deepai-org/svalbard/ip/blocks/analog/wifi_80211b/rf_rx_external_lo_parent/README.md

# Routed external-passive LNA/mixer parent

This is the first physically routed Wi-Fi receive-path parent. It places the
16-finger common-source LNA core and the two-bank external-LO switching mixer,
then routes their shared LNA-drain/mixer-RF net in parent-owned high metal and
ties the two explicit body contacts with a parent-owned ground rail.

The parent retains the necessary early external boundary: 50-ohm RF source and
input coupling, 1.5 V LNA bias, 300-ohm drain load, source degeneration, 2.3
GHz complementary LO, and differential 100 MHz IF load/filter. The visible
`MIX_RF` port is intentional: it is the physical landing for that external
drain load, not an unmodeled ideal internal connection.

`run_parent_physical.sh` requires zero DRC errors, unique LVS, full-RC PEX and
five complete PVT transient conversions. This is a composed feasibility claim,
not a qualified 802.11 receiver: RF/passive model validity, matching, noise,
linearity, isolation, I/Q, LO generation, IF/baseband, package/antenna EM,
calibration, sensitivity, EVM and regulatory behavior remain open.

The same physical runner now also performs a bounded two-tone diagnostic: a
1 mV desired tone at 2.400 GHz and a 100 mV aggressor at 2.425 GHz enter the
same external 50-ohm source and are mixed by the same external 2.300 GHz LO.
Across the five PVT cases the desired 100 MHz IF Fourier component changes by
+0.065 dB or more, while the 125 MHz aggressor IF component is at least
39.872 dB above it. That is an observed pre-filter compact-model fact, not a
blocker-tolerance, linearity or adjacent-channel-rejection claim: it makes the
missing IF/baseband filter and model/measurement qualification explicit.

The next selectivity architecture is now frozen as a **real-IF ADC plus digital
channel filter**, not as a claim that a broad 2.4 GHz preselector solves a
25 MHz adjacent-tone problem. The byte-bound requirement at
[`adc_dsp_selectivity_plan.json`](adc_dsp_selectivity_plan.json) uses the exact
five-corner two-tone PEX amplitudes to require a 0.25 V peak, 12-ENOB, at least
320 MS/s converter with two-times blocker headroom and at least 65 dB of
125 MHz digital attenuation. The original 5-pF sampled-input leaf is now
rejected on first principles as well as its switch screens: six-sigma
differential kT/C noise at 125 C is 281 uV, far above its 30.5-uV quarter-LSB
allocation. [`sampler_thermal_settling_budget.json`](sampler_thermal_settling_budget.json)
therefore binds the required IF-driver/hold-capacitor repartition before a new
sampler layout is authorized. The product-specific checker verifies this input
budget but explicitly does not claim an implemented converter, filter,
receiver, sensitivity, or RF model qualification. An external RF
preselector/match remains a later out-of-band/package/antenna requirement, and
a measured external IF filter may eventually reduce converter requirements only
after its port and S-parameters are bound.
