deepai-org/svalbard/ip/blocks/analog/wireline_serdes/clock_pulse/README.md

# RX clock level conversion and pulse generation

The recovered-clock path is CML, while the regenerative RX capture gates need
rail-to-rail CMOS clocks.  Driving those gates directly from the phase
interpolator is invalid: the extracted PI/restorer output can remain roughly
between 1.1 V and 2.6 V at slow/hot conditions.

`clock_level_converter.spice` uses two matched NMOS differential receivers with
PMOS mirror loads, a weak cross-coupled regenerative assist, and three tapered
CMOS restoration stages.  It reuses the lane's programmable bias.  The
input-swapped halves keep CML loading symmetric; the physical receiver/load
quartets are compact, edge-dummied, and mirror symmetric.

The schematic PVT screen deliberately spans CML input envelopes wider than the
present extracted clock chain.  It requires rail recovery within 250 mV,
800 ps period preservation, 35--65% output duty, no more than 400 ps absolute
edge latency, no more than 110 ps complementary crossing skew, and no more than
8 mA average supply current.  Absolute latency and its PVT shift are removed by
the CDR phase calibration; they are not silently treated as fixed delay.

The 126 by 117 um layout is zero-DRC, uniquely LVS-matched, and extracts to
540 resistors plus 267 capacitors.  Its exact full-RC standalone matrix passes
5/5 environments with a 100 fF load per output.  The exact extracted
phase-interpolator/restorer/converter chain also covers 5/5 environments.  The
four non-limiting environments use the nominal 1.15/1.15 V restorer/converter
biases.  SS/125 C has adjacent converter codes at 1.00 and 1.05 V with the
restorer at 1.30 V, plus a second restorer code at 1.15 V for converter bias
1.00 V.  That is a calibration window, not a single simulator-only code.

The next physical block is the programmable delay/non-overlap pulse network.
It must produce the separately validated 550 ps sense window and 150 ps write
pulse, then drive the actual extracted regenerative sampler clock gates.  The
remaining lane-level closure still includes mismatch/noise/metastability,
simultaneous supply/substrate aggression, EM/IR, electrothermal, fill, and
package/pad/channel effects.

## Programmable pulse-generator checkpoint

`clock_pulse_generator.spice` is the current transistor-level implementation,
not a behavioral delay source. Each phase starts from its dedicated full-swing
`CLKP_H`/`CLKN_H` parent clock. One physical falling-edge interval drives
SENSE/BOOST. WRITE is derived from the restored SENSE boundary through a
four-inverter receiver, a rising-edge interval detector, and a five-stage
geometric taper. Exact PEX rejected and removed the old global delay line,
pass-gate selector, and reset-dominant write latch.

The ideal-interconnect screen remains a failure and is not substituted for
PEX: extracted interconnect changes narrow-pulse behavior materially.
`run_pulse_hot_probe.sh` performs layout, DRC, unique LVS, exact full-RC
extraction, and TT plus FF/125 C and SS/125 C electrical probes with bounded
resources.

`generate_pulse_layout.py` aligns complementary devices as CMOS cells, routes
phase-local nets in functional bands, and stacks EVEN and ODD vertically. The
retained 128-device compact candidate is 175.4 by 285 um, zero-DRC, uniquely
pin-resolved LVS-matched, and extracts to 3,408 resistors plus 2,477 capacitors
in the earlier checkpoint. Its delayed-step revision extracts to 3,492
resistors plus 2,531 capacitors.
Substrate-tap columns are filtered against
complete multi-finger device spans, fixed HCLK landing intervals block the
automatic M4 allocator, and route comments make emitted nets inspectable.
Dedicated `VDD_WE`/`VDD_WO` and `VSS_SE`/`VSS_SO` pins retain explicit
parent-grid attachment.

The retained delayed-step candidate passes the complete focused TT contract:
591.87/583.98 ps SENSE, 206.87/213.84 ps WRITE, 605.54 ps write delay,
13.67 ps non-overlap, valid rails, and 40.669 mA. FF/125 C gives
592.74/583.02 ps SENSE and 202.82/207.82 ps WRITE with valid timing and SENSE
rails, but WRITE reaches only 2.687/2.692 V against a 2.72 V minimum. SS/125 C
retains valid 540.98/540.58 ps SENSE pulses, but the write restoration chain
does not propagate a complete pulse. Focused coverage is therefore 1/3, not
closure, and the full 20-case campaign is not promoted.

### Current reproducible delayed-step baseline

The checked-in source and layout generator are the exact netlist/layout pair
from `823f747`, the last compact candidate with an extracted TT pass. A fresh
2026-08-31 replay produced a 128-device, 175.4-um-wide layout with zero DRC,
unique LVS, and full-RC PEX. Its exact fresh TT PEX contract passes with
591.87/583.98 ps SENSE, 206.87/213.84 ps WRITE, 605.54 ps write delay,
13.67 ps non-overlap, valid rails, and 40.669 mA. The generated current layout
render is [clock-pulse-generator-layout.png](../../../../../docs/images/clock-pulse-generator-layout.png).

This is deliberately only a TT gate, not pulse-generator closure. A fresh
single-case extracted SS/125 C replay on the same source gives 540.98/540.58 ps
SENSE, but no complete WRITE pulse (48/59 mV output peaks, 51 ps apparent
write delay and 310 ps dead time). The retained FF/125 C candidate record also
misses the 2.72 V WRITE rail limit by about 28--33 mV. The historical full PVT
matrix is 1/20; a fresh broad PVT invocation currently stops before emitting
its result JSON, so it is not treated as interchangeable evidence. The fresh
TT and SS/125-C result identity is recorded in `pulse_tt_replay_checkpoint.json`.

### Actual-consumer composition (current blocker)

The pulse PEX is now composed with the physical complementary capture-clock
bridge and the physical direct-regenerative lane without an ideal source at any
SENSE, BOOST, WRITE, or capture-clock pin. A fresh 193.3-um-wide local-replica
revision is zero-DRC, uniquely LVS-matched, and passes its exact nominal PEX
gate. Its sustained composed screen is 3/5: TT, FF/hot, and SS/cold pass.
FF/cold reaches 3.379/3.396 V WRITE but only 3.311/3.296 V at the bridge
outputs against the conservative 3.380 V criterion; SS/hot still
loses periodic WRITE regeneration (49/60 mV). The byte-bound result is
[`../pulse_bridge_lane/pulse_bridge_regenerative_sustained_result.json`](../pulse_bridge_lane/pulse_bridge_regenerative_sustained_result.json).

An extracted 12-um final-SENSE-NMOS counterfactual was rejected: it lowered
the local SENSE low voltage but its added preceding-stage gate load erased
WRITE at multiple corners. Fixed drive growth is not the remedy. Also,
`SEL0..SEL3` are only physical pin-load anchors in this reduced topology, so
the former four-vector PVT campaign was repeated static-control evidence, not
calibration coverage. The checked runner now uses one static state. A future
calibration claim requires an actual circuit path whose code is observed to
change this composed behavior.

A second 2026-08-31 physical selector probe was rejected and reverted before
promotion. It used `SEL3` to enable a two-delay-unit, full-swing `WSD` hold-low
branch ahead of `WPN`; this intentionally avoided loading the narrow event and
the WRITE taper. The two-finger implementation was zero-DRC but LVS-invalid,
which caught a generated series-device connectivity error. The corrected
single-finger version was zero-DRC, uniquely LVS-matched, and full-RC extracted,
but its exact TT screen passed neither state: even the disabled branch's `WSD`
drain capacitance widened WRITE to 265.72 ps (from the 220 ps limit), while
enabled `SEL3` widened it to 379.21 ps. This rules out attaching the first
physical profile branch directly to `WSD`, not just attaching it to `WPN` or a
taper stage. The retained raw DRC/LVS/PEX and two-mode result are in
`scratch/serdes-clock-pulse-generator-physical.sM2xDfqt/`; they are diagnostic
only because the source was reverted.

A third 2026-08-31 `SEL3` profile candidate was also physically rejected and
reverted. It placed a current-starved PMOS assist only on the internal `DI`
state of the full-swing `WBA`--`WSD` end-delay cell, deliberately avoiding
direct diffusion on `WSD` or `WPN`. Both 2/4-um and 4/16-um series-PMOS
strengths were zero-DRC, uniquely LVS-matched, and full-RC extracted. The
stronger revision preserved the normal 3/5 composed matrix and improved
FF/cold capture rails to 3.371/3.363 V, but selected SS/hot still reached only
50/62 mV WRITE and 5/6 mV capture clocks. The control changed a real physical
state, yet did not drive `WPN` through a logic-low interval. The byte-bound
rejection record is
[`profiled_end_delay_rejection.json`](profiled_end_delay_rejection.json).
Do not enlarge this branch again; the next selector must choose a fully
regenerated start/end configuration and prove the selected `WPN` logic window
before another layout iteration.

That next experiment was also completed and rejected on 2026-08-31. It used
static one-hot `SEL2`/`SEL3` to choose independently regenerated, full-swing
`HCLK` start/end paths, with no disabled diffusion on `WBA`, `WSD`, or `WPN`.
The 220-device, 291.0-um layout was zero-DRC, uniquely LVS-matched, and
full-RC extracted. The `SEL2` state passed TT (206.62 ps WRITE and
0.083 V `WPN` low), but only 1/5 extracted corners passed; at SS/hot `WPN`
stopped at 0.272 V and no periodic WRITE was emitted. The selected `SEL3`
schematic state did cross `WPN` low at SS/hot, but its 377.93 ps WRITE interval
was itself invalid. The exact rejection record is
[`hclk_start_end_rejection.json`](hclk_start_end_rejection.json). The source
was reverted: a full-swing source alone does not repair the composed timing
budget, and this topology must not be promoted as calibration.

An FF/cold counterfactual separates the immediate mechanisms. The current
`(0,8,9)` profile reaches only 3.184/3.204 V WRITE even with its historical
placeholder load, 3.374/3.387 V with the extracted bridge, and 40/54 mV when
the placeholder SENSE/BOOST capacitors are replaced by the actual extracted
direct-regenerative parent. The next accepted revision must therefore be sized
and isolated against that real PEX load; a nominal or bridge-only recovery is
not sufficient.

### Superseded fast-detector characterization candidate

`pulse_fast_path_checkpoint.json` retains the later reduced-depth
`cp_fall_pulse_fast` plus six-delay experiment as a rejected historical
candidate. It had a 164-device, 226.2-um-wide zero-DRC, uniquely
LVS-matched layout, but fresh nominal full-RC PEX reached only 98/120 mV at
WRITE. Compacting its `WISO`--`WBASE`--`WSD`--`WPN`--`WB` dependency chain
removed a gross locality error but did not make the narrow detector robust.
The prior 12/20 schematic record is historical only; its current-runtime replay
was 0/20 and it cannot be used as release evidence.

Two 2026-08-31 extracted-TT sizing probes of `cp_rise_b_small` were rejected
and reverted. Doubling its NMOS finger count moved the generated chain and
gave 1.502 V `WPN`; doubling each NMOS finger width retained the horizontal
placement but increased timing-state gate load and gave 1.576 V `WPN`. Neither
is a layout or PVT solution.

A separate 2026-08-31 topology probe was also rejected and reverted before
layout: it inverted the restored `WBA` and `WSD` states, used the fast detector
to regenerate a positive interval, then inverted that result into the
unchanged active-low `WPN` taper interface. Its fresh schematic matrix was
0/20: WRITE remained at 0--2 mV in the nominal profile. The added state
inversions/detector latency did not produce a usable taper input. This rules
out that direct detector substitution; a next candidate must change the
end-to-end timing budget and output-taper interface together, not only
re-encode the local interval.

An extracted-layout 2026-08-31 threshold probe also halved only the first
write-taper inverter's NMOS multiplicity. It regenerated full TT WRITE rails,
but widened the pulse to 299/307 ps against the 220 ps maximum. The source and
layout were reverted. This rejects simple first-stage threshold skew as the
slow/hot fix; an accepted change must preserve the full timing budget, not
merely restore output amplitude.

One extracted-layout co-optimization paired a 10% first-stage PMOS increase
with an unintended faster sense-tail pull-down: a duplicated `XD0` instance
name made the initial edit land in the SENSE cell rather than the intended
write-end cell. Its TT PEX point passed at 213/218 ps WRITE and 522/514 ps
SENSE, but FF/125 C WRITE rails fell to 2.527/2.375 V and SS/125 C still did
not regenerate WRITE. It was reverted and is not evidence about write-end
control. The next candidate must introduce a calibrated full-state timing/drive
mode rather than use one fixed taper compromise across all corners.

An attempted `SEL3`-controlled first-stage PMOS assist was rejected before hot
promotion: while electrically off in nominal mode, its output diffusion still
loaded narrow `WB1`, reducing extracted TT WRITE rails to 2.882/2.904 V. It was
reverted. This is a physical-layout constraint, not merely a schematic one:
calibration hardware must attach before the narrow interval or behind a
regenerating isolation boundary, never as disabled diffusion directly on it.

On 2026-08-31, a schematic-only wiring probe connected `SEL3` through the
existing `cp_profile_write_restore` element at the restored `WSA`--`WSB` step.
It was intentionally not laid out or promoted: FF/hot instead produced roughly
470 ps SENSE, 150 ps WRITE, 350 ps write delay and 681 ps dead time, while
SS/hot still had no complete WRITE pulse. The probe was reverted after the
20-case schematic screen. This rules out that one simple selector insertion;
it does not establish an extracted calibration solution or replace the
first-extracted-TT gate above.

The central retained lesson is that a narrow pulse must not be selected or
transported through a slow restoration chain. The improved write topology
restores the full-swing `WSB` step, delays the start once, derives a separately
loaded end edge, forms the active-low interval locally, and only then drives the
output taper. This change reduced nominal write width from roughly 340 ps to
207--214 ps and produced the first exact-PEX TT pass on the compact macro. A
minimum-load receiver failed because
its 0.6 um device could not charge even a short extracted route; sizing must
include route/via capacitance and the parallel gate loads of both detector
branches. Attempts to mux narrow active-low pulses through transmission gates
or a three-NOR selector were rejected after exact PEX attenuated or erased the
selected event.

`scripts/analyze_pex_net.py` now traces shortest extracted resistance from a
named root to device terminals selected by gate/model patterns. Counterfactual
scaling localized the former rail failure to supply delivery rather than output
routing. The dedicated write pins reduce the port-to-final-source path to
19.34 ohm; the dedicated sense grounds use legal 1.5-um M4 channels and extract
to 32.60 ohm worst path. Larger final banks and an early feed-forward pull-up
both reduced, rather than improved, delivered peak voltage. A stronger final
PMOS increased the preceding stage's gate load and lowered the short-pulse
peak; reducing final NMOS load recovered FF/hot swing but lengthened WRITE
beyond 220 ps. The next revision must apply the existing profile controls to a
full-width state before interval formation, especially for SS/hot, and recover
the remaining 28--33 mV FF/hot WRITE swing without losing nominal width margin.

`screen_wb0_drive.py` is a deliberately non-promotable PEX counterfactual for
this failure. It changes only a named active portion of the write taper and
labels its output as diagnostic because diffusion and gate parasitics remain
unscaled. A 1.10x first-stage PMOS screen cleared FF/hot rail amplitude but
expanded WRITE to 228/234 ps; a 1.25x active-taper screen still did not
regenerate SS/hot. This rejects brute-force taper widening as the next layout
revision. Any profile solution must instead select or adjust a deterministic,
fully restored delayed step before `WPN` formation, then be regenerated through
DRC, unique LVS, full-RC PEX, and the complete PVT matrix. A local S/R latch
and a shared tristate full-step selector were also screened at schematic level
and rejected for PVT-dependent state and unresolved-delay behavior,
respectively.

A fresh regeneration produced byte-identical generated Tcl but different Magic
GDS/PEX internal names and byte hashes. This is extractor nondeterminism, not
evidence that either PEX deck can be substituted for the other. Each promoted
simulation must keep and hash its own DRC/LVS-bound PEX deck, as described in
the analog-layout closure workflow.

The local review render is `pulse_layout.png`; the documentation copy is
[clock-pulse-generator-layout.png](../../../../../docs/images/clock-pulse-generator-layout.png).
The checked failing [schematic matrix](pulse_schematic_result.json), retained
[passing nominal PEX checkpoint](pulse_pex_nominal_result.json), full
[exact-PVT matrix](pulse_pex_pvt_result.json), and
[physical checkpoint](pulse_physical_checkpoint.json) keep circuit coverage,
nominal closure, PVT failure, and physical legality as separate claims.
The newer compact candidate has separate
[nominal](pulse_candidate_nominal_result.json) and
[hot-corner](pulse_candidate_hot_result.json) records. The former passes and
the latter explicitly fails, so neither overwrites the older checkpoint or
implies complete PVT closure.
Run `run_pulse_generator.sh` for the schematic matrix and
`run_pulse_physical.sh` for generation, render, DRC, LVS, full-RC extraction,
the nominal electrical gate, and the full PVT matrix. Expected failing matrices
are exported as evidence after the required nominal pass; interrupted or
structurally failed runs retain their complete work directory under `scratch/`.
`run_pulse_layout.sh` is the bounded geometry-only export path for quick,
reproducible Tcl/GDS generation; it does not replace DRC, LVS, or PEX.
