deepai-org/svalbard/ip/blocks/analog/wireline_serdes/lane/README.md

# Externally clocked wireline lane composition

This is the first explicit composition of the selected integrated half-rate TX
with an AC-coupled package boundary, receiver common-mode return, programmable
differential termination, limiting amplifier, and dual-edge sampler.  The
initial rate is 1.25 GBd.  This is a bounded integration experiment, not a PCIe
pad, channel, compliance, or tapeout claim.

The same harness now has an externally clocked 2.5 GT/s mode. It uses a
rate-specialized physical data restorer and one committed exact-PEX release
stack for the termination, RX, restorer, and sampler. Fresh regeneration still
proves DRC and unique LVS, while every nominal and PVT electrical result hashes
the exact release bytes it actually simulated.

The provisional low-loss boundary deliberately names every currently modeled
element: 300 fF TX and 500 fF RX capacitance per pin, 100 nF external AC
coupling, 2 ohm and 1 nH package series parasitics per leg, 2 kohm receiver bias
returns, and the transistor-level programmable differential termination.  A
selected pad/ESD model and measured channel family must replace this boundary
before architecture freeze.

`run_lane.py` drives a changing 24-bit pattern, sweeps external sampler phase,
and independently measures signed TX, receiver-pin, amplifier, and held-sampler
margins.  A pass therefore cannot be created by checking only the final node.

Run `./run_schematic.sh` for the nominal transistor-level phase sweep. Run
`./run_extracted.sh` to regenerate and check the termination, amplifier, and
sampler layouts, perform full-RC extraction, and compose those fresh netlists
with the selected full-RC integrated serializer/TX.

## Current extracted evidence

The nominal full-RC-leaf composition completes all 16 phase cases and passes
13. The best 135 degree phase retains 259.8 mV signed pin margin, 300.4 mV
amplifier margin, and 1.345 V held-sampler margin at 12.46 mA shared supply
current. The three failing phases from 180 through 225 degrees are retained as
the observed wrong-aperture region rather than discarded.

The same 135 degree phase passes all five representative MOS/resistor/supply/
temperature environments using the already selected per-environment TX bias
and fixed RX bias, sampler bias, and interior termination code. Across that
matrix, minimum pin, amplifier, and held-sampler margins are respectively
225.8 mV, 124.0 mV, and 305.0 mV; shared supply current is 9.82--16.13 mA.

Fresh geometry evidence is bound to the composed netlists: the termination,
amplifier, and sampler each have zero Magic DRC errors, one unique pin-resolved
LVS match, and respectively 545R/276C, 442R/169C, and 480R/193C full-RC
extractions. The serializer/TX uses its selected committed full-RC extraction.

The sampler boundary is now extended through two exact-PEX CML-to-CMOS
converters and the independently clocked exact-PEX dual capture cell. All four
0--300 ps conversion offsets pass nominally, and the selected offset passes all
five representative environments. Worst converter/capture signed margins are
2.371/2.363 V and total composed current is 23.05--34.49 mA.
The physical, nominal, and PVT records bind the same exact split-capture PEX;
the preserved deck and matching image are
`scratch/serdes-lane-capture-deserializer-last.pex.spice` and
`scratch/serdes-lane-capture-layout-last.png`.

This closes deterministic changing-word transfer to stable parallel CMOS under
the provisional external clock and channel.

`./run_capture_stress.sh` reuses one freshly checked extraction stack for four
64-bit PRBS7-prefix cases, scoring 28 even/odd pairs (56 serial bits) after
startup in each case. All four exact-PEX cases pass: baseline; a symmetric
two-section channel proxy with 6 ohms series resistance per leg and 1 pF total
differential shunt capacitance; 40 ps peak deterministic TX-edge jitter with a
47% TX-clock duty cycle; and the channel proxy combined with 30 ps peak jitter
and 47% duty. Across 224 scored serial bits, the worst converter and retained
CMOS margins are 2.975 V and 3.165 V, and current is 27.11--27.14 mA.

`capture_stack.sh` is the shared container-side primitive for both capture
flows. It regenerates the termination, RX, sampler, converter, and split-capture
views once, runs physical checks on the exact split-capture PEX, and exports one
canonical argument vector so nominal, PVT, and stress flows cannot quietly use
different leaf paths.

For a matched 100-ohm differential reference, the declared RC proxy's ABCD
network evaluates to approximately 0.68 dB insertion loss at the 625 MHz
Nyquist frequency and 1.16 dB at 1.25 GHz. This is an explicit bounded lumped
stress, not a transmission-line, return-loss, or selected-channel claim. A
denser impairment/PVT matrix, simultaneous-supply aggression, and selected
pad/ESD/package/S-parameter models remain next.

## Combined extracted stress and data restoration

The denser matrix now measures every scored TX, receiver pin, receiver output,
sampler input, CML-to-CMOS output, and retained CMOS output. An initial 5-case
run with 7 ohms/leg and 1.25 pF localized the failure to receiver dynamic
margin. A one-factor screen showed that 30 ps peak jitter, 47% duty cycle, and
20 mV peak 100 MHz supply ripple each passed at the limiting slow/passive
environment; the provisional RC channel was the controlling mechanism. The
6-ohm/leg plus 1-pF point is the selected bounded proxy. The observed
7-ohm/leg plus 1.25-pF failure preceded the data-restorer redesign, so it is
mechanism evidence, not a post-redesign channel limit or guardband claim.

The original receiver output could still produce correct final data but fell
below the sampler's independently qualified 200 mV input contract. Reusing the
physical 7.5-um-load clock restorer failed arbitrary PRBS settling, so a new
two-stage 4.5-um-load `data_restorer` was laid out, checked, and extracted. Its
exact PEX passes at adjacent 67.5 and 90 degree sampler phases in the limiting
environment; 78.75 degrees is selected between them. Mixed process/passive
corners use restorer bias codes supported by adjacent-code screens rather than
waiving the interface floor.

The permanent calibration targets are `run_capture_restorer_sweep.sh` for the
final-geometry phase window, `run_capture_restorer_ff_bias.sh` for the
fast-device/slow-passive corner, and `run_capture_restorer_ss_bias.sh` for the
slow-device/fast-passive corner. They share the exact extraction stack,
stimulus runner, and parameterized fail-closed evidence merger.

`./run_capture_stress_pvt.sh` now passes 5/5 representative environments and
160/160 scored serial bits with one exact extraction stack under simultaneous
6-ohm/leg plus 1-pF channel stress, 30-ps peak deterministic TX jitter, 47%
duty cycle, and 20-mV peak 100-MHz rail ripple. Worst signed margins at the TX,
pin, raw RX, restored sampler input, converter, and final capture are
78.681/147.603/50.674/230.118/2578.62/2733.72 mV. Total composed current is
26.383--41.442 mA. This closes the bounded low-loss proxy matrix; it does not
close mismatch, substrate/PDN coupling, equivalent combined stress at 2.5 GT/s,
or the selected physical I/O and channel.

## Externally clocked 2.5 GT/s milestone

Run `./run_extracted_2p5.sh` for fresh geometry checks plus the exhaustive
16-phase exact-PEX nominal sweep. Six phases pass; the selected 22.5-degree,
zero-latency case retains 175.376 mV at the TX, 222.785 mV at the pin,
274.850 mV across the selected 50 ps raw-RX hold interval, 1.33849 V after
restoration, and 649.090 mV at the sampler.

Run `./run_extracted_2p5_pvt.sh` for the five representative mixed MOS,
resistor, supply, and temperature environments. All five pass with at least
one of three searched phases. Worst selected raw-RX hold, restored, and sampler
margins are 169.915, 376.508, and 137.055 mV. The two slow/hot cases add one
whole UI of deterministic pipeline latency; the other three and nominal use
zero. Integer latency is scored explicitly because word alignment can absorb
it, while wrong polarity or fractional aperture error cannot.

The AC-coupling initial condition is the settled measured TX-to-RX common-mode
difference for each environment. It is a fixture state, not a programmable
silicon control. `check_2p5_evidence.py`, included in `make check-fast`, binds
all release PEX and physical hashes, phase counts, environment identities, and
interface margins. This milestone does not yet include the 1.25-GBd combined
jitter/channel/supply stress matrix, mismatch, extracted parent routing,
selected pads/package/S-parameters, or a recovered clock.

`run_capture_2p5_precal.sh` extends that release stack through the two extracted
CML-to-CMOS converters and the independently clocked capture parent under the
same combined channel/timing/supply stress bundle. Nominal TT closes after
retaining the capture cell's characterized 380 ps write pulse: worst TX, pin,
raw-RX start/hold, restored, converter, and final CMOS margins are
139.812/132.707/180.873/397.333/1156.11/1659.46/763.159 mV. Total current is
56.167 mA.

The first representative PVT replay deliberately remains a checked failure at
1/5 environments. FF/cold exceeds the 60 mA current ceiling and its raw valid
window moves; FF/hot loses odd capture margin; the two slow/hot cases retain
restored amplitude but miss the converter schedule after their one-UI pipeline
shift. `extracted_capture_2p5_stress_precal_result.json` preserves the measured
stage-by-stage mechanisms. This is the next calibration/architecture target,
not evidence that combined 2.5 GT/s stress is closed.

The first physical correction retapers the capture output buffers for their
actual 50 fF load, reducing the cell from 2,202R/1,570C to 1,957R/1,400C while
remaining zero-DRC and uniquely LVS-matched. The retained 380 ps write pulse
then closes both fast corners under the same combined stress. FF/hot reaches
1.128 V worst final margin at 50.55 mA; FF/cold uses TX bias 1.1 V and a
50--100 ps raw-RX contract window, reaching 3.093 V worst final margin at
57.07 mA. `run_capture_2p5_fast_cal.sh` is fail-closed and preserves the exact
capture and converter PEX used by both cases. The two slow/hot TX/channel
failures remain preserved in that narrower historical 2/2 result.

`run_capture_2p5_calibrated.sh` closes the complete representative matrix with
one regenerated, hash-bound physical stack. It uses the rate-specialized
minimum-length-tail TX, nonlinear load code 4 in the two slow environments,
the separately versioned 4.2 um-load data restorer, and absolute 550 ps sense /
400 ps capture-delay controls where slow-device settling requires them. The
verifier samples EVEN and ODD capture outputs relative to their own half-rate
events; sampling both at the ODD event had incorrectly scored the EVEN output
after its next cycle began.

All 5/5 environments pass 24-bit PRBS7 under simultaneous 6 ohm/leg plus 1 pF
channel stress, 30 ps peak TX jitter, 47% duty cycle, and 20 mV peak 100 MHz
rail ripple. Worst pin, restored-input, converter, final-capture, and current
measurements are 103.180 mV, 237.084 mV, 1.20878 V, 958.544 mV, and 59.104 mA.
The committed evidence binds zero-DRC, unique-LVS, exact full-RC records for
the TX, termination/RX/sampler, restorer, converter, and capture cells.

`run_capture_2p5_routed_rx.sh` replaces the separate RX, calibrated-restorer,
and sampler PEX instances with the exact 1,309R/464C
`lane_rx_spine/lane_rx_spine.pex.spice` physical parent. Diagnostic parent pins
retain the raw-RX and restored measurements, so the same stage contracts remain
visible without substituting ideal wires at either internal boundary. The
routed parent passes the same five environments and combined stress with worst
pin, raw-RX, restored, converter, final-capture, and current measurements of
103.002 mV, 51.209 mV, 217.828 mV, 1.15809 V, 939.439 mV, and 58.830 mA.
`check_routed_rx_evidence.py` rejects duplicate leaf composition and binds every
physical record, PEX, testbench, runner, case, and aggregate hash.

`run_capture_2p5_rx_frontend.sh` advances that hierarchy through the exact
5,926R/3,405C `lane_rx_frontend/lane_rx_frontend.pex.spice` parent. It absorbs
the programmable termination, termination-to-RX routes, receive spine, both
sampler-to-converter boundaries, and the mirrored EVEN/ODD converter pair.
All 5/5 environments pass the unchanged combined stress. Worst pin, raw-RX,
restored, converter, final-capture, and current measurements are 104.159 mV,
47.358 mV, 211.577 mV, 579.32 mV, 595.135 mV, and 53.581 mA. Fast/cold moves
the realizable sampler phase to 45 degrees; fast/hot uses the independently
exposed interleave clocks for -50 ps ODD sense/regeneration deskew.
`check_rx_frontend_evidence.py` binds the exact parent and rejects fallback to
separate termination, spine, or converter PEX instances.

`run_capture_2p5_rx_capture.sh` extends the physical hierarchy through the
7,900R/4,804C `lane_rx_capture/lane_rx_capture.pex.spice` parent. It owns the
four converter-to-capture data routes, shared capture clocks, and capture power
branches instead of retaining a separate split-capture PEX. All 5/5
environments pass the same combined stress. Worst pin, raw-RX, restored,
converter, final-capture, and current measurements are 104.176 mV, 47.052 mV,
209.582 mV, 558.084 mV, 623.576 mV, and 52.203 mA. The final output reaches its
500 mV contract by 750 ps, retaining 50 ps before the next 800 ps
same-interleave event. `check_rx_capture_evidence.py` rejects leaf fallback and
binds the exact parent PEX, physical record, testbench, runner, five cases, and
aggregate.

This is not yet a complete routed lane. Realized upstream clock and bias trees,
local decoupling, pad/ESD/package/channel, and full-chip supply and substrate
routes remain the next physical composition boundaries.
