deepai-org/svalbard/projects/programmable_transceiver_platform/spec/board-requirements.md

# Board requirements

Obligations on the carrier and bring-up boards that the die relies on. The die is bonded on the
unmodified wafer.space chip-on-board ([package-channel.md](package-channel.md)): it carries eight 1 µF
capacitors on the supply nets and nothing on signal pins, so every signal passive below is on the carrier.
Per-application carriers are allowed: a carrier may populate only its application's passives, and a pad may
carry different functions on different carriers, but every carrier keeps bring-up, debug and fallback access.
Off-chip parts are limited to passives, the FPGA and a fallback LNA; the "BACKUP" rows are bench routes for a
partially working die, not the plan.

IDs are stable and are referenced from `performance-requirements.json`. Risk IDs are in
[risk-register.md](risk-register.md).

## Supply, reset, thermal, handling

| ID | Requirement | Why | Source |
|---|---|---|---|
| B1 | **Reset supervisor IC on `RESET_N`**, open-drain, threshold inside the supply window. It holds the chip in reset on slow ramps and brownout. | The on-chip POR covers cold start and full power cycles only. It misses some 100 ms–1 s ramps and ignores dips that stay above 1.5 V. | `analog/core_support` evidence |
| B2 | **One supply source, set per die.** A trimmer plus regulator sets each die's supply at bring-up from its measured speed: 3.3 V for typical dies, up to a 3.50 V setpoint for slow dies, lower for fast dies. Setpoint + tolerance + ripple + overshoot ≤ 3.63 V. Tolerance ±1 %. Bring-up starts every die at 3.3 V. Junction temperature 22–32 °C. | Operating envelope; per-chip supply trim. | `tapeout-plan.md` |
| B2a | **Supply and thermal detail:** (1) The regulator senses at the mezzanine connector supply contacts, with ≤ 20 mΩ from the sense point to them at ≥ 0.45 A. (2) θ(junction → temperature-controlled surface) ≤ 5.2 °C/W, set point held to ±2 °C, so the junction stays within 22–32 °C across the stopped (15 mW) to full-power mode step. The connector occupies the board back side under the die, so the controlled surface is a top-side cold finger (BP-6). Free air is not acceptable. (3) A die-temperature observation for the control loop, cross-checked against an on-chip proxy such as the always-on oscillator frequency. | Drop budget 117 mV. Worst mode 1.26 W needs ≤ 6.4 °C/W; a free-air board rises by tens of °C. | `power-delivery.md` section 1, `spec/budgets/power_budget.py` |
| B52 | **Supply slew ≤ 0.3 V/µs at the die, and no hot-plug.** The carrier is never plugged into or pulled from a live supply; the regulator has a soft start. | A 1 µs supply edge fires the provider supply-pad clamps: amperes through the bonds and the die rail rings above its limit. A 10 µs edge does nothing. | `scratch/reviews/integration-m6.md` finding 1 |
| B37 | **Die supply ripple for RF modes:** the supply is LDO-post-regulated (or the switcher runs above 20 MHz or synchronized off the channel plan) with ripple ≤ 1 mV rms over 10 kHz–20 MHz at the connector contacts. | No RX supply-rejection evidence; 1–3 MHz switcher lines land inside narrowband channels. | RF-RX-PSRR |
| B49 | **`RESET_N` is host-drivable, never hard-tied high.** The B1 supervisor output is wire-ANDed with a host GPIO (open-drain or series 1 kΩ) on the same net, with one 10 kΩ pull-up to the die supply; a test point and a push-button are recommended. **With the `POR_BYPASS` strap fitted, `RESET_N` is low from before the supply starts to rise until the supply has been inside its window for ≥ 1 ms**, and then shows one clean rising edge. | `rst_n = RESET_N AND (POR OR strap OR keyed override)`: with the strap set and `RESET_N` tied high the die has no reset at all, and every island turns on during the ramp. Both rescue paths need the host to pulse `RESET_N`. | `rtl/pt_por_path.sv`, `scratch/reviews/integration-m6.md` finding 4 |
| B50 | **SPI pins idle at the pad-pull levels whenever the host does not drive them: `SPI_CS_N` high, `SPI_SCLK` low, `SPI_MOSI` low.** Fit 1 kΩ `SPI_CS_N` to the die supply, 1 kΩ `SPI_SCLK` to ground and 1 kΩ `SPI_MOSI` to ground, or prove that the chosen FPGA leaves these pins high-impedance without pull-up from power-on through configuration. No pull-up on `SPI_MOSI` in any case. No `SPI_SCLK` edge while `SPI_CS_N` is high; a dedicated SPI bus is recommended. SPI clock ≤ 5 MHz (≤ 1 MHz at bring-up). | The pad pulls are 105–157 kΩ, weaker than any FPGA weak pull-up. `CS_N` high with `MOSI` low is the idle level that clears the pad-free POR rescue key; a floating `SCLK`/`CS_N` can clock garbage into the SPI shifter. | `rtl/pt_por_path.sv`, `rtl/pt_spi.sv`, `scratch/pads-core/pulls/` |
| B51 | **POR rescue (only for a die whose POR never releases).** First path: fit the `POR_BYPASS` jumper (strap pad to the die supply; the pad has a hard pull-down, jumper not fitted by default) and obey B49. Second path, no pad needed: the SPI key sequence of `rtl/pt_por_path.sv` ("RESCUE PROCEDURE"): the host bit-bangs `RESET_N`, `SPI_CS_N`, `SPI_SCLK`, `SPI_MOSI` as four GPIOs with ≥ 1 µs between pin changes, shifts 0xC3A5 with `RESET_N` and `CS_N` low, raises `CS_N`, then `RESET_N` with `SCLK` high, and from then on keeps `MOSI` high whenever `CS_N` is high. The B50 `MOSI` pull-down stays fitted. `RESET_STATUS` bits 4:2 report {POR masked, key override effective, strap}. Bring-up starts every die without either override and reads `RESET_STATUS` first. | The third-party POR is a single point of failure in the reset path. | `rtl/pt_por_path.sv`, `verification/check_por_path.py` |
| B26 | **Power before drive:** the supply is up and `RESET_N` released before any external source drives a chip pin: the external LO on `REF_IN`/`AUX_CLK` (B3), link partners on `WIRE_RX`/`WTX_EXT`/`AUX_CLK`, TMDS pull-ups (B9), `BB_I/Q` injection and ATB force (B7). Remove them in reverse order. The FPGA gates the LO source and the B6 switch on a power-good signal. | Externally driven pads land on p-diffusion in islands that may be unpowered: latch-up and back-powering (LU-02, LU-03). | risk-register LU-02, LU-03 |
| B6 | **Host lines are high-impedance while the chip is unpowered.** Use a bus switch with powered-off isolation on the 11 D2H lines and `SPI_MISO`. Never leave the chip supply floating while the FPGA is powered. | The provider host pads backfeed about 6.8 mA per pin into the ring. Series resistors are acceptable only on `SPI_MISO`. | `analog/pads` powered-host-backfeed |
| B6a | **The B6 switch must fit the host-link load budget:** on-capacitance ≤ 3 pF per line, bandwidth ≥ 1 GHz, propagation ≤ 0.3 ns, channel-to-channel skew ≤ 50 ps, isolation with its supply at 0 V. | ≤ 10 pF total per line (HL-B3). | HL-B3 |
| B7 | **Analog test bus force (`ATB0`/`ATB1`) only while the chip is powered**, or with the source limited to 1 mA. | Unpowered, a 50 Ω source pushes 54–56 mA into the ring through the provider analog pad. | `analog/pads` atb-provider-pad-force |
| B10 | **Access to every debug pad** (`BB_I/Q`, `AUX_CLK`, `WTX_EXT`, `WMON`, `CLK_OBS`, `DBG_OBS0/1`, `ATB0/1`, `TLP_TEST`, `POR_BYPASS`): an SMA or probe point each. `DBG_OBS0/1` and `CLK_OBS` also go to FPGA inputs (HL-B8). | Fallback routes and observability on every carrier. | `tapeout-plan.md` |
| B28 | **Opaque cover:** black glob-top or an opaque lid over the die for every measurement; microscope lamps off. | Photocurrent: about 0.3 µA under room light against 10 µA bias, about 100× more under a microscope lamp (OTH-01). The glob-top colour is not confirmed. | risk-register OTH-01 |
| B48 | **ESD handling:** (1) all handling, assembly and bring-up in an EPA per ANSI/ESD S20.20 or IEC 61340-5-1; (2) wrist strap and grounded mat for every bench probe; ground the probe and the coax shield before touching RF or high-speed pins; (3) discharge cables before connecting them; (4) the pin list states the HBM level per pin (2 kV: supplies, host link, debug/ATB, RF_RX, clocks, USB, WIRE_RX; 1 kV: RF_TX, WIRE_TX) and states no CDM rating (≥ 250 V is a target, not verified). | The die is an unencapsulated chip-on-board with mixed ESD levels. | `scratch/reviews/esd-tiering.md` |

The die attach (conductive, grounded paddle) is wafer.space's choice and is not confirmed in writing; substrate
isolation figures that assume a grounded back side depend on it (SUB-10).

## Radio

| ID | Requirement | Why | Source |
|---|---|---|---|
| B3 | **External quadrature LO (fallback for the on-chip LO):** I on `REF_IN`/`REF_IN_N`, Q on `AUX_CLK_P/N`, sine at 2.4–2.5 GHz, AC-coupled (B19), level settable per board (B31). Do not drive a square wave. Allow ≥ 1 µs after enabling the LO before receiving. The drive window is not requalified on the current bond map: the last pad-level evidence (3.0–4.0 Vpp open-circuit from 50 Ω) used a 1.5 nH bond model, and the package model gives 2–3 dB less at the pad and −11° to −19° of I/Q phase error before trim. | Recovers the radio if the on-chip LO fails. | `analog/timing/generated/lo_ext-pad-evidence.json`, `package-channel.md` section 4 |
| B19 | **External LO passives:** 2.45 GHz 90° hybrid (or two baluns from a quadrature source) with amplitude / phase balance ≤ 0.5 dB / ≤ 3°; AC coupling 10 pF C0G per leg. The carrier length-compensates the fixed board traces (BP-2); the chip trims the remainder. | TX EVM and image rejection need I/Q skew ≤ 5 ps at the mixers. | `analog/timing` lo_ext |
| B31 | **Adjustable LO level:** the external LO source has a per-board settable output level (≥ 10 dB range in ≤ 0.5 dB steps), set from `CLK_OBS`/ATB readings. | Bond and pad spread moves the pad amplitude by several dB (`package-channel.md` section 4). | risk-register PKG-05 |
| B35 | **LO synthesizer quality and common reference:** the B3 source meets RF-RX-LOPN, settles in frequency and phase within the RF-CS-HOP budget, and shares **one ±10 ppm TCXO** with the converter and host clock source. | Reciprocal mixing and frequency-offset tracking. | RF-RX-LOPN, RF-RX-FREF |
| B4 | **DC-block `RF_TX`** behind the feed network: the output pads are DC-fed from the board and rest at the supply rail. A DC path to ground or a DC source on an unpowered pad is not allowed. | The driver's output-pair current (about 61 % of its total) enters through the pads from the board chokes; a DC source on an unpowered pad back-powers the island. | `analog/rf_tx/README.md` |
| B17 | **RF_TX feed, match and balun:** per-leg feed chokes to the die supply, a 2.4–2.5 GHz balun with a specified maximum insertion loss (the simulations use the datasheet maximum), DC block 10 pF C0G. Values are fitted to the extracted pad and the per-pin package chain and refitted when either changes; the bench network in `analog/rf_tx/README.md` is the reference. Placement loss 0.4 / 0.9 / 1.7 / 2.6 dB at connector + 2 / 10 / 30 / 50 mm. | Driver DC feed and output power. | `analog/rf_tx/README.md`, `package-channel.md` section 4 |
| B18 | **RF_RX input match: NOT MET.** No network is qualified on the package channel: the first carrier part sits behind ≥ 6.5 nH and about 0.9 pF per leg, and the LNA input is not closed (RFR-11..14). Intended form: discrete match per leg with 0402 wire-wound inductors (Q ≥ 40 at 2.45 GHz), C0G capacitors, one trimmer across the pair, a 2.45 GHz 50:100 Ω balun with ≤ 0.8 dB maximum loss, 10 pF C0G coupling. To be fitted on the real channel once the LNA input is fixed. | Balun and match loss add dB for dB to the noise figure. | `analog/rf_rx/README.md`; risk-register RFR-11..14 |
| B25 | **RF_RX trimmer tuning: NOT MET** (depends on B18). Intended procedure: LNA on at RX bias, network analyser on RF_RX, turn the one trimmer for the minimum worst reflection over 2.395–2.4885 GHz, then set the LNA tank tune for the lowest baseband noise floor and store it in the board EEPROM. | Bond and part tolerances move the match. | risk-register RFR-13 |
| B5 | **Fallback board LNA ahead of `RF_RX`** (footprint on every radio carrier, with bypass), NF ≤ 1.5 dB, gain ≥ 15 dB, used with the on-chip LNA bypass. | Recovers sensitivity if the on-chip LNA misses. The on-chip LNA is the design. | `tapeout-readiness.json` `rf_lna_bypass` |
| B20 | **Anti-alias filter on the baseband-tap fallback** (`BB_I/Q` to an external ADC): 3rd–5th order LC low-pass per leg, corner about 10 MHz for 20 MHz channels, L ±2 %, C0G ±2 %. | Adjacent-channel aliasing in the external converter. | `tapeout-readiness.json` `rf_bb_external_adc` |
| B33 | **T/R switch (single-antenna products):** SPDT between the antenna, `RF_TX` (after B17) and `RF_RX` (before B18): IL ≤ 0.5 dB, isolation ≥ 25 dB, switching ≤ 1 µs, P0.1dB ≥ +20 dBm, control from an FPGA GPIO scheduled from the chip's TX/RX timing (the same timing as RF-CS-ANT). Two-antenna setups may omit it. | Separate RF_TX/RF_RX pins; RF-TX-MUTE fails; CS T_IP2 ≤ 40 µs. | RF-RX-NFSYS, RF-CS-TIP |
| B34 | **ISM coexistence filter (populate option, mandatory in products with cellular or 5 GHz radios):** 2.4 GHz BAW band-pass (2400–2483.5 MHz) between the antenna/T-R switch and the B18 balun: IL ≤ 2.5 dB max, rejection ≥ 35 dB at 2300–2370 MHz (B40) and ≥ 35 dB at ≥ 2500 MHz (B41/B7), ≥ 30 dB at 4.9–5.9 GHz. Keep its footprint on every carrier (0 Ω bypass when not fitted). | No on-chip selectivity; +8…+13 dBm UE TX at the port is ≈ 45 dB beyond the pre-filter headroom. | RF-RX-COEX |
| B36 | **Antenna-port ESD (MANDATORY):** low-capacitance TVS (≤ 0.3 pF, 2.4 GHz rated) or a shunt-L ESD path at the antenna connector for IEC 61000-4-2 ±8 kV contact; the chip pad is rated only for HBM-class events (RF_RX 2 kV tier: residual ≤ 1.33 A). **Residual-current criterion:** at IEC 61000-4-2 ±8 kV contact the current reaching the die pin through bond/trace must stay ≤ 0.67 A peak (the 1 kV HBM surrogate peak the pad was qualified for; 2 kV pins: ≤ 1.33 A), checked by a SPICE/TVS-datasheet TLP-curve simulation of TVS + trace L + pad model before release; a clamp-voltage spec alone is not sufficient. **First IEC peak:** the same check covers the IEC first peak (~0.8 ns rise, ~30 A at 8 kV): residual into the die ≤ 1 A for 1 kV pins (≤ 1.33 A for 2 kV pins) until VF-TLP data from the TLP site exists. | Antenna ports see system-level ESD; the RF_RX pad is qualified only for the 2 kV HBM surrogate (ESD-02). | RF-RX-ESD; risk RXR-07 |
| B41 | **Antenna switch array (populate option; BLE AoA/AoD CTE, CS N_AP > 1, diversity):** SP4T–SP8T 2.4 GHz switch at the antenna (ahead of B33/B34): IL ≤ 1.5 dB, isolation ≥ 25 dB, switching ≤ 250 ns to settled, P0.1dB ≥ +15 dBm and hot-switch rated at ≥ +10 dBm. Control lines are FPGA GPIOs (no chip pin), launched against the chip's ADC sample index / TX schedule (IX-8). The array phase/gain is calibrated per board. | RF-BLE-CTE slot timing (1–2 µs slots) and RF-CS-ANT; the chip has no antenna-switch pins and none are spare. | RF-BLE-CTE, RF-CS-ANT |
| B42 | **Band kits for off-ISM and sub-band use (populate options, RF-XLO-RANGE):** per band (2.2–2.8 GHz; 1.15–1.7 GHz; 0.86–0.93 GHz): (1) RX L-match and TX balun/match re-valued for the band from the same COB model as B17/B18; (2) a quadrature LO for the band, either a band 90° hybrid (≤ 0.5 dB / ≤ 5°) or a synthesizer at 2× or 4× f_LO into a quadrature ÷2/÷4 IC, at the B3 level (B31 adjustable); (3) a **preselector SAW/BPF** ahead of B18 rejecting the 3·LO and 5·LO mixer responses by ≥ 40 dB; (4) a TX low-pass rejecting H2/H3 and the 3·LO product to the regulatory limit; (5) the LO synthesizer covers 0.6–2.8 GHz at B35 phase noise. B34 is bypassed (0 Ω) off-ISM. | The chip is broadband (no on-chip tuned element); band selectivity and quadrature come from the board. Passive mixers respond at odd LO harmonics (−9.5 / −14 dB). | RF-XLO-RANGE, RF-SUBG-PROF, RF-SDR-SCAN |
| B43 | **Radar / duplex front end (populate option, RF-RADAR):** two antennas with ≥ 30 dB TX→RX isolation, or one antenna through a coupler/circulator with ≥ 25 dB isolation; TX code set so the self-leakage at `RF_RX` is ≤ −30 dBm. Optional ramp-capable synthesizer (≤ 83.5 MHz linear sweep inside 2400–2483.5 MHz, ramp nonlinearity ≤ 0.1 %) on the B3 LO footprint. | Keeps self-leakage under LNA compression (≈ −25 dBm at the lowest state) and within the DC-offset DAC range. | RF-DUPLEX, RF-RADAR |
| B44 | **GNSS front end (populate option, RF-GNSS-RX):** active-antenna bias-T (3.3 V, ≤ 30 mA, current-limited), L-band SAW (1.16–1.61 GHz or per band) and the B5 board LNA (NF ≤ 1.5 dB, gain ≥ 15 dB); LO and converter reference from one TCXO ≤ ±0.5 ppm. | Chain NF 2.7 dB only with a board LNA; GNSS acquisition time scales with reference error. | RF-GNSS-RX |
| B45 | **Multi-die coherent array (RF-MULTICHIP):** one LO synthesizer, an amplifier and an N-way Wilkinson splitter per LO phase (I and Q) with phase match ≤ 3° and level ≥ +8.9 dBm per die leg (the B3 window); the H2D clock and the sync event fanned out length-matched (≤ 50 ps skew) to every die's FPGA port. | B3 drive is per die; the sample epochs are aligned only if every die sees the same sync event. | RF-MULTICHIP |

## Wired and USB

| ID | Requirement | Why | Source |
|---|---|---|---|
| B22 | **Wired TX AC coupling (PCIe, SATA, DisplayPort, 1000BASE-X and the 2.7–3.24 Gb/s rates):** one series capacitor per leg of `WIRE_TX_P/N`, PCIe 75–265 nF, SATA and DisplayPort 10–100 nF per the standard, anywhere within 50 mm on the carrier. TMDS stays DC-coupled (B9). No board back-termination: the on-die termination is on in the serial configuration. | The TX common mode is not a standard-compliant DC level. | `analog/wired_tx/INTEGRATION.md` |
| B23 | **Wired RX passives:** (1) AC coupling on `WIRE_RX_P/N`, one 100 nF X7R 0402 per leg (PCIe 75–265 nF window); TMDS DC-coupled. (2) No board termination: the on-die termination stays on. (3) Clean reference on `REF_IN`: crystal oscillator module (25 MHz class), ±20 ppm, phase jitter ≤ 1 ps rms (12 kHz–5 MHz), LVCMOS or LVDS; a bare crystal is not possible. (4) No external series peaking inductor: the package already adds 3–4 nH per leg. | No new pins. | `analog/wired_rx/README.md`, `package-channel.md` |
| B24 | **WIRE_RX and WIRE_TX bond order:** `WIRE_RX_P` is on `bidir[15]`, `WIRE_RX_N` on `bidir[14]`, `WIRE_TX_P` on `bidir[21]`, `WIRE_TX_N` on `bidir[20]`; `USB_DP` on `bidir[19]`, `USB_DN` on `bidir[18]`. The carrier routes from the bond map in `package-channel.json`, not from the site order. | The wired pad families are wider than a site pair and are placed mirrored. | `package-channel.json` |
| B40 | **High-speed RX return-loss compensation (optional, not fitted by default)**, per `WIRE_RX_P/N` leg at the connector: shunt 0.9 pF (0201 C0G, ±0.05 pF) within 0.5 mm of the connector pad, series 4.0 nH (0402, ±2 %), shunt 0.2 pF. Lifts the 1.25–2.5 GHz return loss from about 6.1 dB to 12.3 dB nominal; 8.2 dB worst with ±10 % parts and bond ±0.3 mm at 0.5 mm placement, 4.1 dB at 5 mm. A connector TVS (B47) counts against the first shunt capacitor. To be refitted after the pad termination fix (PAD-09). | Return loss to 2.4–2.5 GHz is package-limited (about 6.3 nH series path); only a board-side ladder helps. | `scratch/pads-pd21/rl/rl_fix_pd48c.json` |
| B9 | **TMDS needs 50 Ω pull-ups to 3.3 V** on `WIRE_TX_P/N` (the sink's, or on the carrier). | TMDS is a wired TX configuration with on-chip termination off. | `analog/wired_tx/INTEGRATION.md` |
| B16 | **HDMI/DVI RX:** the carrier routes the TMDS clock pair into `AUX_CLK_P/N` as the CDR reference, level-shifted from TMDS to the `AUX_CLK` input range. The external-LO Q phase cannot be fitted on the same carrier. A full HDMI/DVI link uses three dies, one per TMDS data lane: the carrier fans the clock out to all three with matched lengths. | The on-chip route needs the forwarded pixel clock; the forwarded wire clock uses the `AUX_CLK` pair. | `integration/top/pt_chip.conn` |
| B12 | **External serial data on `WTX_EXT` (wired TX fallback):** AC-coupled; the FPGA sends at least 128 bits of balanced data before the payload. Rates 0.5–1.6 Gb/s at 300–800 mVpp. | The coupling capacitors hold the previous level for about 40 ns. | `analog/timing` diff_clk_rx data mode |
| B8 | **USB low speed through an external PHY.** Full speed and high speed use the chip. | On-chip low-speed edges are faster than the 75–300 ns the standard requires. | `analog/pads` usb-attachment |
| B11 | **USB HS amplitude calibration per board:** set the HS bias code at the board's actual rail and load by measuring the HS amplitude (360–440 mV target). | The amplitude follows the supply, and the slow corner at 3.15 V is short of 400 mV at full scale (351 mV; 400 mV needs 3.33 V). | `analog/wired_tx/USB-INTEGRATION.md` |
| B46 | **USB connector TVS (MANDATORY):** USB2-HS-rated low-capacitance TVS array on D+/D− at the connector (≤ 0.5 pF per line, ≤ 0.05 pF mismatch, IEC 61000-4-2 ±8 kV contact, clamp ≤ 10 V at 1 A TLP / 100 ns), within 5 mm of the connector, before any series part; VBUS gets its own TVS. The current reaching the die pin at ±8 kV contact, including the first peak, stays ≤ 1.33 A, checked by a simulation of TVS, trace inductance and pad model before release. The TVS counts in the USB 10 pF per line budget (die ≤ 5 pF). | The USB pad is a 2 kV HBM pin; a connector pin without a TVS fails system-level ESD. | `scratch/reviews/esd-tiering.md`; risk ESD-02 |
| B47 | **Wired connectors (`WIRE_RX`, `WIRE_TX`), `RF_TX` and clock inputs:** connector-side low-capacitance TVS (≤ 0.3 pF per line, rated for the lane rate) on any externally pluggable connector, or the port is documented as connect-only-when-powered-down with cables discharged first. Residual current into the die at ±8 kV contact ≤ 0.67 A for 1 kV pins (RF_TX, WIRE_TX; ≤ 1 A on the first peak) and ≤ 1.33 A for 2 kV pins, checked by simulation. On WIRE_RX the TVS capacitance is absorbed into B40; on RF_TX it is part of B17. | Mixed HBM levels per pin. | `scratch/reviews/esd-tiering.md`; risk ESD-02 |
| B38 | **100BASE-TX line interface (WR-100TX-*):** an RJ45 with integrated 10/100 magnetics, or discrete parts. TX and RX transformers 1:1 with OCL ≥ 350 µH at 8 mA DC bias, a line-side common-mode choke, Bob-Smith termination (75 Ω per pair centre tap → 1 nF / 2 kV to chassis), 1500 Vrms isolation *(verify)*. **RX side:** the RX transformer secondary goes straight to `WIRE_RX_P/N`, DC-coupled (no series caps: they would add a baseline-wander pole). The RX centre tap is biased to 1.0 V ±5 % by a divider from 3.3 V (e.g. 2.37 kΩ / 1.0 kΩ 1 %) with 100 nF to GND. On-die termination mode 10 (100 Ω differential) with the on-die AC coupling off. **Pairs:** 100 Ω differential carrier routing per BP-8, ≤ 50 mm chip→magnetics, TX and RX pairs ≥ 3 w apart. | The die's CTLE CM window is 0.8–1.2 V at ss , and the transformer secondary floats. Magnetizing L sets the baseline-wander τ = 7 µs (WR-100TX-BLW). | WR-100TX-RXEQ/-BLW/-RL; interface-requirements §1.14 |
| B39 | **100BASE-TX TX network on `WIRE_TX_P/N` (current-mode, external centre tap):** (1) back-termination of 49.9 Ω 1 % from each leg to the TX centre-tap rail, which is a separate 3.3 V ±2 % board supply node with 10 µF + 100 nF (it carries the 40–51 mA tail current, which returns through die VSS). (2) a doubly-terminated 100 Ω 2nd-order Bessel/Butterworth LC low-pass between the back-termination node and the TX transformer, fc ≈ 110–120 MHz: for Butterworth at fc 115 MHz (g1 = g2 = 1.414), series L = 2 × 98 nH (±2 %, one per leg, Q ≥ 30 at 60 MHz) and shunt C = 19.6 pF differential C0G ±2 %; overshoot 4.3 %, or use Bessel values if the overshoot margin is short (final values from the B39 sim). (3) On-die TX termination off; no series AC caps (B22 does not apply in this mode). | MLT-3 ±1 V = 40 mA × 25 Ω. TP-PMD needs 3–5 ns edges and ≤ 5 % overshoot, and the 0 level is built by 1 GHz MAIN/POST cancellation that the filter removes (WR-100TX-TXSHAPE). The filter gives RL ≈ 24 dB at 30 MHz and ≈ 12 dB at 60 MHz. | WR-100TX-TXLVL/-TXSHAPE/-RL |
| B38a | **BACKUP Ethernet (twisted pair): external 10/100 PHY** on the FPGA (RMII/MII), with its own magnetics/RJ45 footprint or a 0 Ω-option share of B38. This is also the only route for 10BASE-T, which the die does not support (TX amplitude bound, §1.14). | Fallback for WR-100TX-* if the 100BASE-TX generalizations (IX-9…IX-13) are not built or the baseline-wander and equalizer margins fail at 100 m. | §1.14 |
| B13 | **BACKUP wired RX: board CDR/retimer** covering 1.25–3.24 Gb/s with a recovered-clock output. It retimes data onto `WIRE_RX` and drives a recovered clock (line, /2 or /4) into `AUX_CLK` through a phase adjust of ≥ 1 UI range in ≤ 1/16 UI steps. Recovered clock jitter ≤ 0.05 UI rms. | Bench route if the on-chip CDR misses. | readiness `wire_rx_board_retimer` |
| B14 | **BACKUP wired TX: board serializer.** An FPGA transceiver or a discrete serializer drives the line directly above 1.6 Gb/s; at ≤ 1.6 Gb/s it may drive `WTX_EXT` (B12). | `WTX_EXT` is characterized to 1.6 Gb/s. | readiness `wire_tx_board_serializer` |
| B15 | **BACKUP PCIe: board 2:1 high-speed mux** (≥ 5 GHz bandwidth, ≤ 1.5 dB loss at 1.25 GHz) at the connector, selecting between the chip lane and a board PHY or FPGA transceiver. | Keeps a bench route for the protocol. | readiness `wire_board_phy_bypass` |

## Package and carrier

| ID | Requirement | Why |
|---|---|---|
| BP-1 | **Package model = per-pin chain** of `package-channel.json`: bond wire (per-bond length, inductance and resistance), 86.6 Ω microstrip, one via, connector. Every RF, LO and multi-Gb/s simulation that claims a board requirement includes it. | No signal passive can sit closer than the carrier. |
| BP-2 | **Carrier length compensation.** Add carrier length to the shorter leg of each pair (5.9 ps/mm on the board): BB_Q P +2.5 mm, WTX_EXT P +2.1, WIRE_TX N +2.0, BB_I P +1.7, RF_RX P +1.0 (board-equivalent mm). Match the LO I (REF_IN) and LO Q (AUX_CLK) pairs to equal total delay at the pads: the fixed traces differ by about 2.2 mm. Host groups: match to the per-pin delays or rely on FPGA deskew (HL-B5). | Intra-pair skew up to 14.7 ps; LO I/Q −11° to −19°. |
| BP-3 | **RF and LO passives within 10 mm of the connector** (≤ 30 mm at about +0.8 dB). 50 Ω coplanar-grounded lines with ground vias at each connector ground contact. RF_RX at contacts 12/13, LO Q 20/21, LO I 22/23, RF_TX 26/27. | Loss grows from 0.4 to 2.6 dB between 2 and 50 mm. |
| BP-4 | **The eight board capacitors (1 µF) populated**, plus ≥ 1 µF + 100 nF per supply contact within 5 mm on the carrier and ≥ 10 µF bulk. | They act below about 30 MHz; without them every supply figure is 1.2–1.5 × worse. |
| BP-5 | **Carrier ground at the connector:** every ground contact (10, 18, 25, 45, 53, 61) and all four shell tabs get their own via to a solid ground plane. No plane split under the connector. | Six contacts and four tabs carry all return current. |
| BP-6 | **Thermal:** top-side temperature-controlled cold finger over the glob-top (compliant non-conductive gel ≥ 3 W/m·K, ≤ 0.3 mm, not pressing on the bonds). Otherwise a per-mode set point with ≥ 30 s dwell after a mode change, junction read from the on-chip proxy. | No access to the die bottom. |
| BP-7 | **External LO source:** settable over ≥ 10 dB in ≤ 0.5 dB steps; never driven before power-up (B26). | Pad amplitude spread. |
| BP-8 | **Wired pairs on the carrier:** 100 Ω differential with BP-2 compensation; AC capacitors anywhere ≤ 50 mm; add 0.05 / 0.25 / 0.74 / 1.23 dB at 1.25 GHz for 2 / 10 / 30 / 50 mm to the channel budget. | `package-channel.md` section 4. |
| BP-9 | **Unused shared pads:** a pad that carries a different function on another carrier is left unconnected, without test points or stubs longer than 5 mm, on carriers that do not use it. | Per-application carriers. |

## Proposed, not adopted

From `scratch/reviews/offchip-passives.md` section 8. They become requirements only if the area item they
serve is adopted.

| Proposal | Carrier | Requirement |
|---|---|---|
| OCP-1 | RF | LO loop-filter capacitor off chip: 470 pF C0G ±5 % 0402 between the two pads it uses (`bidir[22]`/`[23]`), within 10 mm of the connector, routed as a pair away from switching nets with a guard trace at the return potential, no test point, board leakage ≤ 5 nA at 3 V. A second unfitted footprint allows loop-bandwidth changes. |
| OCP-2 | Wired | The B12 fallback data source and its AC capacitors connect to the `USB_DP`/`USB_DN` contacts instead of `WTX_EXT`; the USB connector and its parts are not fitted on wired carriers. Costs USB HS transmit from external serial data. Open with the user. |

## Host link (FPGA to chip)

Ten data bits plus a forwarded clock in each direction, DDR, 312.5 Mb/s per pin (156.25 MHz clock) at full
rate, 3.3 V LVCMOS at the die supply. D2H is on the south edge, H2D on the north edge; directions are fixed
in the current RTL. The timing budget is in [interface-requirements.md](interface-requirements.md) (HL-*);
the FPGA screen is in [fpga-connection-plan.md](fpga-connection-plan.md).

| ID | Requirement | Why |
|---|---|---|
| HL-B1 | **Topology.** D2H and H2D are separate source-synchronous groups, each clock routed with its data. Clocks go to clock-capable FPGA pins; H2D_CLK is forwarded from an output DDR register, centred in the data eye. A board that wants reversible banks later (HL-DIR) routes both clocks to pins that are clock-capable and bidirectional. | The chip captures H2D on H2D_CLK and launches D2H edge-aligned with D2H_CLK. |
| HL-B2 | **Impedance and length.** 50 Ω ±10 % single-ended over a continuous ground plane. Data-to-clock length matched within ±2.5 mm. Total length ≤ 60 mm. Series source termination 22–33 Ω within 5 mm of each driver: D2H at the connector, H2D at the FPGA. | Edges are 0.76–1.4 ns: the lines are transmission lines. |
| HL-B3 | **Load.** ≤ 10 pF per line, counting FPGA pin, trace and the B6 switch. | Chip-side screens used 6–10 pF. |
| HL-B4 | **Simultaneous switching.** All 11 D2H outputs may switch on one edge: one ground via per 2 host signals within 3 mm of the connector; ≥ 2 × 100 nF plus 1 µF on each host supply contact within 5 mm; ground bounce ≤ 300 mV at a quiet D2H pin (HL-SSO). The FPGA respects its vendor limit for 11 LVCMOS33 outputs in one bank. | Package model: 486 mV at 0.76 ns edges unstaggered. |
| HL-B5 | **Receiver window and training.** Per-bit input delay (≤ 80 ps step, ≥ 1.6 ns range) and per-lane word alignment, trained on the chip's training prefix. FPGA input setup + hold ≤ 1.0 ns at the pin. | The D2H budget assumes a 1000 ps FPGA window. |
| HL-B6 | **Rate modes.** Bring-up starts at `debug.host_link.rate` = div4 (78.125 Mb/s per pin). RF modes run at div2 (PWR-HOST-RF). Full rate only after training passes. | Reduced-rate fallback; host IO current. |
| HL-B7 | **No FPGA pulls or keepers on the host banks** except the B50 SPI resistors. If reversible banks (HL-DIR) are built, the gateware tristates a bank before the chip is told to drive it. | Contention would be 30–40 mA per pin. |
| HL-B8 | **Observation pins to the FPGA.** `DBG_OBS0`, `DBG_OBS1` and `CLK_OBS` go to 3.3 V FPGA inputs without pulls; `CLK_OBS` on a clock-capable input. Test-point stubs ≤ 5 mm. | Status, events and frequency measurement without an in-band frame. |
