deepai-org/svalbard/projects/programmable_transceiver_platform/spec/register-map.md

# Control register map

Generated by `rtl/gen/gen_regfile.py` from `analog-architecture.json:control_fields` and
`debug-controls.json`. Do not edit; regenerate. The machine-readable map is
`register-map.json`; bench headers are `rtl/gen/pt_regmap.h` and `rtl/gen/pt_regmap.py`.

Map hash `0x882D` (read at 0x09), ABI version `0x0003` (0x08), ID `0x5356` (0x00).
125 generated registers (32 debug/fallback at 0x40-0x59, 93 analog at 0x60-0xB7) carrying 276 fields (912 bits); 44 commit rules.

## SPI ABI

Unchanged: SPI mode 0, MSB first, one 32-clock transaction per CS_N low period: command8 /
address8 / data16. Command 0x80 writes, 0x00 reads (read data is shifted out during the last
16 clocks). The flat 8-bit address space holds every register, so no page register is used.
The register file is clocked only by `HOST_SCLK` and works with every PLL and oscillator stopped.
A write (and a COMMIT) takes effect on the SCLK falling edge that follows the 32nd rising edge;
in mode 0 SCLK returns low before CS_N rises, so that edge is always present. Clocks beyond the
32nd never repeat a write.
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
