deepai-org/svalbard/docs/images/clock-pulse-generator-layout.png

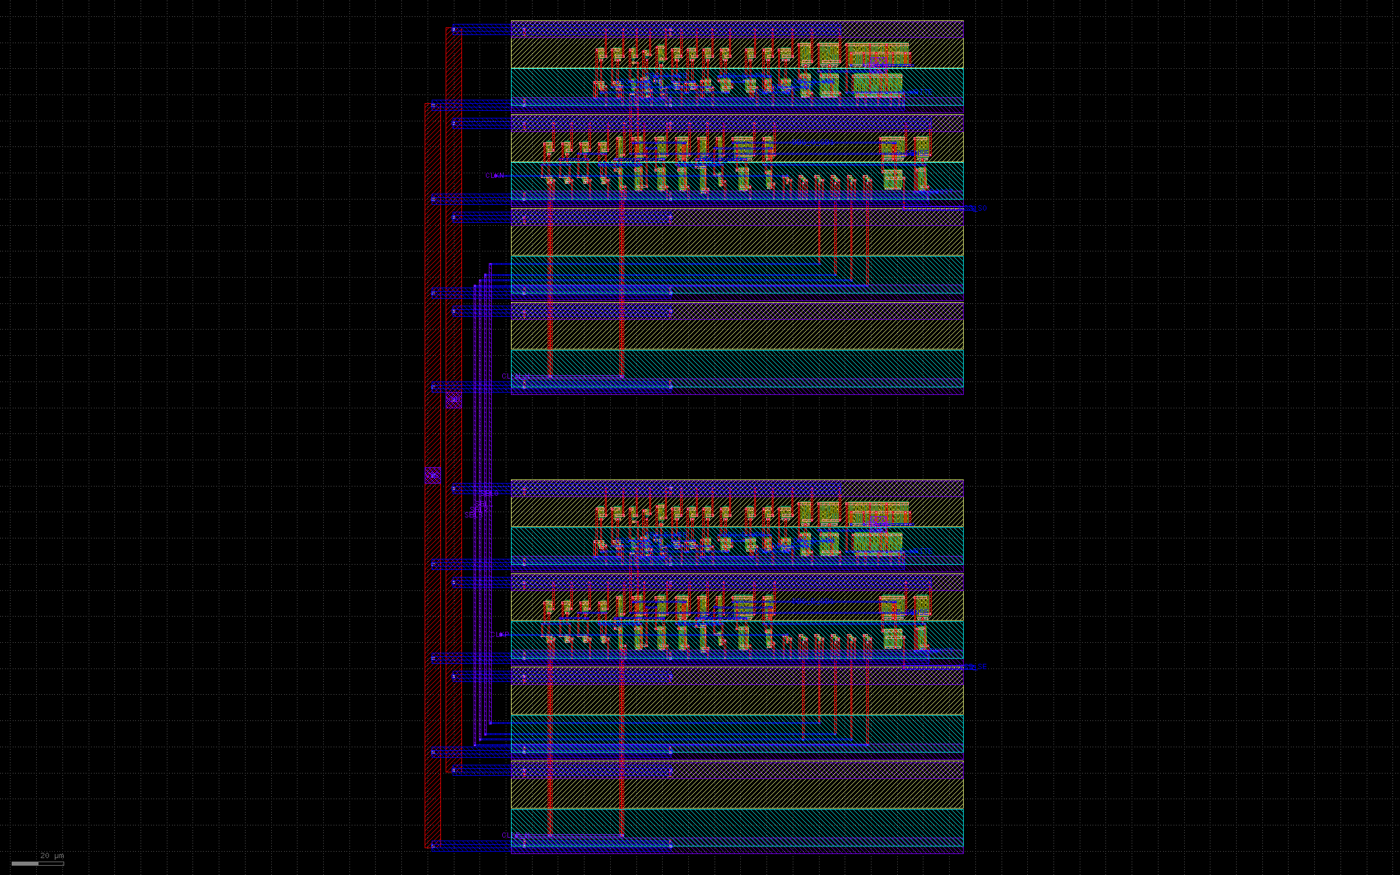
docs/images/clock-pulse-generator-layout.png
