deepai-org/svalbard/docs/images/pcie-analog-floorplan-proposal.png

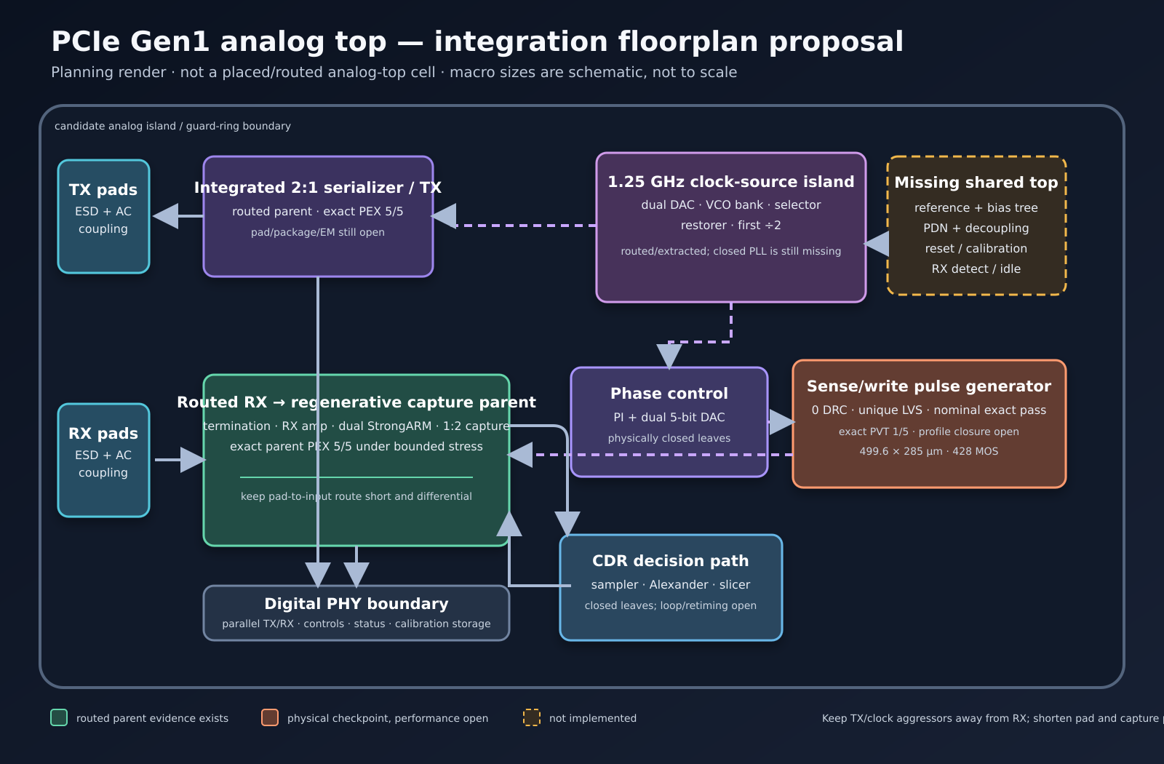
docs/images/pcie-analog-floorplan-proposal.png
