deepai-org/svalbard/docs/images/pcie-event-capture-final-restore-layout.png

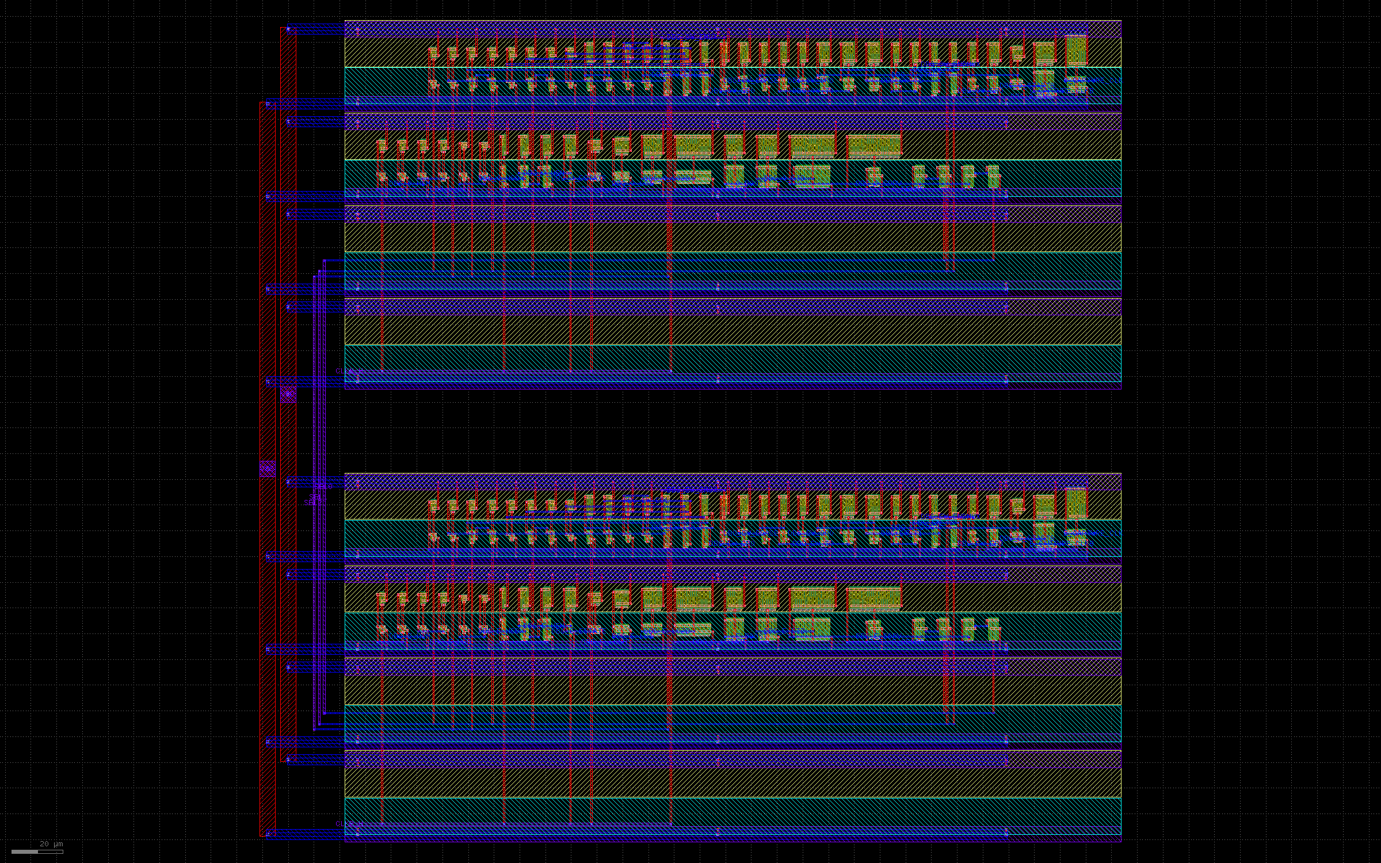
docs/images/pcie-event-capture-final-restore-layout.png
