deepai-org/svalbard/docs/images/pcie-event-capture-start-end-sr-layout.png

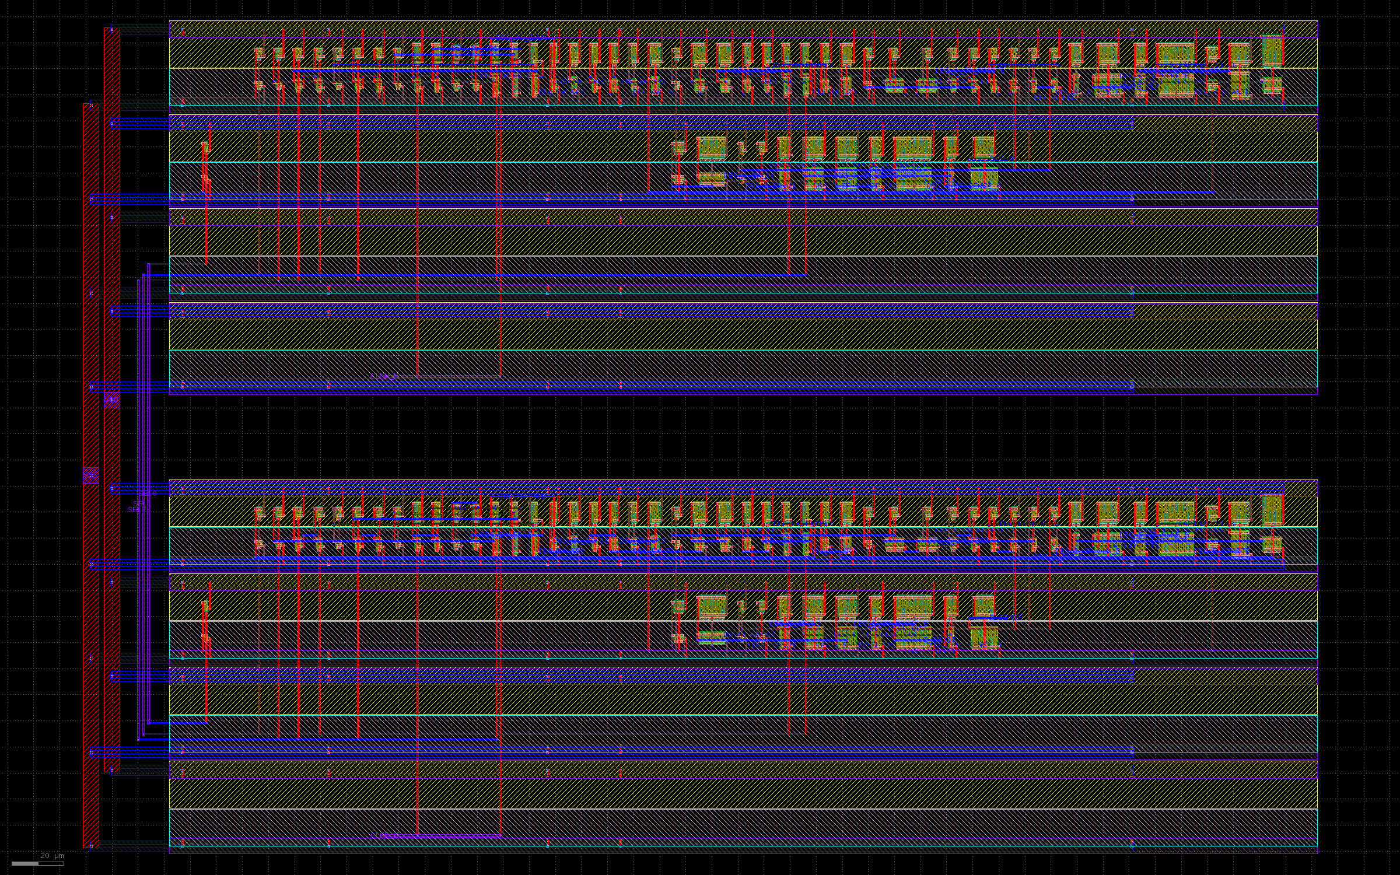
docs/images/pcie-event-capture-start-end-sr-layout.png
