deepai-org/svalbard/docs/images/pcie-event-capture-state-free-buffered-layout.png

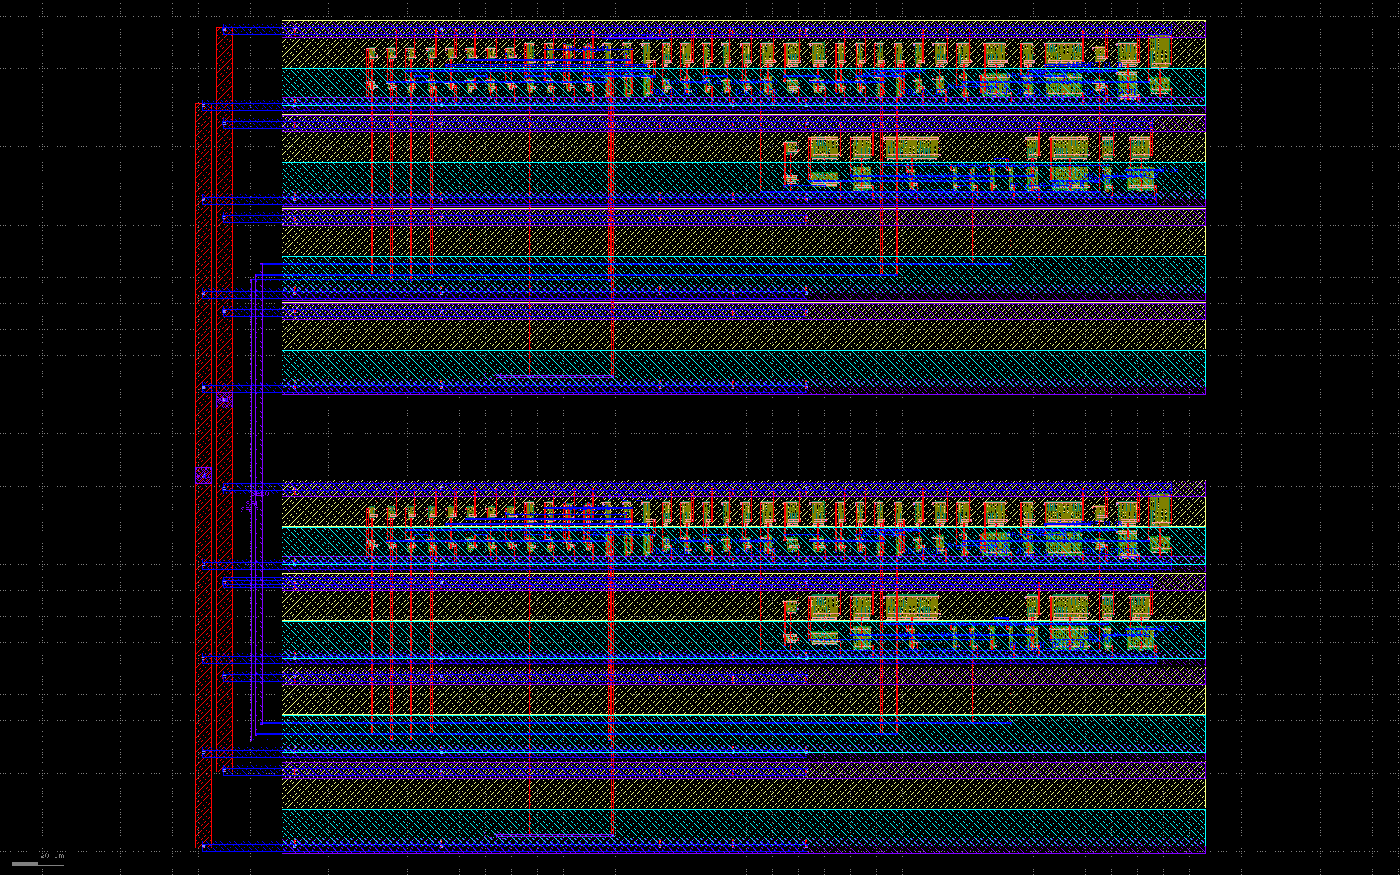
docs/images/pcie-event-capture-state-free-buffered-layout.png
