deepai-org/svalbard/docs/images/pcie-event-capture-state-free-layout.png

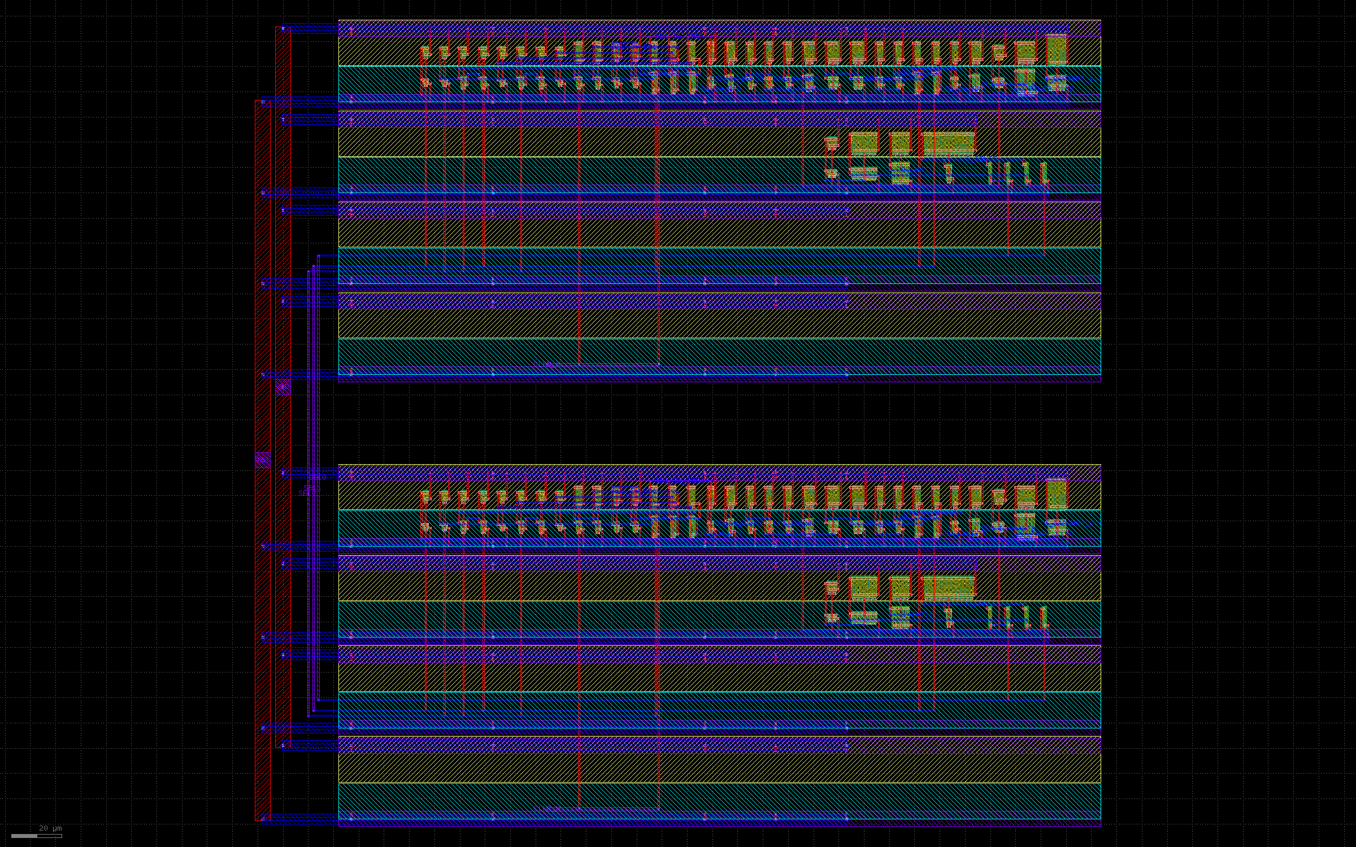
docs/images/pcie-event-capture-state-free-layout.png
