deepai-org/svalbard/docs/images/pcie-event-lane-routed-parent-layout.png

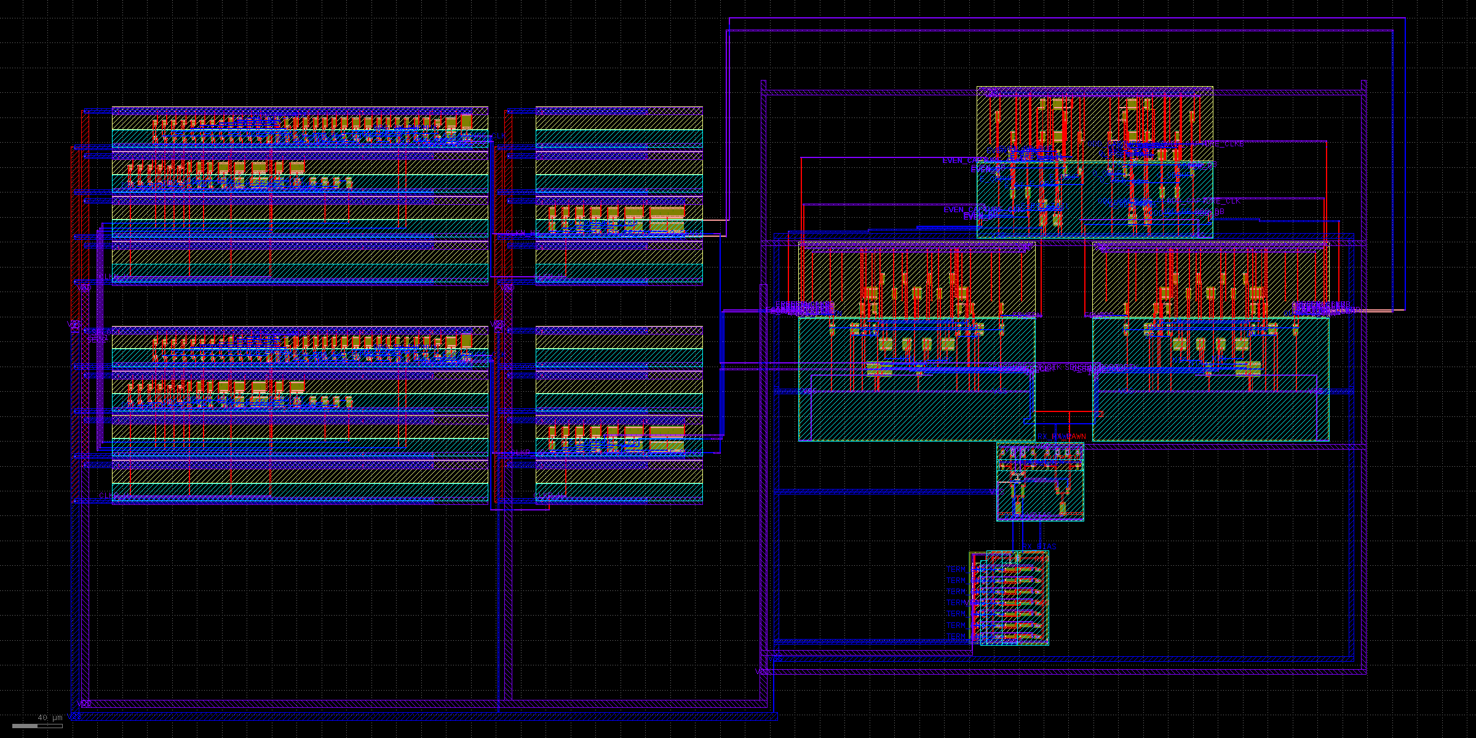
docs/images/pcie-event-lane-routed-parent-layout.png
