deepai-org/svalbard/docs/images/pcie-local-clock-fanout-v3-layout.png

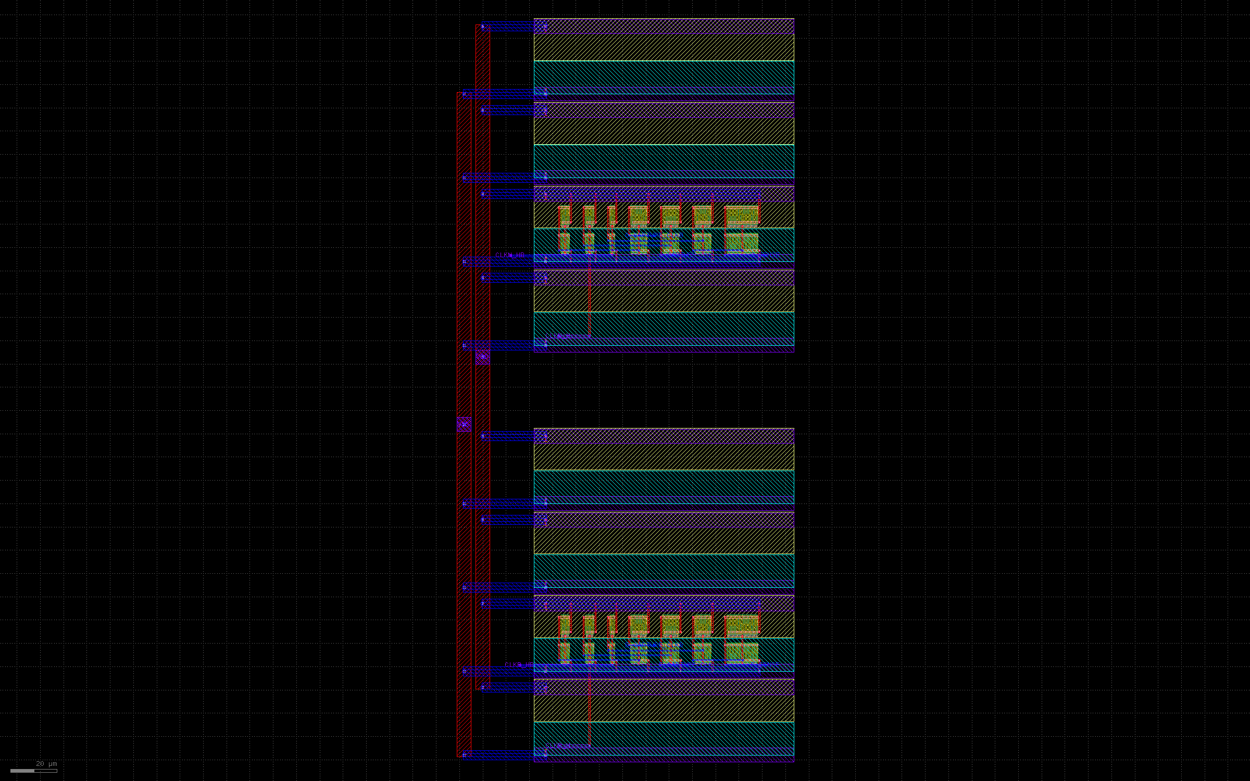
docs/images/pcie-local-clock-fanout-v3-layout.png
