deepai-org/svalbard/docs/images/pcie-local-clock-fanout-v9-layout.png

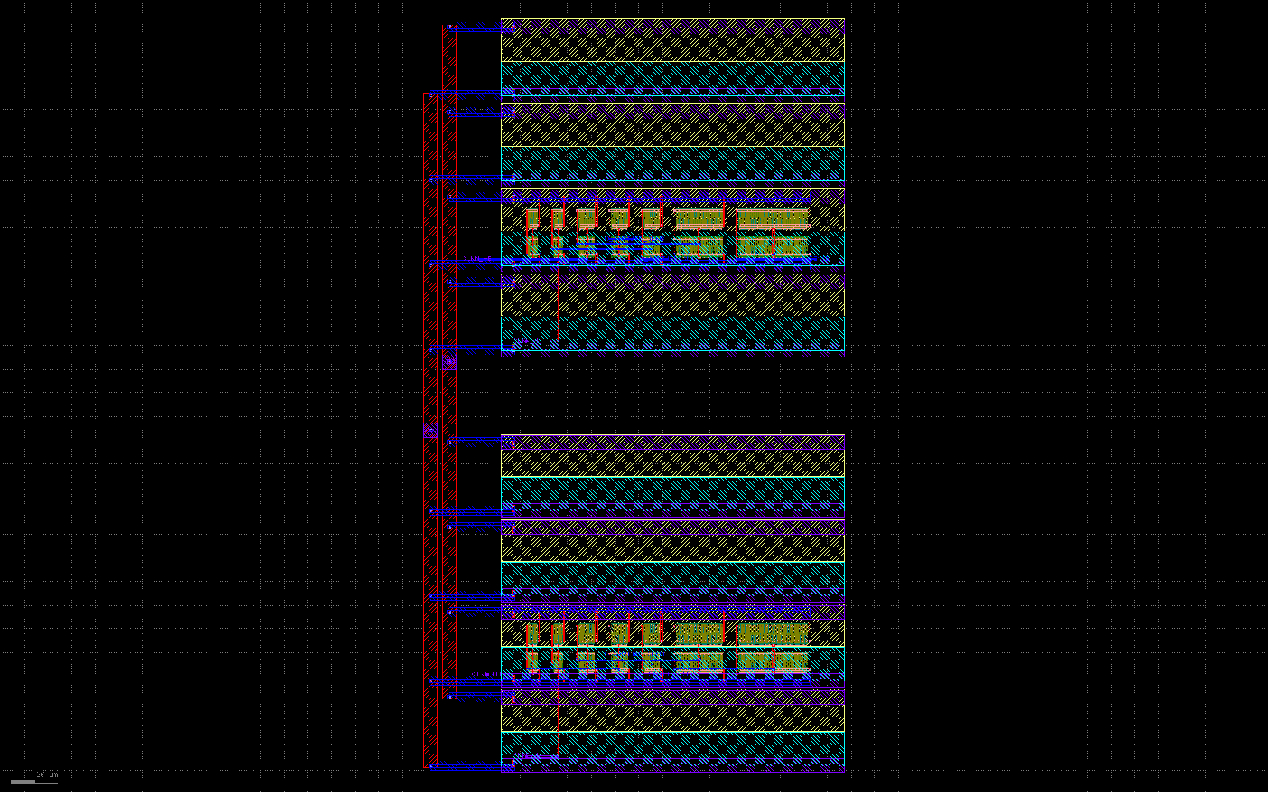
docs/images/pcie-local-clock-fanout-v9-layout.png
