deepai-org/svalbard/docs/images/pcie-local-clock-fanout-v10-layout.png

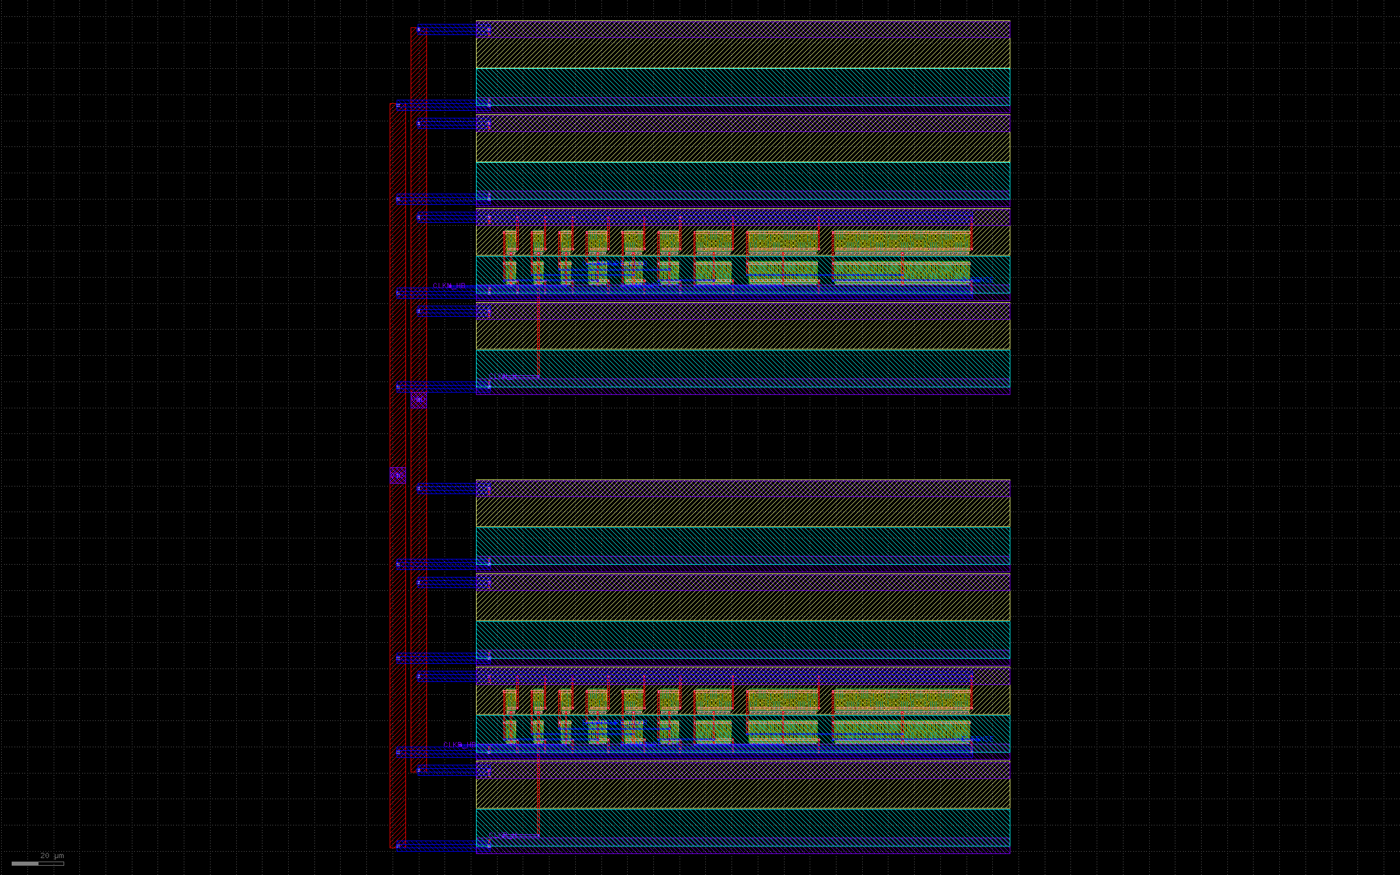
docs/images/pcie-local-clock-fanout-v10-layout.png
