deepai-org/svalbard/docs/images/wifi-lna-cs-core-layout.png

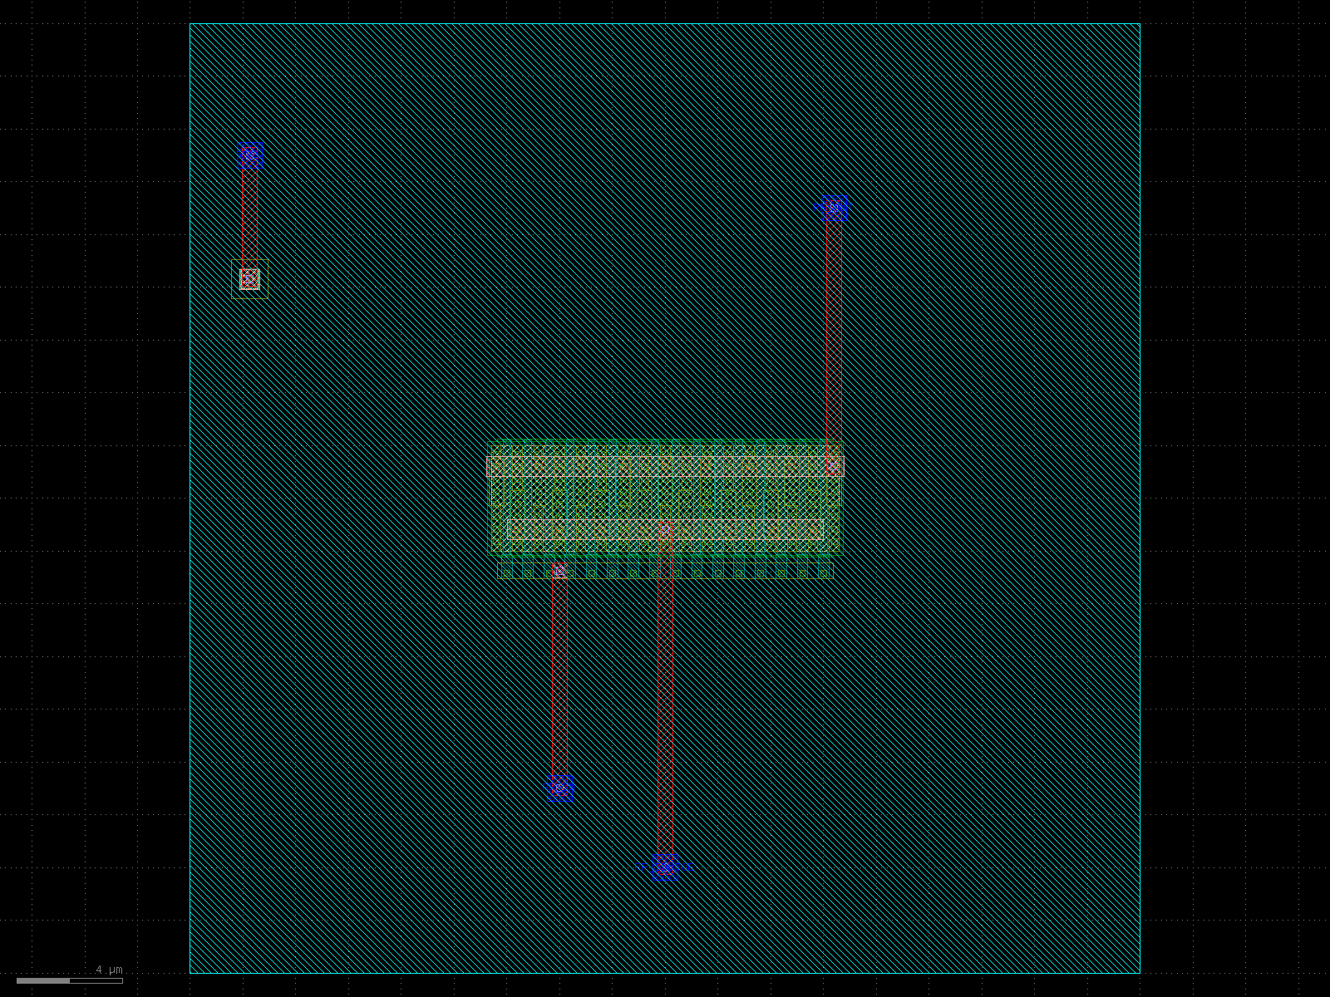
docs/images/wifi-lna-cs-core-layout.png
