deepai-org/svalbard/docs/images/wifi-rf-nfet-array-coupon-layout.png

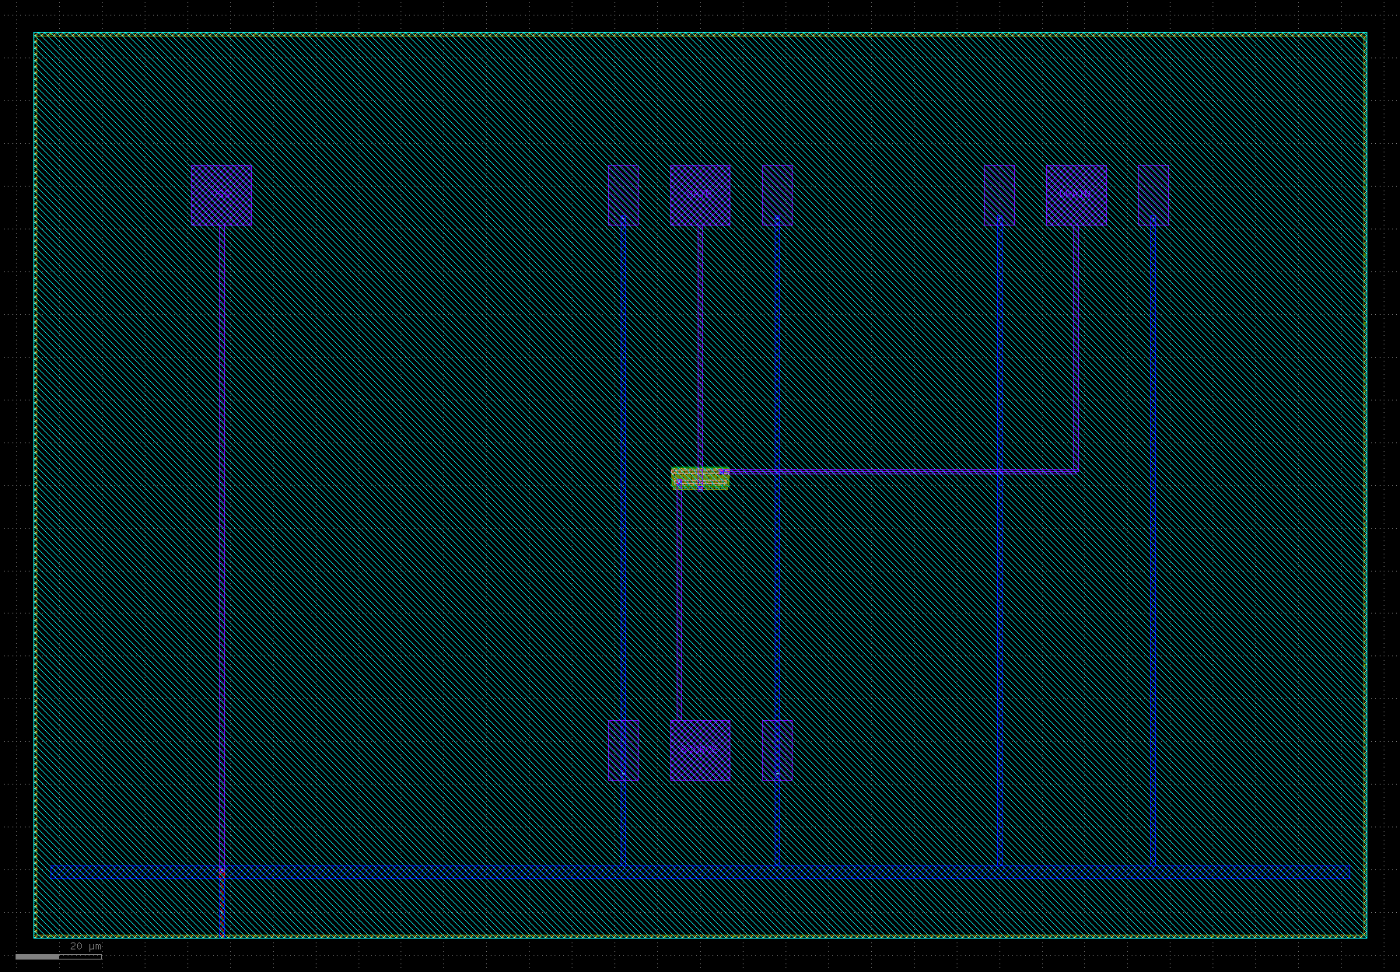
docs/images/wifi-rf-nfet-array-coupon-layout.png
