deepai-org/svalbard/docs/images/wifi-rf-ostl-coupon-layout.png

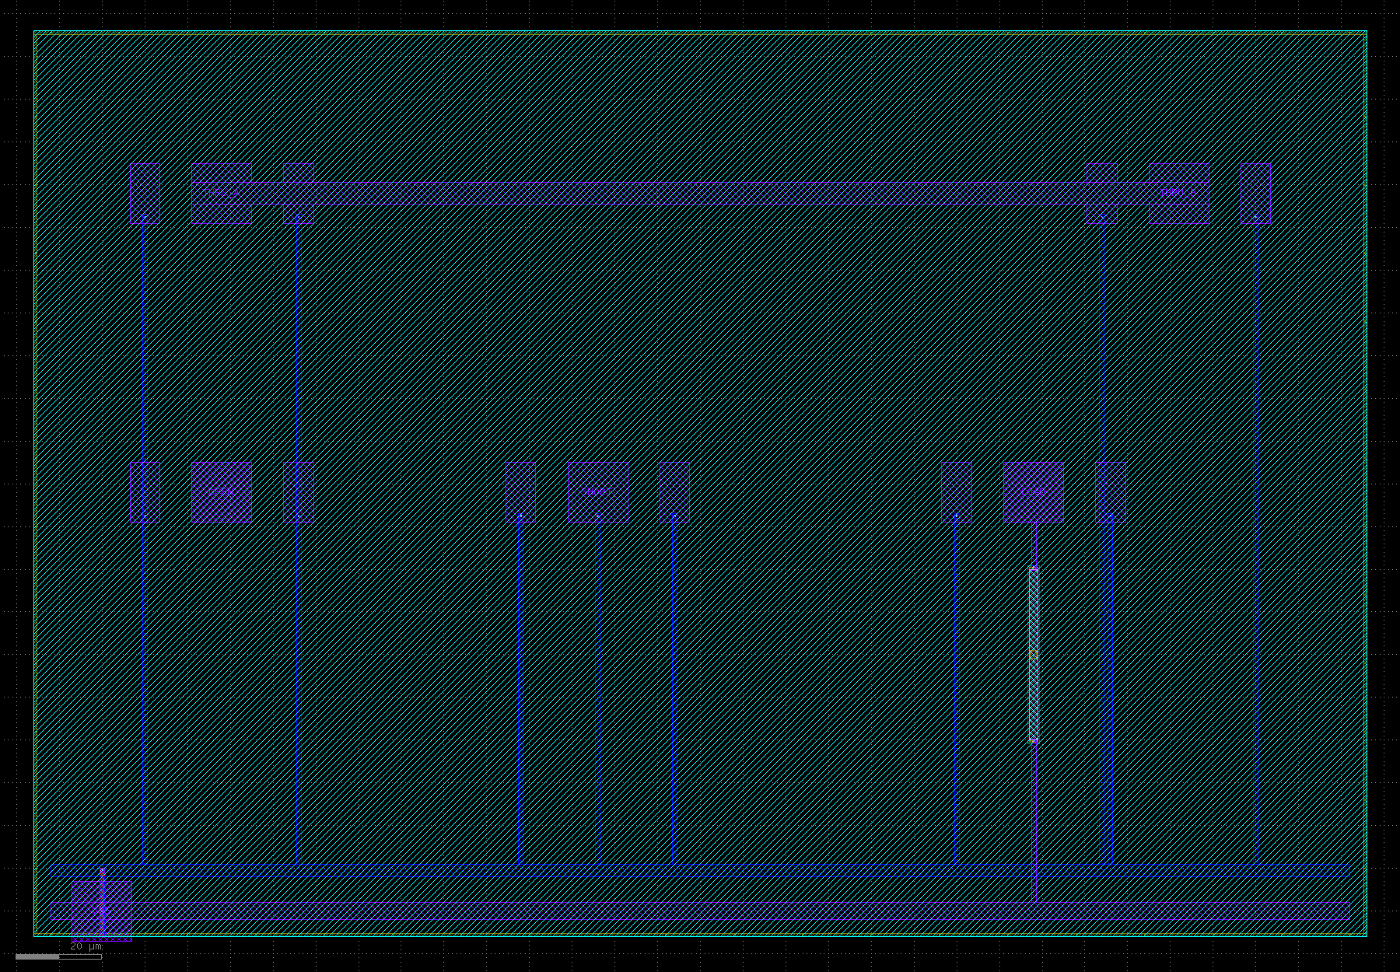
docs/images/wifi-rf-ostl-coupon-layout.png
