deepai-org/svalbard/docs/images/wifi-rf-switch-mixer-layout.png

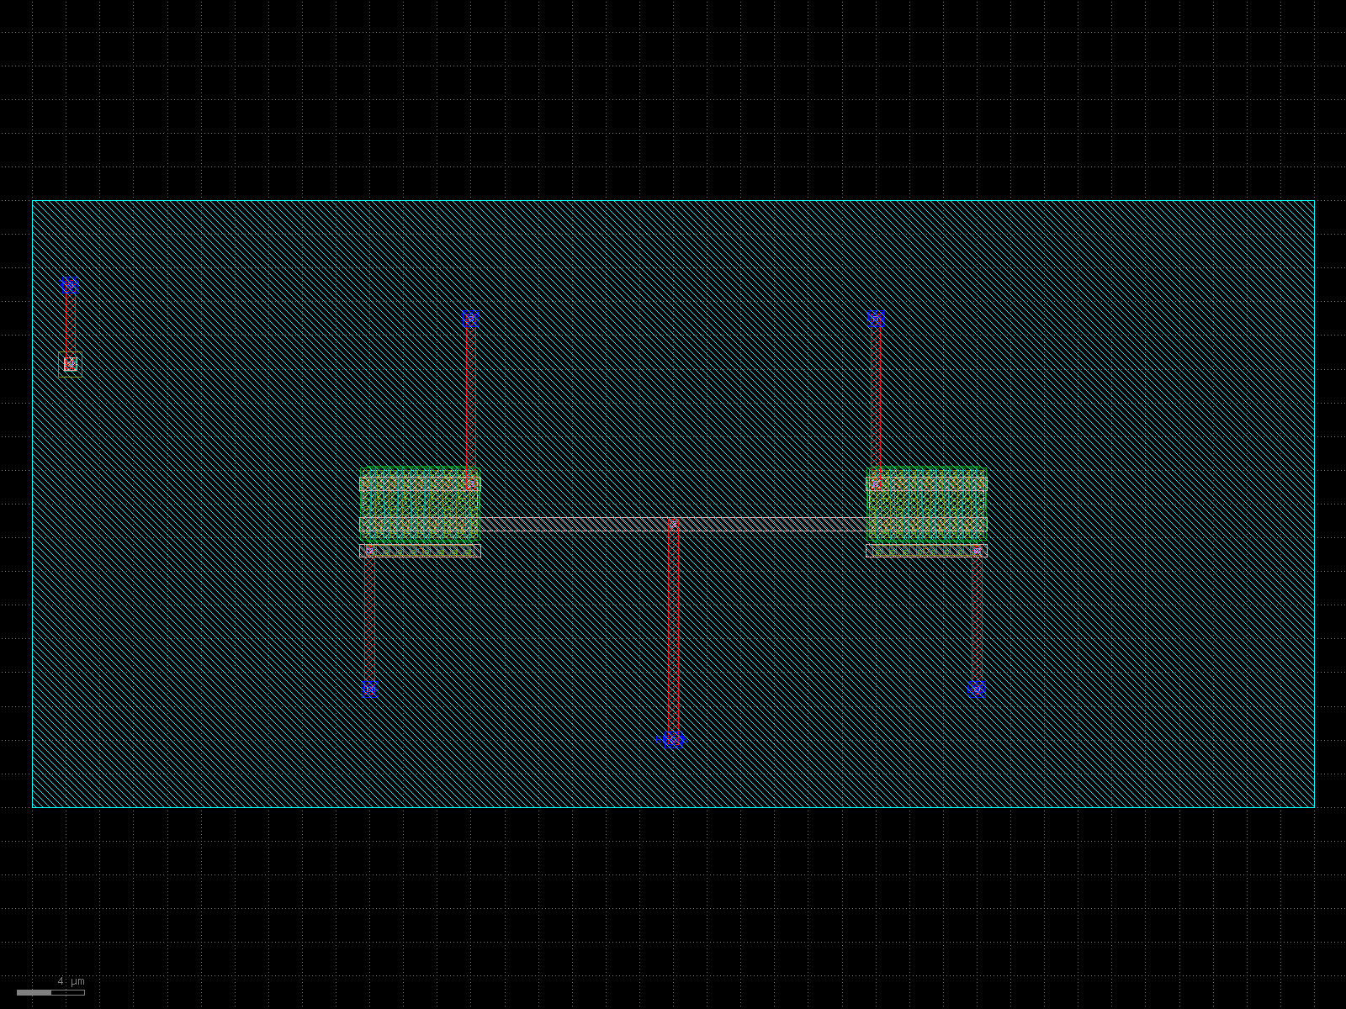
docs/images/wifi-rf-switch-mixer-layout.png
