deepai-org/svalbard/docs/images/wifi-rx-external-lo-parent-layout.png

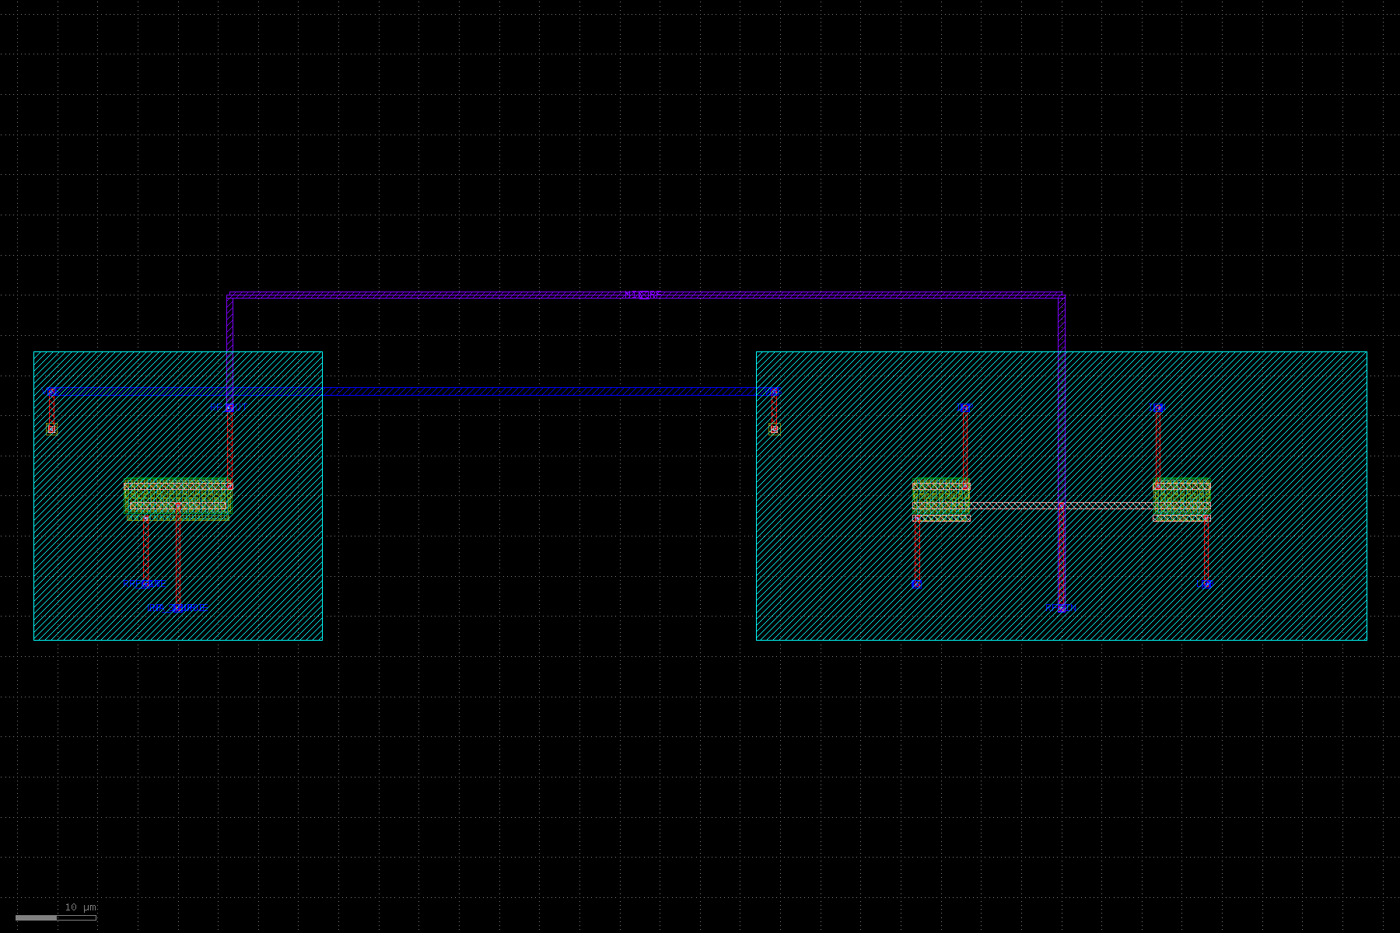
docs/images/wifi-rx-external-lo-parent-layout.png
