deepai-org/svalbard/ip/blocks/analog/wireline_serdes/clock_pulse/layout.png

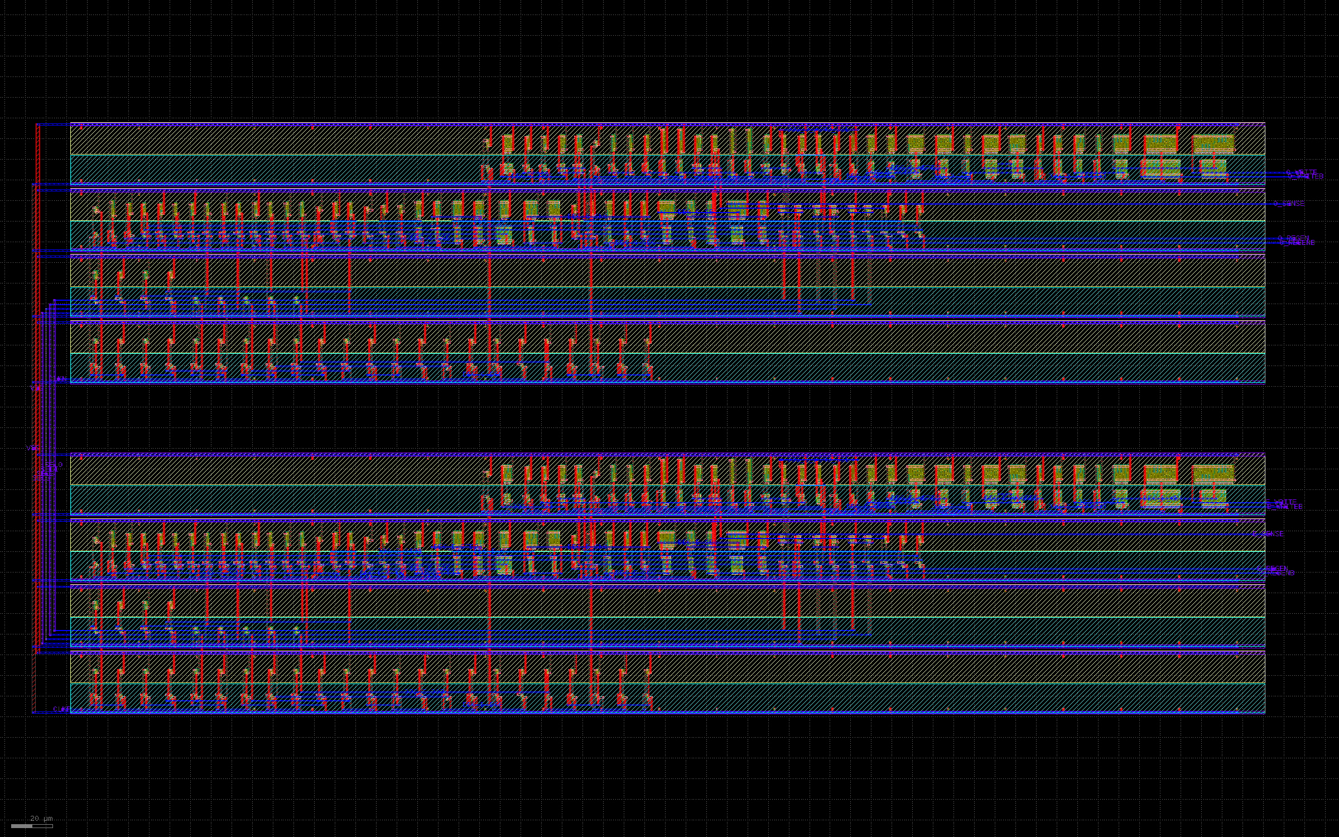
ip/blocks/analog/wireline_serdes/clock_pulse/layout.png
