deepai-org/svalbard/ip/blocks/analog/wireline_serdes/deserializer_split/layout.png

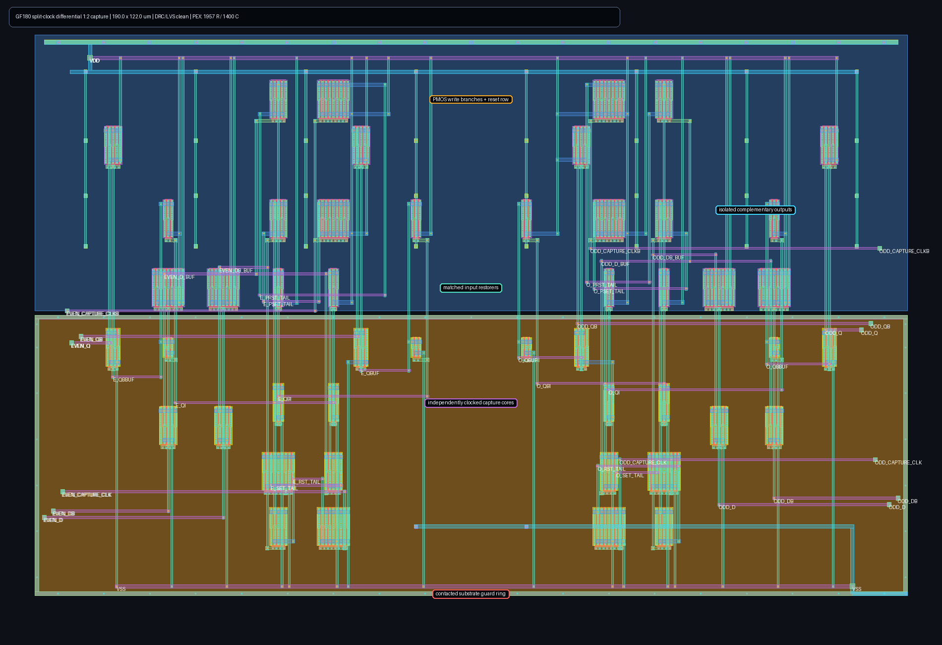
ip/blocks/analog/wireline_serdes/deserializer_split/layout.png
