deepai-org/svalbard/ip/blocks/analog/wireline_serdes/event_lane_routed_parent/event_lane_routed_parent-layout.png

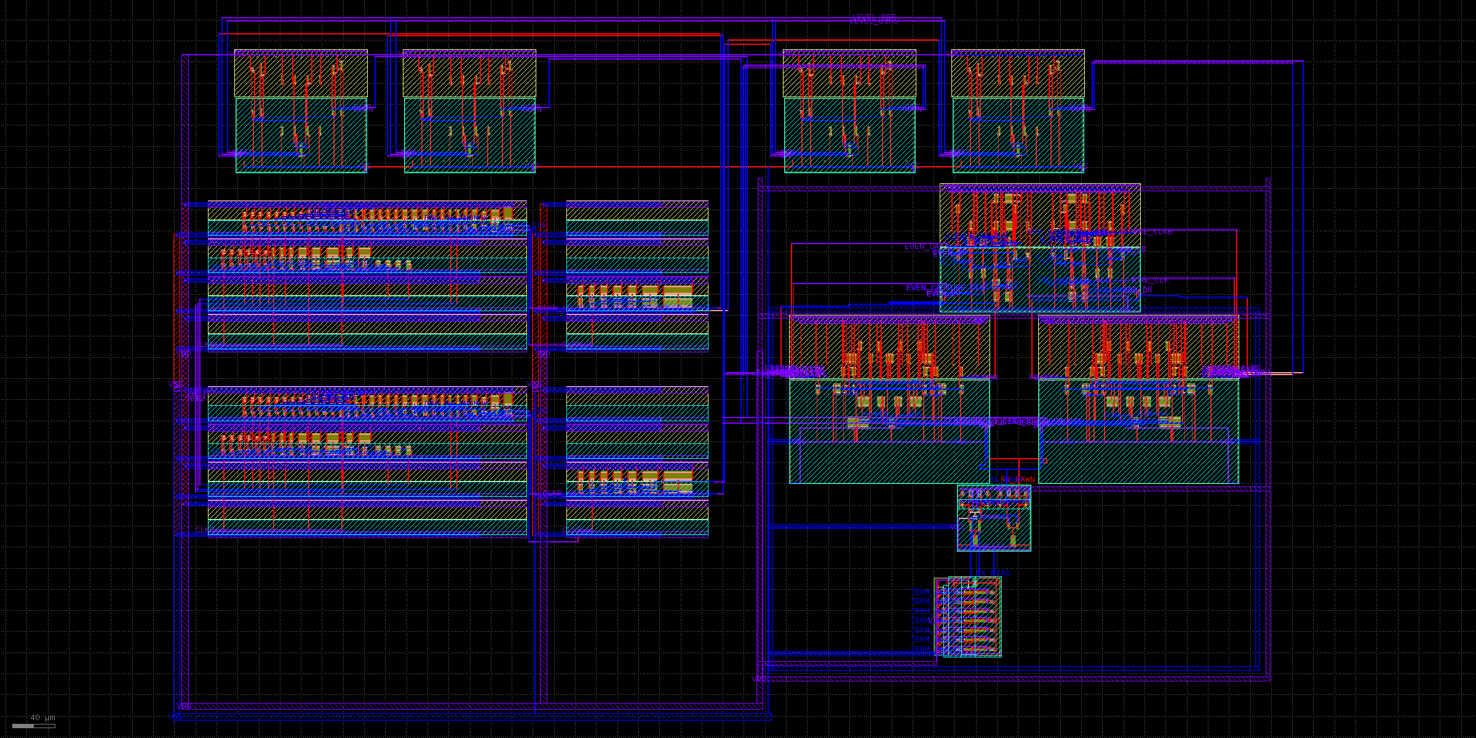
ip/blocks/analog/wireline_serdes/event_lane_routed_parent/event_lane_routed_parent-layout.png
