deepai-org/svalbard/ip/blocks/analog/wireline_serdes/lane_rx_frontend/layout.png

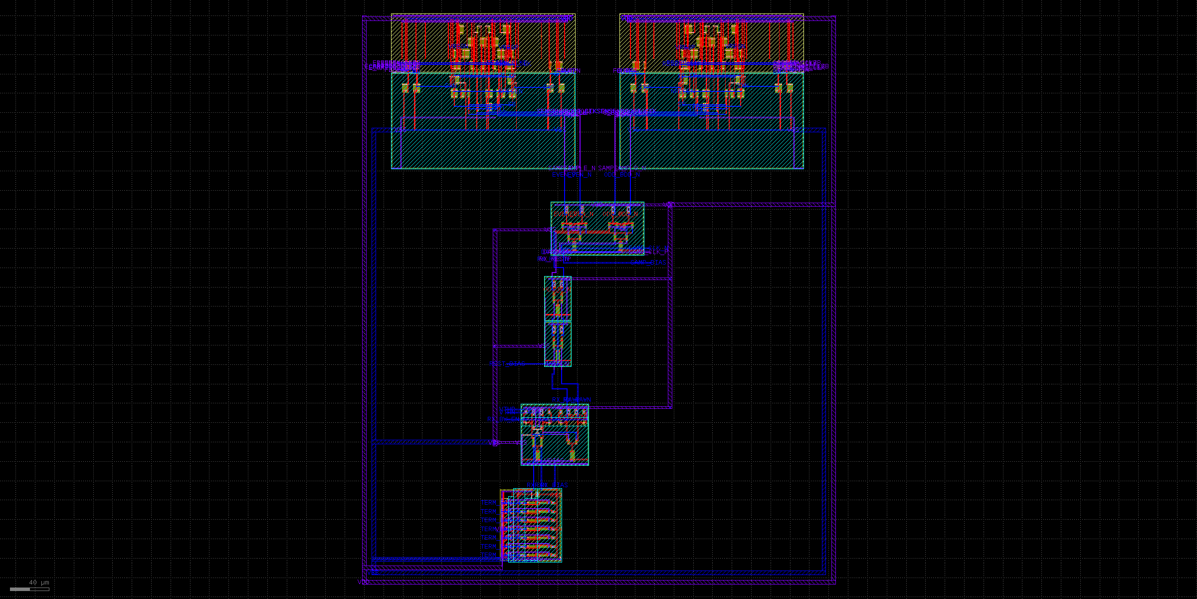
ip/blocks/analog/wireline_serdes/lane_rx_frontend/layout.png
