deepai-org/svalbard/ip/blocks/analog/wireline_serdes/lane_rx_regenerative_capture/layout.png

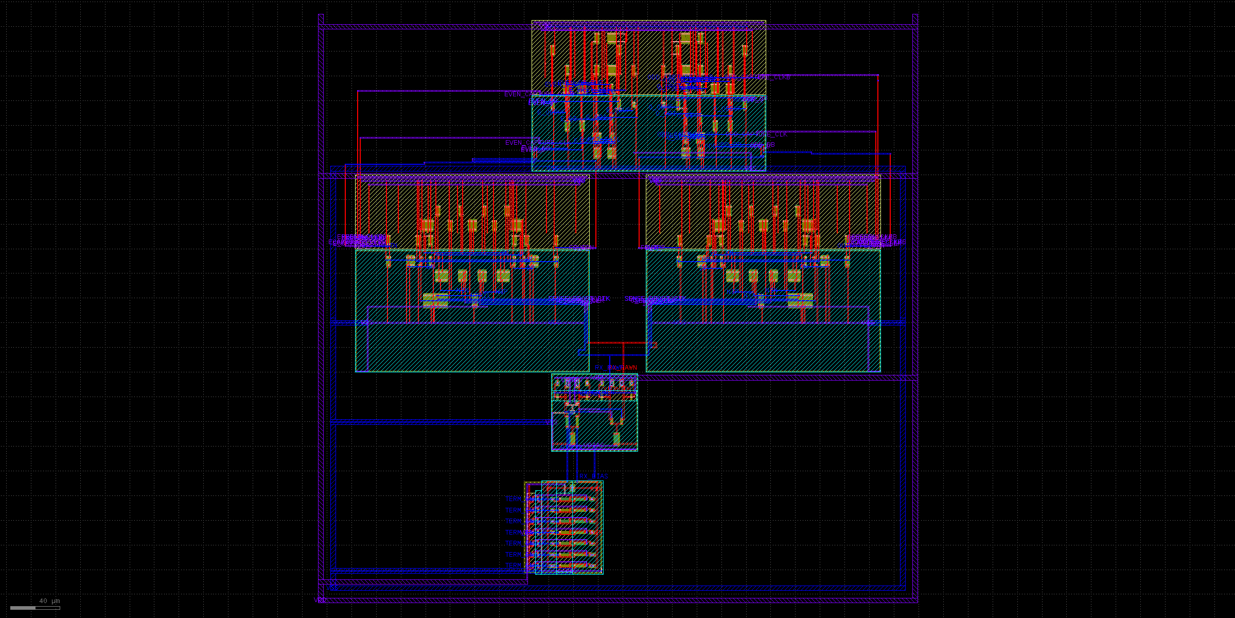
ip/blocks/analog/wireline_serdes/lane_rx_regenerative_capture/layout.png
