deepai-org/svalbard/ip/blocks/analog/wireline_serdes/pll/layout.png

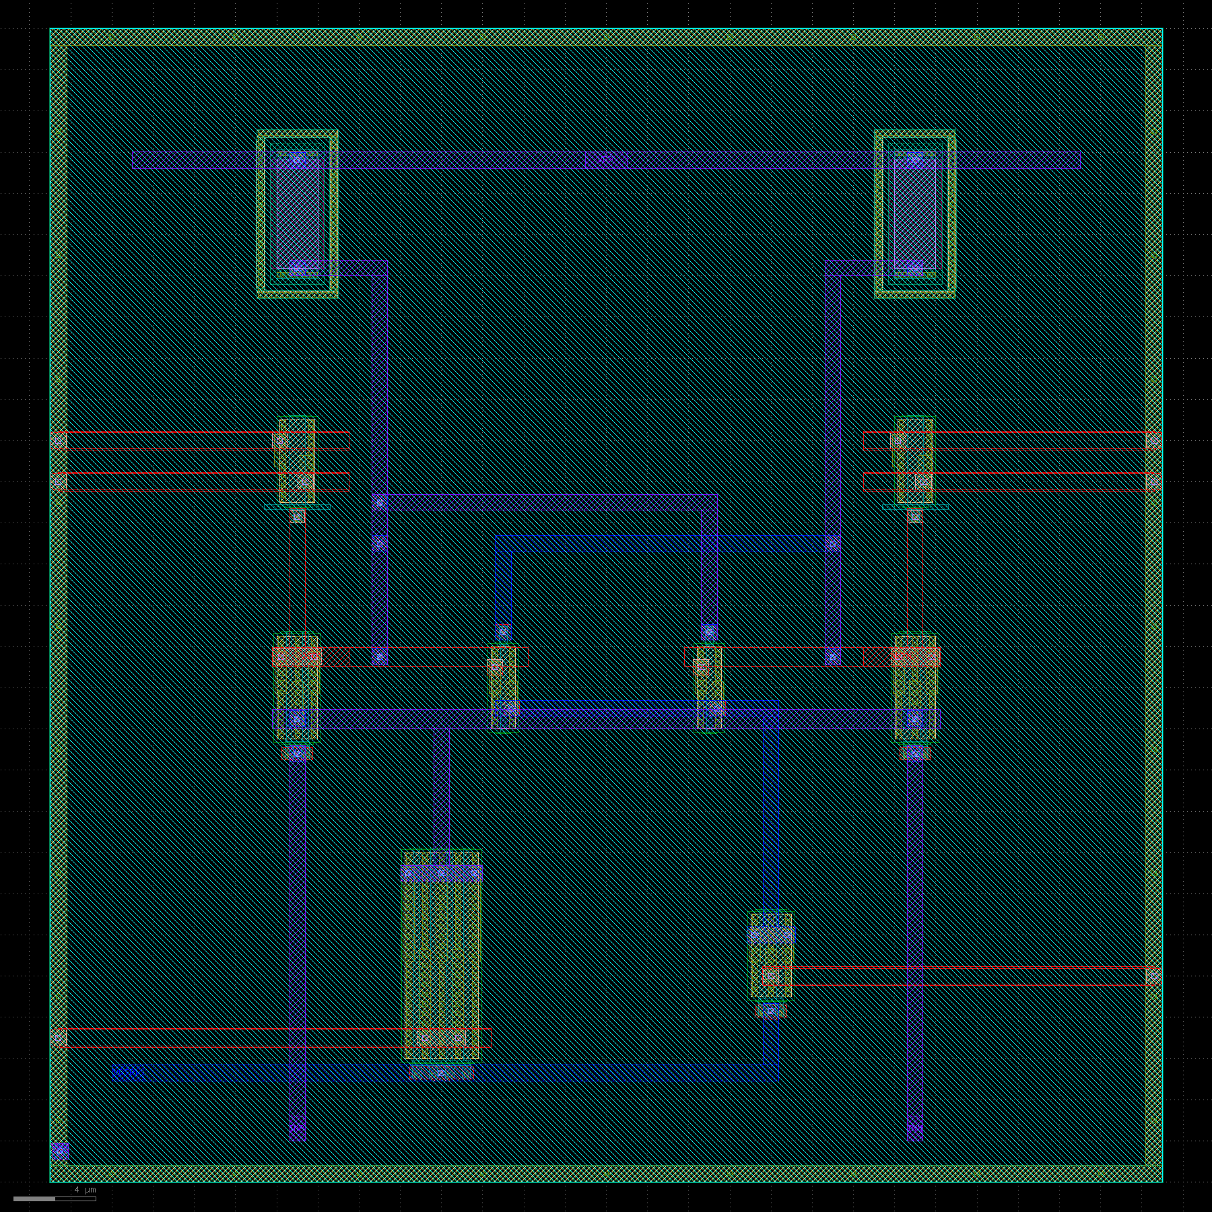
ip/blocks/analog/wireline_serdes/pll/layout.png
