deepai-org/svalbard/ip/blocks/analog/wireline_serdes/pll/layout_divider.png

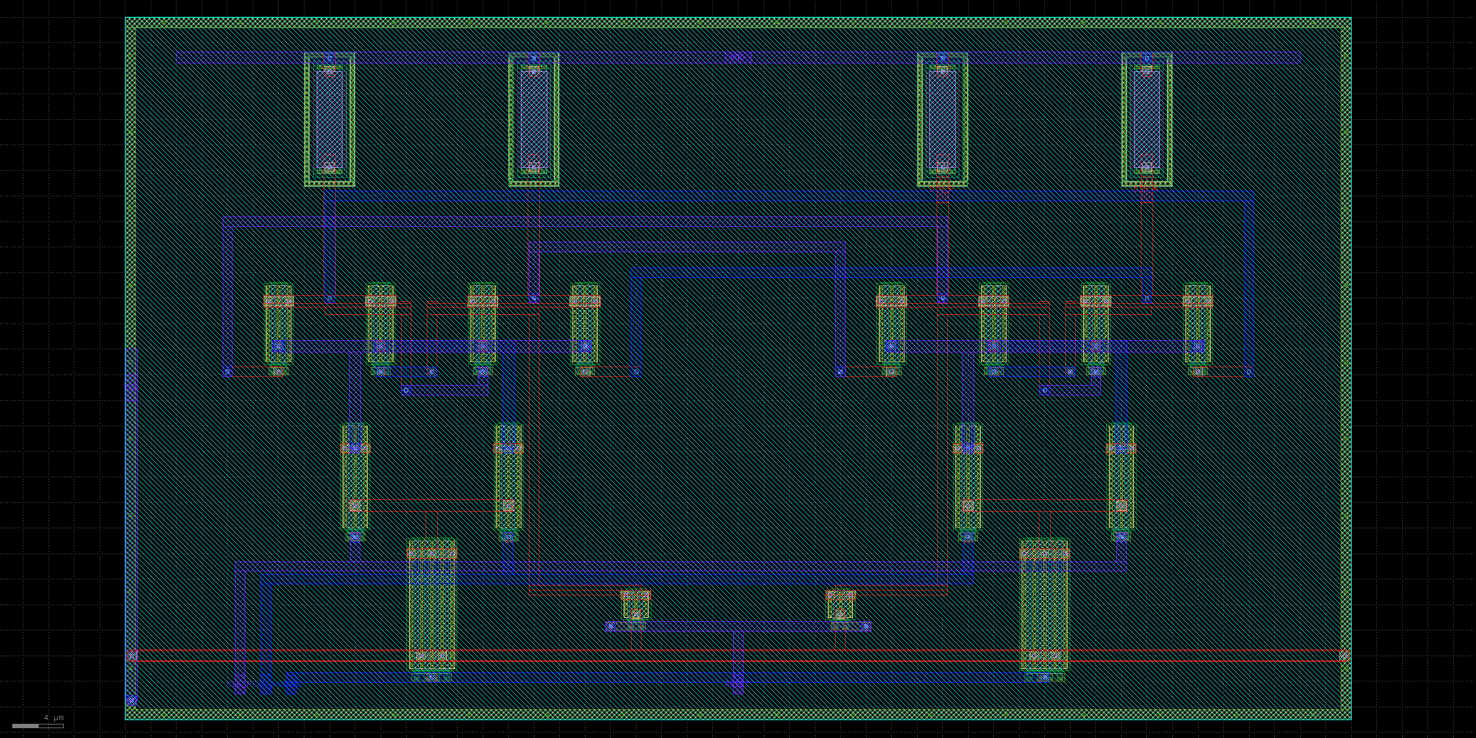
ip/blocks/analog/wireline_serdes/pll/layout_divider.png
