deepai-org/svalbard/ip/blocks/analog/wireline_serdes/pll/layout_half_rate_vco_bank.png

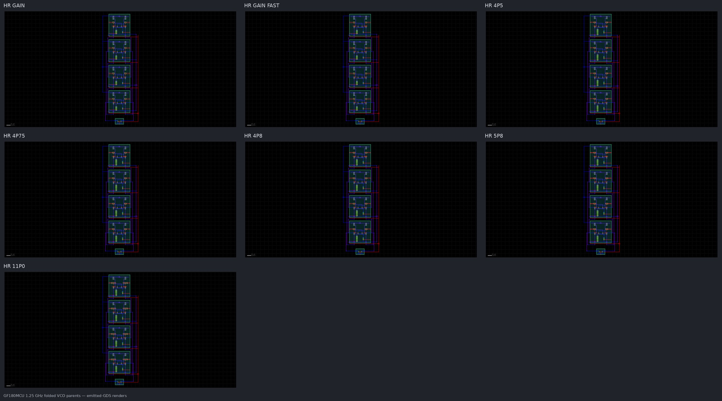
ip/blocks/analog/wireline_serdes/pll/layout_half_rate_vco_bank.png
