deepai-org/svalbard/ip/blocks/analog/wireline_serdes/pll/layout_pll_clock_path.png

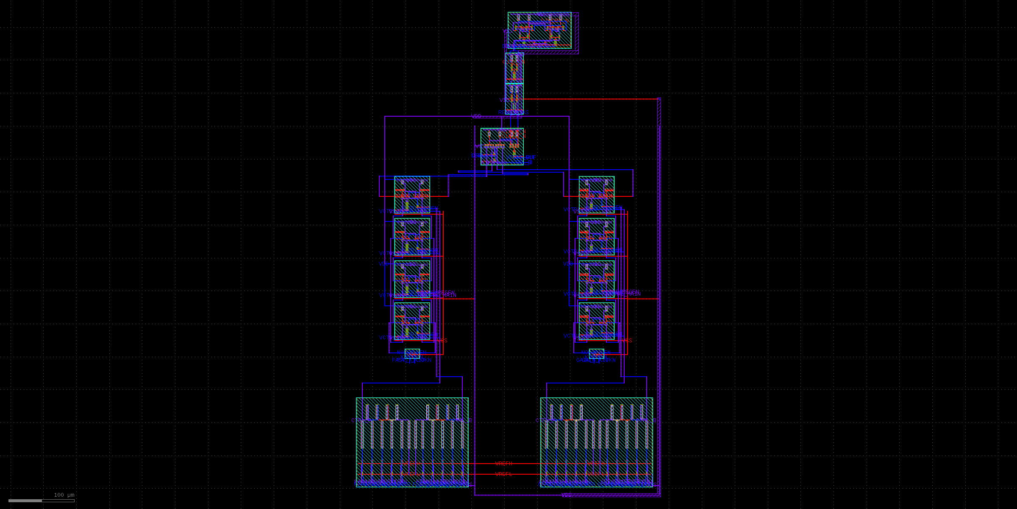
ip/blocks/analog/wireline_serdes/pll/layout_pll_clock_path.png
