deepai-org/svalbard/ip/blocks/analog/wireline_serdes/pll/layout_selector_tree.png

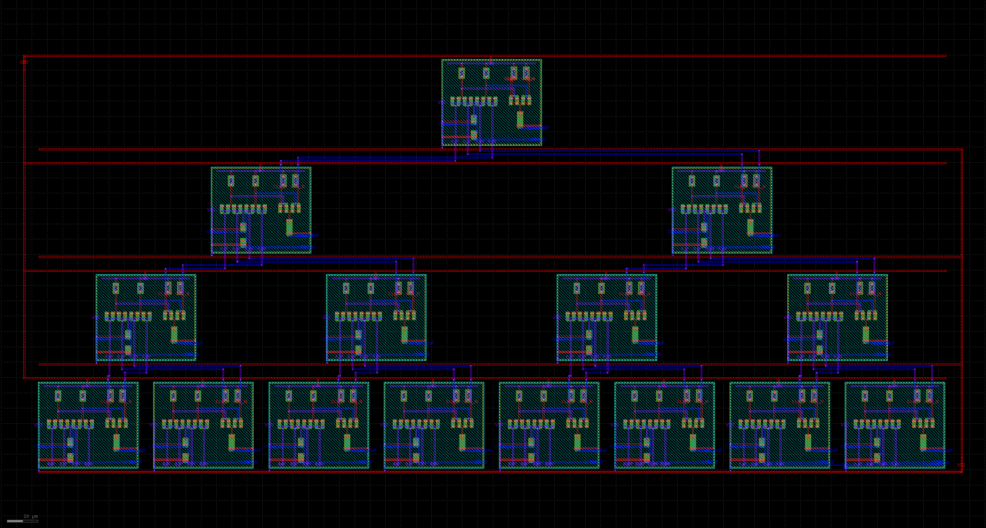
ip/blocks/analog/wireline_serdes/pll/layout_selector_tree.png
