deepai-org/svalbard/ip/blocks/analog/wireline_serdes/pll/layout_split_control_vco.png

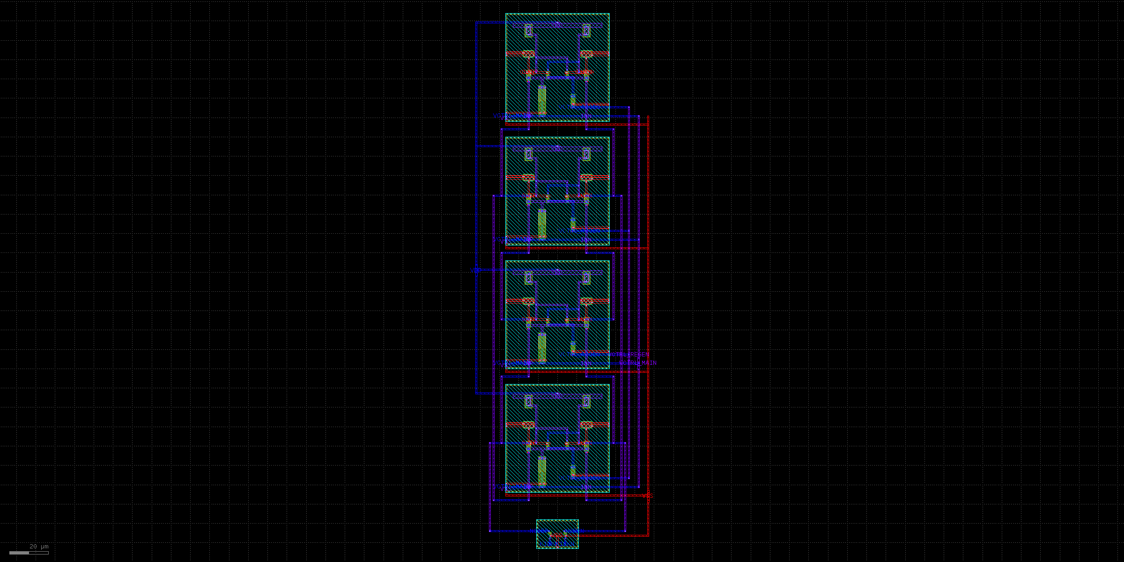
ip/blocks/analog/wireline_serdes/pll/layout_split_control_vco.png
