deepai-org/svalbard/ip/blocks/analog/wireline_serdes/pll/layout_ss_ff_margin_slow.png

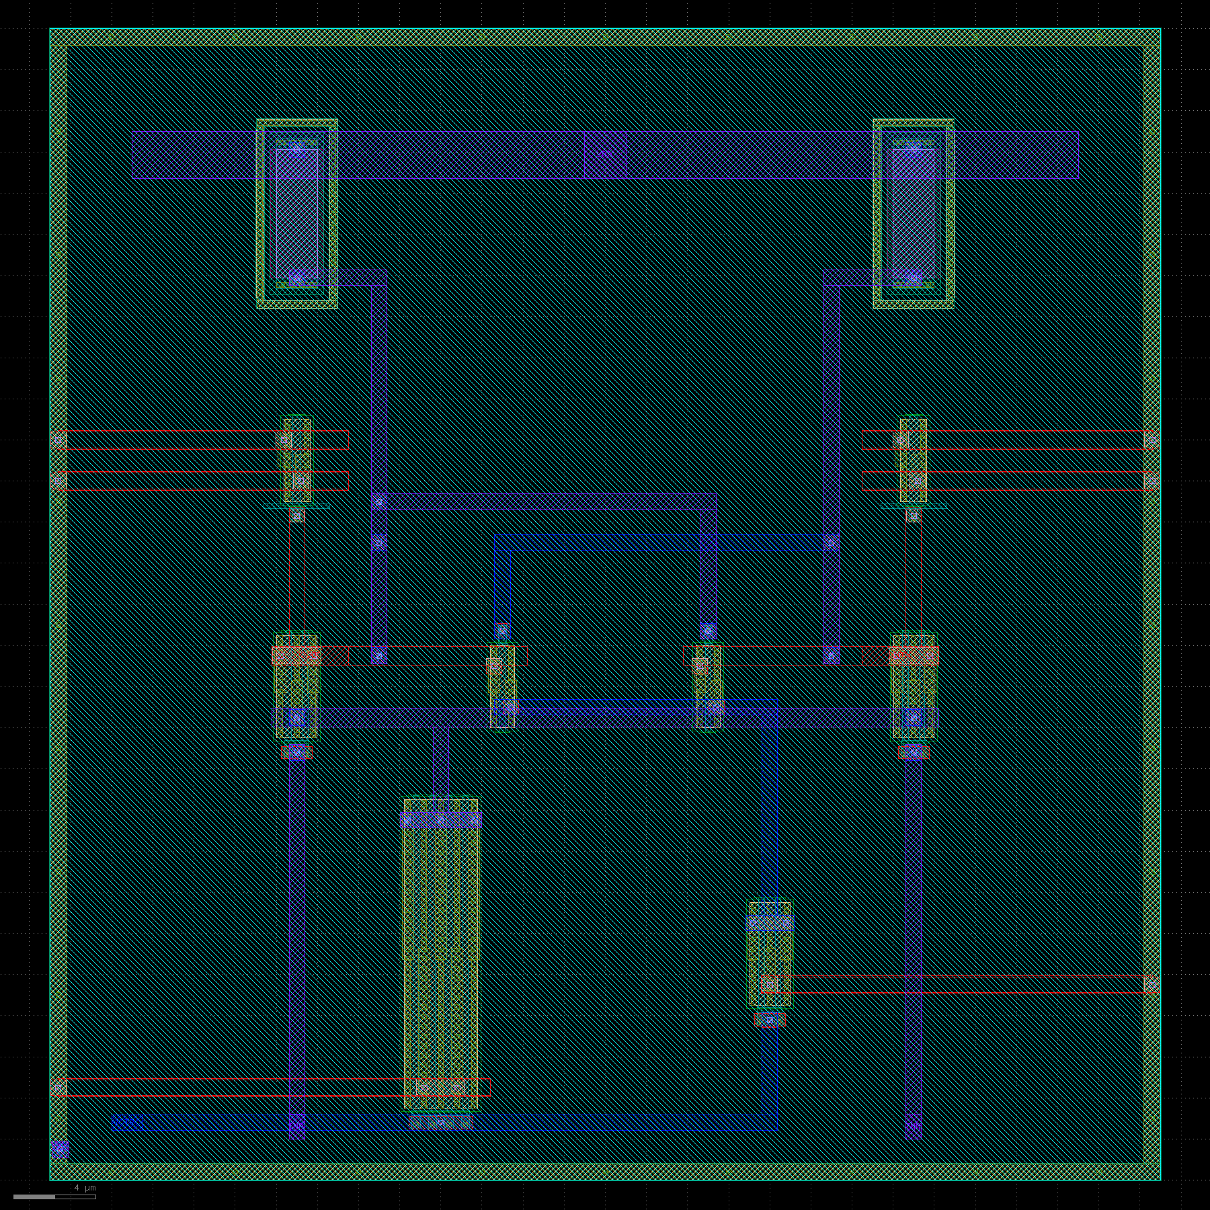
ip/blocks/analog/wireline_serdes/pll/layout_ss_ff_margin_slow.png
