deepai-org/svalbard/ip/blocks/analog/wireline_serdes/pll/layout_startup_assist.png

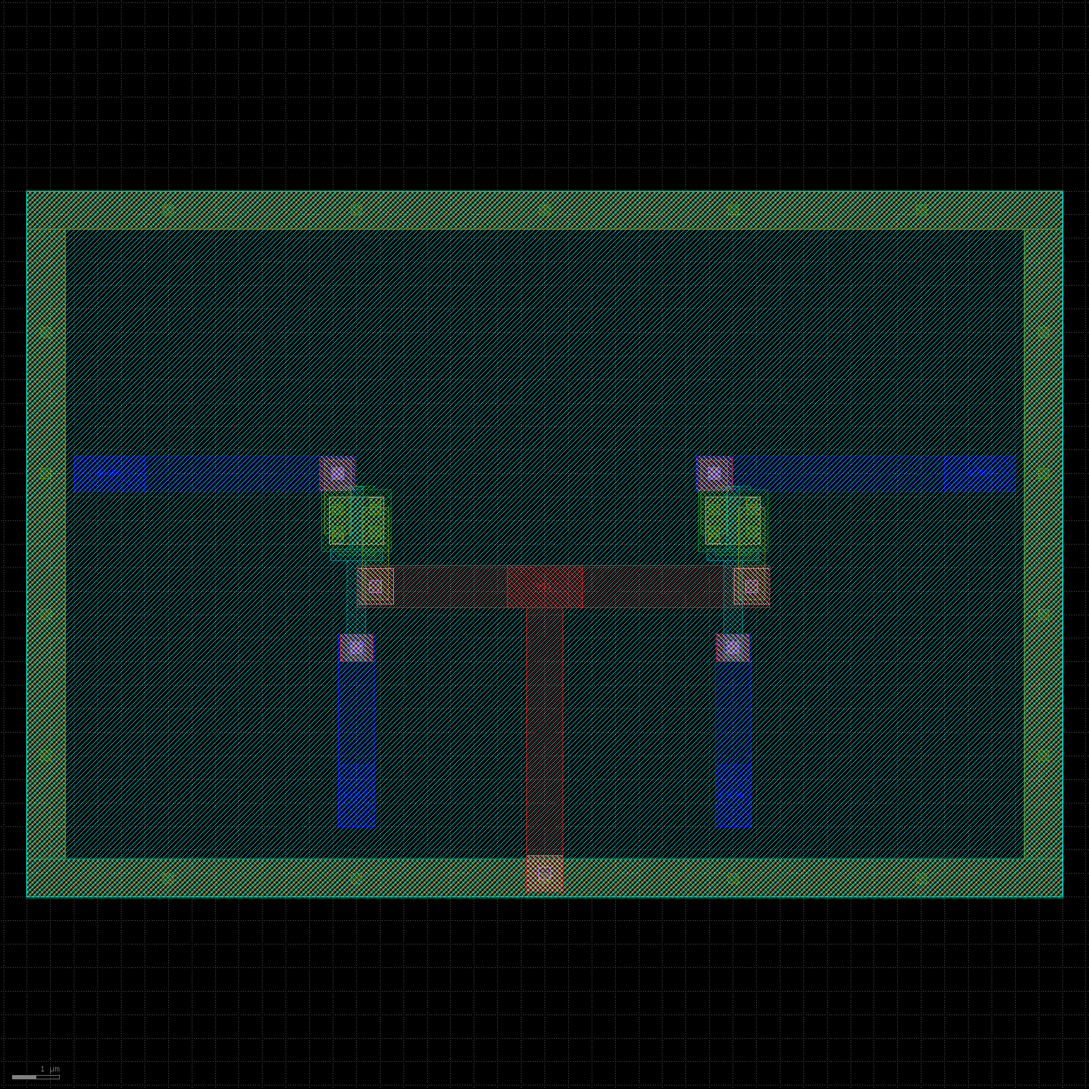
ip/blocks/analog/wireline_serdes/pll/layout_startup_assist.png
