deepai-org/svalbard/ip/blocks/analog/wireline_serdes/pll/layout_vco_band.png

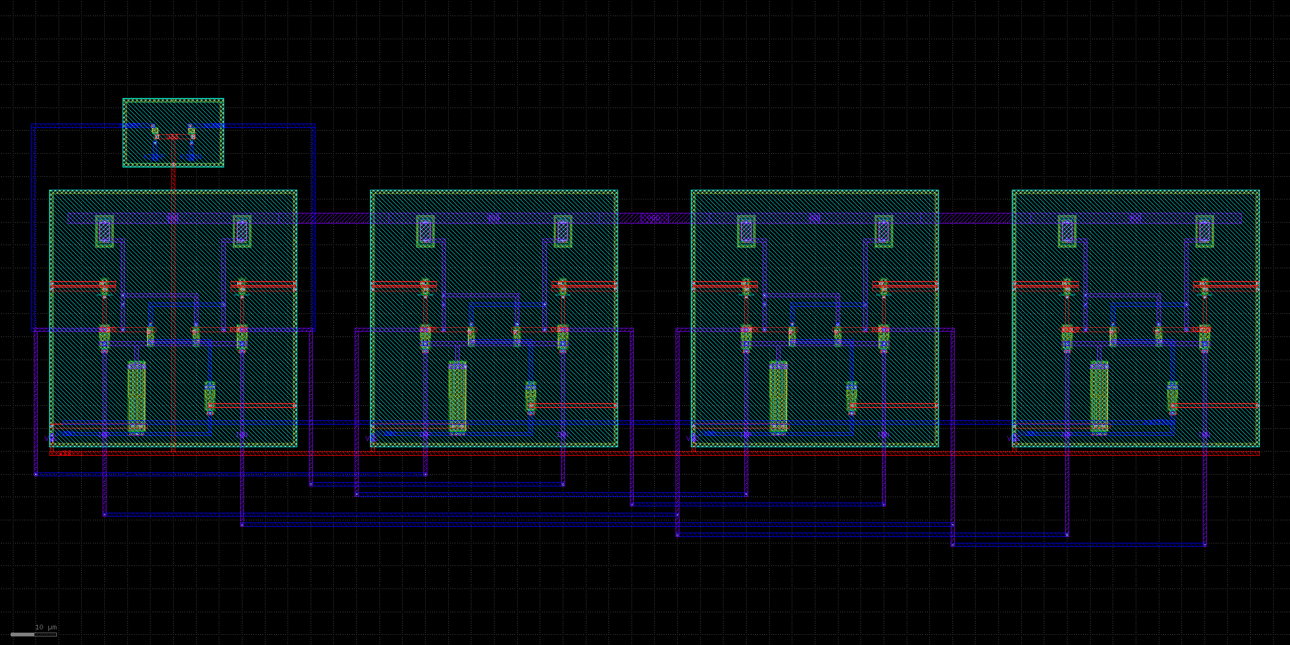
ip/blocks/analog/wireline_serdes/pll/layout_vco_band.png
