deepai-org/svalbard/ip/blocks/analog/wireline_serdes/pll/layout_vco_bank.png

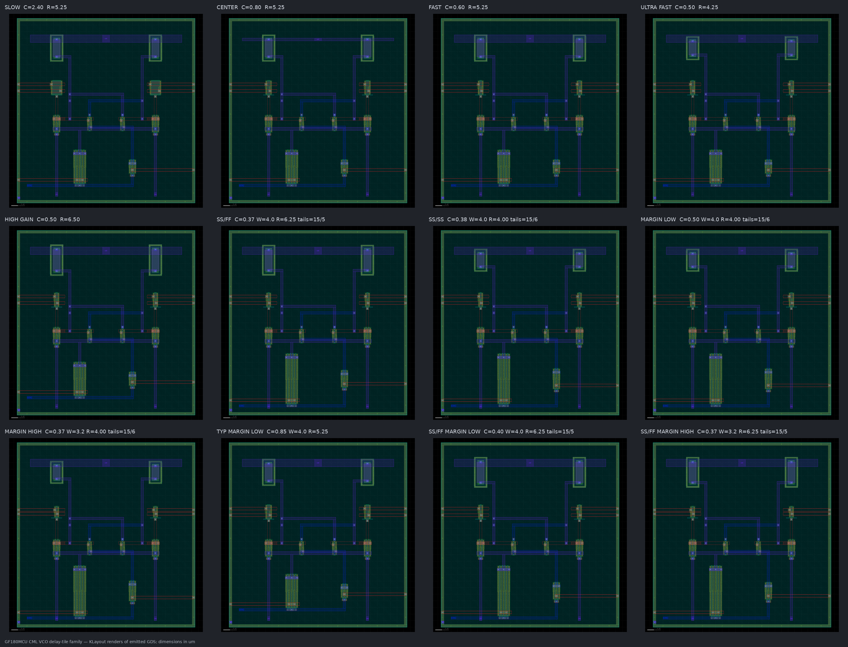
ip/blocks/analog/wireline_serdes/pll/layout_vco_bank.png
