deepai-org/svalbard/ip/blocks/analog/wireline_serdes/pll/layout_vco_bank_top.png

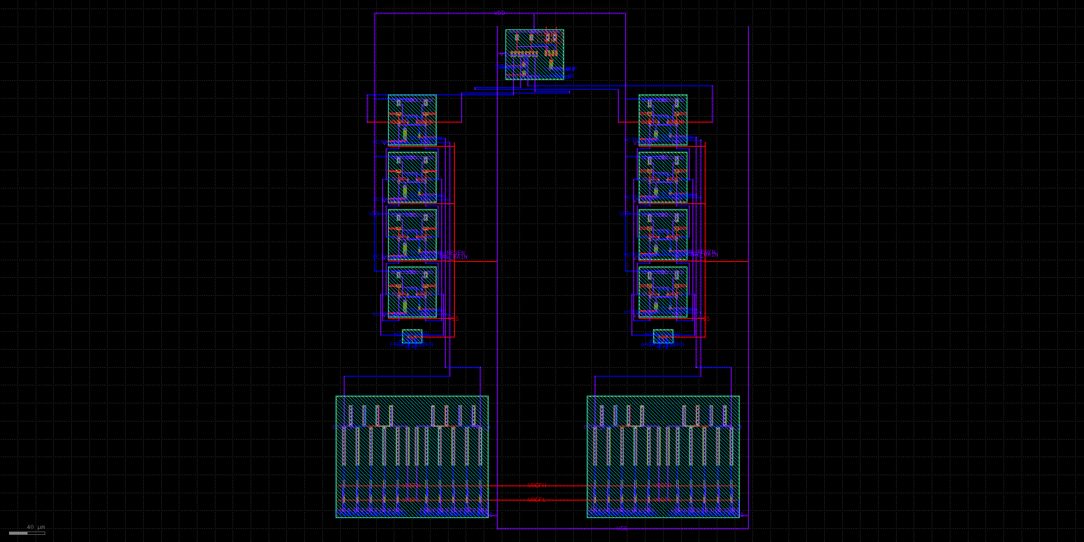
ip/blocks/analog/wireline_serdes/pll/layout_vco_bank_top.png
