deepai-org/svalbard/ip/blocks/analog/wireline_serdes/reference_level_receiver/layout.png

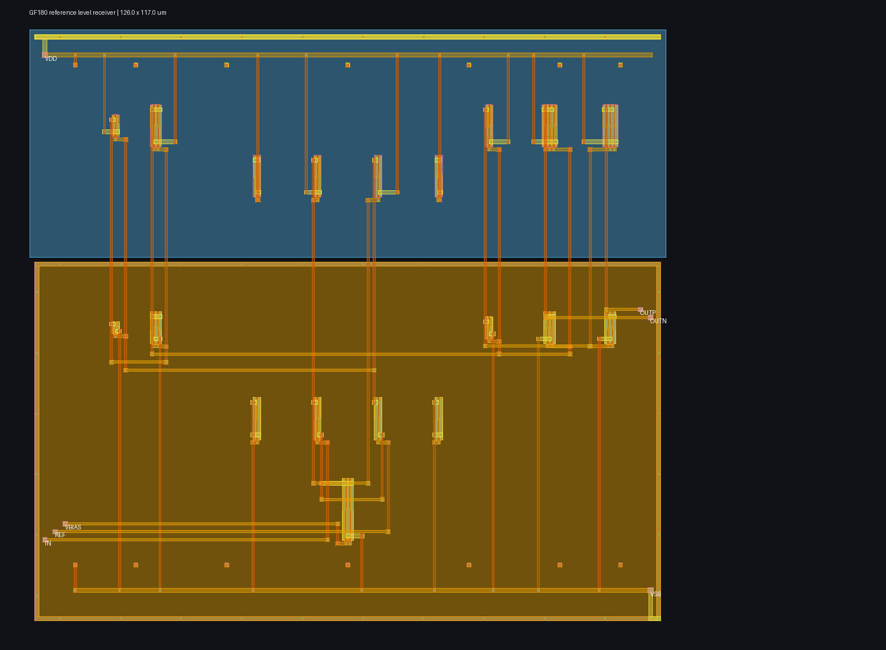
ip/blocks/analog/wireline_serdes/reference_level_receiver/layout.png
