deepai-org/svalbard/ip/blocks/analog/wireline_serdes/serializer/layout.png

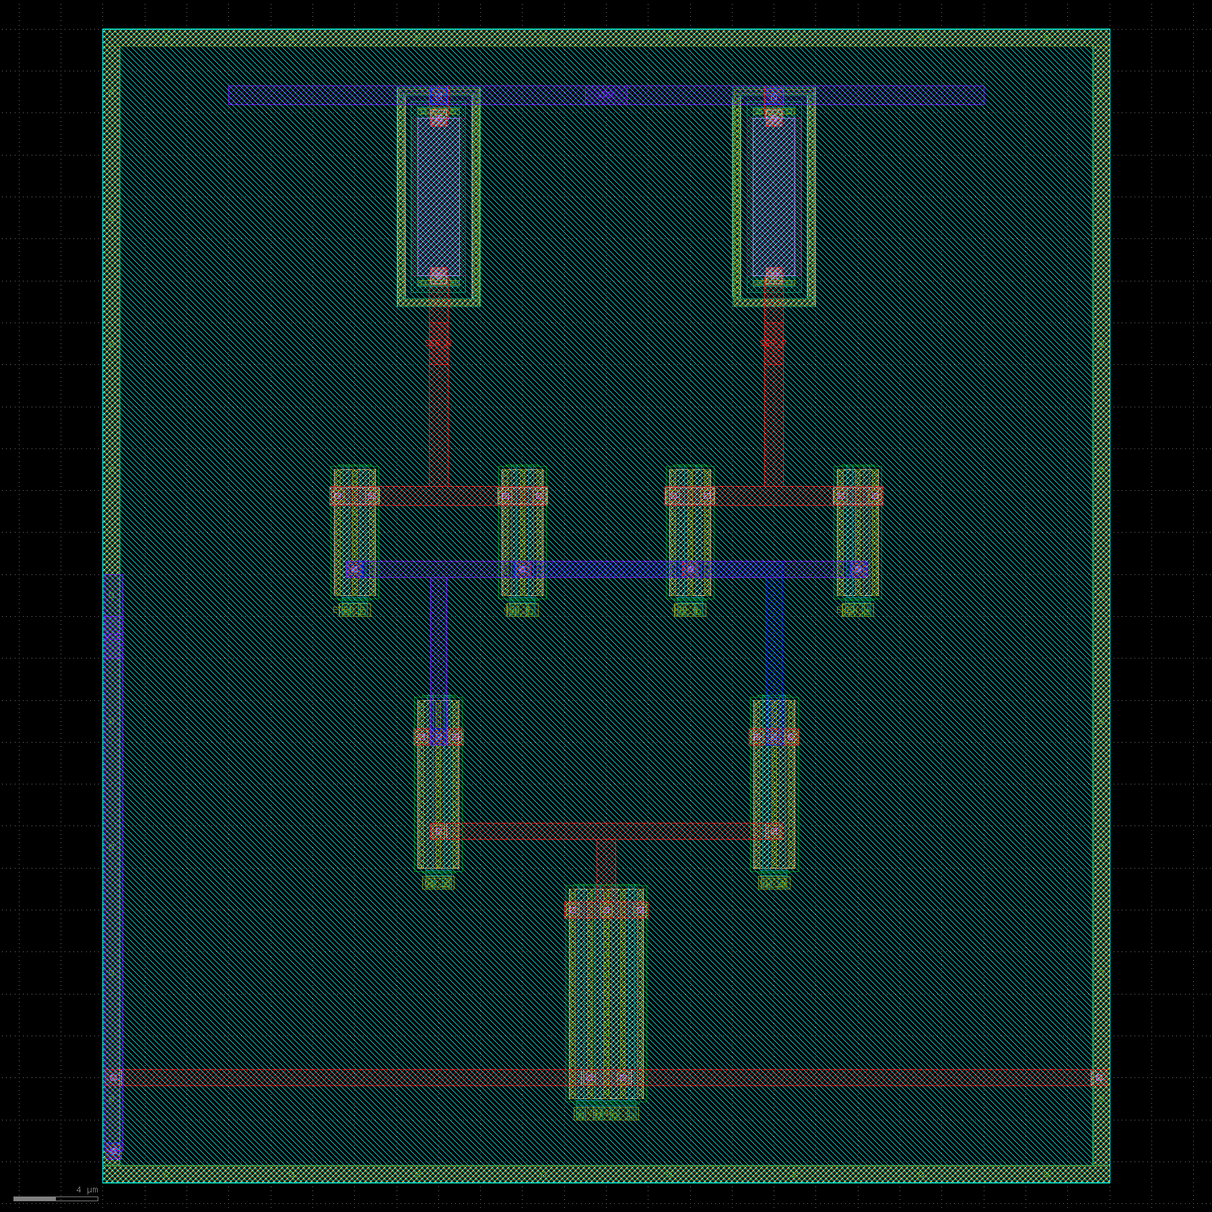
ip/blocks/analog/wireline_serdes/serializer/layout.png
