deepai-org/svalbard/ip/blocks/digital/gf180_nand2_density/layout-comparison.png

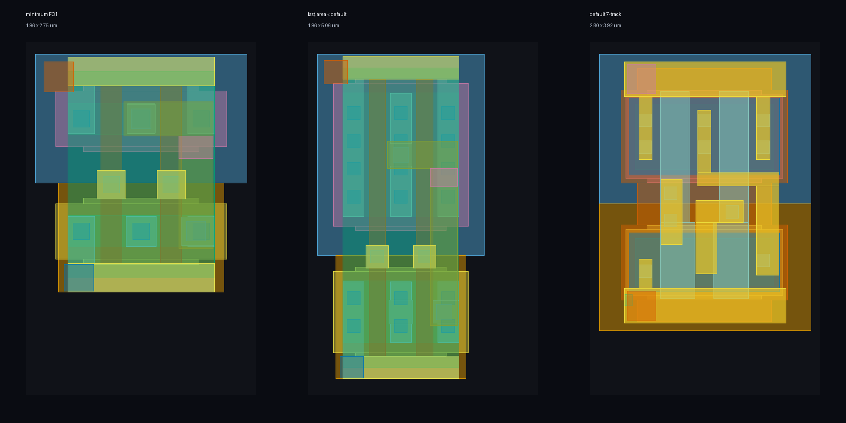
ip/blocks/digital/gf180_nand2_density/layout-comparison.png
