deepai-org/svalbard/projects/programmable_transceiver_platform/analog/pads/generated/protected-rf-pair/pad.png

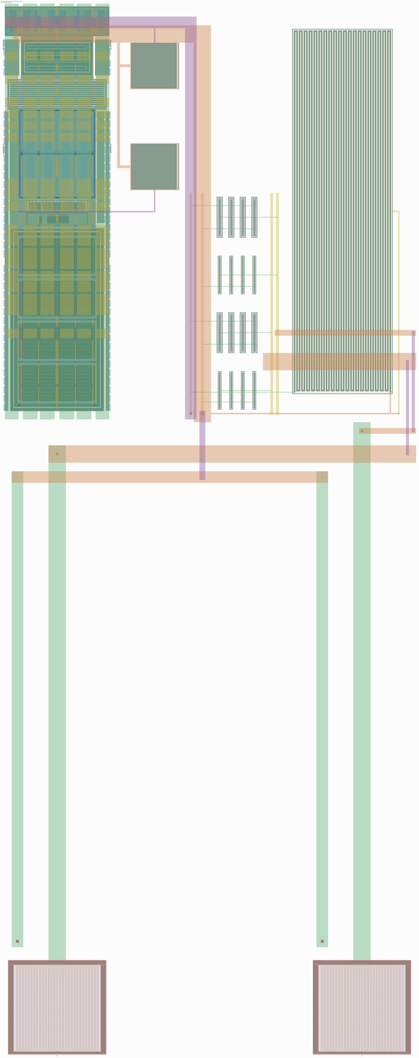
projects/programmable_transceiver_platform/analog/pads/generated/protected-rf-pair/pad.png
