deepai-org/svalbard/projects/programmable_transceiver_platform/analog/pads/generated/protection-array/array.png

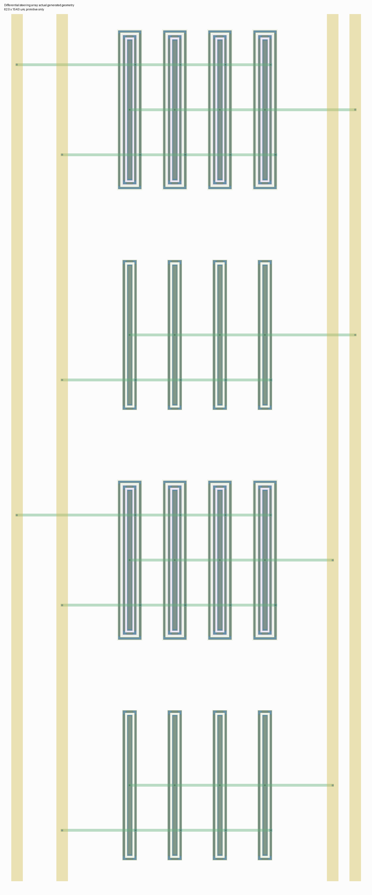
projects/programmable_transceiver_platform/analog/pads/generated/protection-array/array.png
