deepai-org/svalbard/projects/programmable_transceiver_platform/analog/pads/generated/protection-bleed/bleed.png

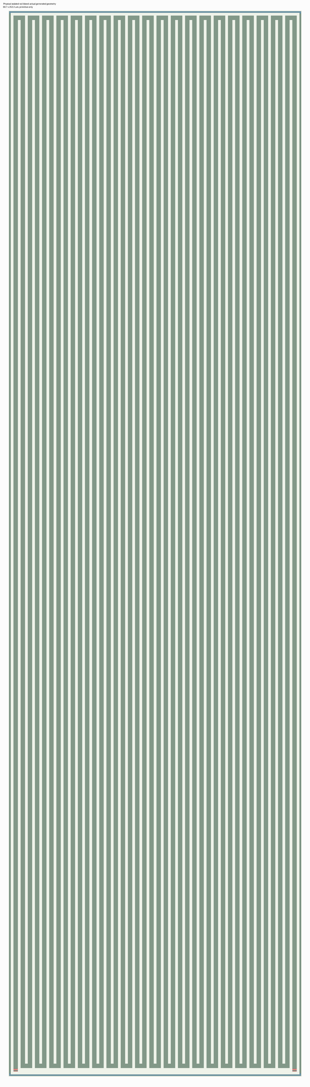
projects/programmable_transceiver_platform/analog/pads/generated/protection-bleed/bleed.png
