deepai-org/svalbard/projects/programmable_transceiver_platform/analog/pads/generated/protection-clamp/clamp.png

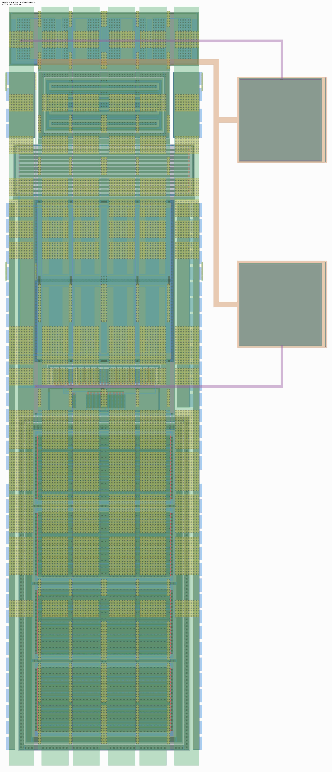
projects/programmable_transceiver_platform/analog/pads/generated/protection-clamp/clamp.png
