deepai-org/svalbard/projects/programmable_transceiver_platform/analog/pads/generated/protection-network/network.png

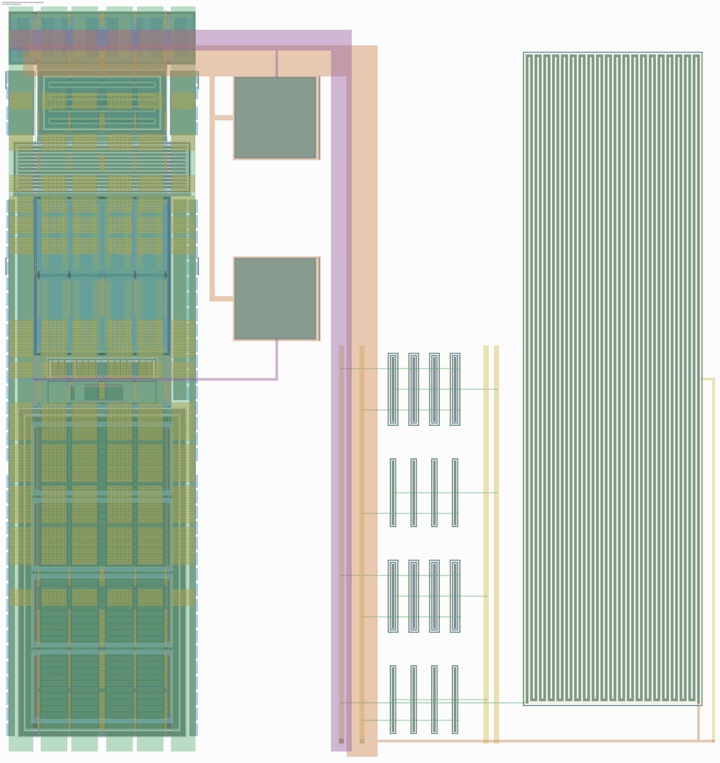
projects/programmable_transceiver_platform/analog/pads/generated/protection-network/network.png
