deepai-org/svalbard/projects/programmable_transceiver_platform/analog/pads/generated/protection-primitives/diode_pd2nw_06v0.png

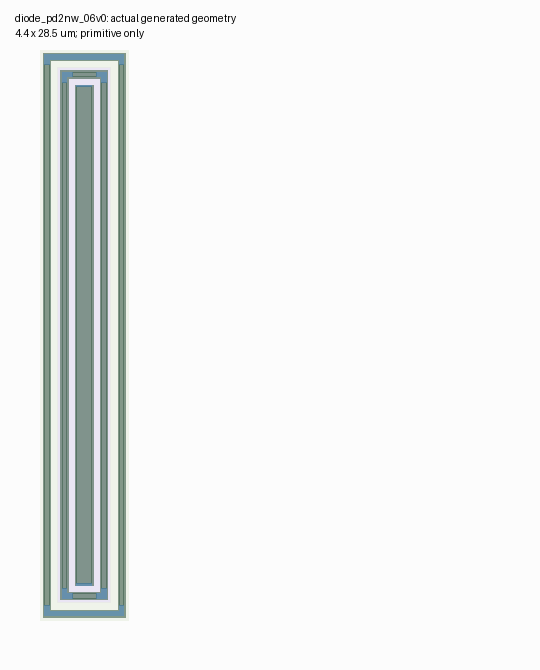
projects/programmable_transceiver_platform/analog/pads/generated/protection-primitives/diode_pd2nw_06v0.png
