deepai-org/svalbard/projects/programmable_transceiver_platform/analog/pads/generated/provider-reference-ring.png

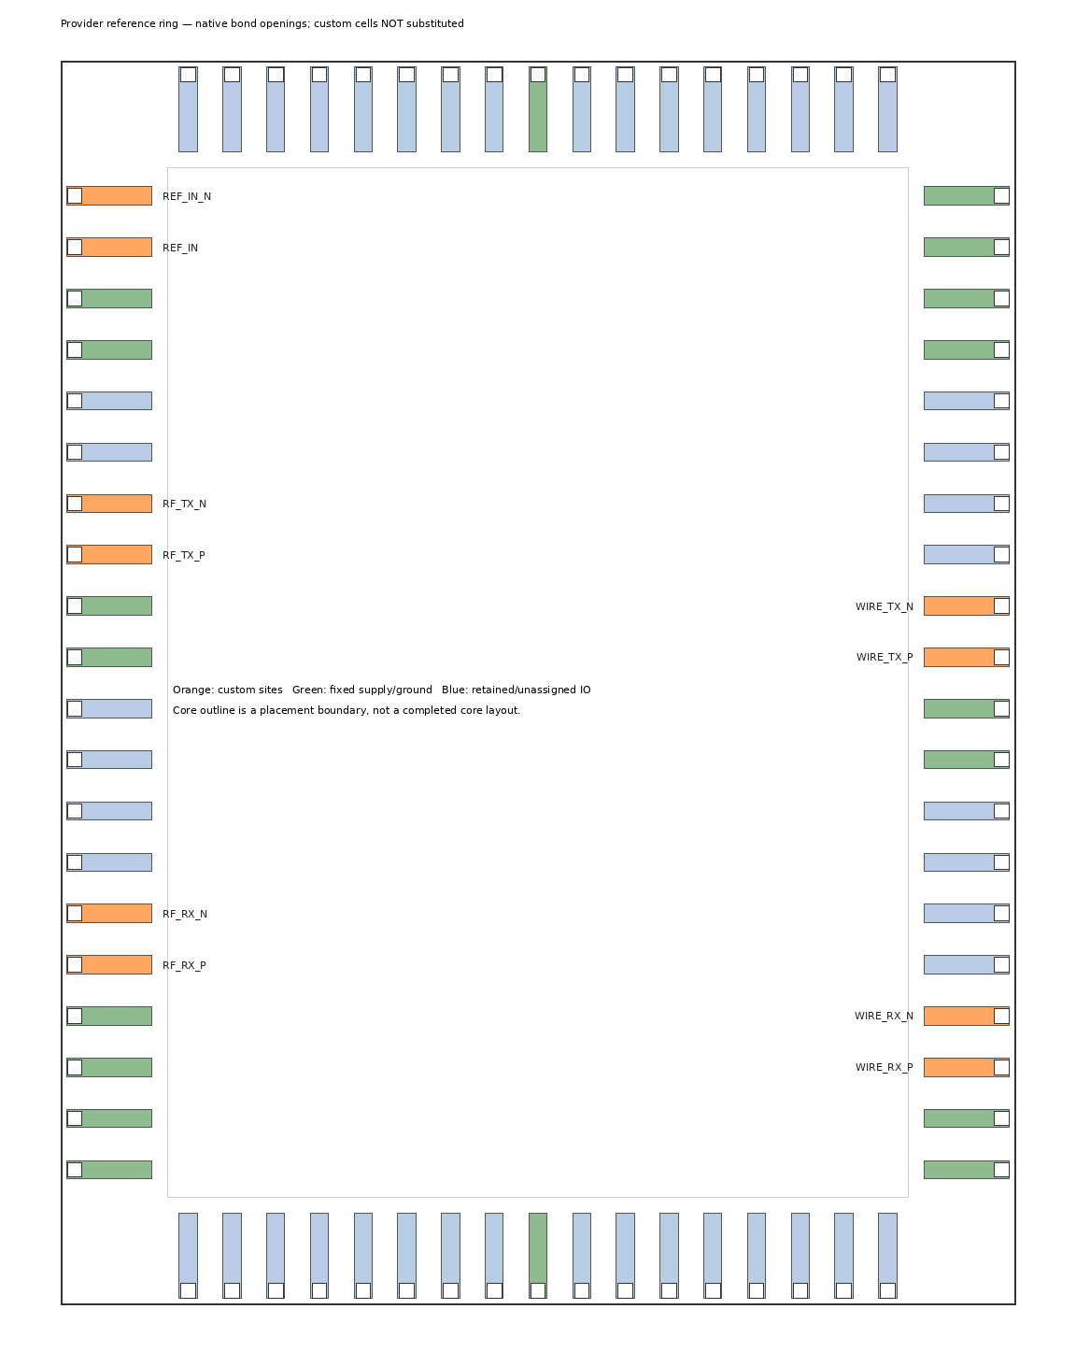
projects/programmable_transceiver_platform/analog/pads/generated/provider-reference-ring.png
