deepai-org/svalbard/projects/programmable_transceiver_platform/analog/pads/generated/receive-primary-protection/fs-sizing/layout.png

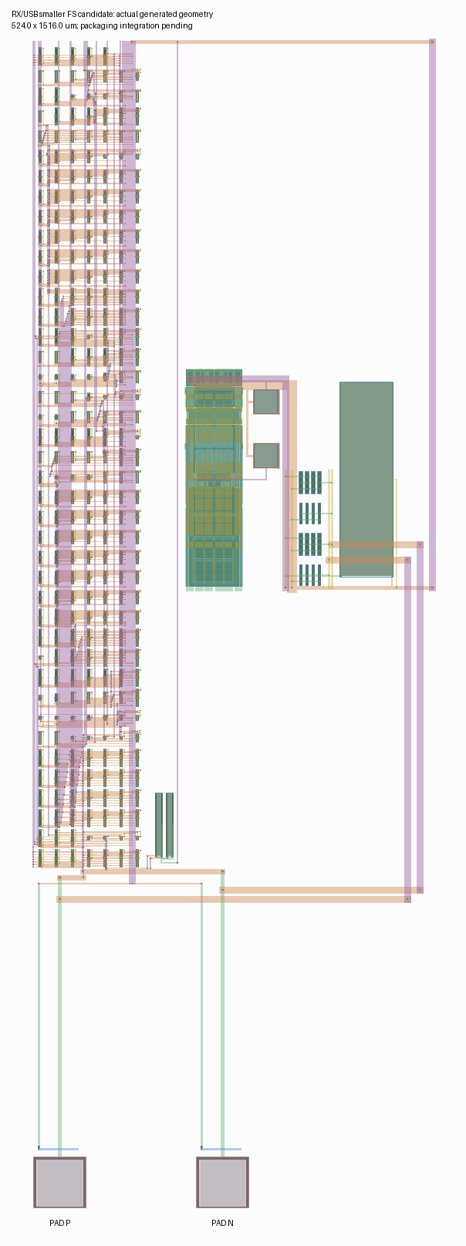
projects/programmable_transceiver_platform/analog/pads/generated/receive-primary-protection/fs-sizing/layout.png
