deepai-org/svalbard/projects/programmable_transceiver_platform/analog/pads/generated/receiver-core-discharge/layout.png

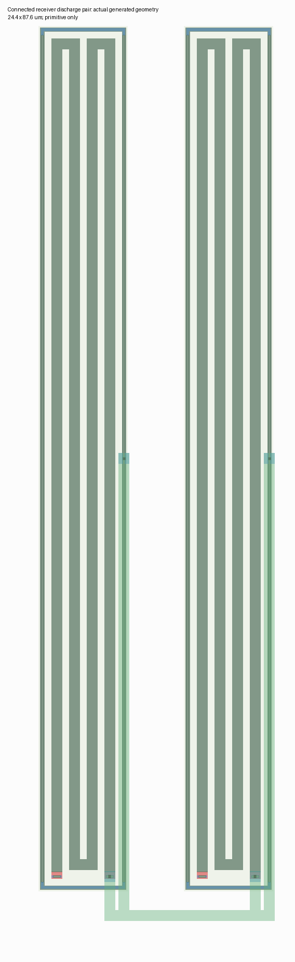
projects/programmable_transceiver_platform/analog/pads/generated/receiver-core-discharge/layout.png
