deepai-org/svalbard/projects/programmable_transceiver_platform/analog/pads/generated/reference-clock.png

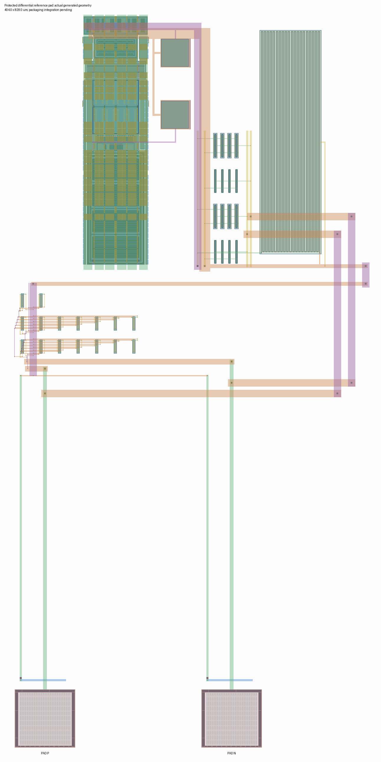
projects/programmable_transceiver_platform/analog/pads/generated/reference-clock.png
