deepai-org/svalbard/projects/programmable_transceiver_platform/analog/pads/generated/steering-buffer/layout.png

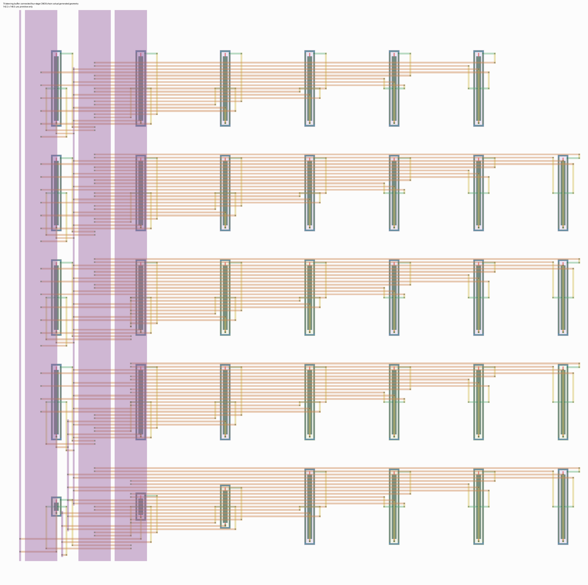
projects/programmable_transceiver_platform/analog/pads/generated/steering-buffer/layout.png
