deepai-org/svalbard/projects/programmable_transceiver_platform/analog/pads/generated/termination-buffer-candidate/compensated/layout.png

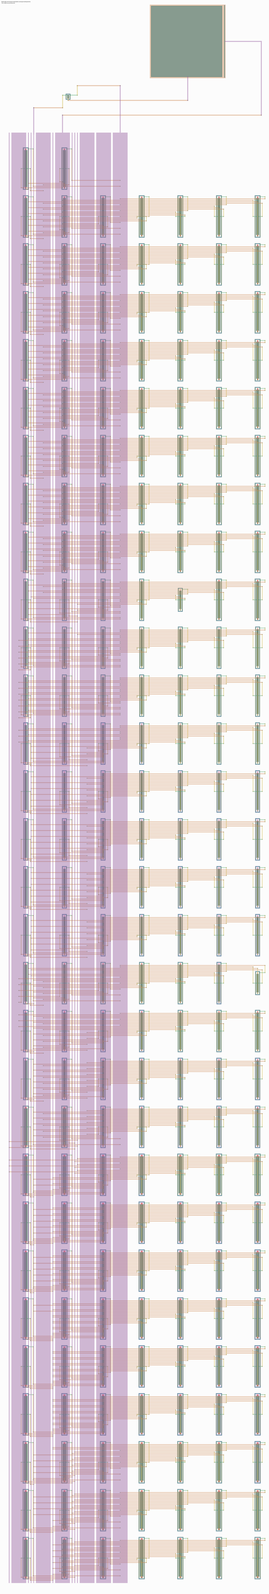
projects/programmable_transceiver_platform/analog/pads/generated/termination-buffer-candidate/compensated/layout.png
