deepai-org/svalbard/projects/programmable_transceiver_platform/analog/pads/generated/transmit-control-candidate/layout.png

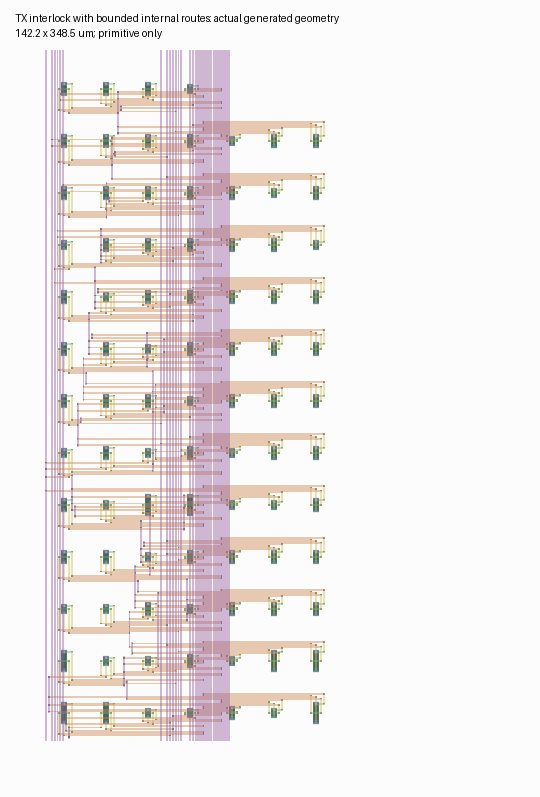
projects/programmable_transceiver_platform/analog/pads/generated/transmit-control-candidate/layout.png
