deepai-org/svalbard/projects/programmable_transceiver_platform/analog/pads/generated/tx-folded-tail/layout.png

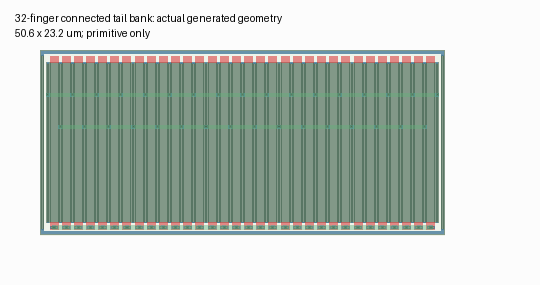
projects/programmable_transceiver_platform/analog/pads/generated/tx-folded-tail/layout.png
