deepai-org/svalbard/projects/programmable_transceiver_platform/analog/pads/generated/wide-route-rf-candidate/pad.png

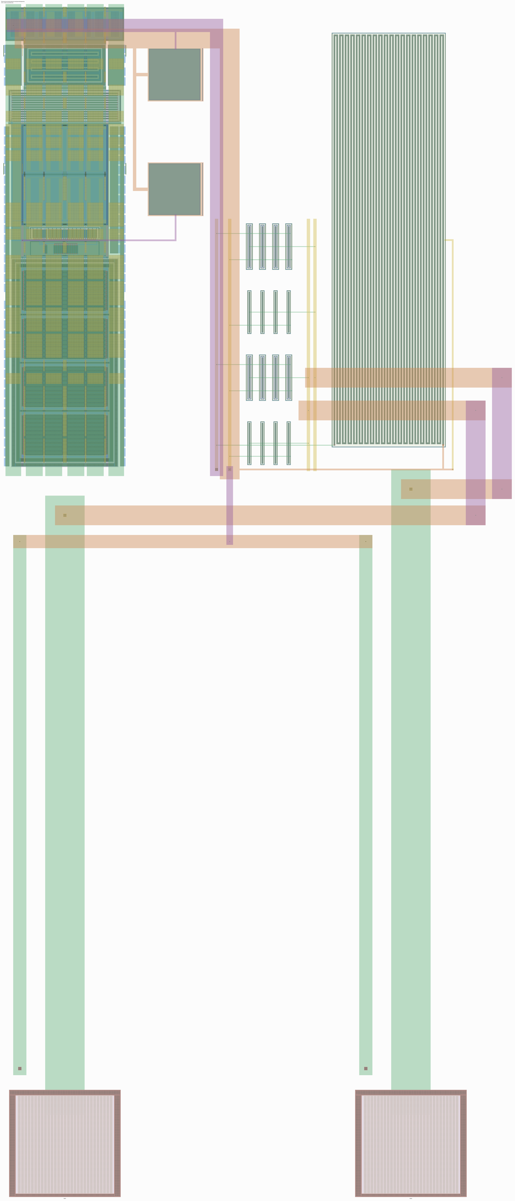
projects/programmable_transceiver_platform/analog/pads/generated/wide-route-rf-candidate/pad.png
