deepai-org/svalbard/projects/programmable_transceiver_platform/analog/pads/generated/wired-primary-protection/layout.png

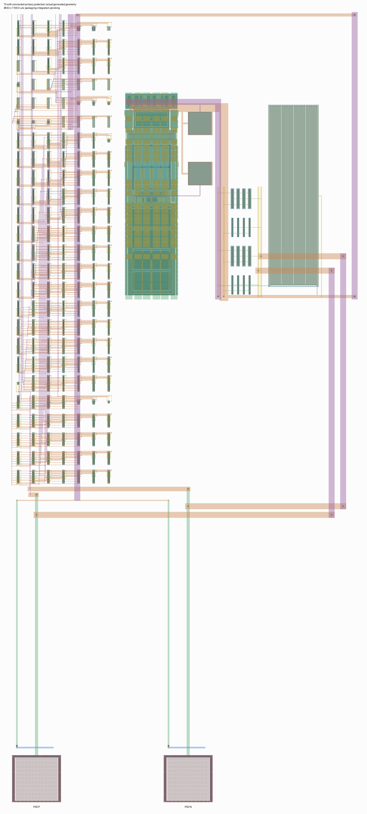
projects/programmable_transceiver_platform/analog/pads/generated/wired-primary-protection/layout.png
