deepai-org/svalbard/projects/programmable_transceiver_platform/docs/diagrams/transceiver-block-diagram.png

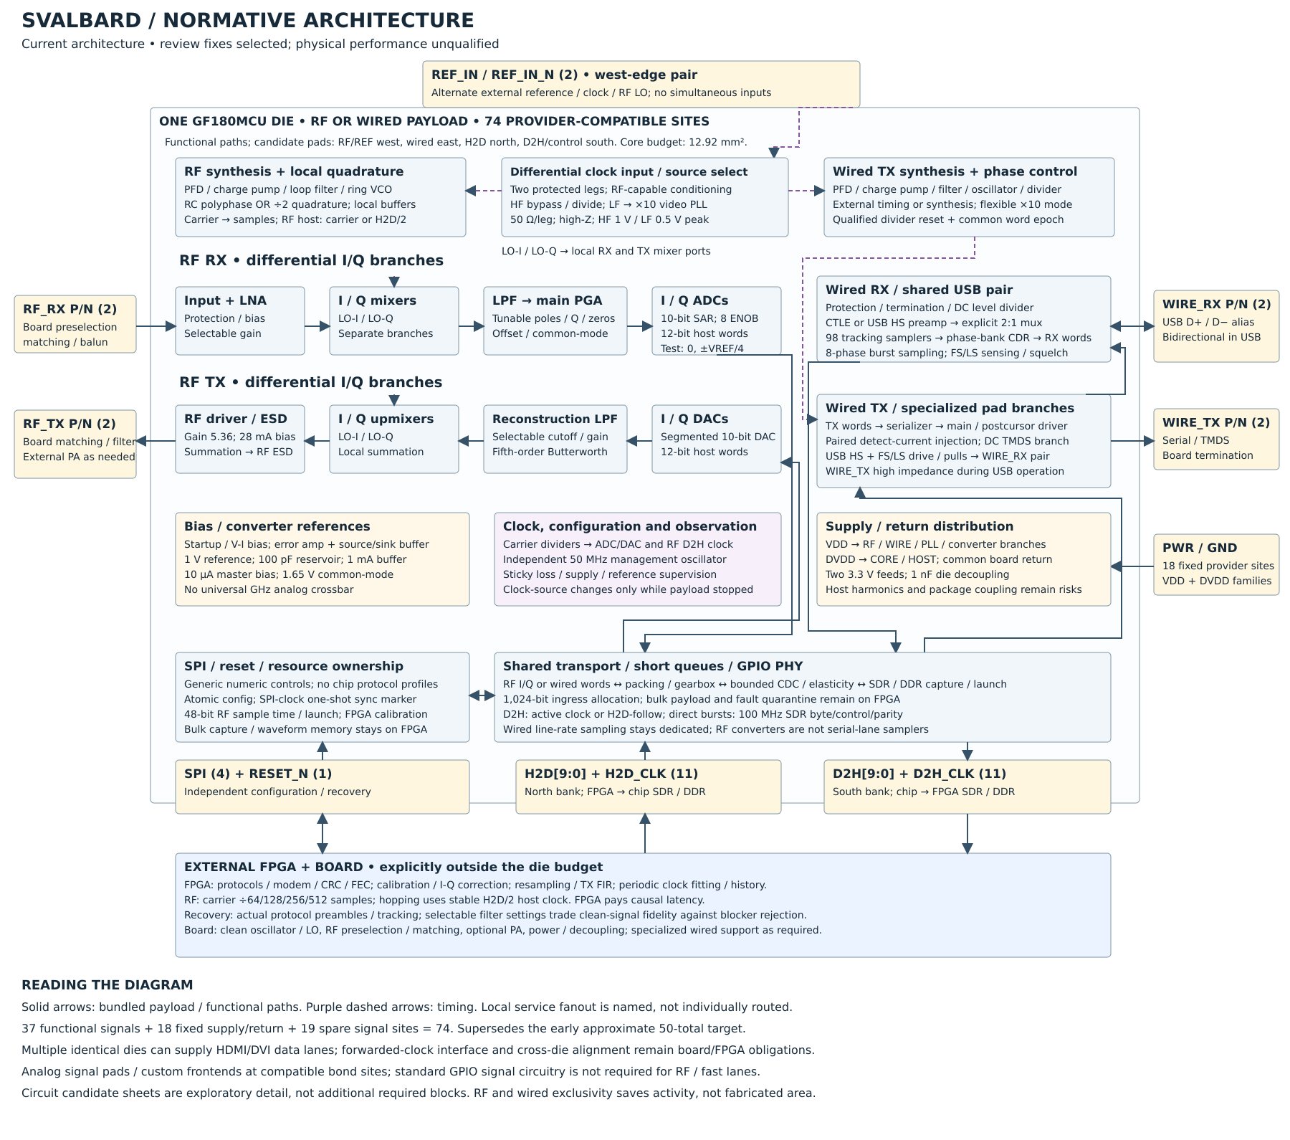
projects/programmable_transceiver_platform/docs/diagrams/transceiver-block-diagram.png
