deepai-org/svalbard/projects/programmable_transceiver_platform/docs/diagrams/transceiver-rf-loaded-detail.png

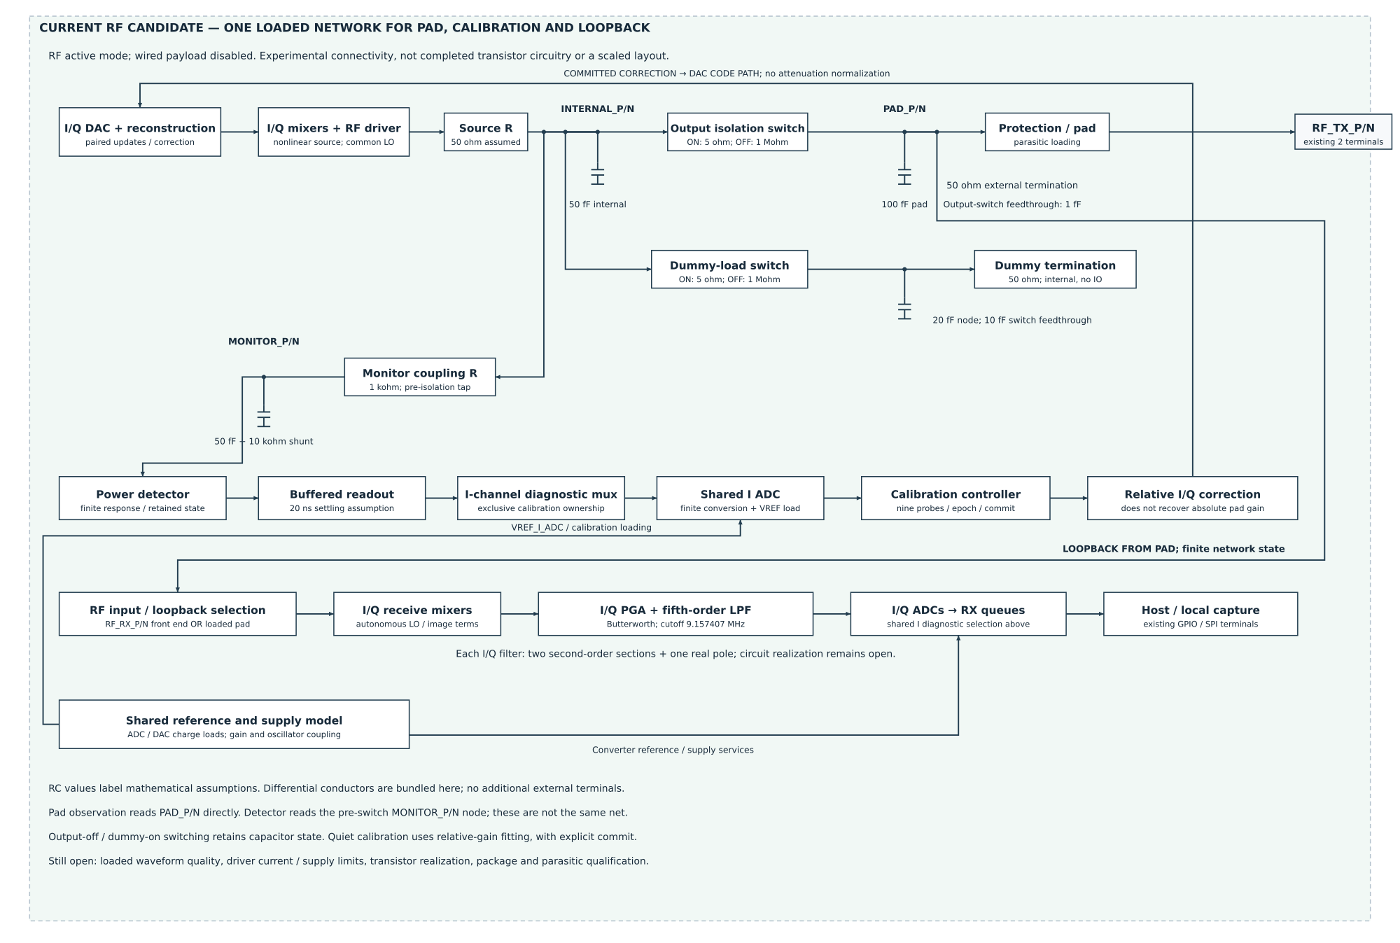
projects/programmable_transceiver_platform/docs/diagrams/transceiver-rf-loaded-detail.png
