deepai-org/svalbard/scratch/area-pass-4/run/chip-ap4-s1.png

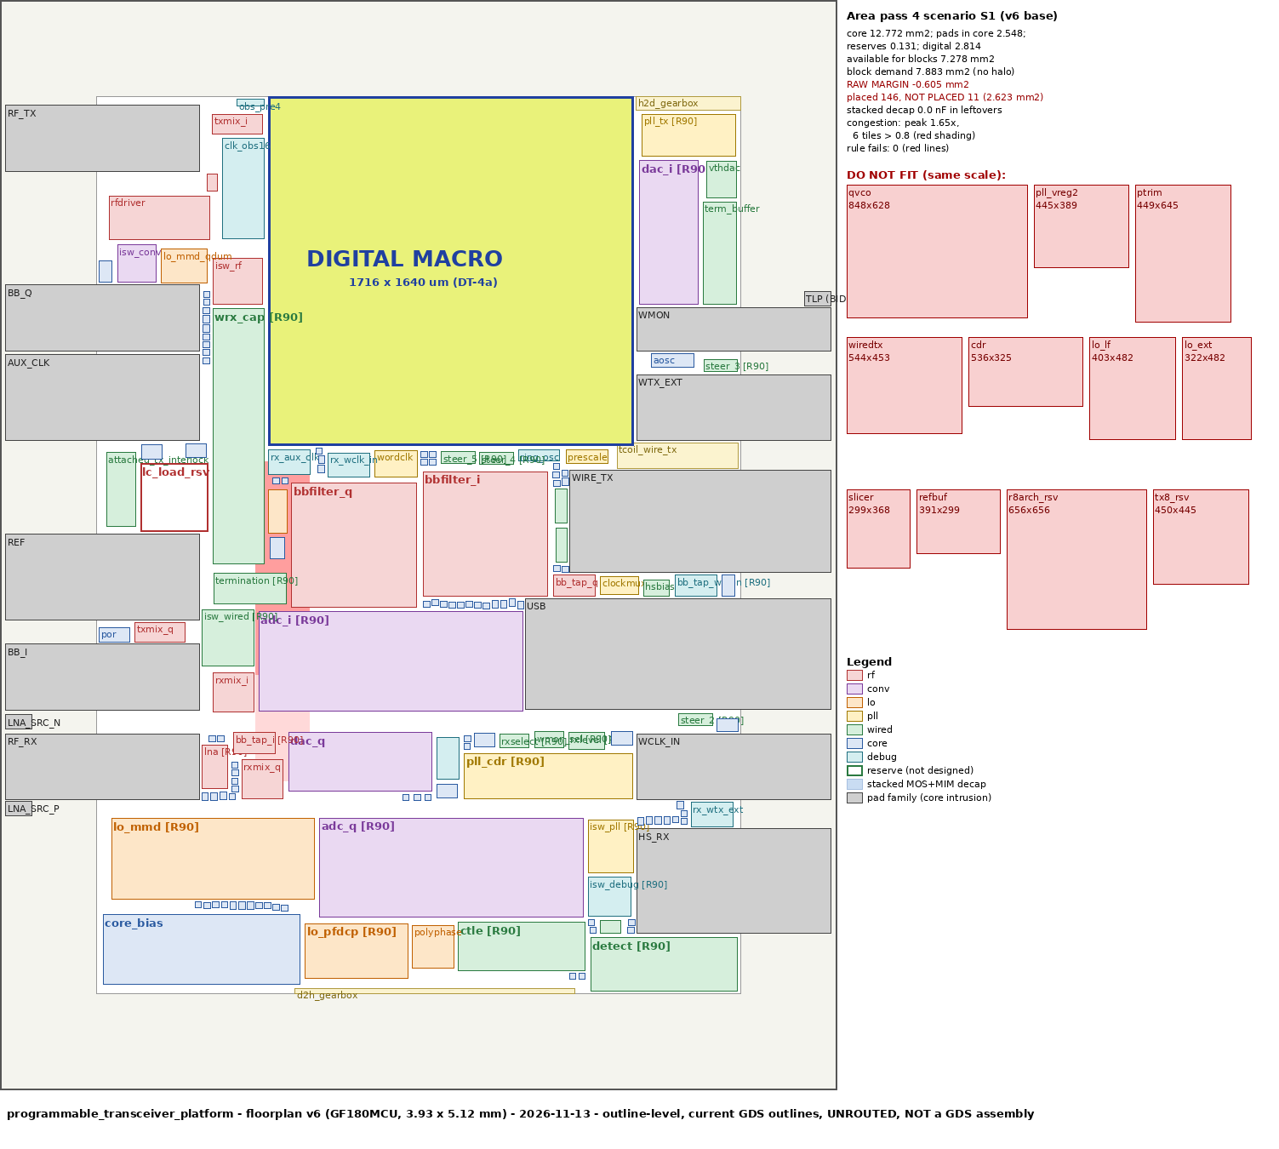
scratch/area-pass-4/run/chip-ap4-s1.png
