deepai-org/svalbard/scratch/area-pass-4/run/chip-ap4-s2.png

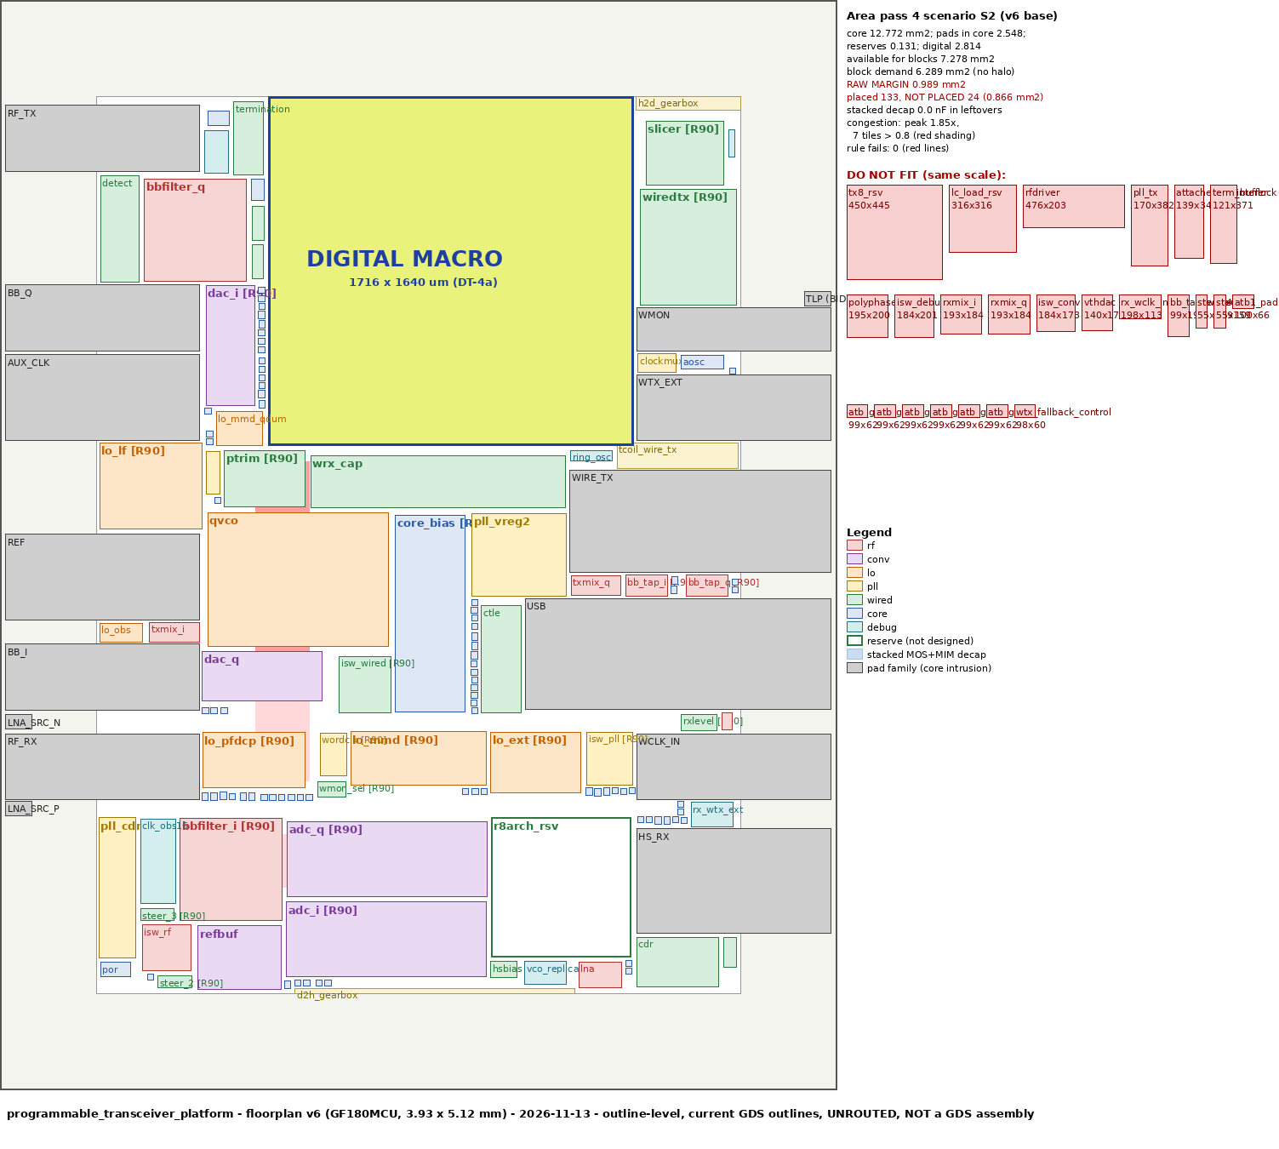
scratch/area-pass-4/run/chip-ap4-s2.png
