deepai-org/svalbard/scratch/reviews/die-fit/run/fit-b-flow.png

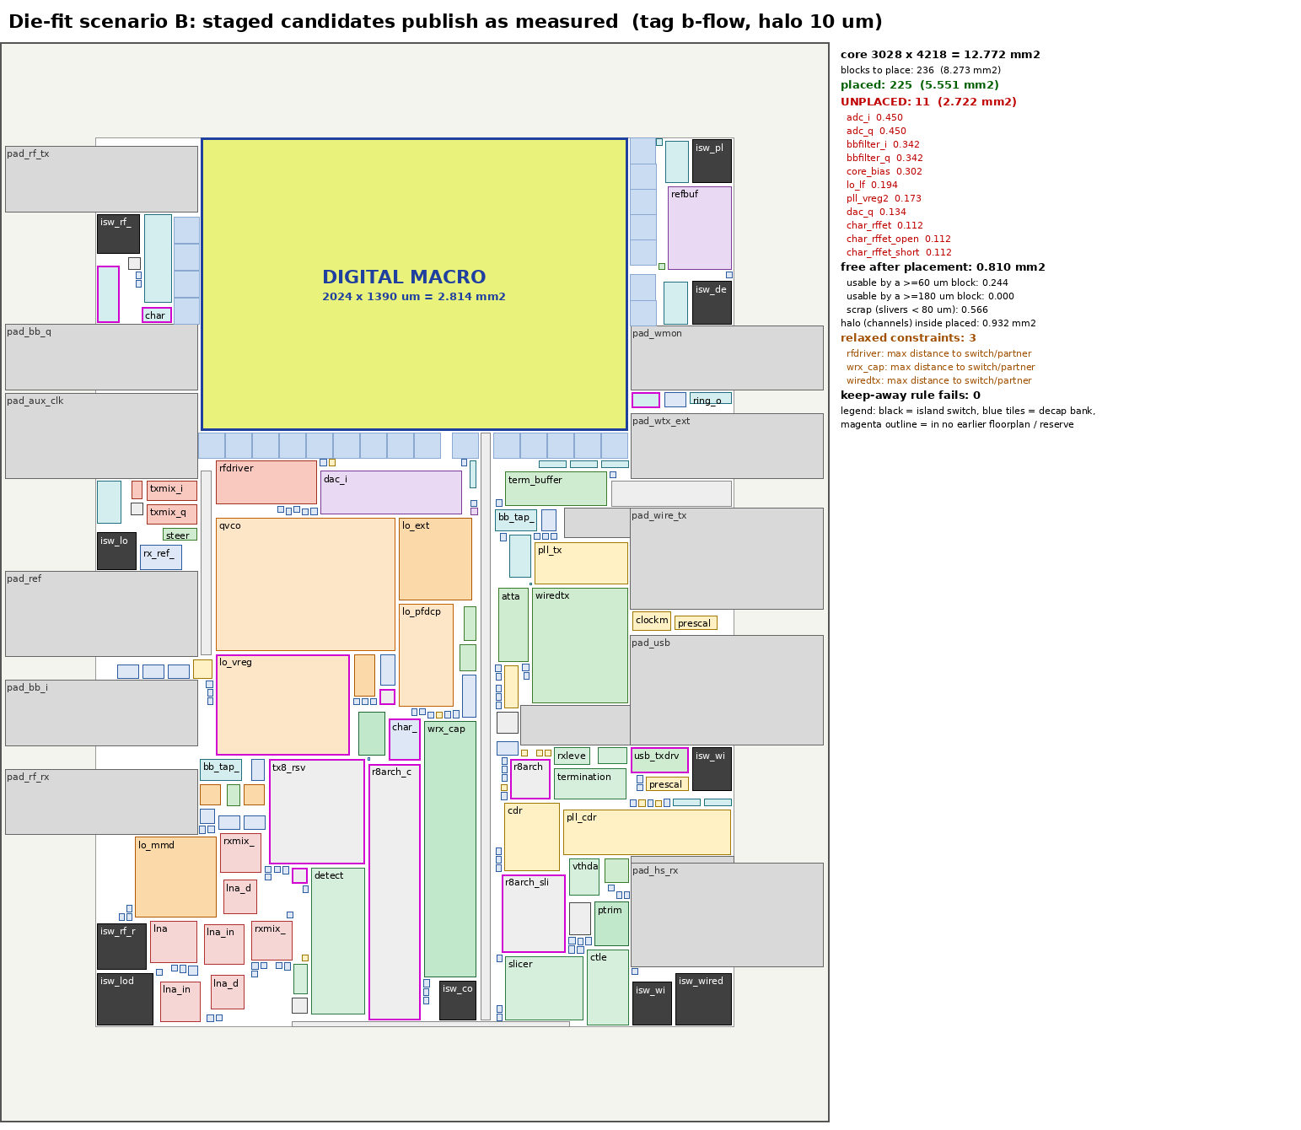
scratch/reviews/die-fit/run/fit-b-flow.png
