deepai-org/svalbard/scratch/reviews/die-fit/run/fit-b-g500.png

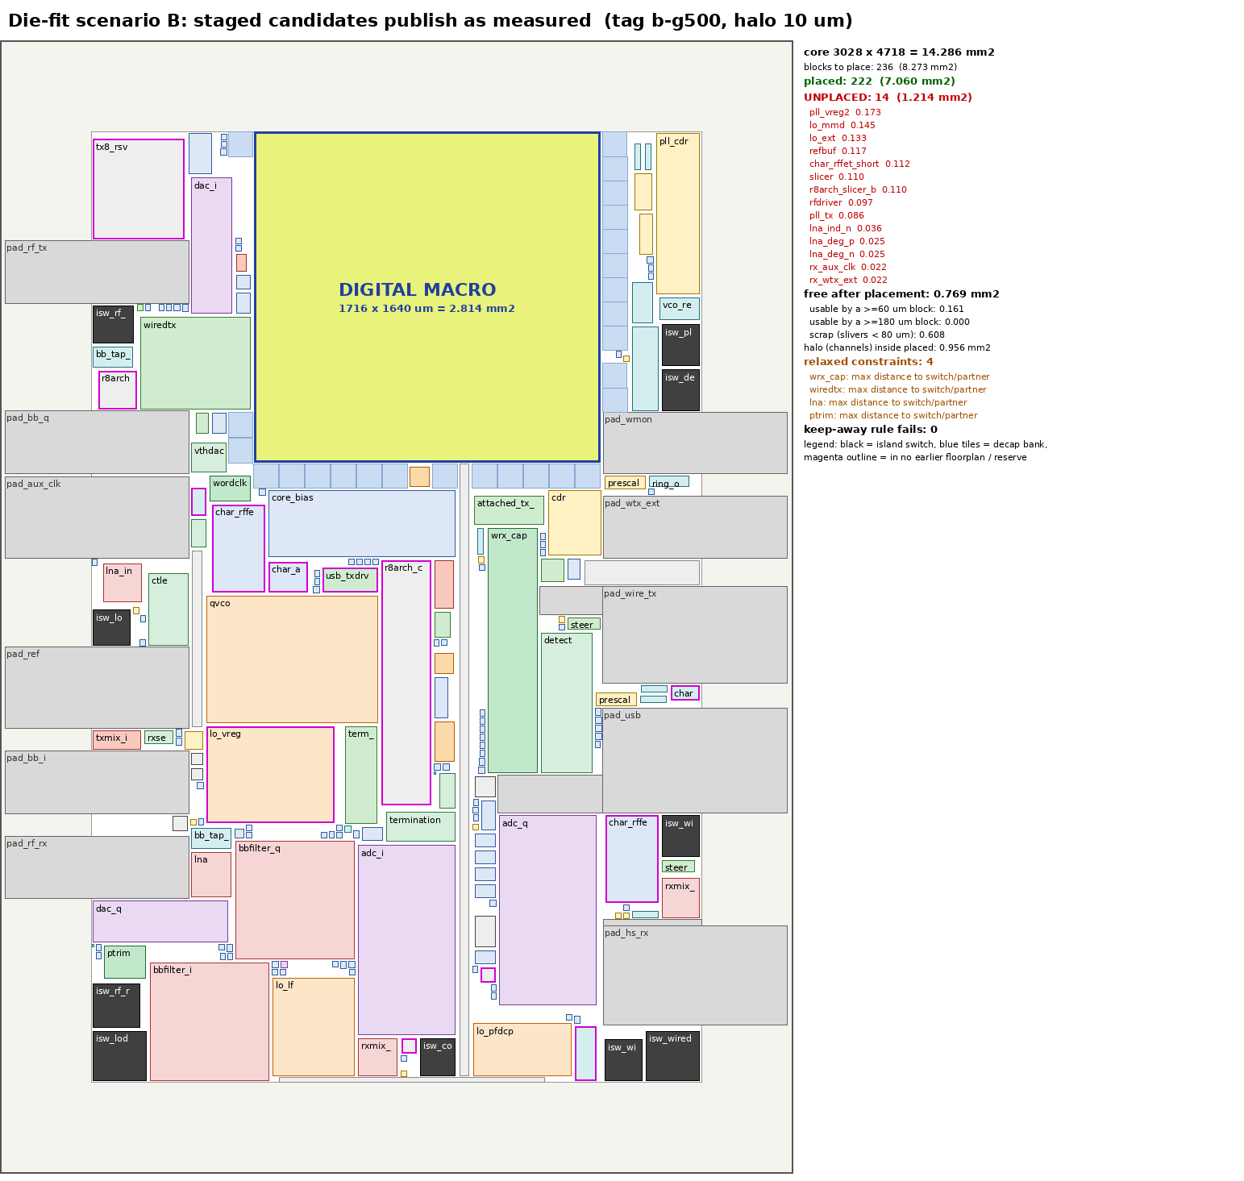
scratch/reviews/die-fit/run/fit-b-g500.png
