deepai-org/svalbard/scratch/reviews/die-fit/run/fit-b-g700.png

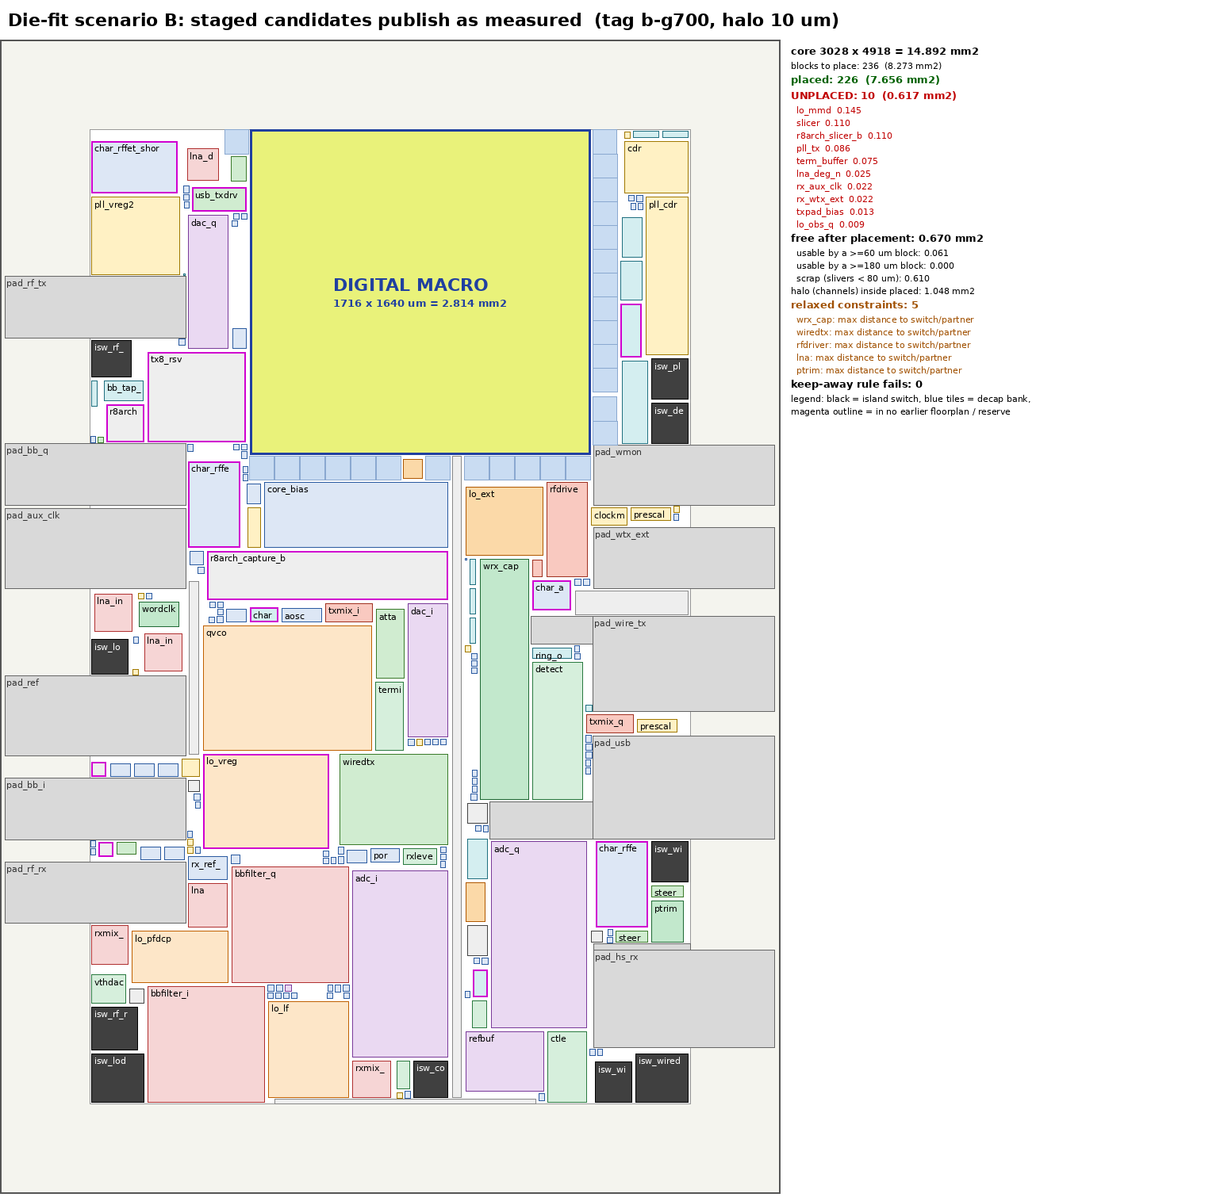
scratch/reviews/die-fit/run/fit-b-g700.png
