deepai-org/svalbard/scratch/reviews/die-fit/run/fit-b-g1100.png

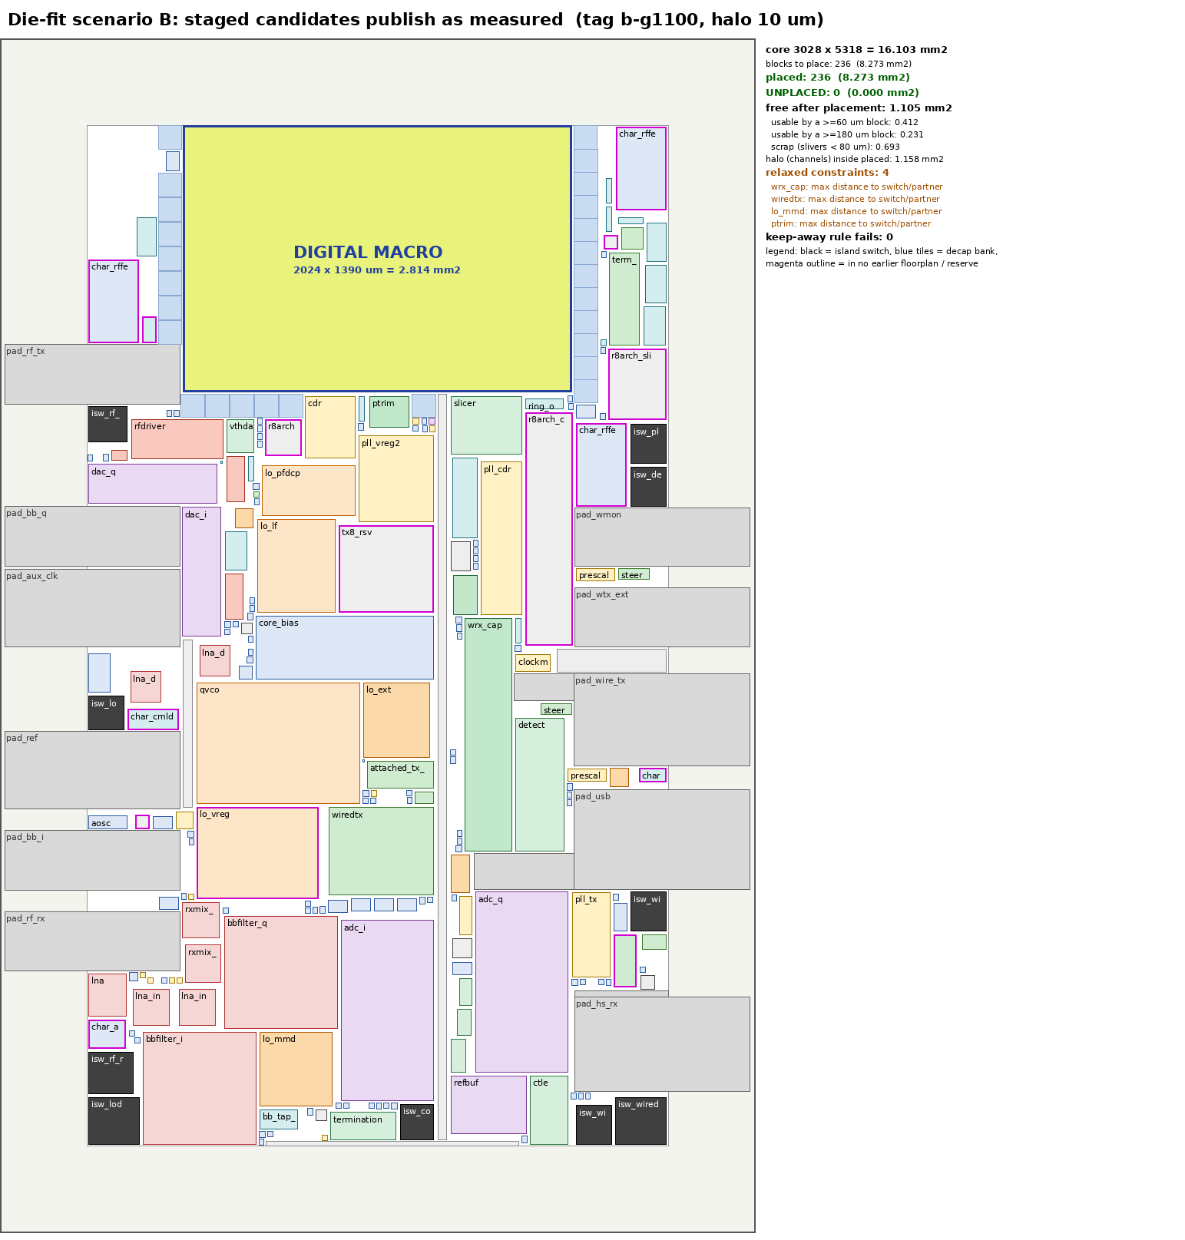
scratch/reviews/die-fit/run/fit-b-g1100.png
