deepai-org/svalbard/scratch/reviews/die-fit/run/fit-b-h5.png

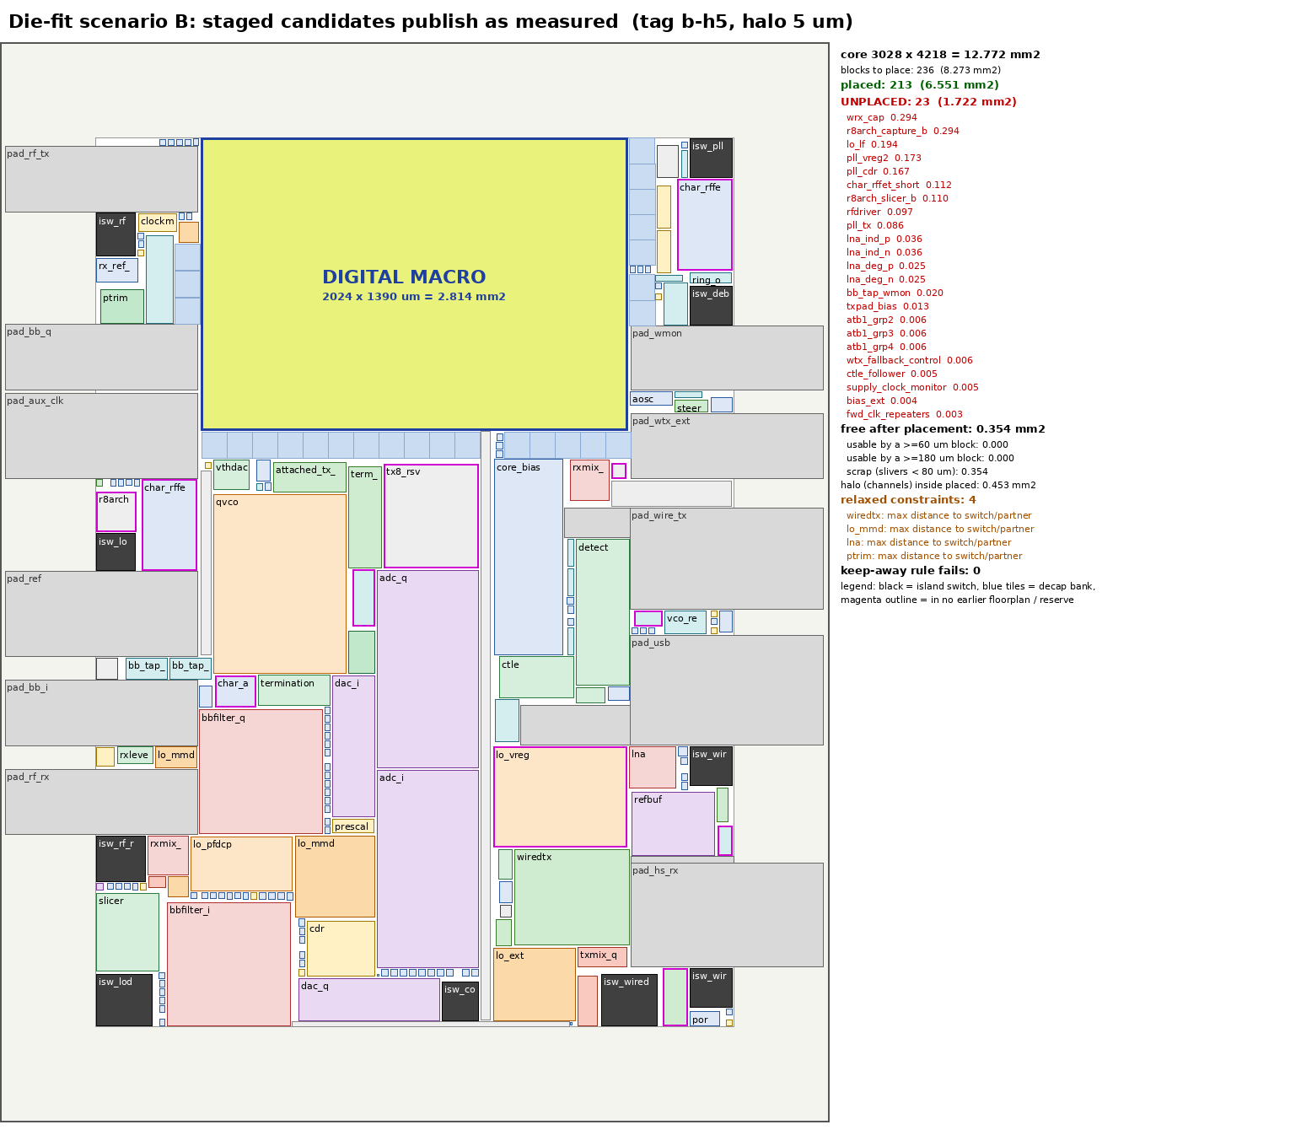
scratch/reviews/die-fit/run/fit-b-h5.png
