deepai-org/svalbard/scratch/reviews/die-fit/run/fit-b-l5.png

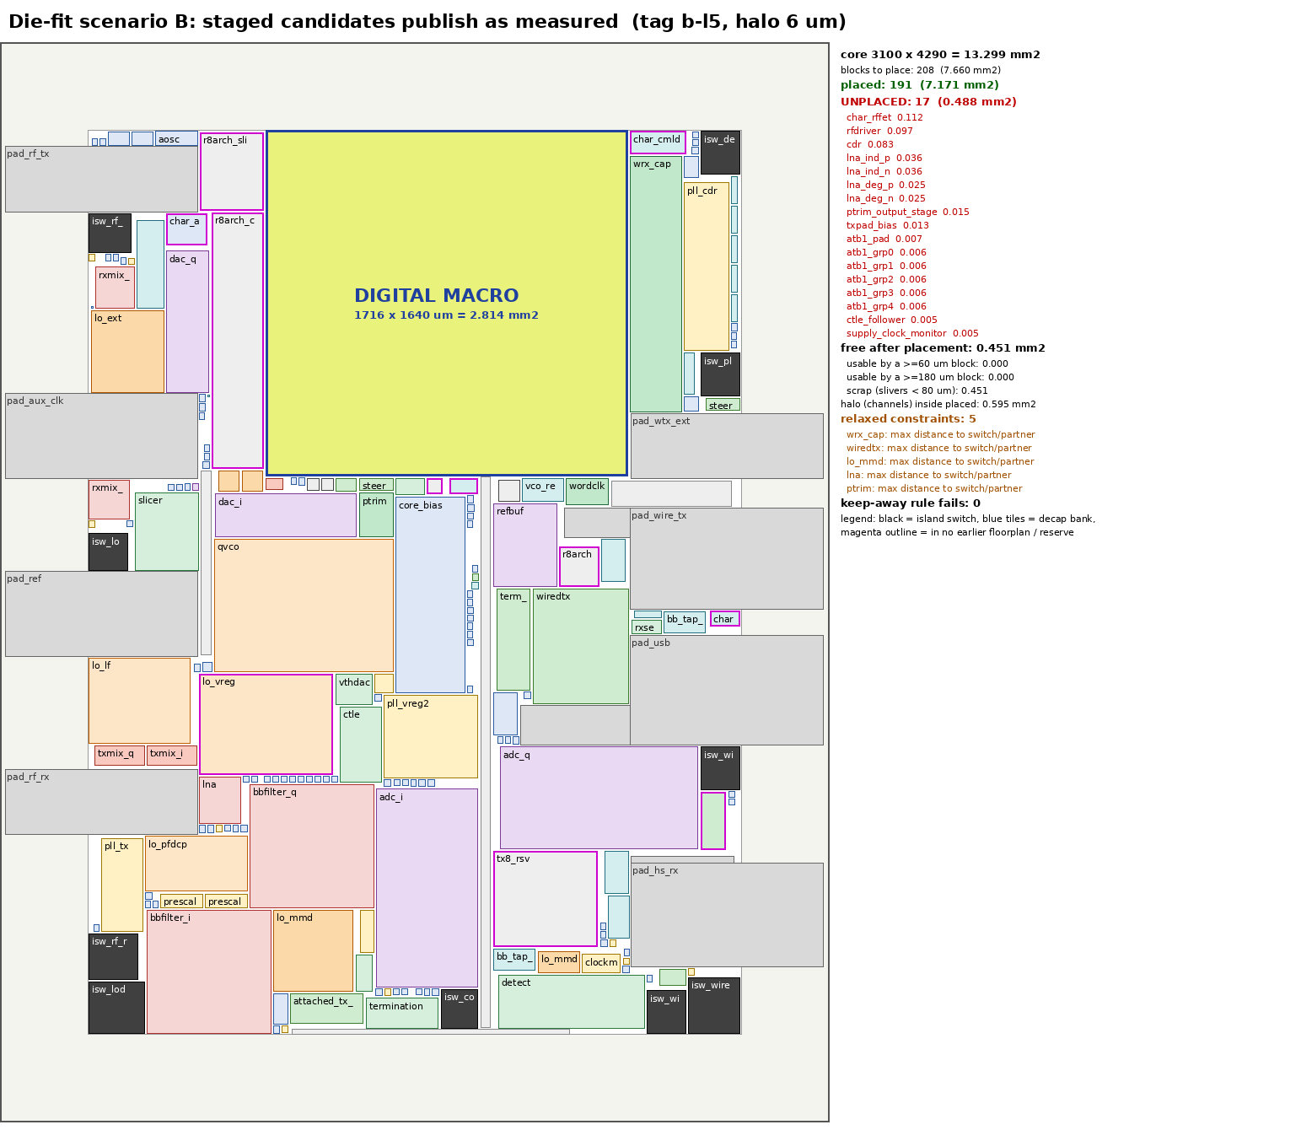
scratch/reviews/die-fit/run/fit-b-l5.png
