deepai-org/svalbard/scratch/reviews/die-fit/run/fit-b-l6.png

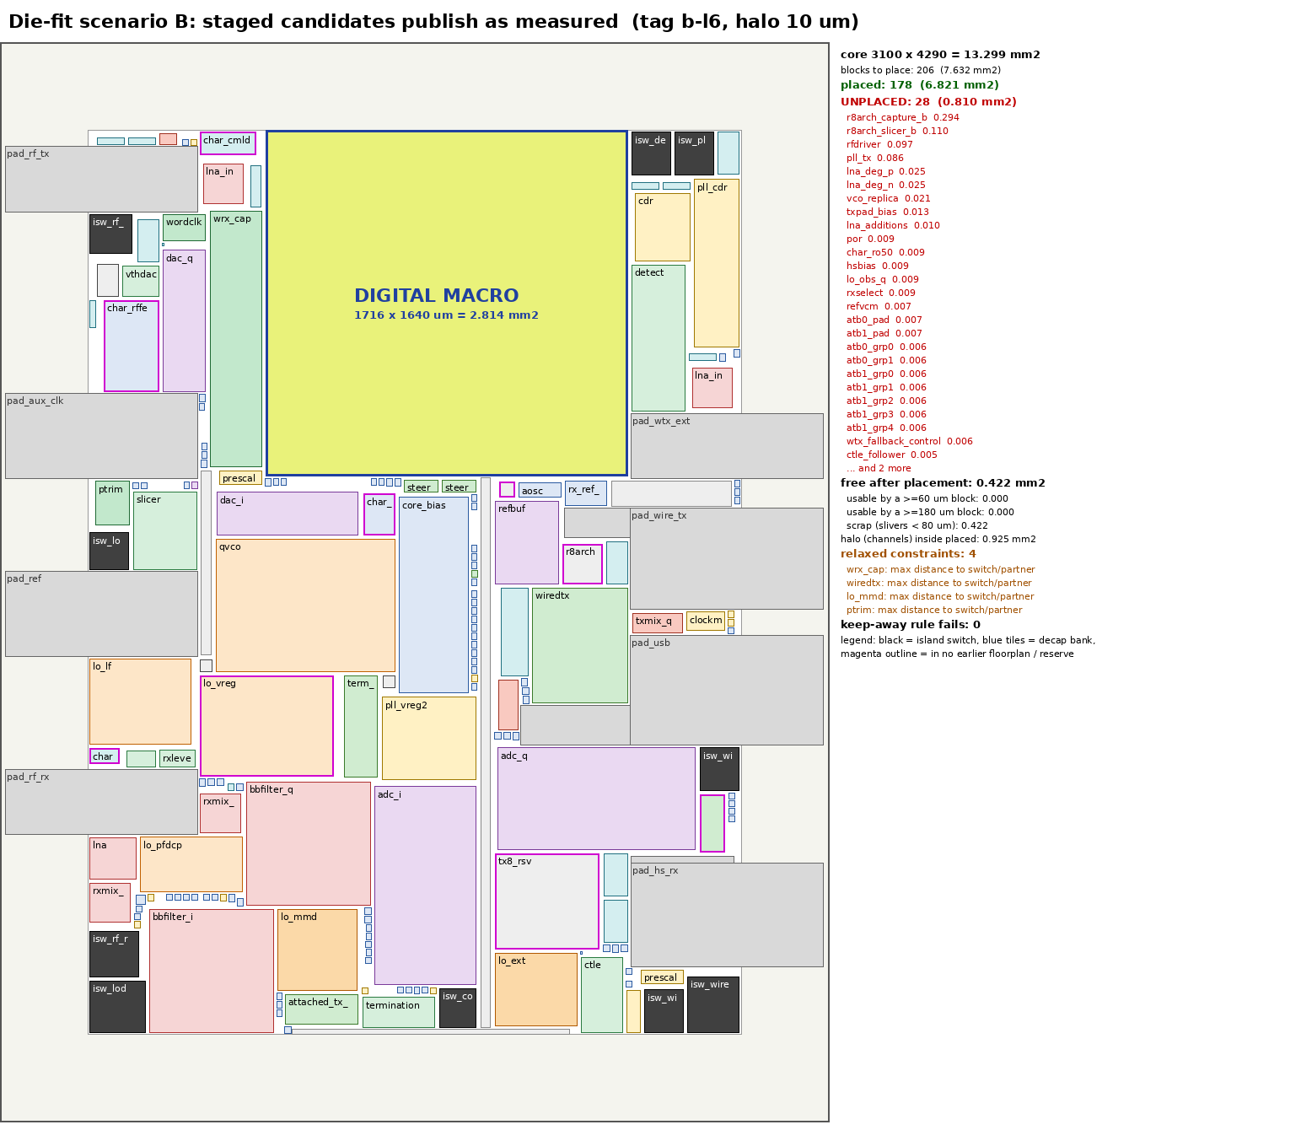
scratch/reviews/die-fit/run/fit-b-l6.png
