deepai-org/svalbard/scratch/reviews/die-fit/run/fit-b.png

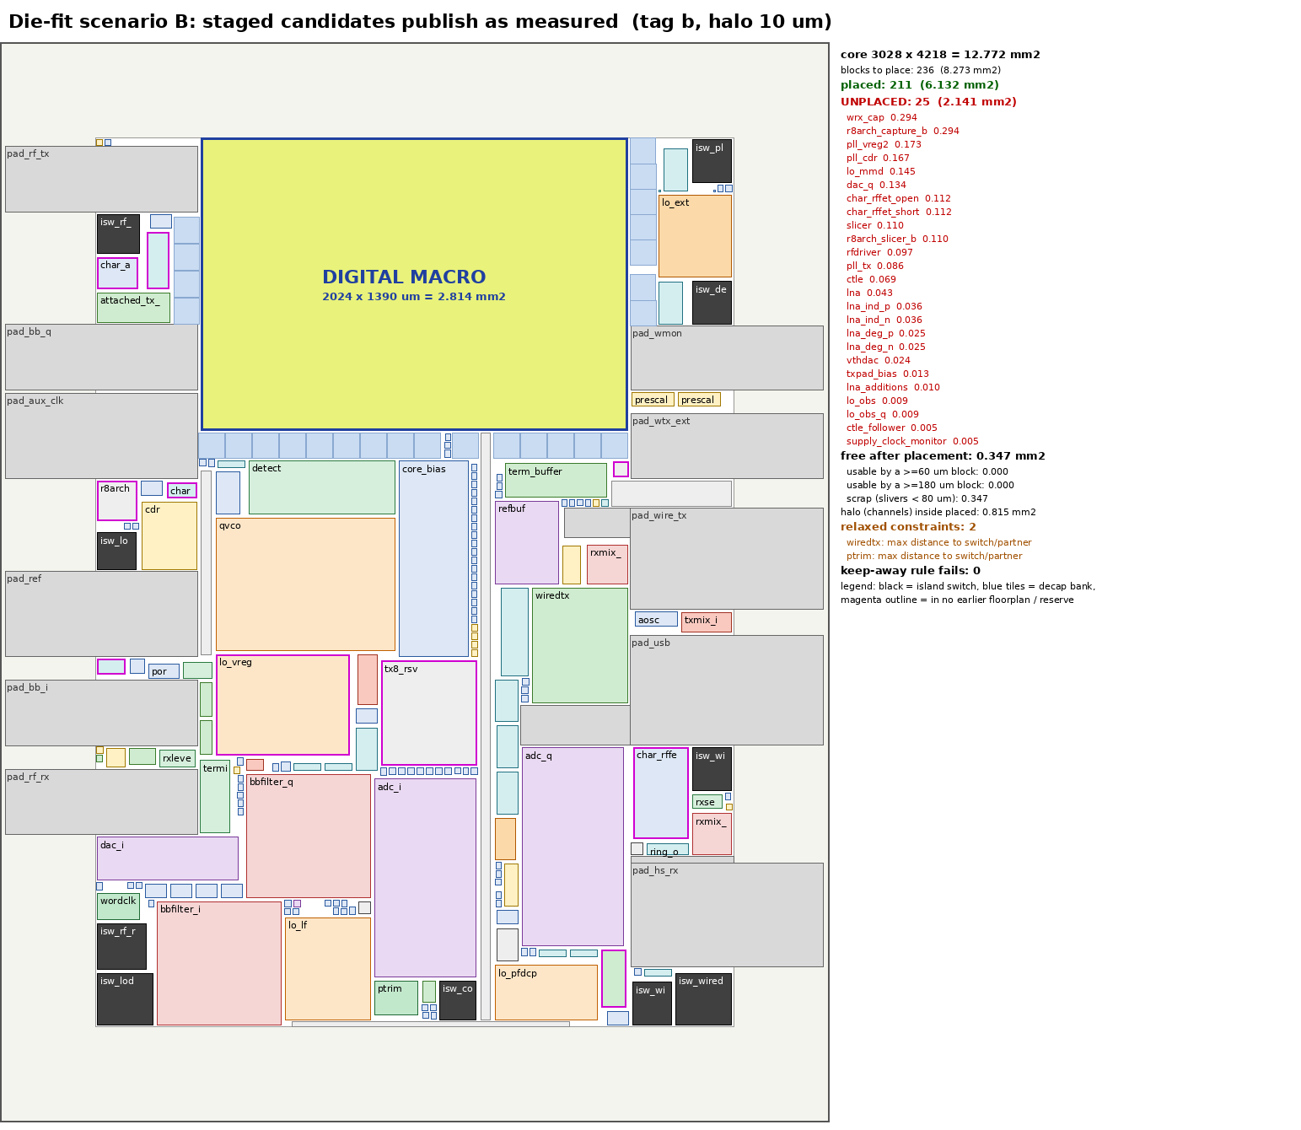
scratch/reviews/die-fit/run/fit-b.png
