deepai-org/svalbard/scratch/reviews/die-fit/run/fit-c-flow.png

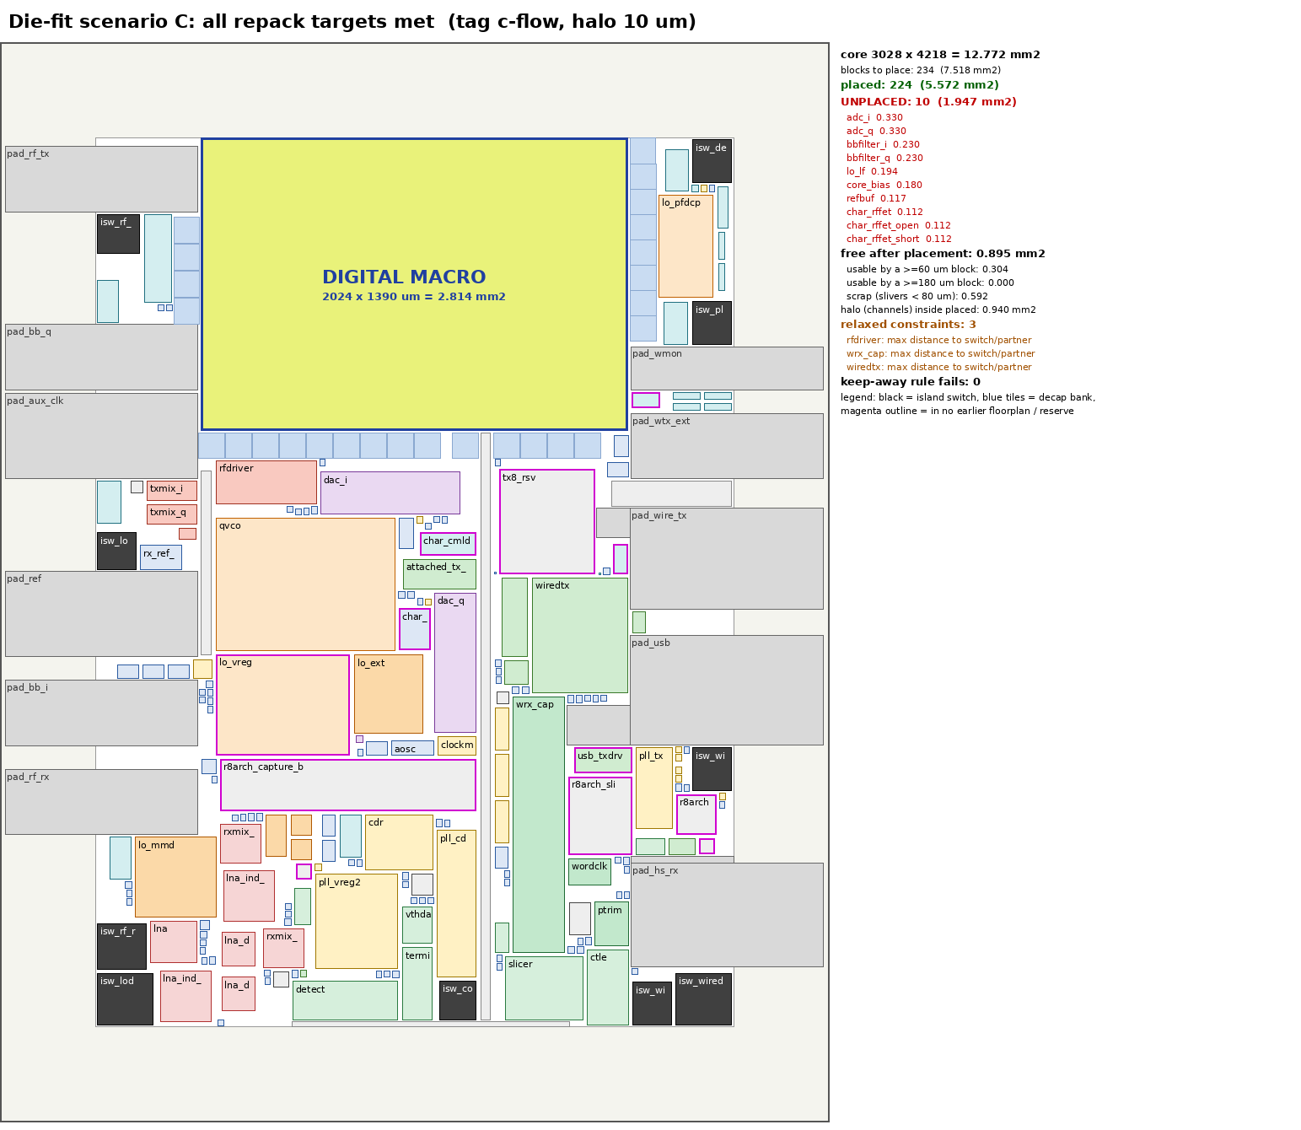
scratch/reviews/die-fit/run/fit-c-flow.png
