deepai-org/svalbard/scratch/reviews/die-fit/run/fit-c-h5.png

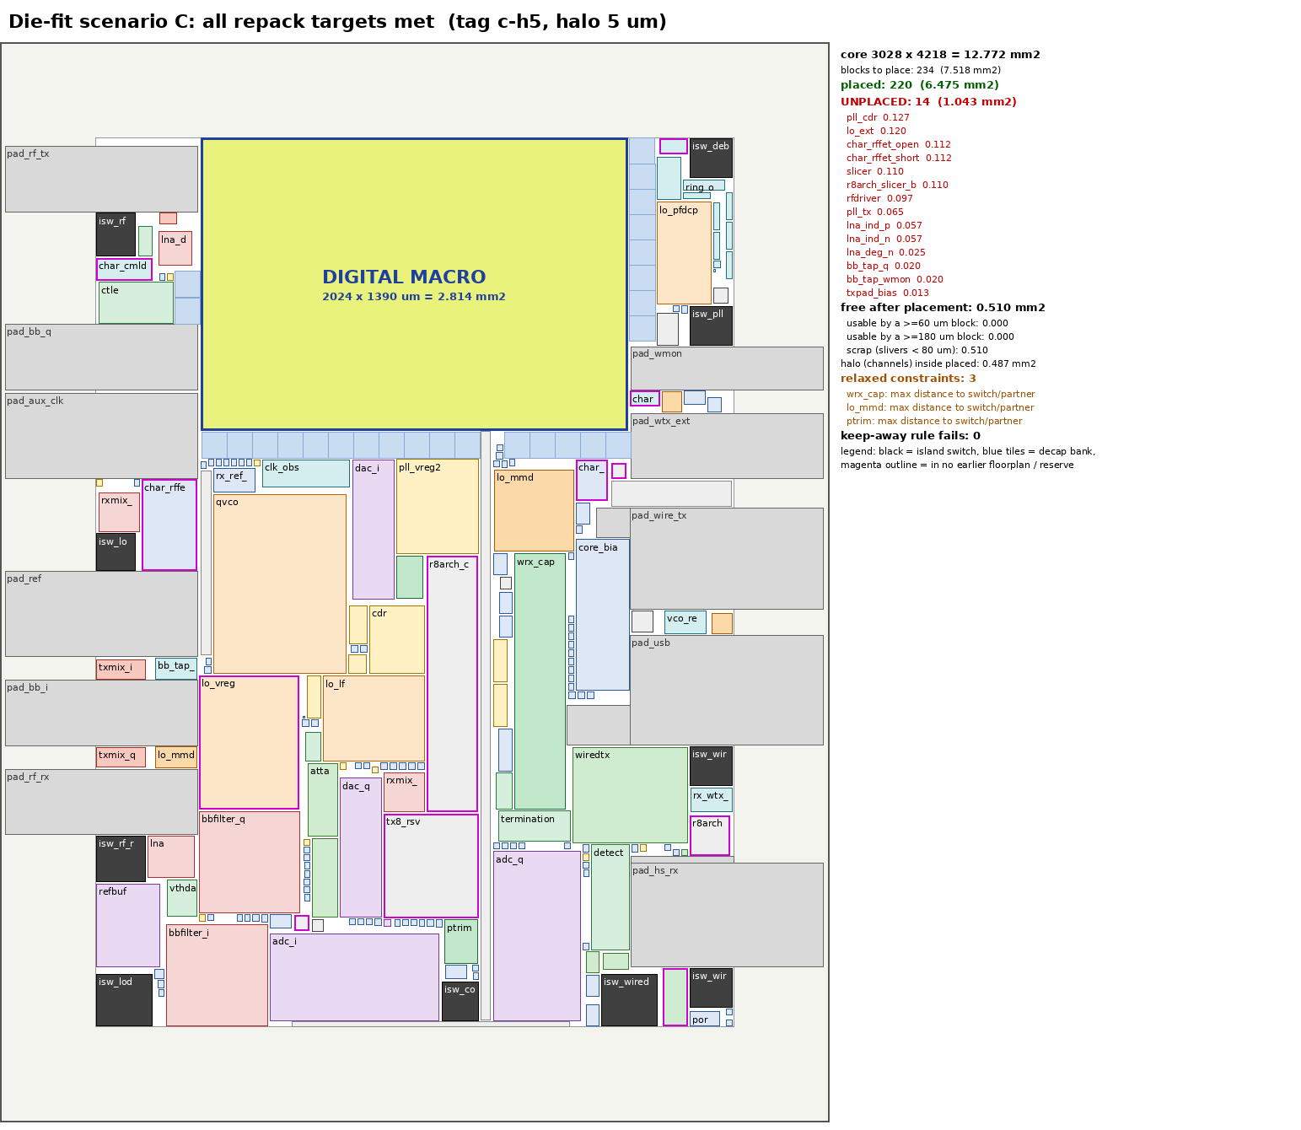
scratch/reviews/die-fit/run/fit-c-h5.png
