deepai-org/svalbard/scratch/reviews/die-fit/run/fit-c-l1.png

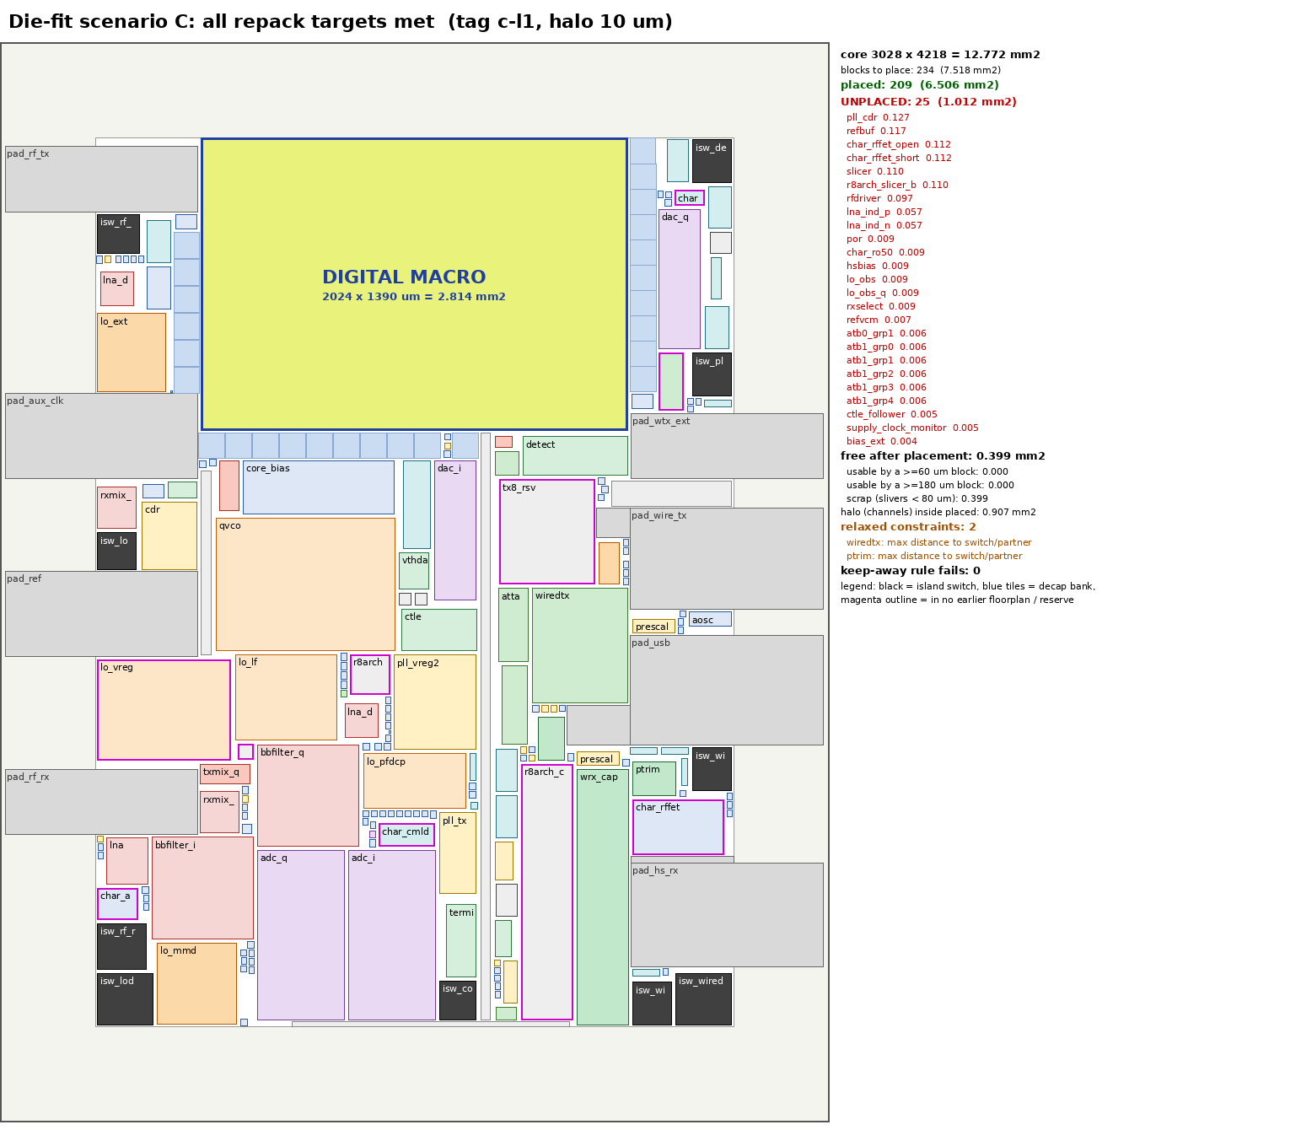
scratch/reviews/die-fit/run/fit-c-l1.png
