deepai-org/svalbard/scratch/reviews/die-fit/run/fit-c-l2.png

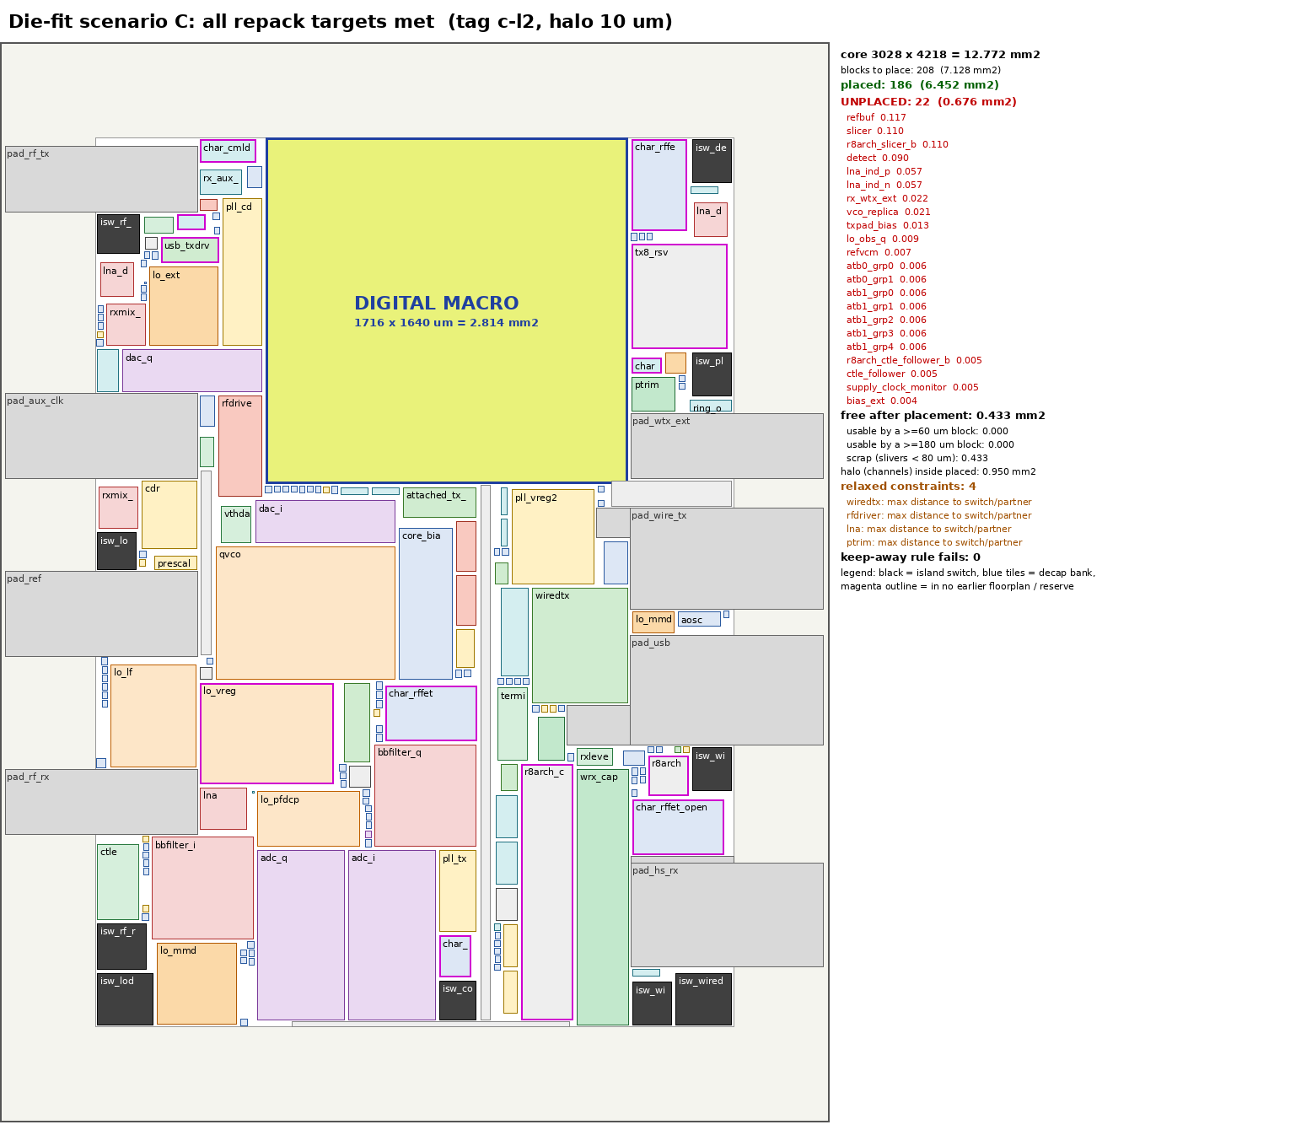
scratch/reviews/die-fit/run/fit-c-l2.png
