deepai-org/svalbard/scratch/reviews/die-fit/run/fit-c-l3.png

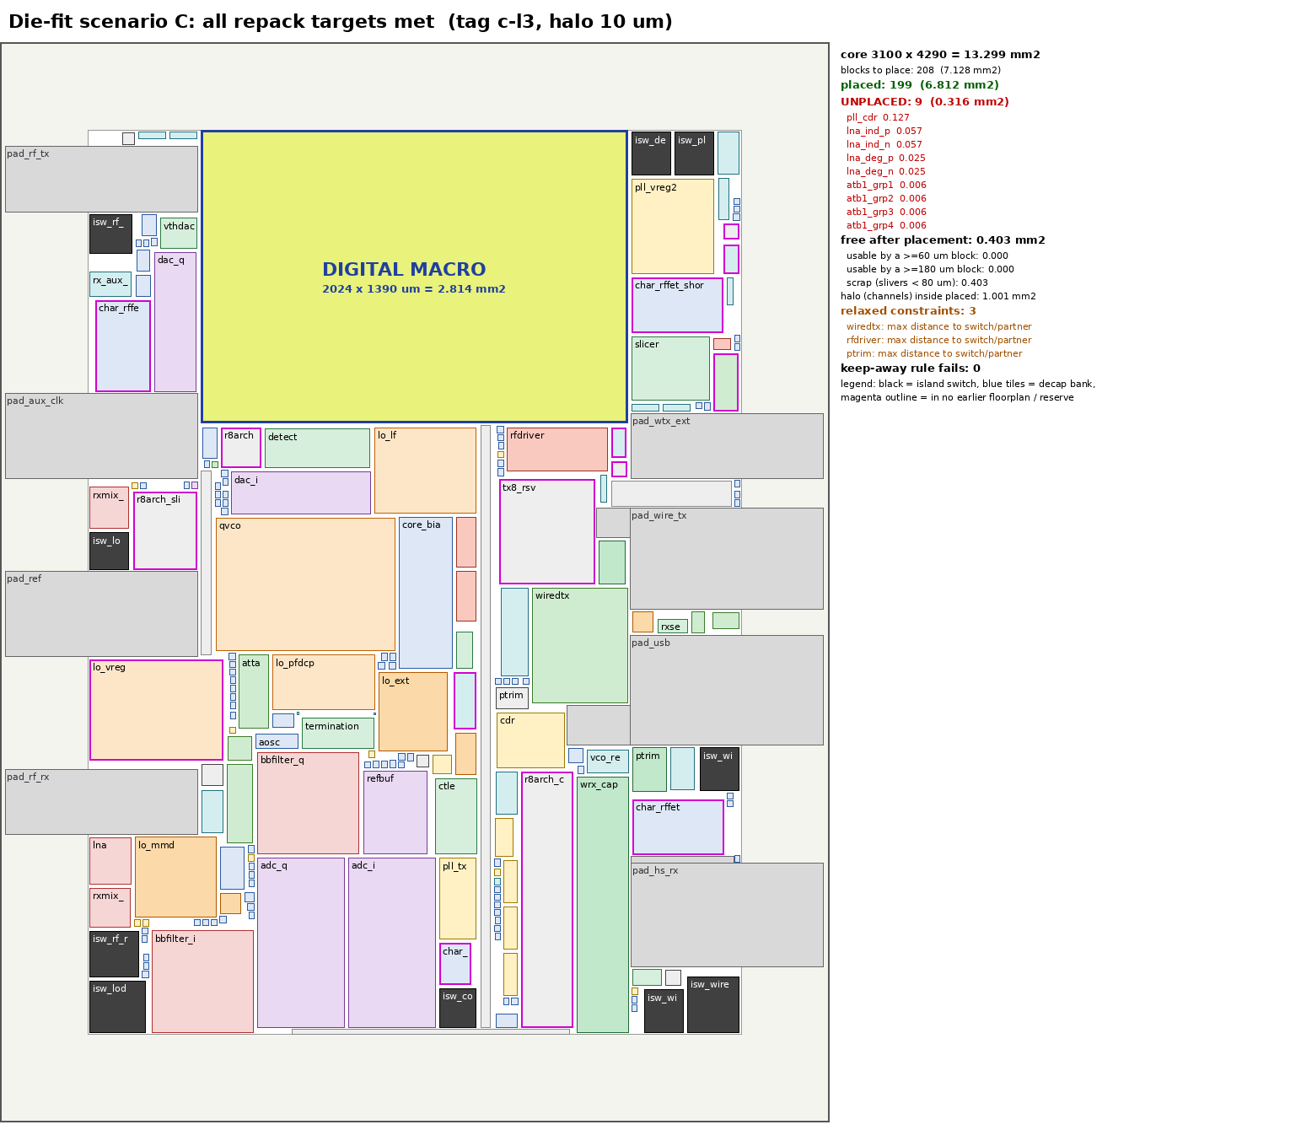
scratch/reviews/die-fit/run/fit-c-l3.png
