deepai-org/svalbard/scratch/reviews/die-fit/run/fit-c-l4.png

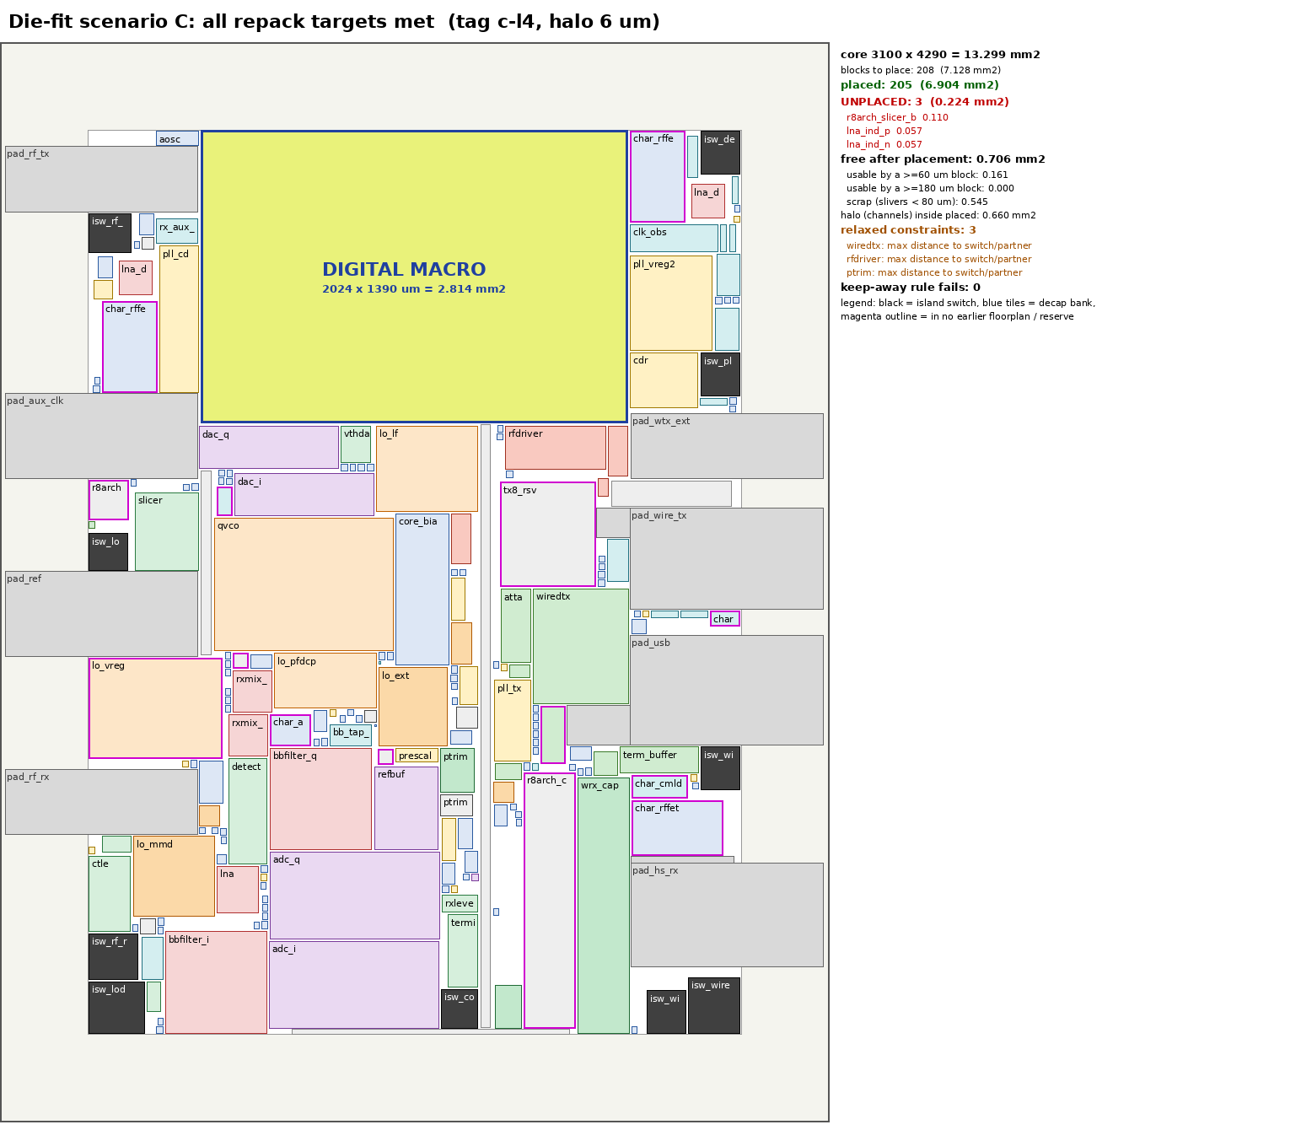
scratch/reviews/die-fit/run/fit-c-l4.png
