deepai-org/svalbard/scratch/reviews/die-fit/run/fit-c-l5-flow.png

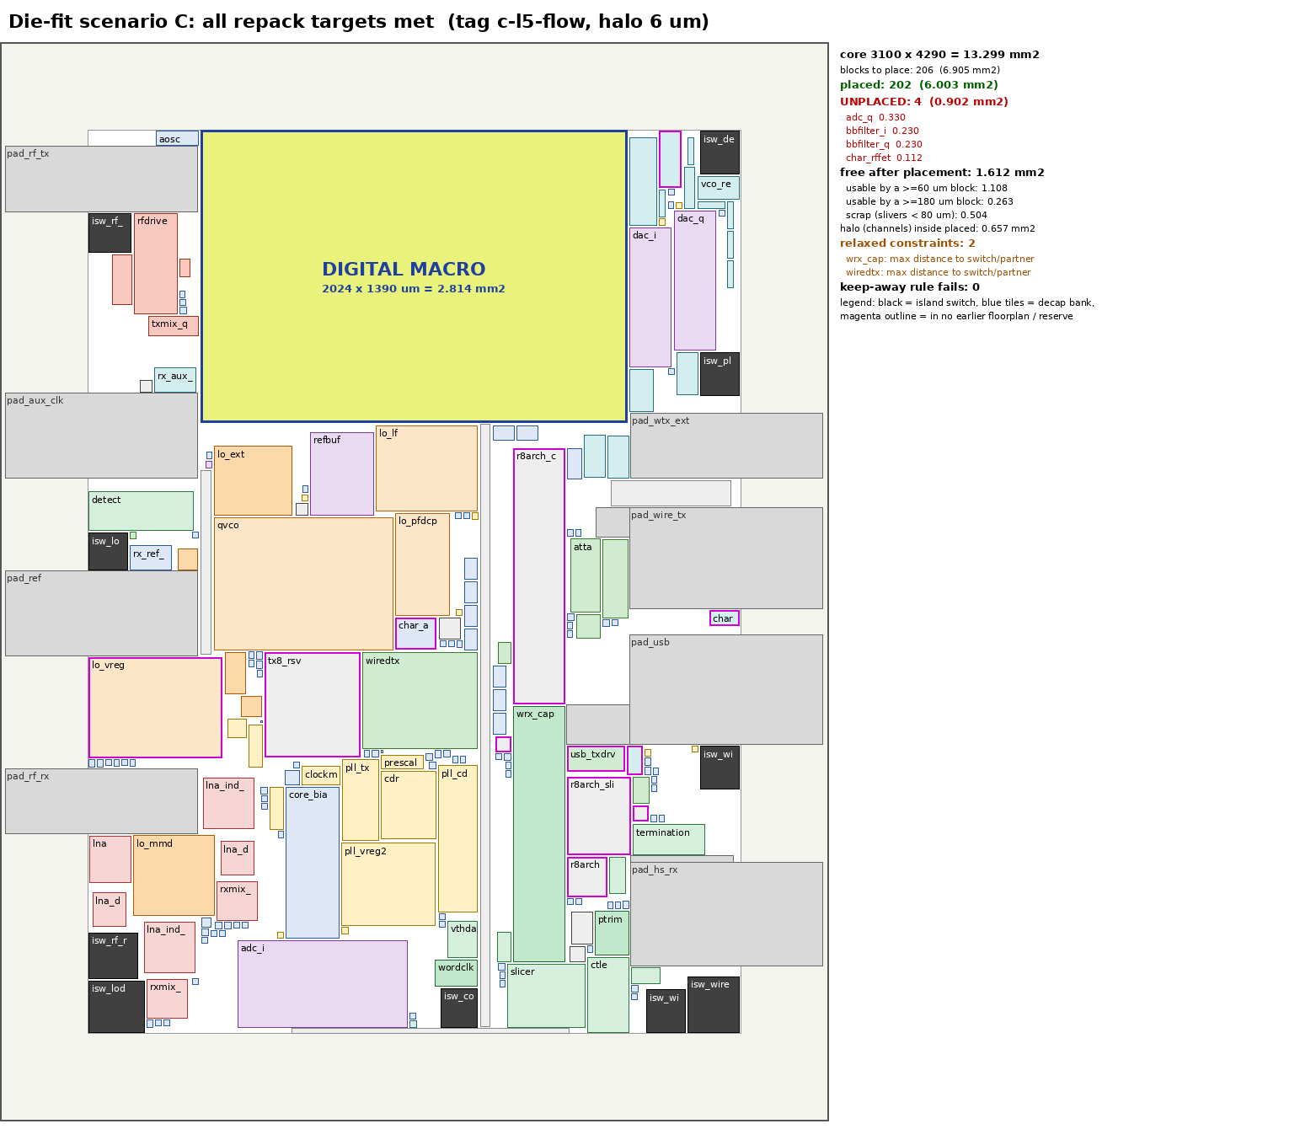
scratch/reviews/die-fit/run/fit-c-l5-flow.png
