deepai-org/svalbard/scratch/reviews/die-fit/run/fit-c-l5.png

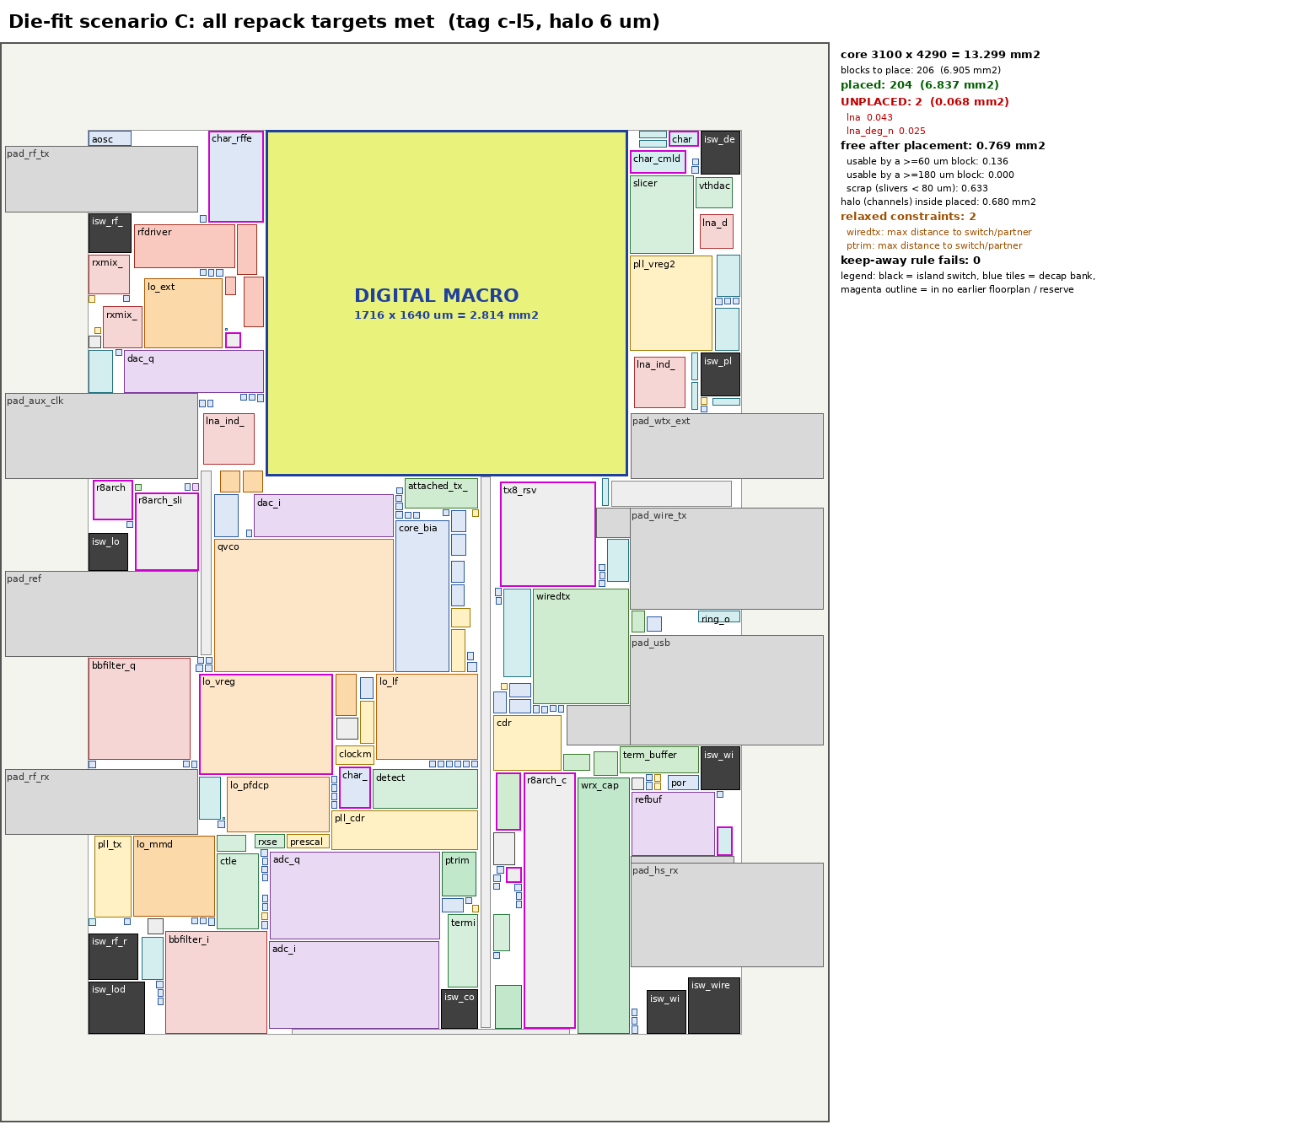
scratch/reviews/die-fit/run/fit-c-l5.png
