deepai-org/svalbard/scratch/reviews/die-fit/run/fit-cr-l5.png

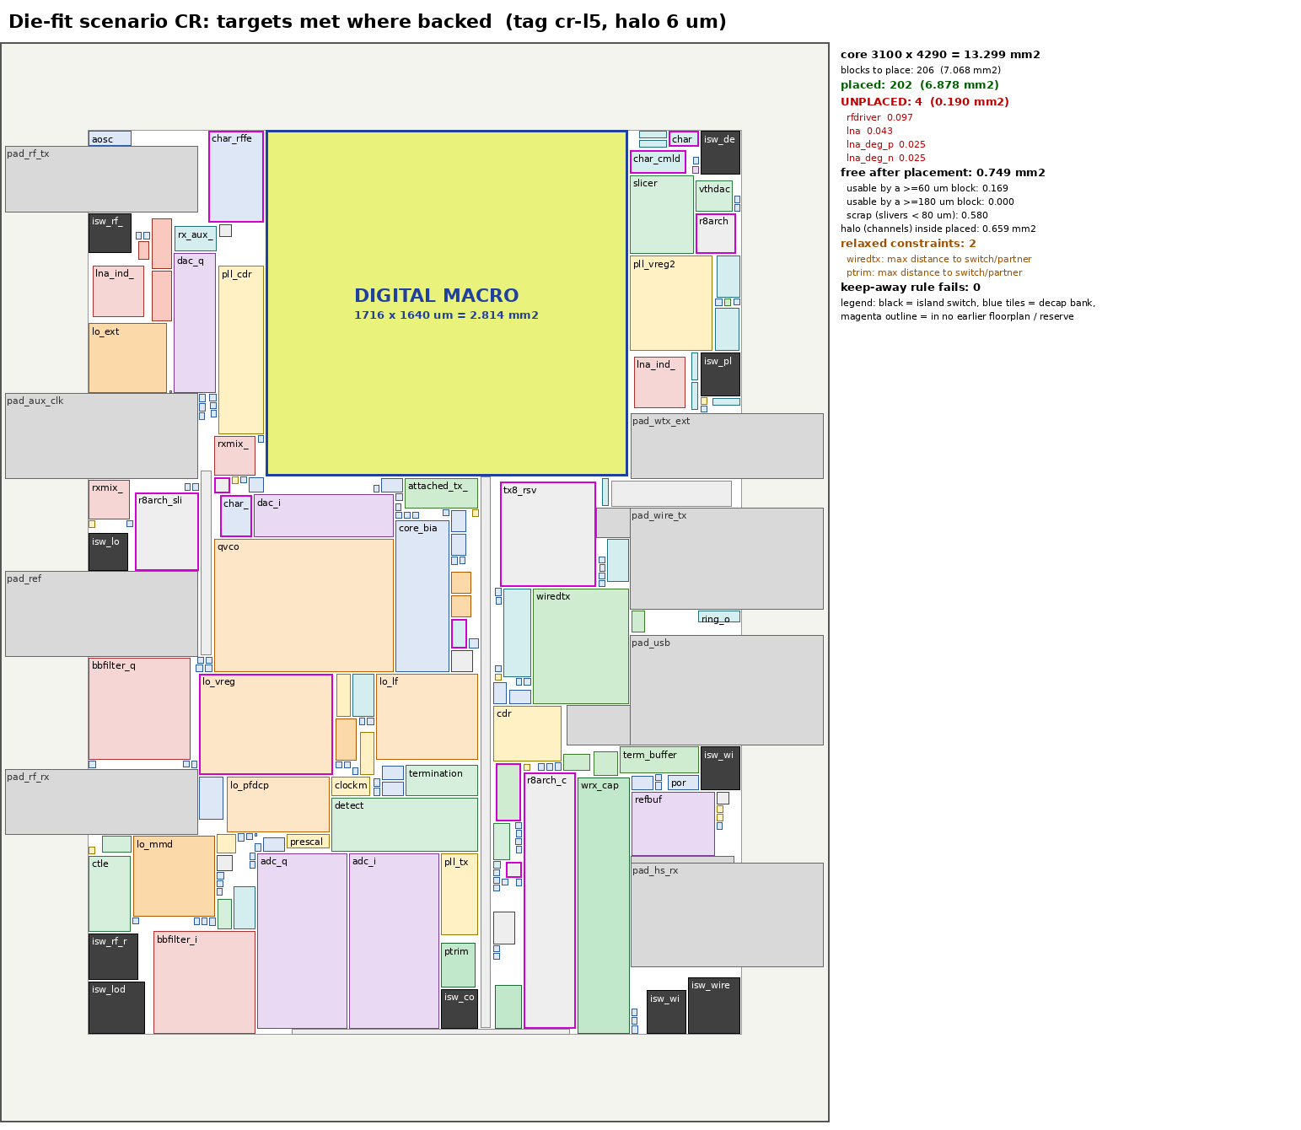
scratch/reviews/die-fit/run/fit-cr-l5.png
