deepai-org/svalbard/scratch/reviews/die-fit/run/fit-cr-l6.png

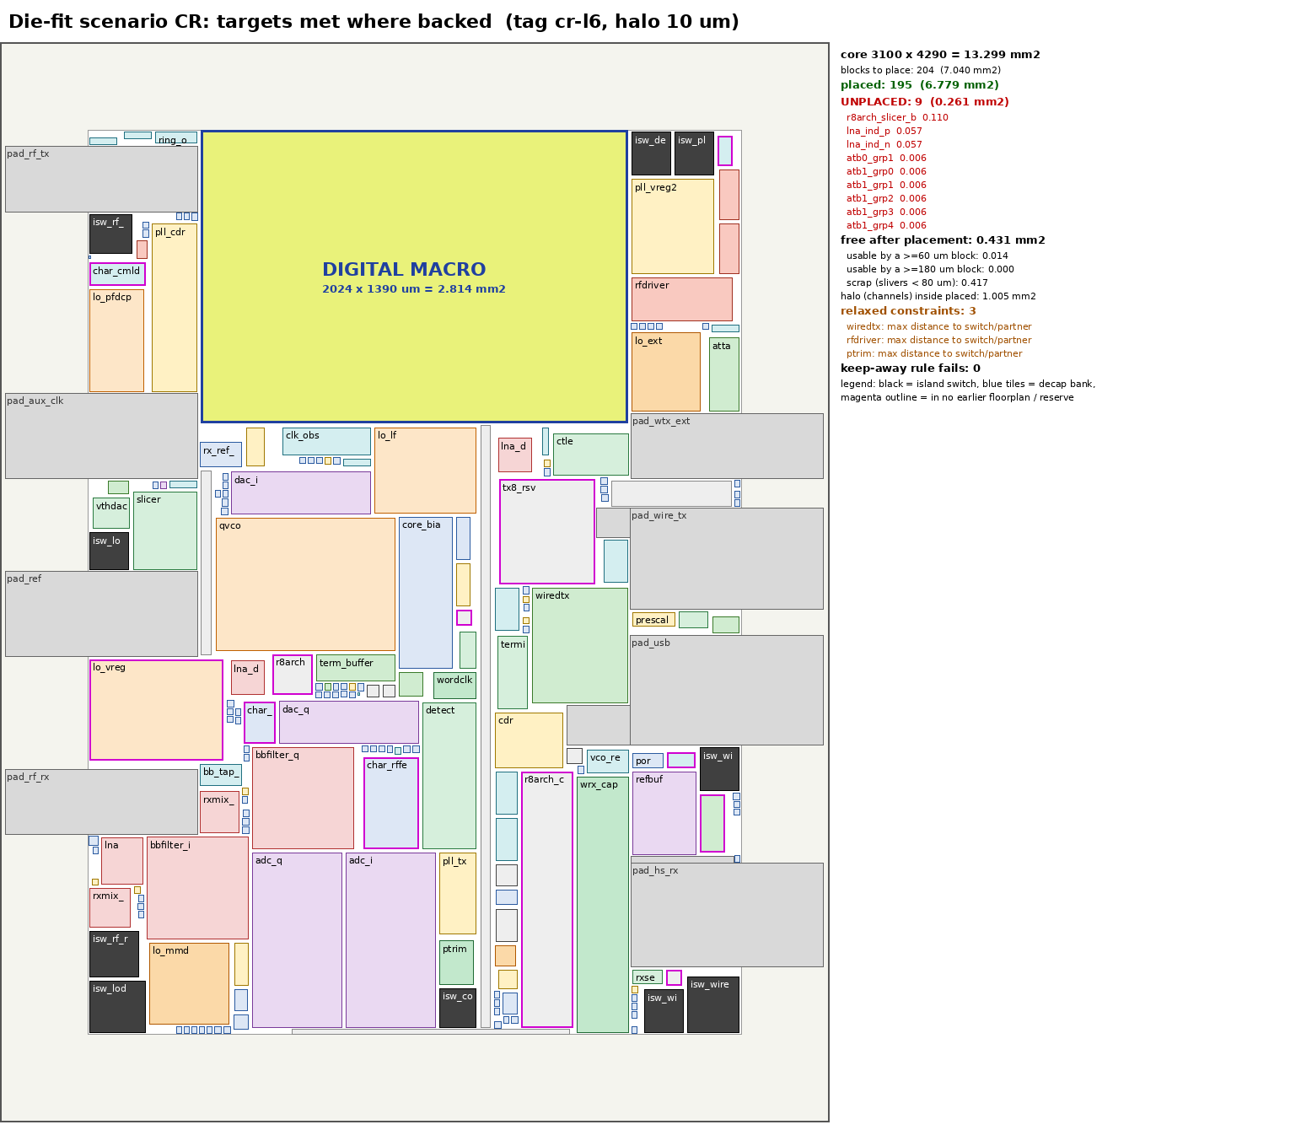
scratch/reviews/die-fit/run/fit-cr-l6.png
