deepai-org/svalbard/scratch/reviews/die-fit/run/v1/fit-b.png

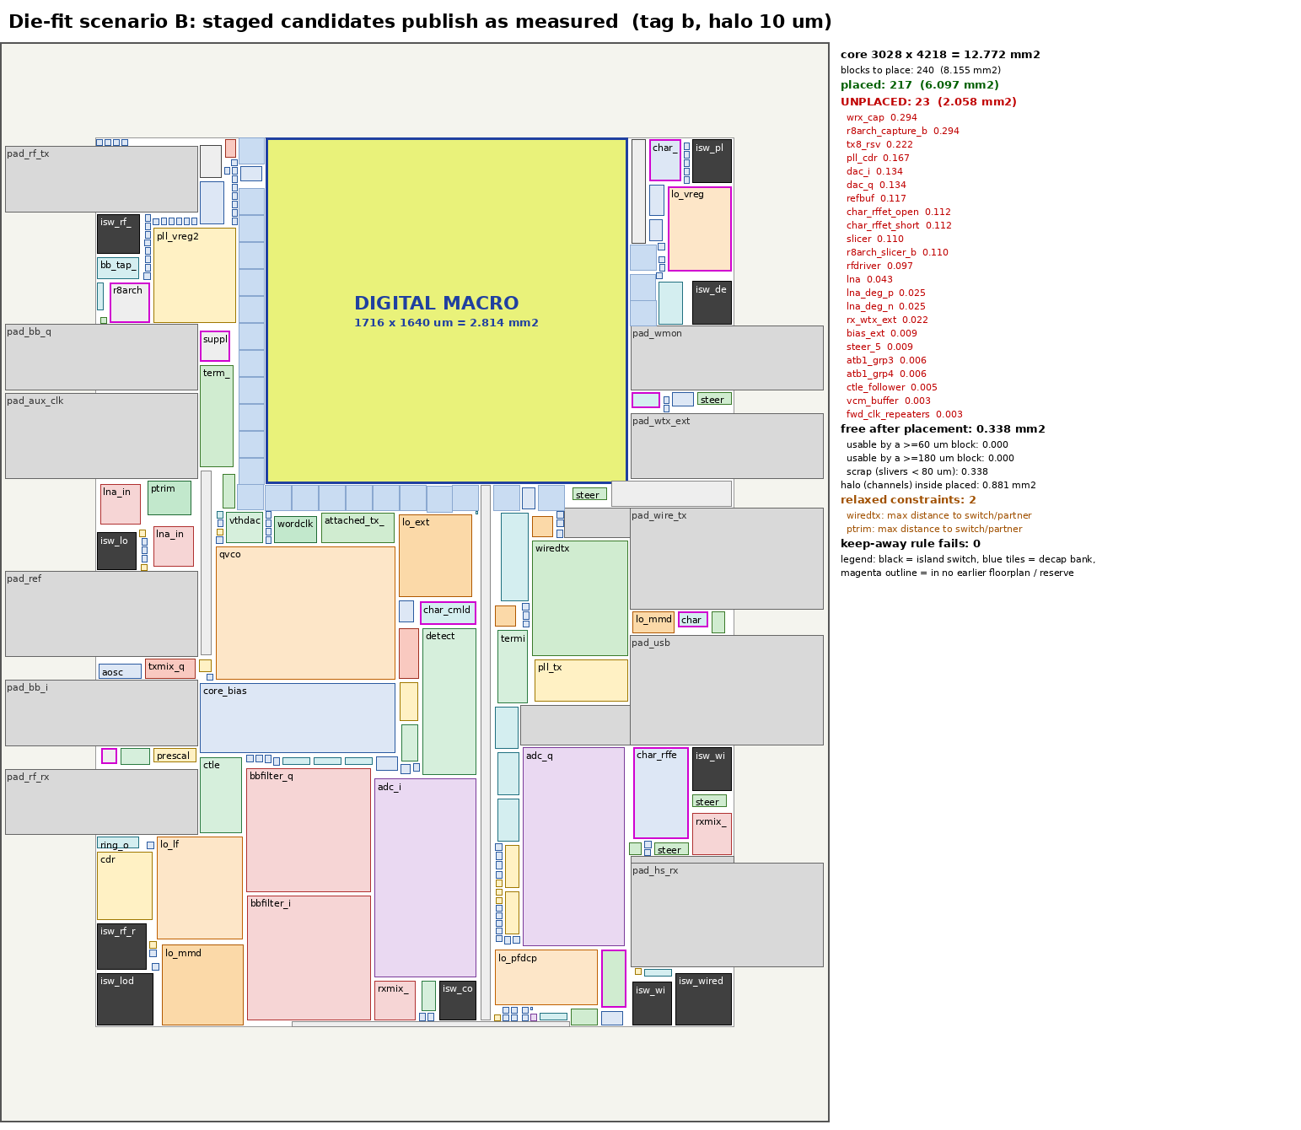
scratch/reviews/die-fit/run/v1/fit-b.png
