deepai-org/svalbard/scratch/reviews/die-fit/ledger.csv

item | master | group | kind | pub_um2 | staged_um2 | target_um2 | target_backed_um2 | conf | source | note
host | pt_host_physical | chip | conn | 0 | 0 | 0 | 0 | H | provider ring
debug_pads | pt_debug_physical | chip | conn | 0 | 0 | 0 | 0 | H | provider ring
pad_por_bypass | pad_strap | chip | conn | 0 | 0 | 0 | 0 | M | provider site (freed site) | no core area; site conflict POR strap / LNA ground / spare
digital | pt_digital_macro | chip | conn | 2814000 | 2814000 | 2814000 | 2814000 | H | digital NOTES TC7/TC8: 1716 x 1640 | must not shrink (AP4-8 2.45 not reachable); absorbs decode glue, 129 iso AND2, LO/CDR/USB control, decap row cells: cells 1.764 mm2 = 67.4 %
por | por | core | conn | 9469 | 9469 | 9469 | 9469 | H | scratch/chip-assembly-v5/run2/abstracts.json
aosc | pt_aosc | core | conn | 12864 | 12864 | 12864 | 12864 | H | scratch/area-pass-4/util.json
core_bias | pt_core_bias | core | conn | 301799 | 301799 | 180000 | 180000 | M | scratch/chip-assembly-v5/run2/abstracts.json; target area-pass-4 s1 (lever 13, not started) | v5 abstract outline, util 0.24
bias_ext | pt_bias_ext | core | conn | 4436 | 4436 | 4436 | 4436 | M | two pt_bias_tap2 cells of 2,218 (scratch/pads-core/bias/pub, review R10) | staged, not published (D-BIAS); in no floorplan
isw_wired_rx | isw_debug | core | conn | 36922 | 36922 | 36922 | 36922 | H | scratch/chip-assembly-v5/run2/abstracts.json | PD2 ten islands
isw_rf_tx | isw_debug | core | conn | 36922 | 36922 | 36922 | 36922 | H | scratch/chip-assembly-v5/run2/abstracts.json | PD2 ten islands
isw_debug | isw_debug | core | conn | 36922 | 36922 | 36922 | 36922 | H | scratch/chip-assembly-v5/run2/abstracts.json | PD2 ten islands
isw_wired_tx | isw_debug | core | conn | 36922 | 36922 | 36922 | 36922 | H | scratch/chip-assembly-v5/run2/abstracts.json | PD2 ten islands
isw_wired_cap | isw_wired | core | conn | 64081 | 64081 | 64081 | 64081 | H | scratch/chip-assembly-v5/run2/abstracts.json | PD2 ten islands: v6/AP4 floorplans hold 5 switches = 0.236 of the 0.426
isw_lod | isw_wired | core | conn | 64081 | 64081 | 64081 | 64081 | H | scratch/chip-assembly-v5/run2/abstracts.json | PD2 ten islands: v6/AP4 floorplans hold 5 switches = 0.236 of the 0.426
isw_rf_rx | isw_rf | core | conn | 49817 | 49817 | 49817 | 49817 | H | scratch/chip-assembly-v5/run2/abstracts.json
isw_conv | isw_conv | core | conn | 31781 | 31781 | 31781 | 31781 | H | scratch/chip-assembly-v5/run2/abstracts.json | PD2 ten islands
isw_lo | isw_conv | core | conn | 31781 | 31781 | 31781 | 31781 | H | scratch/chip-assembly-v5/run2/abstracts.json | PD2 ten islands
isw_pll | isw_debug | core | conn | 36922 | 36922 | 36922 | 36922 | H | scratch/chip-assembly-v5/run2/abstracts.json | PD2 ten islands
pad_dvdd_0 | prov_supply | chip | conn | 0 | 0 | 0 | 0 | H | provider ring
pad_dvdd_1 | prov_supply | chip | conn | 0 | 0 | 0 | 0 | H | provider ring
pad_dvdd_2 | prov_supply | chip | conn | 0 | 0 | 0 | 0 | H | provider ring
pad_dvdd_3 | prov_supply | chip | conn | 0 | 0 | 0 | 0 | H | provider ring
pad_dvdd_4 | prov_supply | chip | conn | 0 | 0 | 0 | 0 | H | provider ring
pad_dvdd_5 | prov_supply | chip | conn | 0 | 0 | 0 | 0 | H | provider ring
pad_vdd_0 | prov_supply | chip | conn | 0 | 0 | 0 | 0 | H | provider ring
pad_vdd_1 | prov_supply | chip | conn | 0 | 0 | 0 | 0 | H | provider ring
pad_dvss_0 | prov_supply | chip | conn | 0 | 0 | 0 | 0 | H | provider ring
pad_dvss_1 | prov_supply | chip | conn | 0 | 0 | 0 | 0 | H | provider ring
pad_dvss_2 | prov_supply | chip | conn | 0 | 0 | 0 | 0 | H | provider ring
pad_dvss_3 | prov_supply | chip | conn | 0 | 0 | 0 | 0 | H | provider ring
pad_dvss_4 | prov_supply | chip | conn | 0 | 0 | 0 | 0 | H | provider ring
pad_dvss_5 | prov_supply | chip | conn | 0 | 0 | 0 | 0 | H | provider ring
pad_dvss_6 | prov_supply | chip | conn | 0 | 0 | 0 | 0 | H | provider ring
pad_dvss_7 | prov_supply | chip | conn | 0 | 0 | 0 | 0 | H | provider ring
pad_vss_0 | prov_supply | chip | conn | 0 | 0 | 0 | 0 | H | provider ring
pad_vss_1 | prov_supply | chip | conn | 0 | 0 | 0 | 0 | H | provider ring
pad_agnd_rx_0 | pad_downbond | rf_rx | conn | 0 | 0 | 0 | 0 | M | in-ring down-bond site (AGND_RX) | no core area; site conflict with POR strap
pad_agnd_rx_1 | pad_downbond | rf_rx | conn | 0 | 0 | 0 | 0 | M | in-ring down-bond site (AGND_RX) | no core area; site conflict with POR strap
agnd_tie | pt_agnd_tie | core | conn | 2000 | 2000 | 2000 | 2000 | L | estimate (single-point AGND_RX to VSS tie through an ESD structure, PD2-12) | NEVER BUILT; in no floorplan
pad_rf_rx | pad_rf_pair | rf_rx | conn | 150969 | 150969 | 150969 | 150969 | H | v5 floorplan rect clipped to core: 310.06 x 486.91
pad_rf_tx | pad_rftxpad | rf_tx | conn | 150969 | 150969 | 150969 | 150969 | H | same footprint as pad_rf_pair
pad_bb_i | pad_rf_pair | debug | conn | 150969 | 150969 | 150969 | 150969 | H | v5 floorplan rect clipped to core: 310.06 x 486.91
pad_bb_q | pad_rf_pair | debug | conn | 150969 | 150969 | 150969 | 150969 | H | v5 floorplan rect clipped to core: 310.06 x 486.91
pad_wtx_ext | pad_rf_pair | debug | conn | 150969 | 150969 | 150969 | 150969 | H | v5 floorplan rect clipped to core: 310.06 x 486.91
pad_wmon | pad_single_leg | debug | conn | 147144 | 147144 | 99843 | 147144 | M | scratch/area-pass-4/util.json (302.2 x 912.9 drawn); target = undrawn 205 um B cell | UNDER-BOOKED in v6/AP4 floorplans: they place WMON at 205 um (pad_single_leg_b, never drawn), the published cell is 302 um: +0.047
pad_tlp | pad_tlp | core | conn | 0 | 0 | 0 | 0 | H | in-ring site 68 x 124 at bidir[25] (PD48b) | no core area
pad_ref | pad_refpad | pll | conn | 195358 | 195358 | 195358 | 195358 | H | v5 floorplan rect clipped: 401.22 x 486.91
pad_aux_clk | pad_refpad | pll | conn | 195358 | 195358 | 195358 | 195358 | H | v5 floorplan rect clipped: 401.22 x 486.91
refvcm | pt_refvcm | pll | conn | 7443 | 7443 | 7443 | 7443 | M | scratch/pads-core/bias/pub layout (review R10) | staged, not published (D-REFVCM); in no floorplan
pad_hs_rx | pad_hspad | wired_rx | conn | 327587 | 239587 | 239587 | 239587 | M | published 478.06 x 685.25 in core; staged scratch/pads-core/hspad/b2 492.06 x 486.91 (review pending)
pad_usb | pad_wirepad | wired_tx | conn | 352916 | 352916 | 311134 | 311134 | H | padnotch.json: shell 521.22 x 488.9 + attachment column 187.7 x 522.6; target AP4-6 column 300 um | OVER-BOOKED in v6/AP4: bbox 527,214 booked, 174,298 of it is an empty notch (v5 knew it)
pad_wire_tx | pad_txpad | wired_tx | conn | 278736 | 278736 | 257572 | 257572 | H | padnotch.json: shell 481.22 x 488.9 + column 139.4 x 311.8; target AP4-6 column 160 um | OVER-BOOKED in v6/AP4: bbox 385,322 booked, 106,586 is an empty notch
lna | pt_lna | rf_rx | conn | 78352 | 42921 | 42921 | 42921 | M | published = git HEAD generated/lna-layout.json (review R3); staged = working-tree generated/ (uncommitted, design not closed) | tail source + gate R still to add (lna_additions row)
lna_ind_p | pt_lna_ind | rf_rx | conn | 50000 | 35700 | 57200 | 57200 | L | pub = v6 lc_load_rsv 0.10/2; staged 170 um coil (rf-lna-p NOTES l.164); target 4 t d220 57.2k (l.189, +2.3 dB pess) | spiral: keep-out 25 um, no MIM/grid/fill over it
lna_ind_n | pt_lna_ind | rf_rx | conn | 50000 | 35700 | 57200 | 57200 | L | pub = v6 lc_load_rsv 0.10/2; staged 170 um coil (rf-lna-p NOTES l.164); target 4 t d220 57.2k (l.189, +2.3 dB pess) | spiral: keep-out 25 um, no MIM/grid/fill over it
lna_deg_p | pt_lna_deg | rf_rx | conn | 25200 | 25200 | 25200 | 25200 | M | rf-lna-p NOTES l.159-160 (G_DEG 140 um 2 t) | bench model + generator only; IN NO FLOORPLAN; spiral keep-out
lna_deg_n | pt_lna_deg | rf_rx | conn | 25200 | 25200 | 25200 | 25200 | M | rf-lna-p NOTES l.159-160 (G_DEG 140 um 2 t) | bench model + generator only; IN NO FLOORPLAN; spiral keep-out
rxmix_i | pt_rxmix_i | rf_rx | conn | 76238 | 35442 | 35442 | 35442 | M | published = git HEAD (review R3); staged = working tree (TIA back to the small option)
rxmix_q | pt_rxmix_q | rf_rx | conn | 76238 | 35442 | 35442 | 35442 | M | as rxmix_i
bbfilter_i | pt_bbfilter_i | rf_rx | conn | 341901 | 341901 | 230000 | 230000 | H | scratch/area-pass-4/util.json; target AP4-3 (not started)
bbfilter_q | pt_bbfilter_q | rf_rx | conn | 341901 | 341901 | 230000 | 230000 | H | scratch/area-pass-4/util.json
bb_tap_i | pt_bb_tap | debug | conn | 9978 | 19511 | 19511 | 19511 | M | published = git HEAD 9,978; staged = working tree 19,511 (review R3)
bb_tap_q | pt_bb_tap | debug | conn | 9978 | 19511 | 19511 | 19511 | M | published = git HEAD 9,978; staged = working tree 19,511 (review R3)
bb_tap_wmon | pt_bb_tap | debug | conn | 9978 | 19511 | 19511 | 19511 | M | published = git HEAD 9,978; staged = working tree 19,511 (review R3)
iso_wmon | iso_pd | debug | conn | 95 | 95 | 95 | 95 | H | iso-placement.json | IN NO FLOORPLAN
adc_i | pt_adc_i | conv | conn | 577710 | 449686 | 330000 | 350000 | M | scratch/area-pass-4/util.json; staged scratch/reviews/die-fit/m45free_staged.json (staged GDS bbox) 480.28 x 936.30 (not published, stage4 not re-reviewed); target AP4-4 | target missed by 0.12 each
adc_q | pt_adc_q | conv | conn | 577785 | 449686 | 330000 | 350000 | M | as adc_i
iso_conv_clk | iso_clamp_x4 | conv | conn | 1025 | 1025 | 1025 | 1025 | H | iso-placement.json | IN NO FLOORPLAN
dac_i | pt_dac_i | conv | conn | 186115 | 134121 | 130000 | 130000 | M | scratch/area-pass-4/util.json; staged 668.5 x 200.63
dac_q | pt_dac_q | conv | conn | 186115 | 134121 | 130000 | 130000 | M | as dac_i
refbuf | pt_refbuf | conv | conn | 117089 | 117089 | 117089 | 117089 | H | scratch/area-pass-4/util.json
iso_rf_rx_clk | iso_clamp_x4 | core | conn | 1025 | 1025 | 1025 | 1025 | H | iso-placement.json | IN NO FLOORPLAN
txmix_i | pt_txmix_i | rf_tx | conn | 21424 | 21424 | 21424 | 21424 | H | scratch/area-pass-4/util.json
txmix_q | pt_txmix_q | rf_tx | conn | 21424 | 21424 | 21424 | 21424 | H | scratch/area-pass-4/util.json
txsum | pt_txsum | rf_tx | conn | 3988 | 3988 | 3988 | 3988 | H | scratch/area-pass-4/util.json
rfdriver | pt_rfdriver | rf_tx | conn | 96812 | 96812 | 96812 | 96812 | H | scratch/area-pass-4/util.json
lo_ext | pt_lo_ext | lod | conn | 155350 | 133006 | 120000 | 120000 | M | scratch/area-pass-4/util.json; staged lo-ap4 cand/run2 343.1 x 387.66 (not qualified)
lo_vreg | pt_lo_vreg | lo | conn | 300000 | 300000 | 300000 | 300000 | L | review R1: scratch/lo-ap4/vreg2/reg.py schematic has ~0.24 mm2 of bare devices (pass devices, 62 MOS-cap units, 90 resistors); 0.25-0.38 at pll_vreg2 utilisation; first estimate here was 0.12 | NEVER BUILT; still fails 59 dB at 78.125 MHz without an external capacitor (which would need a pad site); in no floorplan
qvco | pt_lc_qvco5 | lo | conn | 532476 | 532476 | 532476 | 532476 | H | scratch/area-pass-4/util.json 848 x 627.9 | two empty corner slots 111 x 303 (lo-ap4 NOTES)
lo_mmd | pt_lo_mmd | lod | conn | 361116 | 145031 | 145031 | 145031 | M | scratch/area-pass-4/util.json; staged lo-ap4 377.92 x 383.76 (review NO-GO: -0.2 GHz)
lo_mmd_qdum | pt_lo_mmd_qdum | lod | conn | 34062 | 19124 | 19124 | 19124 | M | scratch/area-pass-4/util.json; staged 97.98 x 195.18 | fits QVCO slot A
lo_pfdcp | pt_lo_pfdcp | lo | conn | 124110 | 124110 | 124110 | 124110 | H | scratch/area-pass-4/util.json
lo_lf | pt_lo_lf | lo | conn | 194122 | 194122 | 194122 | 194122 | H | scratch/area-pass-4/util.json
lo_obs | pt_lo_obs | lod | conn | 17428 | 9022 | 9022 | 9022 | M | scratch/area-pass-4/util.json; staged 96.4 x 93.59 | fits QVCO slot A/B
lo_obs_q | pt_lo_obs | lod | conn | 17428 | 9022 | 9022 | 9022 | M | scratch/area-pass-4/util.json; staged 96.4 x 93.59 | fits QVCO slot A/B
rx_ref_in | pt_diff_clk_rx | core | conn | 22341 | 22341 | 22341 | 22341 | H | scratch/area-pass-4/util.json
clockmux | pt_clockmux | pll | conn | 15161 | 15161 | 15161 | 15161 | H | scratch/area-pass-4/util.json
iso_host_clk | iso_clamp_x4 | core | conn | 1025 | 1025 | 1025 | 1025 | H | iso-placement.json | IN NO FLOORPLAN
prescale | pt_prescale | pll | conn | 12600 | 12600 | 12600 | 12600 | H | scratch/area-pass-4/util.json
prescale_conv | pt_prescale | pll | conn | 12600 | 12600 | 12600 | 12600 | H | scratch/area-pass-4/util.json
prescale_hf | pt_prescale | pll | conn | 12600 | 12600 | 12600 | 12600 | H | scratch/area-pass-4/util.json
pll_vreg2 | pt_pll_vreg2 | pll | conn | 173424 | 173424 | 173424 | 173424 | H | scratch/area-pass-4/util.json
pll_tx | pt_pll_ring_core | pll | conn | 86020 | 86020 | 65000 | 65000 | H | scratch/area-pass-4/util.json; target AP4-5c (wired RX, not started)
iso_pll_tx_fbck | iso_clamp_x4 | core | conn | 1025 | 1025 | 1025 | 1025 | H | iso-placement.json | IN NO FLOORPLAN
pll_cdr | pt_pll_ring | pll | conn | 166657 | 166657 | 127000 | 166657 | H | scratch/area-pass-4/util.json; target: owner says 0.115 unreachable, 0.127 with a core ECO (wired_rx README Resume 9)
cdr | pt_cdr | pll | conn | 82901 | 82901 | 82901 | 82901 | H | r13 published 259.26 x 319.76 (measured)
iso_cdr_up_0 | iso_clamp | pll | conn | 906 | 906 | 906 | 906 | H | iso-placement.json size_um | IN NO FLOORPLAN; CP4-1 already applied in the conn: 130 clamps are AND2 in the macro, 16 + 2 pull-downs stay outside
iso_cdr_up_1 | iso_clamp | pll | conn | 906 | 906 | 906 | 906 | H | iso-placement.json size_um | IN NO FLOORPLAN; CP4-1 already applied in the conn: 130 clamps are AND2 in the macro, 16 + 2 pull-downs stay outside
iso_cdr_up_2 | iso_clamp | pll | conn | 906 | 906 | 906 | 906 | H | iso-placement.json size_um | IN NO FLOORPLAN; CP4-1 already applied in the conn: 130 clamps are AND2 in the macro, 16 + 2 pull-downs stay outside
iso_cdr_up_3 | iso_clamp | pll | conn | 906 | 906 | 906 | 906 | H | iso-placement.json size_um | IN NO FLOORPLAN; CP4-1 already applied in the conn: 130 clamps are AND2 in the macro, 16 + 2 pull-downs stay outside
iso_cdr_dn_0 | iso_clamp | pll | conn | 906 | 906 | 906 | 906 | H | iso-placement.json size_um | IN NO FLOORPLAN; CP4-1 already applied in the conn: 130 clamps are AND2 in the macro, 16 + 2 pull-downs stay outside
iso_cdr_dn_1 | iso_clamp | pll | conn | 906 | 906 | 906 | 906 | H | iso-placement.json size_um | IN NO FLOORPLAN; CP4-1 already applied in the conn: 130 clamps are AND2 in the macro, 16 + 2 pull-downs stay outside
iso_cdr_dn_2 | iso_clamp | pll | conn | 906 | 906 | 906 | 906 | H | iso-placement.json size_um | IN NO FLOORPLAN; CP4-1 already applied in the conn: 130 clamps are AND2 in the macro, 16 + 2 pull-downs stay outside
iso_cdr_dn_3 | iso_clamp | pll | conn | 906 | 906 | 906 | 906 | H | iso-placement.json size_um | IN NO FLOORPLAN; CP4-1 already applied in the conn: 130 clamps are AND2 in the macro, 16 + 2 pull-downs stay outside
rx_aux_clk | pt_diff_clk_rx | debug | conn | 22341 | 22341 | 22341 | 22341 | H | scratch/area-pass-4/util.json
rx_wtx_ext | pt_diff_clk_rx | debug | conn | 22341 | 22341 | 22341 | 22341 | H | scratch/area-pass-4/util.json
iso_aux_ck | iso_clamp_x4 | pll | conn | 1025 | 1025 | 1025 | 1025 | H | iso-placement.json | IN NO FLOORPLAN
iso_wtx_dx | iso_clamp | wired_tx | conn | 906 | 906 | 906 | 906 | H | iso-placement.json size_um | IN NO FLOORPLAN; CP4-1 already applied in the conn: 130 clamps are AND2 in the macro, 16 + 2 pull-downs stay outside
ring_osc | pt_ring_osc | debug | conn | 9522 | 9522 | 9522 | 9522 | H | scratch/area-pass-4/util.json
vco_replica | pt_vco_replica | debug | conn | 20941 | 20941 | 20941 | 20941 | H | scratch/area-pass-4/util.json
obs_pre4_wire | pt_obs_pre4 | debug | conn | 3667 | 3667 | 3667 | 3667 | H | scratch/area-pass-4/util.json
obs_pre4_wsmp | pt_obs_pre4 | debug | conn | 3667 | 3667 | 3667 | 3667 | H | scratch/area-pass-4/util.json
obs_pre4_ref | pt_obs_pre4 | debug | conn | 3667 | 3667 | 3667 | 3667 | H | scratch/area-pass-4/util.json
obs_pre4_aux | pt_obs_pre4 | debug | conn | 3667 | 3667 | 3667 | 3667 | H | scratch/area-pass-4/util.json
obs_pre4_pll | pt_obs_pre4 | debug | conn | 3667 | 3667 | 3667 | 3667 | H | scratch/area-pass-4/util.json
obs_pre4_cdr | pt_obs_pre4 | debug | conn | 3667 | 3667 | 3667 | 3667 | H | scratch/area-pass-4/util.json
iso_lo_obs | iso_clamp_x4 | debug | conn | 1025 | 1025 | 1025 | 1025 | H | iso-placement.json | IN NO FLOORPLAN
clk_obs | pt_clk_obs16 | debug | conn | 92036 | 52854 | 52854 | 52854 | M | scratch/area-pass-4/util.json; staged lo-ap4 127.5 x 414.54
pd_clk_obs | iso_pd | core | conn | 95 | 95 | 95 | 95 | H | iso-placement.json | IN NO FLOORPLAN
iso_clk_obs | iso_clamp_x4 | core | conn | 1025 | 1025 | 1025 | 1025 | H | iso-placement.json | IN NO FLOORPLAN
termination | pt_termination | wired_rx | conn | 48249 | 48249 | 48249 | 48249 | H | scratch/area-pass-4/util.json
rxlevel | pt_rxlevel | wired_rx | conn | 13180 | 13180 | 13180 | 13180 | H | scratch/area-pass-4/util.json
ctle | pt_ctle | wired_rx | conn | 133483 | 68676 | 68676 | 68676 | L | scratch/area-pass-4/util.json; staged 194 x 354 (review NO-GO, superseded by the follower redesign r4) | follower booked separately
rxselect | pt_rxselect | wired_rx | conn | 8841 | 8841 | 8841 | 8841 | H | scratch/area-pass-4/util.json
wmon_sel | pt_wmon_sel | wired_rx | conn | 9835 | 9835 | 9835 | 9835 | H | scratch/area-pass-4/util.json
detect | pt_detect | wired_rx | conn | 173480 | 173480 | 90000 | 173480 | H | scratch/area-pass-4/util.json; target AP4-1 (layout-only repack FAILED, needs r7i redesign)
wordclk_rx | pt_wordclk | wired_cap | conn | 24822 | 24822 | 24822 | 24822 | H | scratch/area-pass-4/util.json
vthdac | pt_vthdac | wired_rx | conn | 23891 | 23891 | 23891 | 23891 | H | scratch/area-pass-4/util.json
ptrim | pt_ptrim | wired_cap | conn | 289747 | 25938 | 25938 | 25938 | L | scratch/area-pass-4/util.json (published cell not functional); staged ptrim_compact.py 126.4 x 205.2 of the SAME non-functional circuit | output stage booked separately
slicer | pt_slicer | wired_rx | conn | 109899 | 109899 | 109899 | 109899 | H | scratch/area-pass-4/util.json
wrx_cap | pt_wrx_cap | wired_cap | conn | 956461 | 293813 | 293813 | 293813 | M | scratch/area-pass-4/util.json (r6); staged r7c 1210.55 x 242.71 (NOT publishable: ext_q625_lde60 fails)
wiredtx | pt_wiredtx | wired_tx | conn | 246188 | 246188 | 246188 | 246188 | H | scratch/area-pass-4/util.json (quarter-rate core) | eighth-rate growth booked separately (tx8)
steer_0 | tx_steer | wired_tx | conn | 0 | 0 | 0 | 0 | H | scratch/area-pass-4/util.json | review R6: replaced by the CML pre-drivers booked in tx8_rsv (double count removed)
steer_1 | tx_steer | wired_tx | conn | 0 | 0 | 0 | 0 | H | scratch/area-pass-4/util.json | review R6: replaced by the CML pre-drivers booked in tx8_rsv (double count removed)
steer_2 | tx_steer | wired_tx | conn | 0 | 0 | 0 | 0 | H | scratch/area-pass-4/util.json | review R6: replaced by the CML pre-drivers booked in tx8_rsv (double count removed)
steer_3 | tx_steer | wired_tx | conn | 0 | 0 | 0 | 0 | H | scratch/area-pass-4/util.json | review R6: replaced by the CML pre-drivers booked in tx8_rsv (double count removed)
steer_4 | tx_steer | wired_tx | conn | 8677 | 8677 | 0 | 0 | H | scratch/area-pass-4/util.json | unused today (X5 deletes them: target 0)
steer_5 | tx_steer | wired_tx | conn | 8677 | 8677 | 0 | 0 | H | scratch/area-pass-4/util.json | unused today (X5 deletes them: target 0)
attached_tx_interlock | tx_interlock | wired_tx | conn | 48100 | 48100 | 48100 | 48100 | H | scratch/chip-assembly-v5/run2/abstracts.json
term_buffer | term_buffer | wired_tx | conn | 75196 | 75196 | 45000 | 45000 | H | scratch/area-pass-4/util.json; target AP4-6
txpad_bias | pt_txpad_bias | wired_tx | conn | 12524 | 12524 | 12524 | 12524 | M | scratch/pads-core/bias/pub layout (review R10) | staged, not published (D-TXTERM); in no floorplan
usb_txdrv | pt_usb_txdrv | wired_tx | conn | 31457 | 31457 | 31457 | 31457 | M | USB-INTEGRATION.md l.79: 116.48 x 270.06 (rev 3 not re-reviewed) | IN NO FLOORPLAN
hsbias | pt_wtx_hsbias | wired_tx | conn | 9137 | 9137 | 9137 | 9137 | H | scratch/area-pass-4/util.json
wtx_fallback_control | pt_wtx_fallback_control | wired_tx | conn | 5861 | 5861 | 5861 | 5861 | H | scratch/area-pass-4/util.json
char_atb | pt_char_atb | core | conn | 28239 | 28239 | 28239 | 28239 | H | characterization/generated/char_atb.lef 192.1 x 147.0 | IN NO FLOORPLAN
char_ro33 | pt_char_ro33 | debug | conn | 9698 | 9698 | 9698 | 9698 | H | char_ro33.lef 69.64 x 139.26 | IN NO FLOORPLAN; may duplicate ring_osc (CP4-R4)
char_ro50 | pt_char_ro50 | debug | conn | 9320 | 9320 | 9320 | 9320 | H | char_ro50.lef | IN NO FLOORPLAN
char_cmldiv | pt_char_cmldiv | debug | conn | 27841 | 27841 | 27841 | 27841 | H | char_cmldiv.lef 104.76 x 265.76 | IN NO FLOORPLAN
char_rffet | pt_char_rffet | core | conn | 111800 | 111800 | 111800 | 111800 | H | char_rffet.lef 430 x 260 GSG probe frame | IN NO FLOORPLAN; needs GLASS openings + probe access
char_rffet_open | pt_char_rffet_open | core | conn | 111800 | 111800 | 111800 | 111800 | H | as rffet | IN NO FLOORPLAN
char_rffet_short | pt_char_rffet_short | core | conn | 111800 | 111800 | 111800 | 111800 | H | as rffet | IN NO FLOORPLAN
atb0_leaf1 | atb_leaf_f | core | conn | 1086 | 1086 | 1086 | 1086 | H | scratch/chip-assembly-v5/run2/abstracts.json
atb0_leaf14 | atb_leaf_f | core | conn | 1086 | 1086 | 1086 | 1086 | H | scratch/chip-assembly-v5/run2/abstracts.json
atb0_leaf22 | atb_leaf_f | core | conn | 1086 | 1086 | 1086 | 1086 | H | scratch/chip-assembly-v5/run2/abstracts.json
atb0_leaf29 | atb_leaf_f | core | conn | 1086 | 1086 | 1086 | 1086 | H | scratch/chip-assembly-v5/run2/abstracts.json
atb0_leaf35 | atb_leaf_f | core | conn | 1086 | 1086 | 1086 | 1086 | H | scratch/chip-assembly-v5/run2/abstracts.json
atb0_leaf36 | atb_leaf_f | core | conn | 1086 | 1086 | 1086 | 1086 | H | scratch/chip-assembly-v5/run2/abstracts.json
atb0_leaf55 | atb_leaf_f | core | conn | 1086 | 1086 | 1086 | 1086 | H | scratch/chip-assembly-v5/run2/abstracts.json
atb0_leaf56 | atb_leaf_f | core | conn | 1086 | 1086 | 1086 | 1086 | H | scratch/chip-assembly-v5/run2/abstracts.json
atb0_leaf58 | atb_leaf_f | core | conn | 1086 | 1086 | 1086 | 1086 | H | scratch/chip-assembly-v5/run2/abstracts.json
atb0_grp0 | atb_grp | core | conn | 6145 | 6145 | 6145 | 6145 | H | scratch/chip-assembly-v5/run2/abstracts.json
atb0_leaf43 | atb_leaf_f | core | conn | 1086 | 1086 | 1086 | 1086 | H | scratch/chip-assembly-v5/run2/abstracts.json
atb0_leaf44 | atb_leaf_f | core | conn | 1086 | 1086 | 1086 | 1086 | H | scratch/chip-assembly-v5/run2/abstracts.json
atb0_leaf45 | atb_leaf_f | core | conn | 1086 | 1086 | 1086 | 1086 | H | scratch/chip-assembly-v5/run2/abstracts.json
atb0_leaf46 | atb_leaf_f | core | conn | 1086 | 1086 | 1086 | 1086 | H | scratch/chip-assembly-v5/run2/abstracts.json
atb0_leaf47 | atb_leaf_f | core | conn | 1086 | 1086 | 1086 | 1086 | H | scratch/chip-assembly-v5/run2/abstracts.json
atb0_leaf48 | atb_leaf_f | core | conn | 1086 | 1086 | 1086 | 1086 | H | scratch/chip-assembly-v5/run2/abstracts.json
atb0_leaf49 | atb_leaf_f | core | conn | 1086 | 1086 | 1086 | 1086 | H | scratch/chip-assembly-v5/run2/abstracts.json
atb0_leaf50 | atb_leaf_f | core | conn | 1086 | 1086 | 1086 | 1086 | H | scratch/chip-assembly-v5/run2/abstracts.json
atb0_leaf51 | atb_leaf_f | core | conn | 1086 | 1086 | 1086 | 1086 | H | scratch/chip-assembly-v5/run2/abstracts.json
atb0_leaf52 | atb_leaf_f | core | conn | 1086 | 1086 | 1086 | 1086 | H | scratch/chip-assembly-v5/run2/abstracts.json
atb0_leaf53 | atb_leaf_f | core | conn | 1086 | 1086 | 1086 | 1086 | H | scratch/chip-assembly-v5/run2/abstracts.json
atb0_leaf54 | atb_leaf_f | core | conn | 1086 | 1086 | 1086 | 1086 | H | scratch/chip-assembly-v5/run2/abstracts.json
atb0_grp1 | atb_grp | core | conn | 6145 | 6145 | 6145 | 6145 | H | scratch/chip-assembly-v5/run2/abstracts.json
atb0_pad | atb_pad | core | conn | 6626 | 6626 | 6626 | 6626 | H | scratch/chip-assembly-v5/run2/abstracts.json
atb0_io | atb_provider_pad | chip | conn | 0 | 0 | 0 | 0 | H | provider ring
atb1_leaf1 | atb_leaf_s | core | conn | 827 | 827 | 827 | 827 | H | scratch/chip-assembly-v5/run2/abstracts.json
atb1_leaf2 | atb_leaf_s | core | conn | 827 | 827 | 827 | 827 | H | scratch/chip-assembly-v5/run2/abstracts.json
atb1_leaf3 | atb_leaf_s | core | conn | 827 | 827 | 827 | 827 | H | scratch/chip-assembly-v5/run2/abstracts.json
atb1_leaf4 | atb_leaf_s | core | conn | 827 | 827 | 827 | 827 | H | scratch/chip-assembly-v5/run2/abstracts.json
atb1_leaf5 | atb_leaf_s | core | conn | 827 | 827 | 827 | 827 | H | scratch/chip-assembly-v5/run2/abstracts.json
atb1_leaf6 | atb_leaf_s | core | conn | 827 | 827 | 827 | 827 | H | scratch/chip-assembly-v5/run2/abstracts.json
atb1_leaf7 | atb_leaf_s | core | conn | 827 | 827 | 827 | 827 | H | scratch/chip-assembly-v5/run2/abstracts.json
atb1_leaf8 | atb_leaf_s | core | conn | 827 | 827 | 827 | 827 | H | scratch/chip-assembly-v5/run2/abstracts.json
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
atb1_leaf38 | atb_leaf_s | core | conn | 827 | 827 | 827 | 827 | H | scratch/chip-assembly-v5/run2/abstracts.json
atb1_leaf39 | atb_leaf_s | core | conn | 827 | 827 | 827 | 827 | H | scratch/chip-assembly-v5/run2/abstracts.json
atb1_leaf47 | atb_leaf_s | core | conn | 827 | 827 | 827 | 827 | H | scratch/chip-assembly-v5/run2/abstracts.json
atb1_leaf48 | atb_leaf_s | core | conn | 827 | 827 | 827 | 827 | H | scratch/chip-assembly-v5/run2/abstracts.json
atb1_grp3 | atb_grp | core | conn | 6145 | 6145 | 6145 | 6145 | H | scratch/chip-assembly-v5/run2/abstracts.json
atb1_leaf42 | atb_leaf_s | core | conn | 827 | 827 | 827 | 827 | H | scratch/chip-assembly-v5/run2/abstracts.json
atb1_leaf45 | atb_leaf_s | core | conn | 827 | 827 | 827 | 827 | H | scratch/chip-assembly-v5/run2/abstracts.json
atb1_leaf46 | atb_leaf_s | core | conn | 827 | 827 | 827 | 827 | H | scratch/chip-assembly-v5/run2/abstracts.json
atb1_leaf49 | atb_leaf_s | core | conn | 827 | 827 | 827 | 827 | H | scratch/chip-assembly-v5/run2/abstracts.json
atb1_leaf50 | atb_leaf_s | core | conn | 827 | 827 | 827 | 827 | H | scratch/chip-assembly-v5/run2/abstracts.json
atb1_leaf51 | atb_leaf_s | core | conn | 827 | 827 | 827 | 827 | H | scratch/chip-assembly-v5/run2/abstracts.json
atb1_leaf52 | atb_leaf_s | core | conn | 827 | 827 | 827 | 827 | H | scratch/chip-assembly-v5/run2/abstracts.json
atb1_leaf53 | atb_leaf_s | core | conn | 827 | 827 | 827 | 827 | H | scratch/chip-assembly-v5/run2/abstracts.json
atb1_leaf54 | atb_leaf_s | core | conn | 827 | 827 | 827 | 827 | H | scratch/chip-assembly-v5/run2/abstracts.json
atb1_leaf55 | atb_leaf_s | core | conn | 827 | 827 | 827 | 827 | H | scratch/chip-assembly-v5/run2/abstracts.json
atb1_leaf56 | atb_leaf_s | core | conn | 827 | 827 | 827 | 827 | H | scratch/chip-assembly-v5/run2/abstracts.json
atb1_leaf57 | atb_leaf_s | core | conn | 827 | 827 | 827 | 827 | H | scratch/chip-assembly-v5/run2/abstracts.json
atb1_grp4 | atb_grp | core | conn | 6145 | 6145 | 6145 | 6145 | H | scratch/chip-assembly-v5/run2/abstracts.json
atb1_pad | atb_pad | core | conn | 6626 | 6626 | 6626 | 6626 | H | scratch/chip-assembly-v5/run2/abstracts.json
atb1_io | atb_provider_pad | chip | conn | 0 | 0 | 0 | 0 | H | provider ring
r8arch_slicer_b | (booked) | - | booked | 109899 | 109899 | 109899 | 109899 | M | second slicer bank = pt_slicer outline (AP4 s1 lever 3) | R8-ARCH; not in pt_chip.conn
r8arch_capture_b | (booked) | - | booked | 956461 | 293813 | 293813 | 293813 | M | second capture = the capture master of the scenario | R8-ARCH; v6 booked it at 0.29 on a master that is still not publishable; literal published master is r6
r8arch_blend_pd8 | (booked) | - | booked | 35000 | 35000 | 35000 | 35000 | L | AP4 s1 lever 3 estimate | R8-ARCH
r8arch_ctle_follower_b | (booked) | - | booked | 5000 | 5000 | 5000 | 5000 | L | wired_rx README Resume 9: one follower per slicer bank, 0.003-0.005 | R8-ARCH; in no floorplan
ctle_follower | (booked) | - | booked | 5000 | 5000 | 5000 | 5000 | L | wired_rx README Resume 9 (MW-13-FIX approved): 0.003-0.005 mm2 | NEVER BUILT; in no floorplan
ptrim_output_stage | (booked) | - | booked | 15000 | 15000 | 15000 | 15000 | L | estimate: 8 ch x (mid 4/8->12/24, out 8/16->32/64) + CKP0 buffer or doubled channel 0 on the 26k compact cell | NEVER BUILT (MW-14-FIX); in no floorplan
tx8_rsv | (booked) | - | booked | 200250 | 222000 | 222000 | 222000 | L | pub = AP4-2 booking 450 x 445; staged = serq8 as built 0.352 (INTEGRATION.md s7) - serq4c 0.158 + 2 CML pre-drivers 0.028 | eighth-rate / CML not demonstrated (ss 3.24 Gb/s fails): reserve; booking was exceeded
wtx_tcoil_rsv | (booked) | - | booked | 68400 | 68400 | 68400 | 68400 | M | v5 floorplan rsv_tcoil_wire_tx 570 x 120 | spiral keep-out
d2h_gearbox_rsv | (booked) | - | booked | 31495 | 31495 | 31495 | 31495 | M | v5 floorplan rsv_d2h_gearbox 1312.3 x 24 | W7-GEAR; edge strip
decap_macro_edge_bank | (booked) | - | booked | 390000 | 390000 | 390000 | 390000 | M | spec/power-delivery.md s4.2: 1.5 nF, within 250 um of the macro W/S/E edges | PD2-9; IN NO FLOORPLAN
supply_clock_monitor | (booked) | - | booked | 5000 | 5000 | 5000 | 5000 | L | review R11: pt_monitor exists as RTL in the macro; outside remain a time base for RF modes and an H2D_CLK present detector | D-FAULT
lna_additions | (booked) | - | booked | 10000 | 10000 | 10000 | 10000 | L | review R12 allowance: LNA tail source, gate R, common-mode damping; D-EXTCLK selector; D-CDRCTL FLL driver | counted by nobody
vcm_buffer | (booked) | - | booked | 3000 | 3000 | 3000 | 3000 | L | estimate (CNV-06: VCM source is a bare 40k divider) | counted by nobody
fwd_clk_repeaters | (booked) | - | booked | 3000 | 3000 | 3000 | 3000 | L | estimate: repeaters/shield for the 3.1 mm AUX_CLK -> wired forwarded clock (CP4-3) | counted by nobody
