deepai-org/svalbard/scratch/reviews/consolidation-pass-4/inventory.md

# Inventory by master (generated by inventory.py from pt_chip.conn)

346 instances, 83 masters. Area = outline (pads: core intrusion). mA = nominal, sum over instances.

| master | class | n | um2 each | mm2 total | mA total | ctl pins | modes | area source |
|---|---|---:|---:|---:|---:|---:|---|---|
| pt_digital_macro | digital | 1 | 2814000 | 2.8140 | 72.10 | 0 | all | report-v6 digital_mm2 |
| pt_wrx_cap | deserializer | 1 | 956461 | 0.9565 | 44.78 | 9 | W U E | area-pass-4 util.json outline |
| pad_rf_pair | pad | 6 | 146008 | 0.8760 | 0.00 | 0 | RX DX; T(fwd clk) W-fallback; TX DX; W-fallback; dbg/fallback RX | core intrusion 310 x (913-442) |
| pt_adc_q | converter | 1 | 577785 | 0.5778 | 5.73 | 6 | RX DX | area-pass-4 util.json outline |
| pt_adc_i | converter | 1 | 577710 | 0.5777 | 5.73 | 6 | RX DX | area-pass-4 util.json outline |
| pt_lc_qvco5 | oscillator | 1 | 532476 | 0.5325 | 26.50 | 7 | RXa TXa DXa | area-pass-4 util.json outline |
| pad_wirepad | pad | 1 | 517406 | 0.5174 | 18.20 | 14 | U | core intrusion 521 x (1435-442) |
| pad_refpad | pad | 2 | 188939 | 0.3779 | 0.00 | 0 | RXe/TXe (LO_Q) / aux; all (REF or LO_I) | core intrusion 401 x (913-442) |
| pad_txpad | pad | 1 | 377623 | 0.3776 | 0.00 | 0 | W T E | core intrusion 481 x (1227-442) |
| pt_lo_mmd | divider | 1 | 361116 | 0.3611 | 26.30 | 7 | RXa TXa DXa | area-pass-4 util.json outline |
| pt_bbfilter_i | baseband | 1 | 341901 | 0.3419 | 5.22 | 36 | RX DX (+TX recon TDD) | area-pass-4 util.json outline |
| pt_bbfilter_q | baseband | 1 | 341901 | 0.3419 | 5.22 | 36 | RX DX (+TX recon TDD) | area-pass-4 util.json outline |
| pad_hspad | pad | 1 | 319902 | 0.3199 | 0.00 | 0 | W E | core intrusion 478 x (1111-442) |
| pt_core_bias | bias/ref/monitor | 1 | 301799 | 0.3018 | 0.40 | 74 | all | v5 abstract bbox |
| pt_ptrim | clock trim | 1 | 289747 | 0.2897 | 18.00 | 40 | W U E | area-pass-4 util.json outline |
| pad_single_leg | pad (debug) | 2 | 142307 | 0.2846 | 0.00 | 0 | char; dbg W U | core intrusion 302 x (913-442) |
| pt_wiredtx | serializer | 1 | 246188 | 0.2462 | 35.30 | 21 | W T E | area-pass-4 util.json outline |
| pt_lo_lf | PLL | 1 | 194122 | 0.1941 | 0.00 | 0 | RXa TXa DXa | area-pass-4 util.json outline |
| pt_dac_i | converter | 1 | 186115 | 0.1861 | 2.07 | 2 | TX DX | area-pass-4 util.json outline |
| pt_dac_q | converter | 1 | 186115 | 0.1861 | 2.07 | 2 | TX DX | area-pass-4 util.json outline |
| pt_detect | detector | 1 | 173480 | 0.1735 | 2.31 | 7 | W U | area-pass-4 util.json outline |
| pt_pll_vreg2 | regulator | 1 | 173424 | 0.1734 | 0.60 | 2 | W U T E (+host_follow) | area-pass-4 util.json outline |
| pt_pll_ring | oscillator | 1 | 166657 | 0.1667 | 6.94 | 9 | W U E (+host_follow RF) | area-pass-4 util.json outline |
| pt_lo_ext | LO | 1 | 155350 | 0.1553 | 11.30 | 3 | RX TX DX | area-pass-4 util.json outline |
| pt_ctle | baseband | 1 | 133483 | 0.1335 | 11.20 | 8 | W E | area-pass-4 util.json outline |
| pt_lo_pfdcp | PLL | 1 | 124110 | 0.1241 | 1.00 | 4 | RXa TXa DXa | area-pass-4 util.json outline |
| iso_clamp | isolation | 131 | 906 | 0.1187 | 0.00 | 0 | all | iso-placement.json size_um |
| pt_refbuf | bias/ref/monitor | 1 | 117089 | 0.1171 | 1.56 | 2 | RX TX DX | area-pass-4 util.json outline |
| pt_slicer | sampler | 1 | 109899 | 0.1099 | 7.25 | 89 | W U E | area-pass-4 util.json outline |
| pt_rfdriver | RF | 1 | 96812 | 0.0968 | 58.40 | 8 | TX DX | area-pass-4 util.json outline |
| pt_lna_ind | RF passive | 2 | 48400 | 0.0968 | 0.00 | 0 | RX DX | RF RX note: 220 um tank coil (est) |
| pt_clk_obs16 | debug mux | 1 | 92036 | 0.0920 | 4.96 | 8 | dbg | area-pass-4 util.json outline |
| pt_diff_clk_rx | clock rx | 4 | 22341 | 0.0894 | 13.96 | 1 | T W-fallback; W U T E RXa; W-fallback; dbg / aux ref | area-pass-4 util.json outline |
| pt_pll_ring_core | oscillator | 1 | 86020 | 0.0860 | 6.94 | 4 | W U T E | area-pass-4 util.json outline |
| pt_cdr | PLL | 1 | 82880 | 0.0829 | 0.40 | 8 | W U E | r13 published (SESSION-STATE) |
| pt_lo_vreg | regulator | 1 | 81500 | 0.0815 | 0.50 | 1 | RXa TXa DXa | est: half of pll_vreg2 (one regulator, 25 mA) |
| term_buffer | termination | 1 | 75196 | 0.0752 | 1.00 | 0 | W T E | area-pass-4 util.json outline |
| isw_wired | island switch | 1 | 64081 | 0.0641 | 0.00 | 0 | all | v5 abstract bbox |
| pt_bb_tap | debug tap | 3 | 19511 | 0.0585 | 3.00 | 5 | dbg W U; dbg/fallback RX | area-pass-4 util.json outline |
| isw_pll | island switch | 1 | 53259 | 0.0533 | 0.00 | 0 | all | v5 abstract bbox |
| tx_steer | pad driver | 6 | 8677 | 0.0521 | 0.00 | 0 | W T E (4,5 unused) | area-pass-4 util.json outline |
| isw_rf | island switch | 1 | 49817 | 0.0498 | 0.00 | 0 | all | v5 abstract bbox |
| pt_termination | termination | 1 | 48249 | 0.0482 | 1.25 | 9 | W U E | area-pass-4 util.json outline |
| tx_interlock | control | 1 | 48100 | 0.0481 | 0.00 | 4 | W T E U | v5 abstract bbox |
| atb_leaf_s | ATB | 58 | 827 | 0.0480 | 0.00 | 0 | dbg | v5 abstract bbox |
| atb_grp | ATB | 7 | 6145 | 0.0430 | 0.00 | 0 | dbg | v5 abstract bbox |
| pt_polyphase | test structure | 1 | 39028 | 0.0390 | 2.80 | 0 | none (tied off, D-POLY) | area-pass-4 util.json outline |
| pt_prescale | divider | 3 | 12600 | 0.0378 | 5.97 | 15 | all (per instance, see D-CLK) | area-pass-4 util.json outline |
| isw_debug | island switch | 1 | 36922 | 0.0369 | 0.00 | 0 | all | v5 abstract bbox |
| pt_rxmix_i | RF | 1 | 35442 | 0.0354 | 3.01 | 8 | RX DX | area-pass-4 util.json outline |
| pt_rxmix_q | RF | 1 | 35442 | 0.0354 | 3.01 | 8 | RX DX | area-pass-4 util.json outline |
| pt_lo_obs | debug tap | 2 | 17428 | 0.0349 | 1.00 | 1 | dbg RXa | area-pass-4 util.json outline |
| pt_lo_mmd_qdum | divider (dummy) | 1 | 34062 | 0.0341 | 8.00 | 1 | RXa TXa DXa | area-pass-4 util.json outline |
| isw_conv | island switch | 1 | 31781 | 0.0318 | 0.00 | 0 | all | v5 abstract bbox |
| pt_lna_deg | RF passive | 2 | 14400 | 0.0288 | 0.00 | 0 | RX DX | est: 0.47 nH spiral |
| pt_obs_pre4 | divider | 7 | 3667 | 0.0257 | 7.00 | 7 | dbg | area-pass-4 util.json outline |
| pt_wordclk | divider | 1 | 24822 | 0.0248 | 2.30 | 3 | W U E | area-pass-4 util.json outline |
| pt_lna | RF | 1 | 24763 | 0.0248 | 18.90 | 15 | RX DX | area-pass-4 util.json outline |
| pt_vthdac | small DAC | 1 | 23891 | 0.0239 | 0.53 | 17 | E (W optional) | area-pass-4 util.json outline |
| atb_leaf_f | ATB | 21 | 1086 | 0.0228 | 0.00 | 0 | dbg | v5 abstract bbox |
| pt_txmix_i | RF | 1 | 21424 | 0.0214 | 1.00 | 3 | TX DX | area-pass-4 util.json outline |
| pt_txmix_q | RF | 1 | 21424 | 0.0214 | 1.00 | 3 | TX DX | area-pass-4 util.json outline |
| pt_vco_replica | oscillator (monitor) | 1 | 20941 | 0.0209 | 6.00 | 1 | dbg | area-pass-4 util.json outline |
| iso_clamp_x4 | isolation | 16 | 1025 | 0.0164 | 0.00 | 0 | all | iso-placement.json size_um |
| pt_clockmux | clock | 1 | 15161 | 0.0152 | 1.35 | 16 | all | area-pass-4 util.json outline |
| atb_pad | ATB | 2 | 6626 | 0.0133 | 0.00 | 0 | dbg | v5 abstract bbox |
| pt_rxlevel | bias/ref/monitor | 1 | 13180 | 0.0132 | 0.03 | 2 | W U E | area-pass-4 util.json outline |
| pt_aosc | oscillator | 1 | 12864 | 0.0129 | 0.38 | 1 | all | area-pass-4 util.json outline |
| pt_wmon_sel | debug mux | 1 | 9835 | 0.0098 | 0.00 | 3 | dbg W U | area-pass-4 util.json outline |
| pt_ring_osc | oscillator (monitor) | 1 | 9522 | 0.0095 | 1.00 | 1 | dbg / supply trim readout | area-pass-4 util.json outline |
| por | bias/ref/monitor | 1 | 9469 | 0.0095 | 0.01 | 0 | all | v5 abstract bbox |
| pt_wtx_hsbias | bias/ref/monitor | 1 | 9137 | 0.0091 | 0.30 | 9 | U | area-pass-4 util.json outline |
| pt_bias_ext | bias/ref/monitor | 1 | 9000 | 0.0090 | 0.03 | 3 | RXa W U | est: 3 bank outputs (bank3 = 4210-8964 um2) |
| pt_rxselect | mux | 1 | 8841 | 0.0088 | 2.00 | 2 | W U E | area-pass-4 util.json outline |
| pt_wtx_fallback_control | control | 1 | 5861 | 0.0059 | 0.00 | 7 | W-fallback | area-pass-4 util.json outline |
| pt_txsum | RF | 1 | 3988 | 0.0040 | 2.01 | 1 | TX DX | area-pass-4 util.json outline |
| pt_refvcm | bias/ref/monitor | 1 | 3000 | 0.0030 | 0.05 | 1 | RX TX | est |
| pt_txpad_bias | bias/ref/monitor | 1 | 3000 | 0.0030 | 0.10 | 0 | W T E | est |
| iso_pd | isolation | 6 | 95 | 0.0006 | 0.00 | 1 | all; dbg | iso-placement.json size_um |
| pt_host_physical | provider pad | 1 | 0 | 0.0000 | 0.00 | 0 | all | provider pad ring |
| pt_debug_physical | provider pad | 1 | 0 | 0.0000 | 0.00 | 0 | all | provider pad ring |
| pad_strap | provider pad | 1 | 0 | 0.0000 | 0.00 | 0 | all | provider pad site |
| atb_provider_pad | provider pad | 2 | 0 | 0.0000 | 0.00 | 0 | all | provider pad ring |

Total (digital macro and pad intrusion included): 13.742 mm2

## By function class

| class | instances | mm2 | mA nominal (all on, not a mode) |
|---|---:|---:|---:|
| digital | 1 | 2.814 | 72.1 |
| pad | 7 | 1.885 | 18.2 |
| converter | 4 | 1.528 | 15.6 |
| deserializer | 1 | 0.956 | 44.8 |
| baseband | 3 | 0.817 | 21.6 |
| oscillator | 4 | 0.798 | 40.8 |
| bias/ref/monitor | 8 | 0.466 | 2.5 |
| divider | 12 | 0.449 | 41.6 |
| pad (debug) | 3 | 0.434 | 0.0 |
| PLL | 3 | 0.401 | 1.4 |
| pad (fallback) | 2 | 0.292 | 0.0 |
| clock trim | 1 | 0.290 | 18.0 |
| regulator | 2 | 0.255 | 1.1 |
| serializer | 1 | 0.246 | 35.3 |
| RF | 7 | 0.239 | 87.3 |
| island switch | 5 | 0.236 | 0.0 |
| test structure | 2 | 0.181 | 2.8 |
| detector | 1 | 0.173 | 2.3 |
| LO | 1 | 0.155 | 11.3 |
| isolation | 153 | 0.136 | 0.0 |
| ATB | 88 | 0.127 | 0.0 |
| RF passive | 4 | 0.126 | 0.0 |
| termination | 2 | 0.123 | 2.2 |
| sampler | 1 | 0.110 | 7.2 |
| debug mux | 2 | 0.102 | 5.0 |
| debug tap | 5 | 0.093 | 4.0 |
| clock rx | 4 | 0.089 | 14.0 |
| control | 2 | 0.054 | 0.0 |
| pad driver | 6 | 0.052 | 0.0 |
| divider (dummy) | 1 | 0.034 | 8.0 |
| oscillator (monitor) | 2 | 0.030 | 7.0 |
| small DAC | 1 | 0.024 | 0.5 |
| clock | 1 | 0.015 | 1.4 |
| mux | 1 | 0.009 | 2.0 |
| provider pad | 5 | 0.000 | 0.0 |

## Masters instanced more than once (mechanical duplicate list)

| master | n | mm2 total | instances |
|---|---:|---:|---|
| pad_rf_pair | 6 | 0.8760 | pad_rf_rx pad_rf_tx pad_bb_i pad_bb_q pad_wclk_in pad_wtx_ext |
| pad_refpad | 2 | 0.3779 | pad_ref pad_aux_clk |
| pad_single_leg | 2 | 0.2846 | pad_wmon pad_tlp |
| iso_clamp | 131 | 0.1187 | iso_adc_i_0 iso_adc_i_1 iso_adc_i_2 iso_adc_i_3 ... iso_wrx_slm iso_wtx_ext_data |
| pt_lna_ind | 2 | 0.0968 | lna_ind_p lna_ind_n |
| pt_diff_clk_rx | 4 | 0.0894 | rx_ref_in rx_aux_clk rx_wclk_in rx_wtx_ext |
| pt_bb_tap | 3 | 0.0585 | bb_tap_i bb_tap_q bb_tap_wmon |
| tx_steer | 6 | 0.0521 | steer_0 steer_1 steer_2 steer_3 steer_4 steer_5 |
| atb_leaf_s | 58 | 0.0480 | atb1_leaf1 atb1_leaf2 atb1_leaf3 atb1_leaf4 ... atb1_leaf56 atb1_leaf57 |
| atb_grp | 7 | 0.0430 | atb0_grp0 atb0_grp1 atb1_grp0 atb1_grp1 atb1_grp2 atb1_grp3 atb1_grp4 |
| pt_prescale | 3 | 0.0378 | prescale prescale_conv prescale_hf |
| pt_lo_obs | 2 | 0.0349 | lo_obs lo_obs_q |
| pt_lna_deg | 2 | 0.0288 | lna_deg_p lna_deg_n |
| pt_obs_pre4 | 7 | 0.0257 | obs_pre4_wire obs_pre4_wsmp obs_pre4_ref obs_pre4_aux obs_pre4_wclk obs_pre4_pll obs_pre4_cdr |
| atb_leaf_f | 21 | 0.0228 | atb0_leaf1 atb0_leaf14 atb0_leaf22 atb0_leaf29 ... atb0_leaf53 atb0_leaf54 |
| iso_clamp_x4 | 16 | 0.0164 | iso_conv_clk iso_rf_rx_clk iso_rf_tx_clk iso_lo_fb ... iso_wrx_clk iso_wire_tx_clk |
| atb_pad | 2 | 0.0133 | atb0_pad atb1_pad |
| iso_pd | 6 | 0.0006 | iso_wmon iso_lo_ip iso_lo_in iso_lo_qp iso_lo_qn pd_clk_obs |
| atb_provider_pad | 2 | 0.0000 | atb0_io atb1_io |

## Instances with tied-off inputs or no-connect outputs (partially used hardware)

| inst | master | pins | tied to VSS or open | which |
|---|---|---:|---:|---|
| digital | pt_digital_macro | 407 | 54 | rf_rx_sample[0]=VSS rf_rx_sample[1]=VSS rf_rx_sample[12]=VSS rf_rx_sample[13]=VSS rf_rx_sample_b[0]=VSS rf_rx_sample_b[1]=VSS rf_rx_sample_b[12]=VSS rf_rx_sample_b[13]=VSS rf_tx_sample[0]>- rf_tx_sample[1]>- rf_tx_sample[12]>- rf_tx_sample[13]>- island_en[3]>- |
| por | por | 6 | 2 | por>- por_unbuf~- |
| core_bias | pt_core_bias | 122 | 4 | BIAS_lc_vco_reserved~- VGEN_SOURCE~- VGEN_SINK1~- VGEN_SINK2~- |
| pad_wire_tx | pad_txpad | 19 | 4 | TMDS_P=VSS TMDS_N=VSS TMDS_BIAS~VSS ATB_ESD_RAIL~- |
| rxmix_q | pt_rxmix_q | 20 | 2 | atb_vcm~- atb_vbp~- |
| bbfilter_q | pt_bbfilter_q | 54 | 2 | atb_vcm~- atb_vbp~- |
| bb_tap_wmon | pt_bb_tap | 13 | 6 | in_n~VSS pad_n~- inj_p~- inj_n~- inj_en=VSS atb_nbias~- |
| txmix_q | pt_txmix_q | 16 | 2 | atb_bias~- atb_tail~- |
| rfdriver | pt_rfdriver | 18 | 2 | atb_pre~- atb_cm~- |
| qvco | pt_lc_qvco5 | 19 | 3 | PRE>- ATB_VTUNE~- ATB_ITAIL~- |
| lo_mmd_qdum | pt_lo_mmd_qdum | 7 | 2 | QDP>- QDN>- |
| lo_obs_q | pt_lo_obs | 6 | 2 | EN=VSS OBS>- |
| polyphase | pt_polyphase | 10 | 8 | INP~VSS INN~VSS EN=VSS LOI_IP>- LOI_QP>- LOI_IN>- LOI_QN>- ATB_N0~- |
| rx_ref_in | pt_diff_clk_rx | 10 | 3 | SE=VSS OUTP>- ATB_DET~- |
| wordclk | pt_wordclk | 10 | 3 | WORD_CLK>- LD>- LDB>- |
| pll_vreg2 | pt_pll_vreg2 | 8 | 2 | ATB_OUT~- ATB_G~- |
| pll_tx | pt_pll_ring_core | 21 | 5 | HOLD=VSS PH3>- PH5>- PH7>- REFO>- |
| rx_aux_clk | pt_diff_clk_rx | 10 | 3 | SE=VSS OUTN>- ATB_DET~- |
| rx_wclk_in | pt_diff_clk_rx | 10 | 3 | SE=VSS OUTN>- ATB_DET~- |
| rx_wtx_ext | pt_diff_clk_rx | 10 | 3 | SE=VSS OUTP>- ATB_DET~- |
| clk_obs | pt_clk_obs16 | 29 | 4 | IN0=VSS IN15A=VSS IN15B=VSS IN15C=VSS |
| wrx_cap | pt_wrx_cap | 119 | 20 | DW0>- DW1>- DW2>- DW3>- DW4>- DW5>- DW6>- DW7>- DW8>- DW9>- DW10>- DW11>- DW12>- DW13>- DW14>- DW15>- DW16>- DW17>- DW18>- DW19>- |
| wiredtx | pt_wiredtx | 83 | 2 | WORD_CLK>- ATB_PBIAS~- |
| steer_4 | tx_steer | 4 | 2 | IN=VSS OUT>- |
| steer_5 | tx_steer | 4 | 2 | IN=VSS OUT>- |
| attached_tx_interlock | tx_interlock | 17 | 4 | REQ_TMDS=VSS CONFLICT>- VALID>- EN_TMDS>- |
