deepai-org/svalbard/scratch/integration/m1-pdn/out/e5_steps.txt

none                   opt  macro: dig-enable static   3.1 under    0.3 over    0.3 | both static   5.4 under    1.4 over    1.4 || core_bias both under    3.9 over    3.9 | rfdrv 1.2us under  0.00 static   4.9 (qvco tap) abrupt under   0.0
none                   nom  macro: dig-enable static  12.3 under    1.4 over    1.4 | both static  16.2 under    0.1 over    0.0 || core_bias both under    9.8 over    9.8 | rfdrv 1.2us under  0.00 static   7.2 (qvco tap) abrupt under   0.0
none                   pess macro: dig-enable static  28.3 under    3.3 over    3.3 | both static  32.0 under    1.7 over    1.7 || core_bias both under   15.3 over   15.3 | rfdrv 1.2us under  0.00 static  11.6 (qvco tap) abrupt under   0.0
3nF_spread             opt  macro: dig-enable static   3.1 under    0.5 over    0.5 | both static   5.4 under    3.2 over    3.2 || core_bias both under    6.3 over    6.3 | rfdrv 1.2us under  0.00 static   4.9 (qvco tap) abrupt under   0.0
3nF_spread             nom  macro: dig-enable static  12.3 under    2.0 over    2.0 | both static  16.2 under    4.0 over    4.0 || core_bias both under   15.9 over   15.9 | rfdrv 1.2us under  0.00 static   7.2 (qvco tap) abrupt under   0.0
3nF_spread             pess macro: dig-enable static  28.3 under    4.4 over    4.4 | both static  32.0 under    2.3 over    2.4 || core_bias both under   22.7 over   22.7 | rfdrv 1.2us under  0.00 static  11.6 (qvco tap) abrupt under   0.0
ap49_low               opt  macro: dig-enable static   3.1 under    0.5 over    0.5 | both static   5.4 under    3.0 over    3.0 || core_bias both under    6.0 over    6.0 | rfdrv 1.2us under  0.00 static   4.9 (qvco tap) abrupt under   0.0
ap49_low               nom  macro: dig-enable static  12.3 under    2.2 over    2.2 | both static  16.2 under    3.8 over    3.8 || core_bias both under   15.7 over   15.7 | rfdrv 1.2us under  0.00 static   7.2 (qvco tap) abrupt under   0.0
ap49_low               pess macro: dig-enable static  28.3 under    4.8 over    4.8 | both static  32.0 under    4.4 over    4.4 || core_bias both under   22.3 over   22.3 | rfdrv 1.2us under  0.00 static  11.6 (qvco tap) abrupt under   0.0
ap49_low+1.5nF_macro   opt  macro: dig-enable static   3.1 under    0.4 over    0.4 | both static   5.4 under    3.2 over    3.2 || core_bias both under    6.2 over    6.2 | rfdrv 1.2us under  0.00 static   4.9 (qvco tap) abrupt under   0.0
ap49_low+1.5nF_macro   nom  macro: dig-enable static  12.3 under    1.7 over    1.7 | both static  16.2 under    3.9 over    3.9 || core_bias both under   15.5 over   15.5 | rfdrv 1.2us under  0.00 static   7.2 (qvco tap) abrupt under   0.0
ap49_low+1.5nF_macro   pess macro: dig-enable static  28.3 under    3.9 over    4.0 | both static  32.0 under    1.5 over    1.5 || core_bias both under   21.4 over   21.5 | rfdrv 1.2us under  0.00 static  11.6 (qvco tap) abrupt under   0.0
