deepai-org/svalbard/scratch/reviews/always-on-audit/bias2/en_step_wave.txt

 time            v(vbg)          v(root_ref)     i(vdd)         
 0.00000000e+00 -8.56734826e-28  1.56081392e-18  3.28219903e-31 
 2.00000000e-09  3.25443891e-04  4.82198087e-04 -1.36641772e-06 
 4.00000000e-09  6.41781558e-04  9.64410905e-04 -1.37421415e-06 
 8.00000000e-09  1.25343175e-03  1.92888115e-03 -1.38356045e-06 
 1.60000000e-08  2.38343676e-03  3.85799956e-03 -1.39553472e-06 
 3.20000000e-08  4.31299791e-03  7.71695024e-03 -1.41185774e-06 
 6.40000000e-08  7.16182085e-03  1.54377148e-02 -1.43354444e-06 
 1.28000000e-07  1.03672302e-02  3.08906665e-02 -1.45983020e-06 
 2.56000000e-07  1.24812970e-02  6.18415478e-02 -1.48266675e-06 
 4.03973251e-07  1.25352783e-02  9.76944135e-02 -1.48765380e-06 
 6.03973251e-07  1.20615477e-02  1.46269943e-01 -1.48402806e-06 
 8.03973251e-07  1.17302859e-02  1.94969345e-01 -1.47852142e-06 
 1.00397325e-06  1.15479809e-02  2.43773442e-01 -1.47683581e-06 
 1.20397325e-06  1.14252554e-02  2.92634823e-01 -1.49560806e-06 
 1.40397325e-06  1.13201672e-02  3.41411867e-01 -1.59347046e-06 
 1.60397325e-06  1.12419446e-02  3.89731078e-01 -1.83635372e-06 
 1.73687300e-06  1.09736761e-02  4.21419983e-01 -2.35498171e-06 
 1.89457027e-06  1.27570932e-02  4.57331504e-01 -3.44466506e-06 
 2.00669579e-06  1.70144330e-02  4.80756231e-01 -1.90279172e-06 
 2.12585810e-06  2.52955623e-02  5.01043901e-01 -2.47254737e-06 
 2.23339430e-06  3.86930122e-02  5.04777782e-01 -3.67872734e-06 
 2.32431263e-06  5.64198056e-02  4.93597495e-01 -5.79732728e-06 
 2.37836589e-06  7.10857603e-02  5.02783636e-01 -8.39139385e-06 
 2.43993199e-06  9.16318201e-02  5.31109355e-01 -6.54274670e-06 
 2.47902717e-06  1.06879647e-01  5.41577928e-01 -5.36211026e-06 
 2.52373110e-06  1.26396737e-01  5.46760915e-01 -6.25251963e-06 
 2.57708062e-06  1.52048374e-01  5.50211953e-01 -7.59089587e-06 
 2.61705099e-06  1.71958570e-01  5.52269193e-01 -8.31076663e-06 
 2.65916946e-06  1.93453144e-01  5.54175482e-01 -8.98966887e-06 
 2.71900326e-06  2.23336662e-01  5.56417393e-01 -9.91592806e-06 
 2.78700783e-06  2.39730968e-01  5.58410446e-01 -1.06693782e-05 
 2.86351511e-06  2.26231787e-01  5.60135966e-01 -1.10932794e-05 
 2.94893042e-06  1.97132120e-01  5.61660619e-01 -1.15170357e-05 
 3.06235398e-06  1.60281548e-01  5.63388221e-01 -1.22852664e-05 
 3.16743720e-06  1.34227431e-01  5.64759886e-01 -1.31088927e-05 
 3.18515641e-06  1.30763505e-01  5.64967676e-01 -1.32561599e-05 
 3.22059482e-06  1.24447399e-01  5.65369878e-01 -1.35447482e-05 
 3.29147163e-06  1.13798060e-01  5.66118947e-01 -1.41271458e-05 
 3.30919084e-06  1.11572675e-01  5.66293008e-01 -1.42768734e-05 
 3.34462925e-06  1.07388228e-01  5.66627137e-01 -1.45833267e-05 
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
