deepai-org/svalbard/projects/programmable_transceiver_platform/analog/pads/generated/custom-assembly-candidate.png

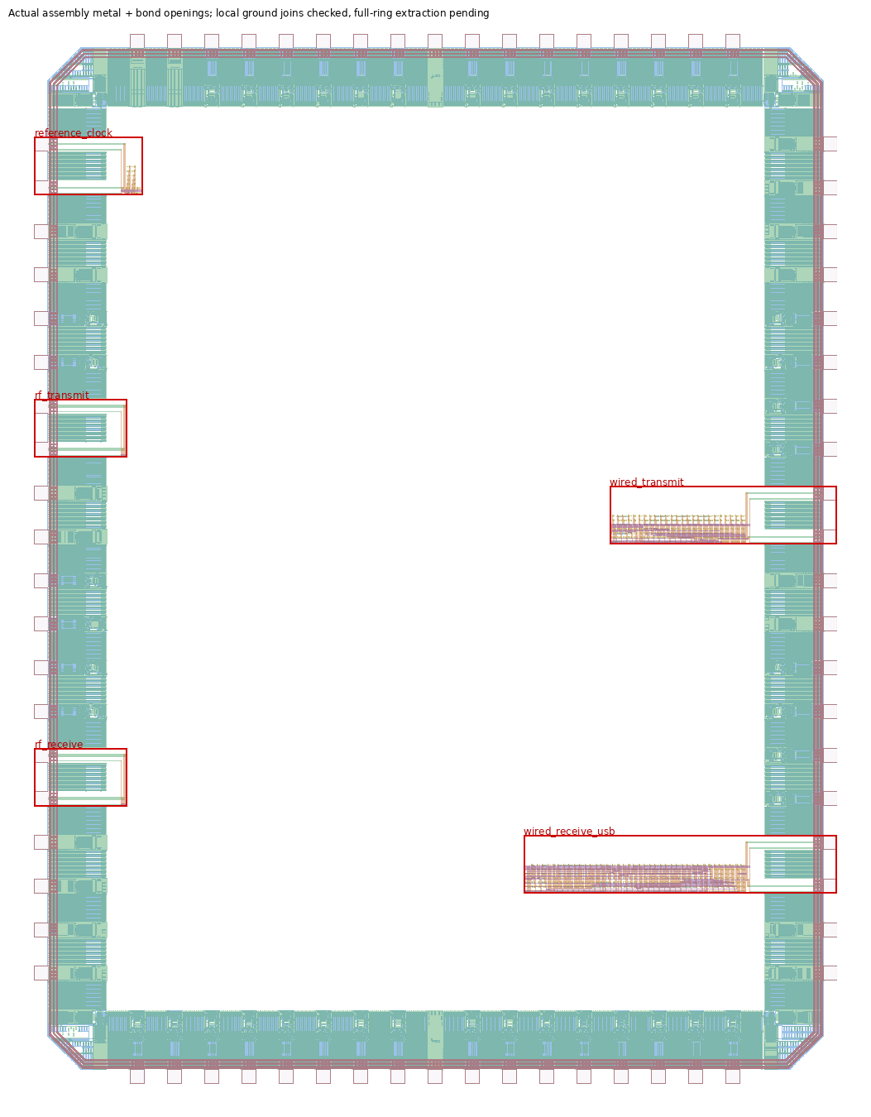
projects/programmable_transceiver_platform/analog/pads/generated/custom-assembly-candidate.png
