deepai-org/svalbard/projects/programmable_transceiver_platform/analog/pads/generated/custom-assembly-wired-rx.png

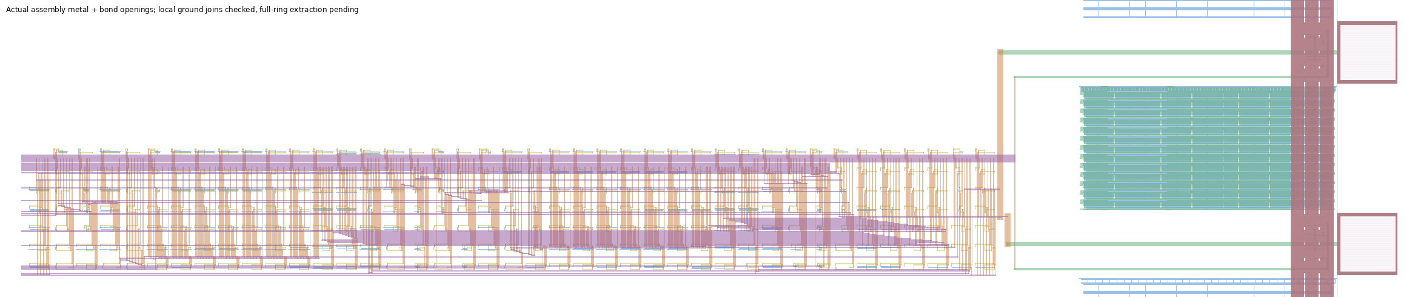
projects/programmable_transceiver_platform/analog/pads/generated/custom-assembly-wired-rx.png
