deepai-org/svalbard/projects/programmable_transceiver_platform/docs/images/chip-assembly-2026-11-10-v3.png

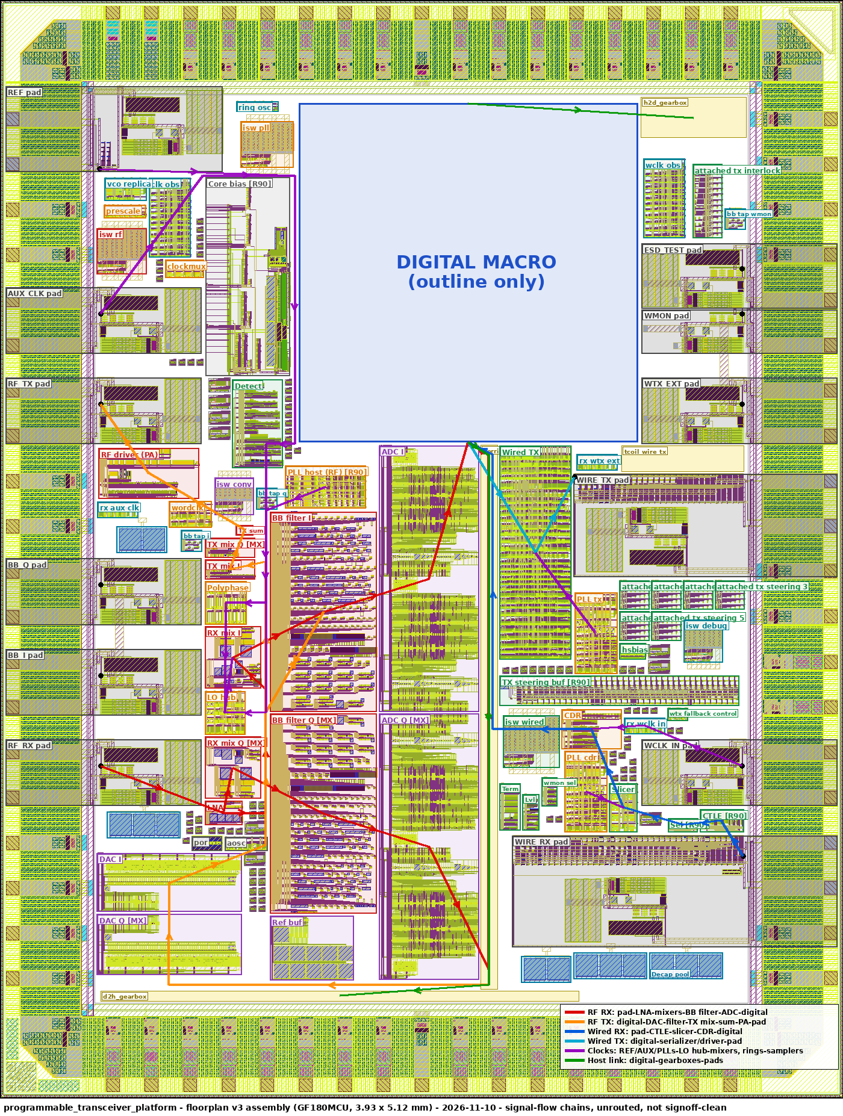
projects/programmable_transceiver_platform/docs/images/chip-assembly-2026-11-10-v3.png
