deepai-org/svalbard/projects/programmable_transceiver_platform/docs/images/chip-assembly-2026-11-11-v5.png

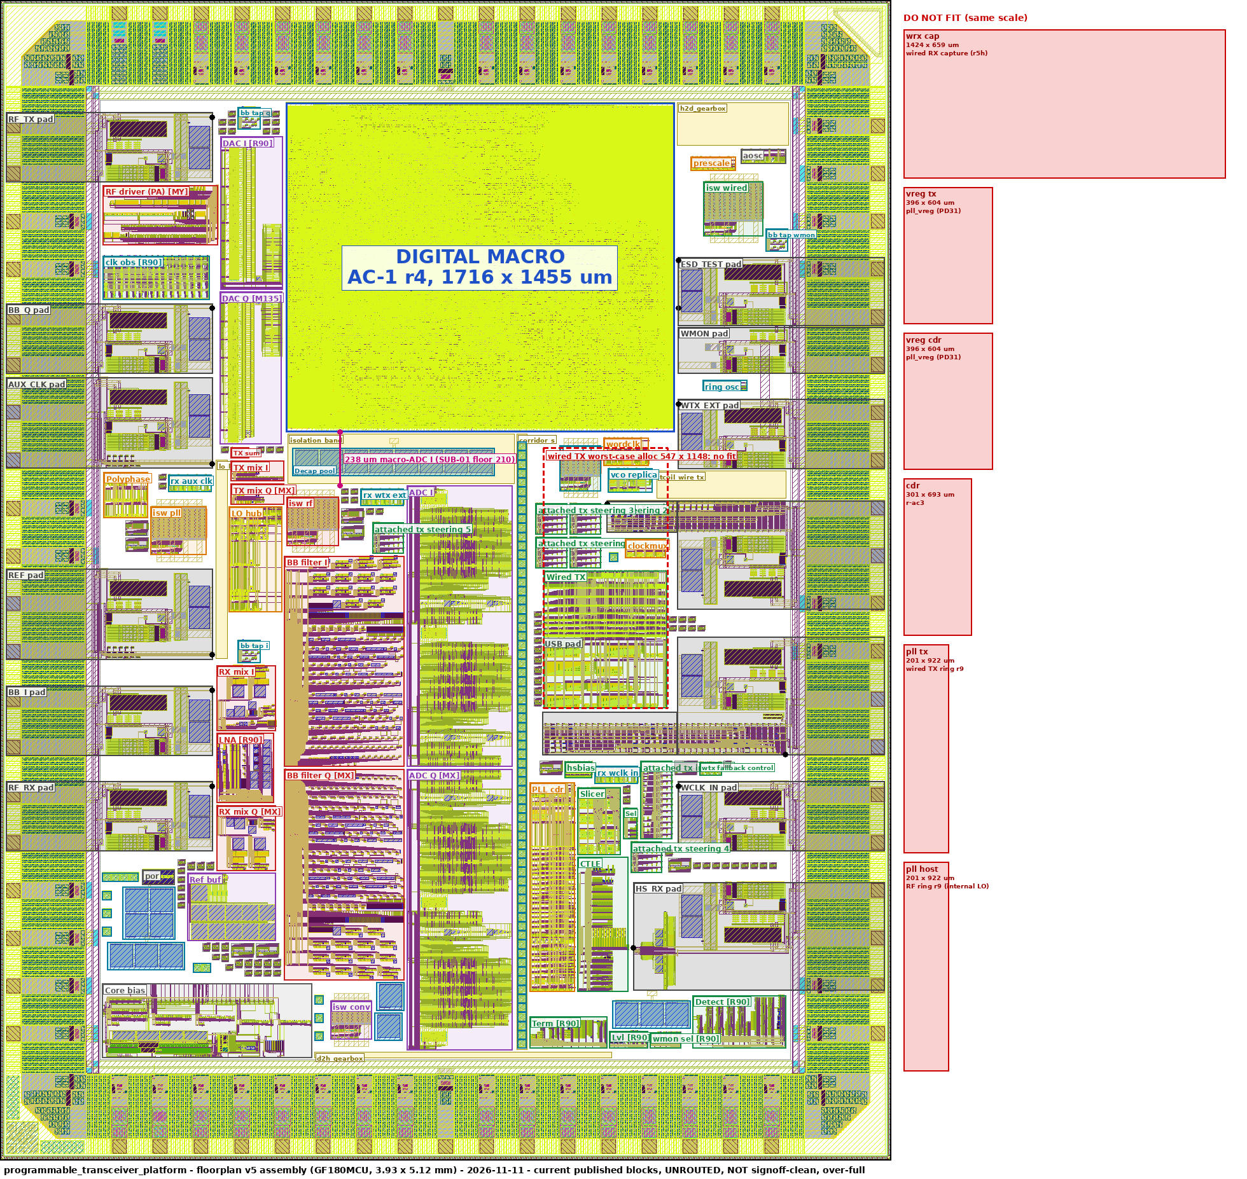
projects/programmable_transceiver_platform/docs/images/chip-assembly-2026-11-11-v5.png
