deepai-org/svalbard/docs/verification/pcie-analog-status.md

# PCIe Gen1 analog status

This is a living engineering inventory, not a compliance or tapeout claim.
“Physically closed” below means generated layout, zero Magic DRC errors, unique
Netgen LVS, and full-RC simulation against the block's declared public-model
contract. It does not include provider signoff, selected pads/package, or
measured silicon.

The current rate/delay evidence and remaining model-validity boundary are
tracked separately in [PCIe Gen1 analog speed checkpoint](pcie-analog-speed-budget.md).
The top-down component, assumption, power and sequencing audit is recorded in
[PCIe Gen1 architecture checkpoint](pcie-architecture-checkpoint.md).

| Function | Current evidence | Next boundary |
|---|---|---|
| CML transmitter | Physically closed with calibrated PVT, robustness, noise, PRBS, and bounded statistical recovery | Pad/ESD/package/channel, emphasis integration, EM/IR/post-fill |
| Differential termination | Physically closed with calibrated PVT and large-signal linearity | Pad/package/channel co-simulation and calibration circuit |
| Receiver amplifier | Physically closed with bandwidth, threshold, transient, and noise matrices | Termination/pad/channel composition and offset-calibration implementation |
| Dual-edge CDR sampler | Physically closed with PVT, aperture, stress, and supply-injection evidence | Clock-tree loading, mismatch/metastability, integrated extraction |
| Alexander boundary | Physically closed with PVT and fixed-code stress | Retiming and loop-filter interface |
| Integrated Alexander front end | Schematic 9/9; calibrated composition of extracted sampler/detector/combiner replays 36/36 across 9/9 environments | Hierarchical interconnect, valid-window retimer, acquisition/tracking loop |
| Dual-interleave phase-error combiner | Physically closed; standalone extracted 108/108 and composed extracted replay 36/36 | Vote retiming, accumulator/integrator, PI control encoding, closed-loop dynamics |
| Programmable CDR error slicer | Matching-hardened physical layout; schematic and full-RC 972/972, 9/9 calibrated with interior codes, 62.33 ps worst selected delay | Deck-driven density/fill and bias-noise study; CML-to-CMOS retiming, accumulator, composed closed-loop dynamics |
| Phase interpolator + dual 5-bit control DAC | Both physically closed; composed full-RC 2,367/2,367 and 9/9 calibrated to 31 codes with 2.80 ps worst error | Calibration controller/storage, glitch-safe updates, clock-tree/sampler composition, jitter/supply coupling |
| Recovered-clock rail converter | A symmetric regenerative CML-to-CMOS converter is zero-DRC, uniquely LVS-matched, and 540R/267C full-RC extracted. Its standalone exact-PEX matrix passes 5/5 environments into 100 fF/output. Exact extracted PI/restorer/converter composition covers 5/5 environments; nominal 1.15/1.15 V codes pass four environments, while SS/hot has adjacent converter codes at 1.00/1.05 V with 1.30 V restorer bias and a second passing restorer code at 1.15 V. | Realize the programmable delay/non-overlap pulse network, drive the actual regenerative clock gates, then close mismatch/noise, PDN/substrate aggression, EM/IR, fill, and electrothermal effects. |
| Dual-edge sense/event generator | The state-free replacement passes 18/40 schematic cases over 5/5 environments and has a 152-device, 303.7-um zero-DRC, unique-LVS, 4,062R/2,943C parent. Proxy exact PEX is 1/10 and direct exact event/lane composition is 0/2. A schematic local buffer closes TT, but physical extraction falsifies that result. Four bounded tapers localize source loading versus pulse propagation. Retained v4 is 184 devices, 356.0 um, zero-DRC, unique-LVS, and 6,252R/4,521C; it preserves front-end/capture behavior but is 0/2. TT narrowly misses SENSE rails; slow/hot SENSE reaches the buffer source but not its consumer. Exact history is [recorded with the probe](../../ip/blocks/analog/wireline_serdes/clock_pulse_hclk_window_probe/README.md). | Specify and synthesize a composed SENSE assertion-duration budget; re-lower physically, then require TT/slow-hot and eventually 5/5 exact PEX. |
| Local complementary capture-clock bridge | The physical WRITE-to-complementary-clock consumer is zero-DRC, uniquely LVS-matched, and full-RC extracted (96 raw fingers, 898R/560C). Its exact PEX, driving the exact independently clocked capture PEX, passes 5/5 public-model corners with a 200 ps WRITE stimulus, correct alternating capture polarity, rails within 250 mV of supplies, at most 118.66 ps signed complementary skew, and at most 18.5 mA average current. The limiting SS/125 C, 2.97 V positive clocks are 2.787/2.760 V; this is a local gate with only 40 mV margin to the deliberately conservative 2.72 V rail screen. A 30-case schematic pull-up sweep against the exact capture PEX confirms that baseline and 2x final-PMOS options pass all five cases but 3x and above regress skew; it rejects bridge-output enlargement as a remedy for the composed FF/cold loss. The extracted bridge is not the primary FF/cold input-load cause: with the pulse leaf's standard SENSE/BOOST load it yields 3.374/3.387 V WRITE, versus 3.184/3.204 V for the old 650 fF WRITE placeholder. | Requalify it only after its producer and the actual direct-regenerative SENSE/BOOST load pass together; preserve the current local 5/5 result as an isolated consumer claim. |
| Event → fanout → direct-regenerative capture boundary | The promoted parallel-output receiver remains zero-DRC, unique-LVS, parameter-audited and 389R/172C extracted with 5/5 nominal calibration. The v7 parent is zero-DRC, unique-LVS and 16,426R/10,423C extracted but ten-sample TT PRBS has no passing latency. Exact waveform/consumer replay proves nonlinear StrongARM gate loading dominates the lumped 190 fF estimate. A deterministic role compiler lowers a stronger SENSE variant that is independently zero-DRC, unique-LVS and 472R/229C extracted. Joint bias/reference calibration covers 4/5 environments. Authoritative parent sampling measures 283 ps below reference at TT and only 218 ps at SS/125 C. Direct-CMOS and asynchronous storage candidates are bounded rejections. The replacement partition removes the level receivers and lowers six branch leaves while preserving screened full-duty V7 ratios. A compact 72-um dummy-phase pitch is zero-DRC, property-clean unique-LVS and full-RC extracted: sampler 994R/665C, capture 272R/168C. Exact six-leaf PEX composition with the extracted event and lane passes TT and SS/hot; the limiting SS/hot low-valid interval is 169.2 ps, 19.2 ps over contract, with at least 2.806 V held differential. Exact pin inspection proves a whole branch still overlaps the receiver banks at the consumer landing. | Split sampler 6x/16x predrivers from 32x finals and capture 4x predrivers from 8x finals; place only finals at consumer gates, then extract the parent once and preserve the 19.2 ps slow/hot route budget before five-PVT and PRBS gates. |
| CML-to-CMOS boundary | The original programmable-tail converter is zero-DRC, uniquely LVS-matched, and 2,048R/1,340C full-RC extracted, but its 700--900 ps useful window cannot serve a 400 ps serial UI reliably. The 190 x 160 um StrongARM-style replacement is zero-DRC, uniquely LVS-matched, and 2,087R/1,256C full-RC extracted. All 10/10 targeted exact-PEX environments pass with 510.34 mV minimum fixed-point logic margin and 9.592 mA maximum current. A separate exact-PEX data-age grid proves that previous data is retained through 500 ps, all three limiting environments resolve new data by 760 ps, and all exceed 150 mV margin by 770 ps in the 800 ps lane cycle. The selected receiver now removes the intervening restorer and level-sensitive sampler and places two independently clocked StrongARM cells directly on the routed RX output. | Realize the non-overlapping pulse generator and controls, then close noise/mismatch, metastability tails, extracted PDN/substrate, fill, and reliability. |
| 1:2 deserializer | The original shared-clock cell remains physically closed, but full-lane composition showed that opposite-edge sampler decisions do not share a safe conversion window. Its 190 by 122 um independently clocked replacement is zero-DRC, uniquely LVS-matched, and retapered to 1,957R/1,400C. With per-lane event-relative scoring and independent sense/write timing, the revised cell now passes the representative 2.5-GT/s five-environment combined-stress composition. | Statistical hold/metastability, extracted aggressors, routed-parent extraction, and post-fill extraction |
| PLL/VCO/divider | The dual-edge architecture requires a 1.25 GHz oscillator. A checked minimum-subset search selects the `fast` and `gain` split-control parents from three independently 0-DRC, unique-LVS, full-RC candidates. The physical dual 5-bit DAC uses a 2.0 V reference and passes 160/160 DC plus 5/5 settling cases. The selected two-DAC/two-VCO/high-gain-selector parent is zero-DRC, uniquely LVS-matched, and full-RC extracted with 3,872 resistors and 1,287 capacitors. Its exact PEX passes 4/7 nominal candidates, 10/35 PVT candidates covering 5/5 environments, break-before-make handoff, and 55/55 VDD/reference-ripple cases with 8.59 ps worst cycle displacement and 0.467% worst median-frequency pushing. A symmetric static-CML divide-by-two is zero-DRC, uniquely LVS-matched, extracts to 510R/193C, and passes 19/25 standalone post-layout bias cases. Direct VCO-to-divider composition exposed the need for a two-stage CML restorer. The final routed VCO-bank/restorer/divider parent is zero-DRC, uniquely LVS-matched, extracts to 4,766R/1,580C, and passes 43/50 exact-PEX calibration candidates covering 5/5 environments, with five consecutive passing divider-bias points in every environment, at least +0.585/-0.468 V restored rails, no more than 0.509% divide-ratio error, and no more than 3.151% VCO loading shift. The 2.5 GHz overspeed experiment remains failed falsification evidence | Implement the remaining reference ratio and realizable calibration controls, then close statistical startup/mismatch, phase noise, combined PDN/aggressor stress, and the PLL loop |
| Serializer/TX | The standalone 2:1 CML mux remains a zero-DRC, unique-LVS, 267R/85C test structure, but arbitrary changing words falsified its high-capacitance TX boundary. The original clock-steered parent remains preserved and passes both rates. A separately versioned 2.5-GT/s parent uses a minimum-length tail and eight realizable nonlinear load branches per side; it is zero-DRC, uniquely LVS-matched, 1,506R/945C full-RC extracted, and supplies at least 103.180 mV pin margin in the limiting combined-stress case. | Add realizable bias/control generation, package/pad/channel EM, mismatch, and simultaneous substrate/PDN aggression |
| Externally clocked lane spine | At 1.25 GBd, the exact TX/termination/RX/restorer/sampler/converter/capture stack passes 5/5 environments and 160/160 PRBS bits under simultaneous bounded channel, jitter, duty, and rail-ripple stress. At 2.5 GT/s, the 7,900R/4,804C externally clocked parent passes 5/5 representative environments over 24-bit PRBS7. The earlier PI-clocked fast-converter parent remains zero-DRC, unique-LVS, and 8,717R/4,874C full-RC extracted, but its SS/hot mixed-data-age failure is retained as falsification evidence. The replacement direct-regenerative RX/capture parent removes two bandwidth-limiting stages, is zero-DRC, unique-LVS, and 7,108R/4,348C full-RC extracted. With a 150 ps non-overlapping write pulse it passes 5/5 exact-parent environments over 24-bit PRBS7 under 6 ohm/leg + 1 pF channel, 30 ps jitter, 47% duty, and 20 mV rail ripple, with one common two-UI final latency. Worst PVT margins are 104.038 mV at the pin, 92.541 mV at the actual sampler input, 2.37717 V at the capture write point, and 2.54706 V at the held output; a separate SS/hot run passes 5/5 offsets over 0--200 ps. | Compose the phase interpolator/clock restorer with the replacement data path, realize the pulse generator and bias controls, then add mismatch/noise/metastability, package/pad/channel EM, substrate/PDN aggression, fill, EM/IR, and provider signoff models. |
| PCIe receiver detect/electrical idle | Not implemented | Pad-aware circuits, safe clamps, protocol-visible controls |
| Shared bias/reference/control DACs | Dual 5-bit DAC physically closed for PI control and separately qualified as a VCO main/regenerative bias primitive across five environments; top-level references and distribution are not implemented | Bandgap/reference choice, two-instance VCO-bank distribution, calibration observables and retained codes |
| Analog top, pads, PDN, package/channel | Not implemented. The repository floorplan render is a proposal assembled from leaf dimensions, not a placed, routed, DRC/LVS/PEX-verified parent. | Hierarchical integration, selected qualified I/O, EM/IR, coupling, post-fill and provider precheck |

At this checkpoint, most reusable signal-path leaf experiments exist and are
physically extracted, but the full interface is not close to tapeout-ready.
A reasonable planning estimate is roughly 70--80% of reusable leaf-circuit
development, 40--50% of a functioning integrated PCIe analog interface, and
less than 20% of tapeout/signoff evidence. These ranges deliberately count
PLL/autonomous-CDR closure, PCIe-specific detect/idle behavior, pads/package,
serializer and end-to-end lane composition, power reconciliation, and
analog-top verification as major work rather than treating them as wiring.

## Critical path

1. Complete the routed parent's weak-level boundary. The v5 parent and its new
   receivers are physically closed, but exact PRBS proves that standalone
   voltage/PVT coverage omitted the routed pulse-duration/source-impedance
   contract. Measure that envelope, requalify the receiver, and require TT PRBS
   with one common data age before PVT expansion and recovered-clock composition.
2. Complete upstream clock and
   bias distribution, local decoupling, and the
   consumer of the 750-ps parallel-output-valid boundary. Reconcile power.
3. Add valid-window retiming, a realizable accumulator/integrator, and a
   calibration controller for the closed phase-interpolator DAC; demonstrate
   reference-assisted tracking.
4. Freeze the external reference and power budget, then close the PLL ratio,
   PFD/charge-pump/filter loop, statistical startup/mismatch, phase noise,
   combined PDN/aggressor sensitivity, bypass and lock observability.
5. Add receiver detect, electrical idle, shared bias/reference generation,
   control DACs, calibration state/observables, and safe reset clamps.
6. Assemble the analog top and re-run hierarchical/flattened DRC/LVS/PEX with
   clock, supply, substrate, thermal, and simultaneous-switching coupling.
7. Select pad/ESD/package/channel models and complete post-fill, EM/IR,
   reliability, provider-qualified variation, independent correlation, and
   immutable release-candidate evidence.
