deepai-org/svalbard/docs/verification/pcie-analog-speed-budget.md

# PCIe Gen1 analog speed checkpoint

The Gen1 line rate is 2.5 GT/s: one UI is 400 ps and the NRZ Nyquist frequency
is 1.25 GHz. This checkpoint records circuit-level public-model evidence; it is
not an end-to-end timing or model-validity claim.

| Path | Full-RC evidence | Present interpretation |
|---|---|---|
| TX core | 17.0--26.8 ps crossing at 2.5 GT/s; nominal stress through 3.125 GT/s; 6.03 GHz nominal bandwidth | Core switching is not the present limiter; pads/package/channel remain absent |
| Integrated half-rate serializer/TX | Zero-DRC, unique-LVS 1,081R/614C parent passes 35/35 changing-word aperture cases in 5/5 environments at 1.25 and 2.5 GT/s; 0.5289654 V worst 2.5 GT/s signed center margin with at least 60 ps setup/hold | Eliminates the failed standalone mux-to-large-gate boundary; clock jitter/duty distortion, mismatch and pad/channel loading remain |
| Externally clocked 1.25 GBd lane | The exact TX/termination/RX/sampler/converter/capture path includes a dedicated 0-DRC, unique-LVS, 366R/92C data restorer and the retapered 1,957R/1,400C capture cell. One exact stack passes 5/5 environments and 160/160 scored PRBS bits under simultaneous 6-ohm/leg + 1-pF RC channel stress, 30-ps peak jitter, 47% duty, and 20-mV/100-MHz rail ripple. Worst restored and final margins are 230.118 mV and 2.80740 V. | Bounded low-loss full path; mismatch, extracted aggressors, and selected pad/package/S-parameter models remain |
| Externally clocked 2.5 GT/s lane | The routed hierarchy now includes termination, RX, calibrated limiter, sampler, both CML-to-CMOS converters, split capture, and all intervening data/capture-clock routes in one zero-DRC, unique-LVS, 7,900R/4,804C parent. Its exact PEX passes 5/5 representative environments under combined 6-ohm/leg + 1-pF channel, 30-ps jitter, 47% duty, and 20-mV rail-ripple stress. Worst pin, raw-RX, restored, converter, and final margins are 104.176 mV, 47.052 mV, 209.582 mV, 558.084 mV, and 623.576 mV at 52.203 mA maximum. Final output is valid by 750 ps, leaving 50 ps before the next 800 ps same-interleave event. The original 1/5 pre-calibration result remains preserved as failure provenance. | The core receive data path is physically composed through capture. Mismatch/metastability, realized upstream clock/bias trees, extracted PDN/substrate aggression, recovered clock, and selected I/O remain open. |
| PI-clocked 2.5 GT/s lane | The fast-converter hierarchy routes the PI, two-stage clock restorer, termination, RX, limiter, sampler, both converters, and split capture in one zero-DRC, unique-LVS 8,717R/4,874C parent. Its exact PEX passes 4/5 representative 24-bit combined-stress environments; the limiting passing final margin is 685.201 mV in FF/hot, with 22.95 mV sampler overshoot inside a 50 mV bound. SS/hot remains failed because even and odd lanes carry the requested word at different integer data ages. The 2,087R/1,256C converter leaf itself passes 10/10 fixed-point cases, but its data-age grid resolves new data only by 760 ps and reaches 150 mV margin by 770 ps of an 800 ps lane cycle. | Input loading and routed composition are now measured. The remaining speed boundary is an explicit retimer or acquisition/write reschedule that creates one non-overlapping common data age in SS/hot; selecting separate lane latencies is not a valid closure. |
| RX amplifier | 108.53 ps worst crossing; 2.138--3.355 GHz selected high-mode bandwidth | Leaves about 91 ps from worst core crossing to a nominal 200 ps eye center before pad/channel/jitter allocation |
| Dual-edge sampler | 2.5 GT/s decisions; common qualified transition displacement includes -80 to +80 ps | Demonstrates a useful aperture, not metastability-tail probability |
| Phase interpolator + control DAC | 1.25 GHz PI; composed full-RC 2,367/2,367, 9/9 environments, 199.65--217.35 ps span, 2.80 ps worst calibrated error | DAC 1.21 ns worst carry settling is a slow-loop update bound; clock-tree and supply-jitter composition remain |
| CDR error slicer | Matching-hardened 62.33 ps worst selected full-RC assertion delay; 972/972 extracted cases complete and 9/9 environments calibrate with interior codes | 0.6% slower than the sparse predecessor and still far below its 300 ps local target; retiming and closed-loop dynamics remain absent |
| TX-to-parallel receive boundary | Extracted CML-to-CMOS and deserializer composition closes its 18 representative cases | Does not yet include RX amplifier, channel, recovered clock, or protocol timing |
| Autonomous clock source | A minimum-subset proof selects two complete 1.25 GHz split-control folded parents. The routed two-DAC/two-VCO/high-gain-selector parent is independently 0-DRC, unique-LVS, and full-RC extracted; realizable 2.0 V-reference codes close 10/35 exact-parent cases and all 5/5 environments with three codes of selected rail headroom. Its live handoff passes from 1.2575 to 1.2452 GHz with 3.46 mV dead-interval residue. A 55/55-case VDD/reference-ripple matrix measures 8.59 ps worst baseline-relative cycle displacement, 16.96 ps worst cycle peak-to-peak variation, and 0.467% worst median-frequency pushing. The routed VCO-bank/restorer/divider parent is 0-DRC, unique-LVS, full-RC extracted to 4,766R/1,580C, and its exact PEX passes 43/50 candidates and 5/5 environments with five consecutive divider-bias settings per environment, 0.509% worst divide-ratio error, and 3.151% worst VCO loading shift. The older twelve-parent 2.5 GHz experiment remains failed falsification evidence | Deterministic complete-parent range, selection, shutdown, handoff, isolated-rail pushing, divider loading, regeneration, and first divide-by-two are closed. Statistical startup/mismatch, phase noise, combined PDN/aggressor stress, realizable calibration control, remaining reference ratio, and closed PLL remain unclosed |

The immediate speed gate is extracted composition, not a generic transistor
frequency estimate. Schematic-calibrated sampler/detector phase settings failed
four of nine environments after all three CDR cells were extracted together;
edge-phase recalibration alone closes six. Targeted sampler-bias plus phase
recalibration recovers the other three, and a separate selected-code replay
passes all 36 environment/offset cases with 151.8 mV minimum signed error. The
flow retains a failure if no legal settings cover every declared offset.

The next CDR boundary now has direct extracted speed evidence as well. Its
programmable window slicer rejects 40 mV-or-smaller errors, asserts uniquely at
150 mV and above, and selects only codes interior to both searched bias ranges.
The matching-hardened 62.33 ps worst selected delay is 15.6% of one 400 ps UI; this does not yet
include the following retimer, accumulator, or clock tree.  The PI-control DAC
is now extracted and composed with the PI: 31 retained phase codes calibrate in
all nine mixed environments with 2.80 ps worst placement error.  Its 1.21 ns
worst full-carry settling time constrains code-update cadence, not the 400 ps UI
signal path.

Before analog-top freeze, add the selected pad/ESD/package/channel, extracted
clock tree, serializer and PLL/VCO/divider; then close eye/BER, acquisition,
jitter, supply injection and simultaneous TX/RX activity. Provider confirmation
of the model's high-frequency validity remains separate from a SPICE pass.
