deepai-org/svalbard/projects/programmable_transceiver_platform/spec/performance-requirements.md

# Performance requirements traceability

Rendered from `spec/performance-requirements.json` by `spec/check_performance_requirements.py --write-md`. Do not edit by hand.
Status uses the performance-review legend (meets / marginal / fails / unverified), envelope only (Tj 22–32 °C, 3.15–3.35 V, all process corners).
Per MANDATE.md the **primary fix** is the plan; fallbacks are backups.

Summary: meets 4, marginal 12, fails 39, unverified 87 (total 142).

| ID | Requirement | Owner | Evidence | Status | Basis | Primary fix | Fallback (backup) |
|---|---|---|---|---|---|---|---|
| HL-RATE | 312.5 Mb/s per pin, 10+1 pins/direction; framed wired rates at host word clock = line/8 | digital/hostio | `evidence/digital-hardening-evidence.json` | **fails** | hword fmax 65.3 MHz tt (stale, 18/26 sources) | AC-1 pad-edge gearbox + 40-bit/78.125 MHz core; divider 8 (interface-changes S1-S3) | `debug.host_link.rate div2/div4` |
| HL-CORE | Core closes 78.125 MHz x 40 b and wired boundary line/40 across envelope | digital | `evidence/digital-hardening-evidence.json` | **fails** | wtx/wrx 53.5/63.8 MHz tt at 20-bit boundary; no in-envelope Liberty | AC-1; in-envelope STA | `debug.host_link.rate div2/div4` |
| HL-D2H-MARGIN | D2H eye margin >= 0.15 UI at every in-envelope corner | digital/hostio + board | `evidence/digital-hardening-evidence.json` | **unverified** | Budget margin 1140 ps on assumptions; FPGA not chosen; SSO unverified | Select FPGA (board-requirements.md host-link section); board SI + SSO sim | `HL-B6` |
| HL-H2D-MARGIN | H2D capture margin >= 0.15 UI in envelope | hostio | `evidence/digital-hardening-evidence.json` | **marginal** | 612 ps tt pad-limited; in-envelope ss input f_max missing (ss_125C non-gating) | Characterize bi_24t input at 22/32 C x 3.15/3.35 V | `HL-B6` |
| HL-SSO | Ground bounce <= 300 mV with 11 D2H outputs switching | hostio + board | — | **unverified** | supply-path simulations incomplete (evidence/supply-path-incomplete.json) | Tractable bank SSO sim; board HL-B4 | `HL-B6` |
| HL-LATENCY | Command/response <= 400 ns (USB HS turnaround) | digital | `spec/streaming-transport-v2.md` | **unverified** | 342 ns model at full clock only; ~2.4x slower at achieved clocks | Re-run after AC-1 (+25.6 ns gearbox) | — |
| PWR-DIG-WIRED | Digital macro <= 60 mA in wired/USB modes (SAIF-based) | digital | `evidence/digital-hardening-evidence.json`<br>`spec/budgets/power-budget.json` | **fails** | Only post-route number: 0.684 W vectorless = 207 mA | Clock gating + AC-1 half-rate core; SAIF power | — |
| PWR-DIG-RF | Digital macro <= 40 mA in RF modes | digital | `evidence/digital-hardening-evidence.json`<br>`spec/budgets/power-budget.json` | **fails** | as above | as above | — |
| PWR-HOST-RF | RF modes run the host link at div2 (D2H always); exception: H2D full rate for GX-2 80 MS/s 12-bit TX, with D2H <= div2 (needs HB-4), else MODE8 at div2 | digital (recipe) | `spec/budgets/power-budget.json` | **unverified** | recipe change only | Set default RF recipe | — |
| PWR-MODE-CEIL | Every primary mode within its current ceiling (240 RF / 292 wired-USB) | spec (power) | `spec/budgets/power-budget.json` | **marginal** | Allocation: all fit except autonomous RF; evidence bound: all over by 110-208 mA; with PWR-DIG: +13.6 mA min margin | PWR-DIG-*, PWR-HOST-RF | — |
| PWR-DROP | Rail >= 3.15 V at die: total drop <= 117 mV | spec (power) + integration | `spec/budgets/power-budget.json`<br>`analog/island_support/evidence.json` | **marginal** | 81.1 mV with PWR-DIG (+35.9 mV); evidence bound -1.3 mV; grid R is an allocation | Extract ring/grid; PWR-DIG; island edge-bar straps | `B2a` |
| PWR-THERM | Tj 22-32 C over stopped-to-max mode step | board + spec | `spec/budgets/power-budget.json` | **unverified** | theta(j->plate) <= 8.25 C/W required; COB theta not characterized | B2a controlled plate | `B2a` |
| WR-PCIE-BER | 2.5 GT/s BER 1e-12 at 95 % CL (3.0e12 bits) | wired_rx + wired_tx + digital | `analog/wired_rx/generated/cdr-evidence.json` | **fails** | CDR tracking fails extracted; wrx_cap fails >480 MHz; digital caps ~1.07 Gb/s | AC-3 CDR closure + AC-1 | `wire_rx_board_retimer`, `wire_board_phy_bypass`, `B13`, `B15` |
| WR-PCIE-JTOL | 2.5 GT/s jitter tolerance mask per standard | wired_rx + timing | `analog/wired_rx/generated/cdr-evidence.json` | **unverified** | no JTOL evidence; ring phase error 9-10.8 deg | AC-3 per-UI Alexander PD, phase trim (S4/S5) | `wire_rx_board_retimer`, `wire_board_phy_bypass`, `B13`, `B15` |
| WR-PCIE-PPM | 2.5 GT/s ppm offset + SSC | wired_rx (cdr) | `analog/wired_rx/generated/cdr-rtl-check.json` | **unverified** | FLL locks -6000..+1000 ppm in behavioural model only; hand-over drift 5883 ppm extracted | AC-3 continuous integral path | `wire_rx_board_retimer`, `wire_board_phy_bypass`, `B13`, `B15` |
| WR-SATA-BER | 1.5 Gb/s BER 1e-12 at 95 % CL (3.0e12 bits) | wired_rx + wired_tx + digital | `analog/wired_rx/generated/cdr-evidence.json` | **fails** | CDR tracking fails extracted; wrx_cap fails >480 MHz; digital caps ~1.07 Gb/s | AC-3 CDR closure + AC-1 | `wire_rx_board_retimer`, `B13` |
| WR-SATA-JTOL | 1.5 Gb/s jitter tolerance mask per standard | wired_rx + timing | `analog/wired_rx/generated/cdr-evidence.json` | **unverified** | no JTOL evidence; ring phase error 9-10.8 deg | AC-3 per-UI Alexander PD, phase trim (S4/S5) | `wire_rx_board_retimer`, `B13` |
| WR-SATA-PPM | 1.5 Gb/s ppm offset + SSC | wired_rx (cdr) | `analog/wired_rx/generated/cdr-rtl-check.json` | **unverified** | FLL locks -6000..+1000 ppm in behavioural model only; hand-over drift 5883 ppm extracted | AC-3 continuous integral path | `wire_rx_board_retimer`, `B13` |
| WR-DP-BER | 1.62 Gb/s BER 1e-12 at 95 % CL (3.0e12 bits) | wired_rx + wired_tx + digital | `analog/wired_rx/generated/cdr-evidence.json` | **fails** | CDR tracking fails extracted; wrx_cap fails >480 MHz; digital caps ~1.07 Gb/s | AC-3 CDR closure + AC-1 | `wire_rx_board_retimer`, `B13` |
| WR-DP-JTOL | 1.62 Gb/s jitter tolerance mask per standard | wired_rx + timing | `analog/wired_rx/generated/cdr-evidence.json` | **unverified** | no JTOL evidence; ring phase error 9-10.8 deg | AC-3 per-UI Alexander PD, phase trim (S4/S5) | `wire_rx_board_retimer`, `B13` |
| WR-DP-PPM | 1.62 Gb/s ppm offset + SSC | wired_rx (cdr) | `analog/wired_rx/generated/cdr-rtl-check.json` | **unverified** | FLL locks -6000..+1000 ppm in behavioural model only; hand-over drift 5883 ppm extracted | AC-3 continuous integral path | `wire_rx_board_retimer`, `B13` |
| WR-SDI-BER | 1.485 Gb/s BER 1e-12 at 95 % CL (3.0e12 bits) | wired_rx + wired_tx + digital | `analog/wired_rx/generated/cdr-evidence.json` | **fails** | CDR tracking fails extracted; wrx_cap fails >480 MHz; digital caps ~1.07 Gb/s | AC-3 CDR closure + AC-1 | `wire_rx_board_retimer`, `B13` |
| WR-SDI-JTOL | 1.485 Gb/s jitter tolerance mask per standard | wired_rx + timing | `analog/wired_rx/generated/cdr-evidence.json` | **unverified** | no JTOL evidence; ring phase error 9-10.8 deg | AC-3 per-UI Alexander PD, phase trim (S4/S5) | `wire_rx_board_retimer`, `B13` |
| WR-SDI-PPM | 1.485 Gb/s ppm offset | wired_rx (cdr) | `analog/wired_rx/generated/cdr-rtl-check.json` | **unverified** | FLL locks -6000..+1000 ppm in behavioural model only; hand-over drift 5883 ppm extracted | AC-3 continuous integral path | `wire_rx_board_retimer`, `B13` |
| WR-GBE-BER | 1.25 GBd BER 1e-12 at 95 % CL (3.0e12 bits) | wired_rx + wired_tx + digital | `analog/wired_rx/generated/cdr-evidence.json` | **fails** | CDR tracking fails extracted; wrx_cap fails >480 MHz; digital caps ~1.07 Gb/s | AC-3 CDR closure + AC-1 | `wire_rx_board_retimer`, `wire_tx_external_data`, `B13`, `B12` |
| WR-GBE-JTOL | 1.25 GBd jitter tolerance mask per standard | wired_rx + timing | `analog/wired_rx/generated/cdr-evidence.json` | **unverified** | no JTOL evidence; ring phase error 9-10.8 deg | AC-3 per-UI Alexander PD, phase trim (S4/S5) | `wire_rx_board_retimer`, `wire_tx_external_data`, `B13`, `B12` |
| WR-GBE-PPM | 1.25 GBd ppm offset | wired_rx (cdr) | `analog/wired_rx/generated/cdr-rtl-check.json` | **unverified** | FLL locks -6000..+1000 ppm in behavioural model only; hand-over drift 5883 ppm extracted | AC-3 continuous integral path | `wire_rx_board_retimer`, `wire_tx_external_data`, `B13`, `B12` |
| WR-PCIE-SSC | 0..-5000 ppm down-spread, 30-33 kHz tracked | wired_rx (cdr) | `analog/wired_rx/generated/cdr-rtl-check.json` | **unverified** | no SSC test | AC-3 integral slew >= 400 ppm/us | `wire_rx_board_retimer`, `B13` |
| WR-SATA-SSC | 0..-5000 ppm down-spread, 30-33 kHz tracked | wired_rx (cdr) | `analog/wired_rx/generated/cdr-rtl-check.json` | **unverified** | no SSC test | AC-3 integral slew >= 400 ppm/us | `wire_rx_board_retimer`, `B13` |
| WR-DP-SSC | 0..-5000 ppm down-spread, 30-33 kHz tracked | wired_rx (cdr) | `analog/wired_rx/generated/cdr-rtl-check.json` | **unverified** | no SSC test | AC-3 integral slew >= 400 ppm/us | `wire_rx_board_retimer`, `B13` |
| WR-PCIE-TXSWING | 800-1200 mVppd | wired_tx | `analog/wired_tx/generated/wiredtx-evidence.json` | **fails** | 578.5 mVppd tt | S8 CML tail >= 16 mA | `wire_tx_board_serializer`, `B14` |
| WR-PCIE-TXJIT | TJ <= 0.25 UI | wired_tx + timing | `analog/wired_tx/generated/wiredtx-evidence.json` | **fails** | 4:1 mux fails 1.92-2.97 Gb/s; serializer DJ 0.38 UI at 1.25 G | Compact-cell 4:1 mux and retiming (wired_tx) | `wire_tx_board_serializer`, `B14` |
| WR-PCIE-RL | Diff RL >= 10 dB, CM >= 6 dB, 50 MHz-1.25 GHz | pads + wired_rx/tx | `analog/pads/README.md` | **fails** | 2.35/2.71 pF -> 7.6/6.6 dB at 1.25 GHz | S7 pad C <= 1.6 pF or T-coil | `B13` |
| WR-PAD-C | Wired pad C <= 1.6 pF effective at 1.25 GHz | pads | `analog/pads/README.md` | **fails** | RX 2.34-2.35 pF, TX 2.706/2.713 pF | S7 | — |
| WR-SATA-TXSWING | 400-600 mVppd | wired_tx | `analog/wired_tx/generated/wiredtx-evidence.json` | **marginal** | 578.5 mVppd tt; ss/3.15 V 0.50 V | corner swing trim | `B14` |
| WR-SATA-OOB | OOB squelch 50-200 mV, COMRESET/COMWAKE timing | wired_rx (detect) | `analog/wired_rx/generated/detect-evidence.json` | **unverified** | detect block clean; no OOB burst timing | OOB burst bench | `wire_cdr_fpga_oversample` |
| WR-PCIE-DETECT | Receiver detect + electrical idle | wired_tx/wired_rx (detect) | `analog/wired_rx/generated/detect-evidence.json` | **unverified** | no numeric evidence | Detect pulse bench | `wire_detect_via_wmon` |
| WR-GBE-TXSWING | >= 500 mVppd | wired_tx | `analog/wired_tx/generated/wiredtx-evidence.json` | **marginal** | 578.5 mVppd tt; 1.25 Gb/s tt/ff only | 4:1/2:1 mux port + swing trim | `wire_tx_external_data`, `B12` |
| WR-TMDS-TXSWING | TMDS 400-600 mV SE into 50 ohm to 3.3 V incl. ff clamp leakage | wired_tx (tmds) + pads | `analog/wired_tx/generated/tmds-evidence.json` | **marginal** | 1.25 Gb/s eye OK; 1.485 not simulated; ff clamp 5.1 mA at 3.3 V not in bench | 1.485 Gb/s bench with clamp | `wire_tx_external_data`, `B12` |
| WR-TMDS-BER | TMDS RX/TX BER 1e-12 at 742.5 Mb/s and 1.485 Gb/s | wired_rx + wired_tx | `analog/wired_tx/generated/tmds-evidence.json`<br>`analog/wired_rx/generated/cdr-evidence.json` | **unverified** | TX 720p inferred OK; RX needs CDR | S6 forwarded TMDS clock into WCLK_IN | `wire_rx_tmds_forwarded_clock`, `B16` |
| WR-SDI-TXSWING | die >= 400 mVppd into board cable driver | wired_tx | `analog/wired_tx/generated/wiredtx-evidence.json` | **unverified** | 1.485 not simulated | 1.485 Gb/s bench | `B14` |
| WR-USB-HSSWING | HS 360-440 mV | wired_tx (usbhs) | `analog/wired_tx/generated/usb_hs_bias-evidence.json` | **marginal** | reachable; ss/3.15 V 372-379 at full scale; per-board cal | B11 calibration | `B8`, `B11` |
| WR-USB-TURN | HS turnaround <= 192 bit times (400 ns) | digital + usbhs | `spec/streaming-transport-v2.md` | **unverified** | model at full clock only | HL-LATENCY re-run after AC-1 | `B8` |
| WR-USB-FSLS | FS edges 4-20 ns, LS 75-300 ns | pads/usbdrive | `analog/pads/generated/wired-receive-usb-screen.json` | **fails** | FS 5.8-11 ns meets; LS 33-67 ns fails | LS slew control (no area)  | `B8` |
| WR-PLL-JIT | Ring PLL RJ <= 2 ps rms, DJ <= 0.05 UI at 2.5 G | timing (pll_ring) | `analog/timing/generated/pll_ring-evidence.json` | **unverified** | no jitter evidence; pll_ring.spice stale | Phase-noise sim (transient noise or PSS/PNOISE) | `wire_clk_wclk_in` |
| WR-SER-DJ | Serializer + pad DJ <= 0.15 UI | wired_tx | `analog/wired_tx/generated/wiredtx-evidence.json` | **fails** | 305 ps pp at 1.25 G (0.38 UI) | Compact retiming | `wire_tx_external_data` |
| WR-SLICER-OFFSET | Sampler offset <= 10 mV after trim | wired_rx (slicer) | `analog/wired_rx/generated/slicer-evidence.json` | **fails** | -27 mV nominal, -31..-21 mV corners (stale) | Finer trim (<= 2 mV step) | `wire_wmon_scope` |
| RF-WIFI-SENS | MCS0 -82 dBm, MCS7 -64 dBm | rf_rx | `analog/rf_rx/generated/lna-evidence.json`<br>`analog/rf_rx/generated/bbfilter_i-evidence.json` | **fails** | On-chip NF 12.1 dB + 2.4 dB ADC penalty: MCS0 ~-79.7, MCS7 ~-57.7 dBm | Restore PGA to 42 dB; LNA gain | `rf_lna_bypass`, `B5` |
| RF-WIFI-ACR | Adjacent +16 dB (MCS0) | converters (adc) + rf_rx filter | `analog/converters/generated/adc_i-evidence.json` | **fails** | 20 MS/s + 15.2 MHz filter: adjacent aliases with 3-20 dB rejection | ADC 40 MS/s | `rf_bb_external_adc` |
| RF-WIFI-EVM | TX EVM MCS0 -5 dB .. MCS7 -27 dB at >= -10 dBm mean | rf_tx | `analog/rf_tx/generated/rfdriver-evidence.json` | **unverified** | no EVM sim; driver gain 3.2x short | Linear driver gain; EVM sim | `rf_tx_external_upconverter` |
| RF-WIFI-MASK | HE20 mask 0/-20/-28/-40 dBr | rf_tx | `analog/rf_tx/generated/rfdriver-evidence.json` | **unverified** | not simulated | Mask sim with real balun | `rf_tx_external_upconverter` |
| RF-TX-ACLR | ACLR <= -28 dBc | rf_tx | `analog/rf_tx/generated/rfdriver-evidence.json` | **unverified** | not simulated | as above | `rf_tx_external_upconverter` |
| RF-TX-HARM | H2/H3 <= -40 dBc at pad | rf_tx | `analog/rf_tx/generated/rfdriver-evidence.json` | **unverified** | not simulated | Harmonic sim + board LPF | `B4` |
| RF-TX-POUT | 0 dBm constant envelope; >= -10 dBm OFDM mean | rf_tx | `analog/rf_tx/generated/rfdriver-evidence.json` | **marginal** | saturated -0.13 tt (-0.4..-3.1 env); linear -5.6 tt | Driver gain fix | `rf_tx_external_upconverter` |
| RF-BLE-SENS | -70 dBm | rf_rx | `analog/rf_rx/generated/lna-evidence.json` | meets | 10-18 dB margin by cascade (analytic on extracted NF) | — | — |
| RF-BLE-IBE | In-band emissions -20 dBm @2 MHz, -30 dBm >=3 MHz | rf_tx | `analog/rf_tx/generated/rfdriver-evidence.json` | **unverified** | not simulated | Saturated-mode spectrum sim | — |
| RF-154-SENS | -85 dBm | rf_rx | `analog/rf_rx/generated/lna-evidence.json` | meets | margin by cascade | — | — |
| RF-154-EVM | EVM <= 35 % | rf_tx | `analog/rf_tx/generated/rfdriver-evidence.json` | **unverified** | not simulated | EVM sim | `rf_tx_external_upconverter` |
| RF-BT-EDR | DEVM <= 20 % / 13 % | rf_tx | `analog/rf_tx/generated/rfdriver-evidence.json` | **unverified** | linear -5.6 dBm; no DEVM | Linear driver | `rf_tx_external_upconverter` |
| RF-RX-IIP3 | IIP3 >= -10 dBm at max gain | rf_rx | `analog/rf_rx/generated/lna-evidence.json` | **unverified** | not simulated | Two-tone sim | `rf_lna_bypass` |
| RF-TX-IRR | TX IRR >= 35 dB (>= 40 after cal) | rf_tx | `analog/rf_tx/generated/txmix_i-evidence.json` | **marginal** | 61.6 dB ideal LO linear; 33.1 dB saturated | Real-LO sim | `rf_tx_external_upconverter` |
| RF-RX-IRR | RX IRR >= 25 dB (>= 35 after cal) | rf_rx | `analog/rf_rx/generated/rxmix_i-evidence.json` | meets | ~29 dB uncorrected from 0.6 dB I/Q gain (tt only) | FPGA correction | — |
| RF-TX-MUTE | Mute isolation >= 40 dB | rf_tx | `analog/rf_tx/generated/rfdriver-evidence.json` | **fails** | 22-24 dB | Series mute switch / driver off | — |
| RF-WIFI-LOLEAK | LO leakage <= -30 dBc | rf_tx | `analog/rf_tx/generated/txmix_i-evidence.json` | meets | 44.6 dBc linear, 38 dBc saturated (ideal LO) | Real-LO confirm | — |
| RF-LO-JIT | LO total <= 1.05 ps; I/Q skew <= 1.16 ps | timing (lo_ext) + board | `analog/timing/generated/lo_ext-evidence.json` | **unverified** | no additive jitter or skew evidence; refpad clamp conflict at ff | lo_ext + refpad co-sim | `rf_lo_external_ref`, `B3` |
| WR-SATA2-BER | 3.0 Gb/s BER 1e-12 at 95 % CL (3.0e12 bits) | wired_rx + wired_tx + timing + digital | `analog/wired_rx/generated/cdr-evidence.json`<br>`analog/wired_tx/generated/wiredtx-evidence.json` | **fails** | CDR tracking fails extracted; 4:1 mux fails 1.92-2.97 Gb/s; ring 750 MHz in band but regulated-ss top 733-778 MHz | AC-3 CDR + IX-1 ring/sampler range + IX-2 host fit | `wire_rx_board_retimer`, `wire_board_phy_bypass`, `B13`, `wire_tx_board_serializer`, `B14` |
| WR-SATA2-TXSWING | Gen2i 400-700 mVppd | wired_tx | `analog/wired_tx/generated/wiredtx-evidence.json` | **marginal** | 578.5 mVppd tt at lower rates; ss/3.15 V 0.50 V; 3.0 Gb/s not simulated | Corner swing trim; 3.0 Gb/s extracted bench | `wire_tx_board_serializer`, `B14` |
| WR-SATA2-TXJIT | Gen2i TJ <= 0.37 UI, DJ <= 0.19 UI (fbaud/500) | wired_tx + timing | `analog/wired_tx/generated/wiredtx-evidence.json` | **fails** | 4:1 mux fails 1.92-2.97 Gb/s; serializer DJ 0.38 UI at 1.25 G | Compact-cell 4:1 mux to 3.34 Gb/s (IX-1) | `wire_tx_board_serializer`, `B14` |
| WR-SATA2-JTOL | Gen2i JTOL TJ 0.60 / DJ 0.42 UI | wired_rx + timing | `analog/wired_rx/generated/cdr-evidence.json` | **unverified** | no JTOL evidence; ring phase error 9-10.8 deg | AC-3 per-UI Alexander PD, phase trim (S4/S5) | `wire_rx_board_retimer`, `wire_board_phy_bypass`, `B13` |
| WR-SATA2-RXSENS | RX >= 275 mVppd | wired_rx (ctle, slicer) | `analog/wired_rx/generated/slicer-evidence.json` | **unverified** | no 3.0 Gb/s sensitivity sim; slicer offset fails 10 mV today | Slicer trim (WR-SLICER-OFFSET) + 3.0 Gb/s statistical eye | `wire_rx_board_retimer`, `wire_board_phy_bypass`, `B13` |
| WR-SATA2-RL | Diff RL >= 8 dB to 2.4 GHz (>= 10 dB to 1.2 GHz) | pads + wired_rx/tx | `analog/pads/README.md`<br>`spec/package-channel.md` | **fails** | needs C_pad <= 1.15 pF; today 2.35/2.71 pF, S7 target 1.6 pF gives 5.7 dB at 2.4 GHz | IX-3 low-C pad or T-coil to <= 1.15 pF effective | `B13` |
| WR-DPHBR-TXJIT | HBR TX TJ at TP2 per DP 1.2 (verify) | wired_tx + timing | `analog/wired_tx/generated/wiredtx-evidence.json` | **fails** | 4:1 mux fails 1.92-2.97 Gb/s | Compact-cell 4:1 mux (IX-1) | `wire_tx_board_serializer`, `B14` |
| WR-DPHBR-JTOL | HBR sink JTOL per DP CTS (verify) | wired_rx + timing | `analog/wired_rx/generated/cdr-evidence.json` | **unverified** | no JTOL evidence | AC-3 CDR closure | `wire_rx_board_retimer`, `wire_board_phy_bypass`, `B13` |
| WR-DPHBR-RL | RX diff RL >= 10 dB to 1.35 GHz | pads + wired_rx | `analog/pads/README.md` | **fails** | needs C_pad <= 1.57 pF; today 2.35 pF | S7 / IX-3 | `B13` |
| WR-3G1-BER | 3.125 GBd BER 1e-12 at 95 % CL (XAUI lane / 2500BASE-X) | wired_rx + wired_tx + timing + digital | `analog/wired_rx/generated/cdr-evidence.json`<br>`analog/wired_tx/generated/wiredtx-evidence.json`<br>`analog/timing/generated/pll_ring-evidence.json` | **fails** | ring 781 MHz needed: 3.6 % below 810 MHz edge, above regulated ss top 733-778 MHz; serializer fails > 1.92 Gb/s; host link 109 % of capacity | IX-1 ring/sampler/serializer range + IX-2 8b/10b offload | `wire_rx_board_retimer`, `wire_board_phy_bypass`, `B13`, `wire_tx_board_serializer`, `B14` |
| WR-3G1-TXSWING | >= 800 mVppd (XAUI 800-1600) | wired_tx | `analog/wired_tx/generated/wiredtx-evidence.json` | **fails** | 578.5 mVppd tt | S8 CML tail >= 16 mA | `wire_tx_board_serializer`, `B14` |
| WR-3G1-TXJIT | TJ <= 0.35 UI (112 ps), DJ <= 0.17 UI | wired_tx + timing | `analog/wired_tx/generated/wiredtx-evidence.json` | **fails** | serializer DJ 305 ps pp at 1.25 G; 810 MHz in BYP has ~29-33 ps pk supply DJ | Compact retiming + IX-1 regulated 834 MHz ring | `wire_tx_board_serializer`, `B14` |
| WR-3G1-JTOL | RX TJ 0.65 / DJ 0.37 UI, corner 1.875 MHz | wired_rx + timing | `analog/wired_rx/generated/cdr-evidence.json` | **unverified** | no JTOL evidence | AC-3 CDR closure at 781 MHz quarter rate | `wire_rx_board_retimer`, `wire_board_phy_bypass`, `B13` |
| WR-3G1-PPM | +-100 ppm, no SSC | wired_rx (cdr) | `analog/wired_rx/generated/cdr-rtl-check.json` | **unverified** | FLL behavioural only | AC-3 continuous integral path | `wire_rx_board_retimer`, `wire_board_phy_bypass`, `B13` |
| WR-3G1-RL | Diff RL >= 10 dB to 625 MHz, >= 6 dB at 1.5625 GHz | pads + wired_rx/tx | `analog/pads/README.md`<br>`spec/package-channel.md` | **fails** | 2.35/2.71 pF -> 6.0/5.1 dB at 1.5625 GHz; 1.6 pF gives 8.7 dB | S7 | `B13` |
| WR-RATE-CONT | Every line rate 0.48-3.24 Gb/s reachable on the primary route, no gaps | timing (pll_ring) + wired_rx + wired_tx + digital (clocktree) | `analog/timing/generated/pll_ring-evidence.json`<br>`analog/timing/README.md` | **fails** | ring 480-810 MHz modes: gaps 0.81-0.96 and 1.62-1.92 Gb/s | IX-1 ring tuning ratio >= 2.12:1 (393-834 MHz regulated) with coarse bands | `wire_rx_board_retimer`, `wire_tx_board_serializer`, `wire_board_phy_bypass` |
| WR-RATE-EDGE | >= 3 % margin at every band edge (ring <= 393 MHz and >= 834 MHz regulated) | timing (pll_ring, pll_vreg) + wired_rx (samplers, wrx_cap) + wired_tx | `analog/timing/generated/pll_ring-evidence.json`<br>`analog/pll_vreg/README.md` | **fails** | regulated ss top 733-778 MHz; 810 MHz only in BYP; DP RBR on the 810 MHz edge; wrx_cap fails > 480 MHz | IX-1 ring resize >= 900 MHz at 2.6 V ss; samplers/wordclk to 834 MHz | `wire_rx_board_retimer`, `B13` |
| WR-RATE-LOW | Rates below 0.48 Gb/s via ring /2^k TX and FPGA oversampling / reduced-rate CDR | digital (clocktree) + wired_rx | `analog/wired_rx/generated/cdr-evidence.json` | **unverified** | oversample route exists as fallback only; no CDR run at ring/2^k | Document and test the low-rate mode (IX-4) | `wire_cdr_fpga_oversample` |
| WR-HL-LINECODE | Host link carries 3.0-3.24 Gb/s lines with >= 4 % margin: fixed 312.5 MHz host word clock, 8b/10b offload both directions, L=256 frames (HL-FRAME), reversible north bank RX2 for raw RX (HL-DIR) | digital (wired boundary, transport) + hostio | `evidence/digital-hardening-evidence.json`<br>`spec/streaming-transport-v2.md`<br>`../../scratch/reviews/host-link-bandwidth.md` | **fails** | today 2.88 Gb/s/dir (59/64): raw 3.0/3.125/3.24 = 104/109/112 %, 8b/10b 94/98/101 %; planned: 8b/10b at L=256 = 88/92/95 % each direction (full duplex), raw RX in RX2 = 52/54/56 % of 5.76 Gb/s; L=256, RX2 and d2h_stagger not yet in RTL | HB-1..HB-6 (interface-changes.md): stagger + fast slew, L=256 frames, 8b/10b both ways, per-direction rate, hold-padding, RX2 bank reversal | `wire_board_phy_bypass`, `debug.host_link.rate div2/div4` |
| RF-BLE-CODED-SENS | LE Coded S=8 <= -82 dBm, S=2 <= -75 dBm (target -95 / -90) | rf_rx + FPGA demod | `analog/rf_rx/generated/lna-evidence.json` | **unverified** | projected -88..-100 dBm (S=8) from RF-BLE-SENS cascade + 8-12 dB coding gain; no coded demod sim | Coded demod sim on extracted RX chain | `rf_lna_bypass`, `B5` |
| RF-BLE-CODED-CI | LE Coded C/I co-channel 12 dB (S=8) / 17 dB (S=2), adjacent per table | rf_rx + converters | `analog/rf_rx/generated/lna-evidence.json` | **unverified** | not simulated (as RF-BLE-BLOCK) | Interferer sim with real filter/ADC | `rf_bb_external_adc` |
| RF-BLE-CODED-PKT | 17.04 ms packets: gain/DC loop/LO stable; drift <= +-50 kHz | rf_rx + timing (LO) + digital (AGC) | `analog/timing/generated/lo_ext-evidence.json` | **unverified** | no long-packet sim | 17 ms LO + DC-loop sim | `rf_lo_external_ref`, `B3` |
| RF-CS-HOP | CS step hop: LO phase-settled (<= 2 deg) within T_FCS - 5 us; advertise T_FCS 80 us | timing (rf PLL/QVCO, lo_ext) + board LO + digital | `analog/timing/generated/lo_ext-evidence.json`<br>`analog/timing/README.md`<br>`spec/block-diagram.md` | **unverified** | warm hop 50 us allocation is frequency settling (35 us external); on-chip QVCO frequency loop open | IX-5 phase-settling spec for B3 synthesizer and on-chip PLL | `rf_lo_external_ref`, `B3` |
| RF-CS-TIP | TX<->RX direction change on same channel <= 30 us, LO phase-continuous (T_IP2 <= 40 us) | rf_tx + rf_rx + timing + digital | `analog/timing/generated/lo_ext-evidence.json`<br>`analog/rf_tx/generated/rfdriver-evidence.json` | **unverified** | direction change not timed; warm-hop rejects direction change as hop | IX-6 timed phase-continuous TDD switch | `rf_lo_external_ref` |
| RF-CS-PHASE | Per-tone round-trip phase: <= 2 deg LO drift TX->RX tone, <= 5 deg rms random, <= 10 deg linear across band after cal | timing (LO) + rf_rx + rf_tx | `analog/timing/generated/lo_ext-evidence.json` | **unverified** | lo_ext supply pushing 0.0025 ps/mV (not binding); no phase-drift sim | LO phase-drift sim across TX/RX switch + IX-7 loopback cal | `rf_lo_external_ref`, `B3` |
| RF-CS-IQ | IQ tone-phase error <= 1 deg (IRR >= 35 dB after cal) across 2402-2480 MHz | rf_rx + timing (LO I/Q trim) + FPGA cal | `analog/rf_rx/generated/rxmix_i-evidence.json` | **marginal** | ~29 dB uncorrected (tt); COB LO hybrid 6-10 deg needs D-LO-2 trim; no across-band cal | D-LO-2 trim + IX-7 loopback per-bin cal | `rf_lo_external_ref`, `B19` |
| RF-CS-RTT | Deterministic TX-launch -> RX-sample latency <= 5 ns rms; ToA <= 10 ns rms | digital (scheduler, converters FIFO) + converters | `spec/streaming-transport-v2.md` | **unverified** | action clock 25.6 ns ticks; epoch FIFO latency not characterised | IX-8 as reworded (HL-MARK): chip TX-launch/fast-apply marks in the D2H stream + fixed published per-mode latency; FPGA 64-bit sample counters and sub-tick timestamp | `rf_bb_external_adc` |
| RF-CS-ANT | N_AP=1 first die; multi-antenna via FPGA-driven external switch, no chip pin | board + FPGA | `spec/block-diagram.md` | **unverified** | procedure-level only | Board recipe; FPGA tone-boundary timing from action clock | `B17` |
| RF-CS-RANGE | PBR <= 0.5 m rms, RTT <= 3 m rms (cabled 1-10 m equivalent) | system (rf_rx + rf_tx + timing + FPGA) | `analog/timing/generated/lo_ext-evidence.json`<br>`analog/rf_rx/generated/rxmix_i-evidence.json` | **unverified** | depends on RF-CS-PHASE/-IQ/-RTT | Close RF-CS-PHASE, -IQ, -RTT; bench vs reference device | `rf_lo_external_ref`, `B3` |
| RF-154-TURN | RX<->TX turnaround <= 192 us (12 symbols); channel switch <= 500 us | rf_tx + rf_rx + digital | `spec/block-diagram.md` | **unverified** | warm hop 50 us; direction change not timed | IX-6 TDD switch <= 40 us | `rf_lo_external_ref` |
| RF-154-CCA | CCA/ED over 128 us, ED range >= 40 dB, +-6 dB | rf_rx + converters + digital | `analog/rf_rx/generated/lna-evidence.json` | **unverified** | gain state + ADC RSSI not characterised | RSSI calibration vs gain code | `rf_bb_external_adc` |
| RF-154-FTOL | TX frequency +-40 ppm | timing (LO ref) + board | `analog/timing/generated/lo_ext-evidence.json` | **unverified** | set by REF_IN / B3 source accuracy | Board XO/synth accuracy | `B3` |
| RF-THREAD-CSL | CSL scheduled TX/RX with deterministic latency <= +-16 us; RX warm-up <= 100 us | digital (scheduler) + rf_rx | `spec/streaming-transport-v2.md` | **unverified** | scheduler latency modelled at full clock only | Latency characterisation (shared with RF-CS-RTT) | `rf_bb_external_adc` |
| RF-PROF-ZIGBEE | Zigbee = RF-154-* profile, no new PHY demand | spec | `spec/interface-requirements.md` | **unverified** | inherits RF-154-* | Close RF-154-* | — |
| RF-PROF-MATTER | Matter = Thread / Wi-Fi / BLE profile, no new PHY demand | spec | `spec/interface-requirements.md` | **unverified** | inherits RF-THREAD-CSL, RF-154-*, RF-WIFI-*, RF-BLE-* | Close inherited rows | — |
| RF-RX-MAXIN | Max input: Wi-Fi -20 dBm mean, BLE -10 dBm, 15.4 -20 dBm without TIA/LNA clipping | rf_rx | `analog/rf_rx/generated/rxmix_i-evidence.json`<br>`analog/rf_rx/generated/lna-evidence.json` | **fails** | Estimate: TIA clips at ~-34 dBm CW at LNA high gain (41.7 dB to TIA out, +-0.8 V swing assumed; +-6 dB), ~-20 dBm via bypass: ~24 dB short (RXR-01) | TIA feedback-R steps + LNA stage-2 attenuation (>= 30 dB pre-filter range) | `rf_lna_bypass` |
| RF-RX-AGC | Gain range >= 70 dB (>= 30 dB pre-filter, <= 6 dB steps); step settle <= 0.5 us; decision->gain <= 1 us; AGC <= 4 us | rf_rx + digital (opcode4) + FPGA | `analog/rf_rx/generated/bbfilter_i-evidence.json` | **fails** | Pre-filter range 3 dB (+ bypass); opcode4 fast gain not in RTL; SPI write 1.6 us/step -> ~7.6 us for 2 steps vs 8 us L-STF (RXR-03) | Implement opcode4 in receiver RTL; add pre-filter gain steps (RXR-01) | — |
| RF-RX-OVLD | Pre-filter overload flag at TIA output within 0.2 us, in status + D2H stream | rf_rx + digital | — | **fails** | No detector exists; RSSI is post-filter only (RXR-09) | 2 latched comparators per path at the TIA output + status bit | — |
| RF-RX-RECOV | Recovery <= 2 us after pulsed in-band blocker at every gain state | rf_rx | — | **unverified** | Not simulated (RXR-08) | Overload-recovery transient with the RXR-01 sim | — |
| RF-RX-DCOC | DC offset at ADC <= 5 % FS at every PGA code used; dynamic offset <= 5 % FS | rf_rx + FPGA | `analog/rf_rx/generated/rxmix_i-evidence.json` | **fails** | TIA trim residual <= 4.5 mV x PGA: 24 dB 8 %, 30 dB 16 %, 42 dB 65 % FS; signal-dependent shift ~20 mV (RXR-02) | Second offset DAC / finer LSB after the PGA, per-gain-code table; FPGA DC tracking; low IF for narrowband | — |
| RF-RX-IIP2 | IIP2 >= +47 dBm at max gain (or low-IF operation) | rf_rx | — | **unverified** | Not simulated (RXR-05) | Two-tone sim; low-IF recipe for narrowband protocols | — |
| RF-RX-FLICK | Low-IF/zero-IF channel NF <= 5-9 MHz NF + 3 dB | rf_rx | `analog/rf_rx/generated/lna-evidence.json` | **unverified** | NF 4.45 dB (5-9 MHz) vs 5.97 dB (2-9 MHz), sub-2 MHz unmodelled (RXR-05) | Transient-noise NF vs IF 10 kHz-10 MHz; low-IF recipe | — |
| RF-RX-LOPN | LO phase noise mask <= -107 dBc/Hz @3 MHz, -120 @40 MHz, -130 @>=100 MHz | board (B35) + timing (future on-chip LO) | — | **unverified** | No mask existed; reciprocal-mixing limits derived (RXR-06) | Board synth selection to B35 | `B35` |
| RF-RX-FREF | LO and sample clock from one +-10 ppm reference; FPGA CFO range >= +-250 kHz | board (B35) + FPGA | — | **unverified** | Not required before (RXR-11) | B35 common TCXO; FPGA AFC/SFO tracking | `B35` |
| RF-RX-LOLEAK | LO leakage at RF_RX <= -57 dBm (LO, 2LO) | rf_rx + assembly | `analog/rf_rx/generated/rxmix_i-evidence.json` | **unverified** | Estimate -50..-65 dBm (IQ-01/XT-08), 0-7 dB short at the pessimistic end | Extracted mixer + LNA reverse-isolation sim with the routed LO (A4) | — |
| RF-RX-SPUR | CW spur <= -100 dBm input-referred on channels in use | rf_rx + assembly + digital (clock plan) | `analog/rf_rx/generated/lna-evidence.json` | **fails** | A5: macro 31st harmonic -88..-69 dBm (moved by clock plan), conv 40 MHz 2400/2440/2480 -103..-84 dBm | AGND_RX pad + clock plan; conv-clock selection per channel | — |
| RF-RX-COEX | Co-located LTE/NR/5 GHz Wi-Fi: desense <= 3 dB at +13 dBm with B34 | board (B34) + rf_rx | — | **unverified** | No on-chip selectivity; ~45 dB short without B34 (RXR-04) | Board BAW coex filter B34 | `B34` |
| RF-RX-NFSYS | System NF at antenna <= 8 dB incl. balun, match, T/R switch, coex filter at P2 | rf_rx + board | `analog/rf_rx/generated/lna-evidence.json` | **marginal** | lna4_b 4.45 + pkg 0.61 + balun 0.8 + switch 0.5 + BAW 2.0 = 8.4 dB (scratch, unpublished; published chain 12.1 dB) | Promote lna4_b; low-loss BAW/balun selection | — |
| RF-RX-ESD | RF_RX: 2 kV HBM and +10 dBm CW survivable; board TVS for IEC +-8 kV | pads + rf_rx + board (B36) | — | **unverified** | +10 dBm estimate ~3.7 V gate peak vs ~3.6 V; HBM margin 0.105 V (ESD-02) (RXR-07) | +10 dBm transient on the RF pad model; B36 TVS | `B36` |
| RF-RX-PSRR | RX with board ripple (B37): spurs <= RF-RX-SPUR, desense <= 0.5 dB | rf_rx + board (B37) | — | **unverified** | No RX PSRR evidence (RXR-10) | AC PSRR sim of TIA+filter; B37 | `B37` |
| RF-COEX-PTA | 3-wire PTA in FPGA; grant-to-mute <= 2 us | FPGA + digital | — | **unverified** | No coex interface defined; no chip pin needed | FPGA PTA block using the scheduled RF unmute | — |
| WR-100TX-TXLVL | 100BASE-TX MLT-3 950-1050 mV peak, symmetry 0.98-1.02, overshoot <=5 % via MAIN+POST summed into the B39 network | wired_tx + pads + board (B39) | — | **unverified** | Needs 40 mA: MAIN 25.4 + POST 21.05 mA FS tt (+16 %); POST is wired inverted (de-emphasis), so the same-sign sum is impossible today | IX-9 POST polarity select + POST DAC x1.2; B39 | `B38a`, `B39` |
| WR-100TX-TXSHAPE | Rise/fall 3-5 ns, symmetry <=0.5 ns, 0-level cancellation residue <=1 % after the filter | board (B39) + wired_tx | — | **unverified** | No sim with B39; MAIN/POST delay match at 2 Gb/s not characterized | B39 LC filter sim with extracted pad; IX-9 matched CMD gating | `B38a`, `B39` |
| WR-100TX-TXJIT | TX jitter <=1.4 ns pp (first die <=0.7 ns) at 125 MBd +/-50 ppm | wired_tx + FPGA | — | **unverified** | 0.5 ns parity DJ from the 16x pattern (analytic) | Quarter-rate 2 Gb/s 16x pattern (WT12), FPGA parity alignment | `B38a` |
| WR-100TX-RL | TX/RX RL >=16 dB 2-30 MHz, 30-60 MHz slope, >=10 dB 60-80 MHz | board (B38/B39) + pads | — | **unverified** | Analytic: ~24 dB at 30 MHz, ~12 dB at 60 MHz with B39; pad C negligible <80 MHz | B39 49.9 ohm 1 %; RX PKG-W1a trim | `B38a`, `B39` |
| WR-100TX-RXEQ | Operate 0-100 m Cat5 with NEXT: inner eye >=0.5 of outer level after EQ | wired_rx (CTLE) | — | **unverified** | Model scratch/ethernet/fe100.py: eye closed at 50 m without EQ; 0.54 at 100 m with a 10 MHz zero; CTLE r2 has no MHz zero | IX-13 CTLE low-frequency zero cap bank | `B38a` |
| WR-100TX-RXTH | Two decision thresholds +/-90..+/-135 mV plus +/-50 mV DC-restore headroom (range >= +/-250 mV, LSB <=4 mV) | wired_rx (slicer) + digital | — | **unverified** | Slicer r4c trim -52..+65 mV only | IX-10 e-sampler threshold DACs | `B38a` |
| WR-100TX-BLW | Baseline wander incl. killer packet: residual after DC restore <= half-eye margin | FPGA + digital + wired_rx | — | **unverified** | Model: held-level wander 26 % A/1 us; residual 13.5 % (0.5 us loop) vs 27 % half-eye at 100 m: marginal | IX-10 + IX-11 fast threshold update, loop delay <=0.5 us | `B38a` |
| WR-100TX-CDR | 125 MBd +/-50 ppm recovered by 6x FPGA oversampling on two lanes | digital (capture raw mode) + FPGA | — | **unverified** | Raw dual-lane export with forced odd psel not implemented | IX-12 raw dual-lane full-rate mode; IX-4 | `B38a`, `wire_cdr_fpga_oversample` |
| WR-100TX-SD | Signal detect assert >1000 mVppd / deassert <200 mVppd | wired_rx (detect) + FPGA | — | **unverified** | pt_detect codes 125/540 mV exist; no Ethernet bench | Detect codes + descrambler lock; IX-10 amplitude scan | `B38a` |
| WR-100TX-BER | BER <=1e-10 at 95 % CL at 0/50/100 m | FPGA + all above | — | **unverified** | No link sim beyond the behavioural model | Close RXEQ/RXTH/BLW/CDR | `B38a` |
| WR-100TX-HOST | D2H 1.5 Gb/s (2 x 750 Mb/s) and H2D 2.0 Gb/s simultaneously, plus threshold updates | digital (transport) + hostio | — | **unverified** | Fits 2.88 Gb/s/direction (52 % / 69 %) only if HL-RATE closes | HL-RATE/AC-1; H2D 8x mode (1.0 Gb/s) if needed | `B38a`, `debug.host_link.rate` |
| WR-100TX-ANEG | Auto-negotiation FLP (non-compliant amplitude: 1.16-1.27 V vs 2.2 V); forced 100 FD primary | FPGA + wired_tx | — | **unverified** | Amplitude bound of the current-mode TX (sec. 1.14) | Best-effort FLP via IX-9 summed tails; forced mode | `B38a` |
| RF-HT40-TX | HT40/HE40 TX: 40 MHz mask, MCS0-4 EVM <= -19 dB at >= -13 dBm; DAC 80 MS/s host-fed | digital + converters + rf_rx (filter) + rf_tx | — | **fails** | Halfband passes only ~0.2 fs_in; 40 MS/s ZOH image at 21 MHz is 0.9 dB below the 19 MHz edge; widest filter corner 11.3 MHz worst corner | GX-2 tx_interp=external (80 MS/s host-fed), GX-1 wide filter code, full-rate H2D in this mode | — |
| RF-HT40-RX | HT40/HE40 RX sensitivity class (MCS0 -79, MCS7 -61 dBm); droop <= 3 dB at 19.1 MHz all corners; ACR declared not met | rf_rx (bbfilter) + digital | `analog/rf_rx/generated/rf_rx_chain.json` | **fails** | Widest corner 11.3-21.2 MHz over corners: -10.7 dB at 19 MHz for a 15 MHz corner; 40 MS/s complex is critically sampled | GX-1 wide bw code (corner 20-30 MHz all corners after Q-trim) | `debug.rf_bb_bypass.rxfilter` |
| RF-XLO-RANGE | External-LO RX/TX 0.6-2.8 GHz with band board kits; 2.2-2.8 GHz NF <= +1 dB, Pout >= -1.5 dB vs 2.45 GHz | rf_rx + rf_tx + timing (lo_ext) + digital (clock plan) + board (B42) | `analog/rf_rx/generated/rf_rx_chain.json` | **unverified** | Chain gain 45.4/50 dB at 1.2/0.6 GHz (ideal LO), TX +1.4..+3.1 dBm at 1.22/0.61 GHz unmatched; no 2.2-2.8 GHz or COB-model runs | Chain sims at 0.9/1.2/1.6/2.2/2.7 GHz with COB model; GX-5 converter clock from host_follow + per-band spur plan | `B42` |
| RF-QVCO-RANGE | QVCO band codes and frequency loop accept any target in the tank range; 2.40-2.50 GHz guaranteed, 2.3-2.7 GHz per-die | timing (lcvco, frequency loop) | — | **unverified** | Tank tt 2.16-2.82 GHz, all-corner 2.38-2.615 GHz (schematic r2); frequency loop not built | GX-6 loop N/fraction and band codes over the full tank range | `rf_lo_external_ref` |
| RF-SUBG-PROF | Sub-GHz / L-band profiles (LoRa 868/915, 802.15.4g/Wi-SUN, 802.11ah, 23 cm, DECT) via RF-XLO-RANGE | FPGA + board (B42, B5) | — | **unverified** | Mapping row; inherits RF-XLO-RANGE | Close RF-XLO-RANGE; FPGA PHYs | `B5` |
| RF-GNSS-RX | GNSS L1/L2/L5/E5/E6 RX: >= 21 MHz gap-free capture, NF <= 3 dB with B44, no clock harmonic in main lobe +-1 MHz | board (B44) + digital (clock plan) + FPGA | — | **unverified** | 78.125 MHz core 15th harmonic is 4.6 MHz from L5; 62.5 MHz core clears by 11.05 MHz | Per-band clock plan (GX-5); B44 front end | `B44` |
| RF-DUPLEX | Simultaneous TX+RX on one LO: validator accepts filter-RX + tx_dac_direct and filter-TX + rx_direct; TX->RX isolation >= 30 dB; RX works with -30 dBm self-leakage | digital (validator) + rf_rx + rf_tx + pads | — | **unverified** | Hardware paths exist (rf_tx README, bbfilter decode); validator/warm-hop acceptance and isolation not checked | GX-3 validator rule + RTL test; GX-9 isolation sim with COB model | `B43` |
| RF-RADAR | CW-Doppler (offset IF), FMCW (external ramp <= 83.5 MHz or +-20 MHz digital chirp), stepped-frequency; leakage <= -30 dBm at RF_RX | FPGA + board (B43) + rf_rx | — | **unverified** | No system sim; depends on RF-DUPLEX | RF-DUPLEX + leakage/PN-correlation system sim | `B43` |
| RF-BLE-CTE | BLE AoA/AoD CTE: switch via FPGA GPIO +-125 ns to sample index; filter settles <= 2 deg in 0.5 us; gain/DC/LO hold; RF_TX survives 100 ns hot switch | FPGA + digital (IX-8) + rf_rx + rf_tx (GX-8) + board (B41) | — | **unverified** | No antenna-switch step-response or hot-switch sim | Step-response sim at the CTE bw code; GX-8 open/short sim; IX-8 marks + published latency (HL-MARK) | `B41` |
| RF-SDR-CAPTURE | Gap-free I/Q stream 40/20/10/5 MS/s >= 1 h, span >= 36 MHz (wide code), concurrent multi-protocol RX, RSSI +-3 dB after cal | digital (transport) + rf_rx + FPGA | — | **unverified** | No soak test; span limited by widest corner 11.3 MHz worst corner | Transport soak test; GX-1; per-board gain-table cal | `rf_bb_external_adc` |
| RF-SDR-SCAN | Spectrum scan: warm hop <= 50 us/step, gain tagged per step; 2.2-2.7 GHz in <= 2 ms | digital (warm hop) + board (B35/B42) | — | **unverified** | Warm hop 50 us allocated; external synth range not specified beyond 2.4-2.5 GHz | Warm-hop RTL test; B42 synthesizer range | `B42` |
| RF-SELFTEST | Loopback BIST: IRR, LO leakage, filter corner/Q-trim, DC table, gain steps via mute-leakage loopback | FPGA + digital (GX-3) + rf_rx + rf_tx | — | **unverified** | Leakage 22-24 dB measured; recipe not written | GX-3 duplex config; FPGA recipe into D-CAL-1 | — |
| RF-PROF-SWITCH | Atomic profile switch (LO hop + bw/wide + rx_direct/tx_dac_direct + gain) at a warm-hop epoch <= 50 us | digital (regfile update class, warm hop) + rf_rx | — | **fails** | consolidation.bbfilter.* fields are stopped-only today | GX-4 epoch-updatable bbfilter fields | — |
| RF-MULTICHIP | Phase-coherent multi-die: one LO, one H2D-derived sample clock, sync_arm aligns sample epochs to the same sample; inter-die phase drift <= 2 deg rms / 10 min after cal | digital (clocktree sync) + board (B45) | — | **unverified** | sync_arm/sync_epoch exist; cross-die determinism not verified | GX-7 deterministic sync latency test | `B45` |
