deepai-org/svalbard/benchmarks/digital-0007-lnp64-complete-soc/solution/README.md

# Build the solution

`mini_candidate/` is an intentionally incomplete negative-control fixture, not
a solution. It exists to pilot the verifier and contains no processor. Implement
the complete SoC and meet the verifier contract; reference assets define behavior,
not construction.
