deepai-org/svalbard/benchmarks/digital-0008-quad-uart-controller/THIRD_PARTY.md

# Third-party inputs

The environment uses the open GF180MCU PDK and open IIC-OSIC tool image. No
third-party source is copied into this benchmark.
