deepai-org/svalbard/projects/programmable_transceiver_platform/analog/bringup_control/generated/pt_wtx_fallback_control.png

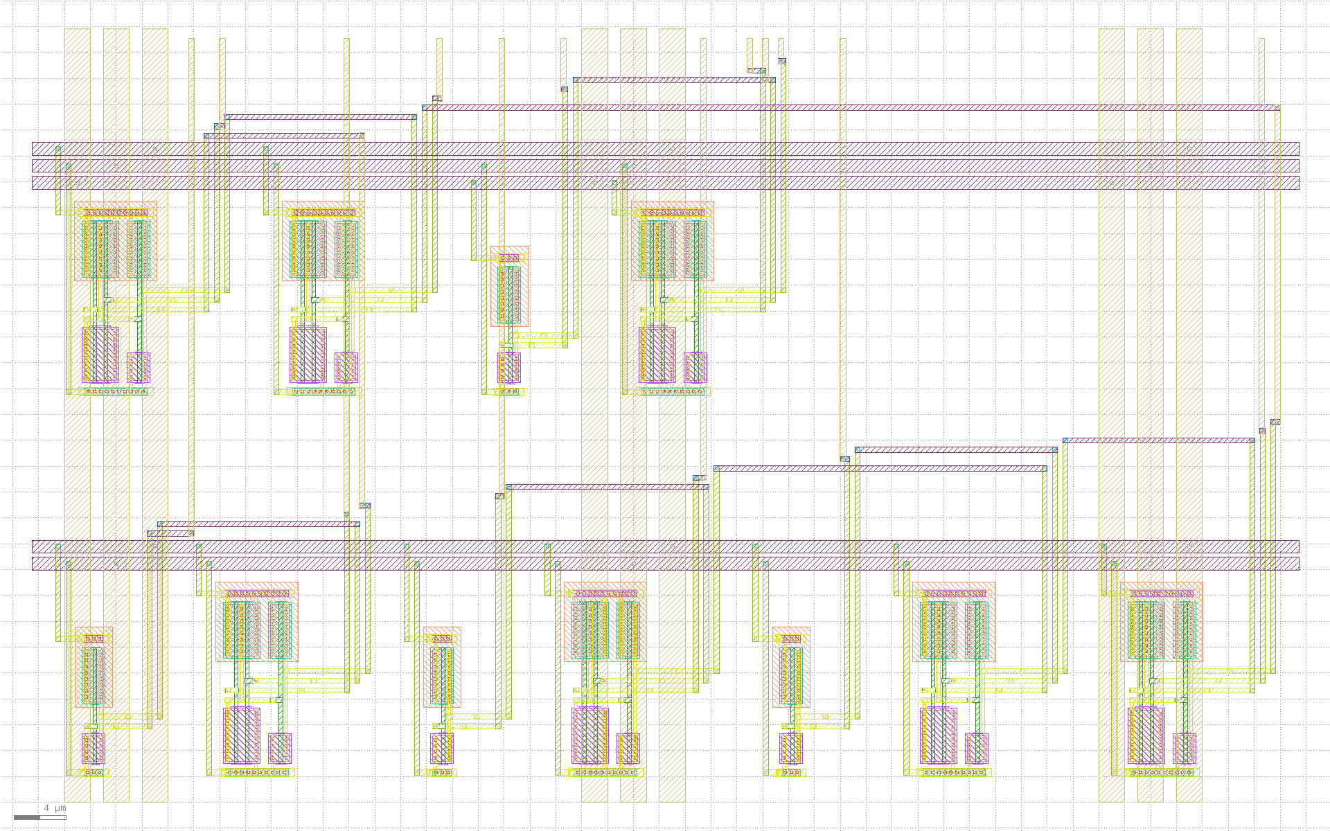
projects/programmable_transceiver_platform/analog/bringup_control/generated/pt_wtx_fallback_control.png
