deepai-org/svalbard/projects/programmable_transceiver_platform/spec/risk-register.md

# Transceiver risk register

The single risk register for the GF180 programmable transceiver. Other documents cite these IDs and keep no risk lists of their own.

**220 risks:** open 133, demanded-mitigation 61, risk-accepted 11, mitigated 9, closed 6.

**Status:** *open* = unresolved or analysis pending; *demanded-mitigation* = a fix is demanded and not yet proven; *risk-accepted* = the residual is accepted; *mitigated* / *closed* = kept only because the row records a rule that must keep being obeyed. **Score** = likelihood × impact (each 1–5). Rows are sorted open and demanded first by score, then accepted, mitigated, closed.

To add a risk: append a row with the next free number in its prefix, a score, status, mitigation/owner and one evidence path (`scratch/` paths are relative to the repository root, others to this project). Change status in place; delete a row when its fix is fully embodied in the design and leaves no standing rule. IDs are never reused; *aka* lists merged IDs.

| ID | Score | Risk | Block | Status | Mitigation / owner | Evidence |
|---|---|---|---|---|---|---|
| DIG-01 | 25 | Digital macro is not hardened on the current RTL and setup does not close: post-synthesis worst slack −2.39 ns on the reference clock group | digital, timing | open | Pipelining review, setup closure, harden with the hold flow, routed OCV sign-off, GLS, timing at 3.50 V. — *digital* | `scratch/digital-timing-close/NOTES.md` |
| HL-06 | 25 | Payload throughput depends on the unclosed host word clock; raw 1.25 GBd wired streaming is not carried until digital timing closes | digital, pads | open | Digital timing closure; long frames and the reversible north bank give margin; reduced-rate modes and SPI capture are the fallback. — *digital* | `scratch/reviews/host-link-bandwidth.md` |
| INT-03 (aka INT-01, INT-02, INT-11, INT-24, DIG-02) | 25 | The design does not fit the fixed 3.932 × 5.122 mm die (core 12.772 mm²): short 2.1–2.3 mm² with staged cells as measured, 1.3–1.75 mm² with every repack target met, before routing (1.1–2.3 mm² needed, 0.8–1.0 available) and decap. With die-fit levers 1–5 and the off-chip passives items: 0.03–0.18 mm² short (targets met), 0.65–0.73 mm² (staged) | assembly, all owners | open | Area is a standing objective for every owner; coordinator keeps the ledger and reruns the packer; every change reports its area delta. No scope cut. — *coordinator / all owners* | `scratch/reviews/die-fit.md` |
| MOD-00 | 25 | GF180 device and passive data are not validated at GHz: no RF MOS model (no gate resistance, NQS or induced gate noise), no silicon-correlated inductor, varactor, MIM or pad models, unknown accuracy of corners, mismatch and flicker | all analog | demanded-mitigation | Two-sided pessimistic values from `spec/design-assumptions.md` in every sign-off bench; explicit Rg; trim range covering the bound; on-die characterization structures readable on die 1; external fallbacks. — *coordinator / all owners* | `scratch/reviews/model-uncertainty-audit.md` |
| WRX-01 (aka WRX-16, WRX-18, MOD-12) | 25 | CDR closed loop is unproven on the published cell: `pt_cdr` r13 is published but its extracted closed loop (lock, hand-over, tracking, vote-injection spread) is not evaluated | wired_rx, timing, digital | open | Extracted closed loop on r13 with both real rings at every in-window corner; FPGA oversampling and forwarded clock on AUX_CLK are the fallbacks. — *wired_rx* | `analog/wired_rx/README.md` |
| WRX-06 | 25 | No receive path exists above 2.5 Gb/s (DP HBR 2.7, SATA Gen2 3.0, 3.125 Gb/s): the interleaved path (R8-ARCH) is not designed and no evidence chain passes above 2.5 Gb/s | wired_rx | open | Design the interleaved >2.5 Gb/s capture; produce the chain rate × corner × supply table. Board retimer is a fallback only. — *wired_rx* | `scratch/wired_rx/r8arch/decision.md` |
| WRX-20 (MW-13, MW-23) | 25 | The CTLE collapses with its real load: extracted ctle → rxselect → slicer gain at 1.25 GHz is −8.0 dB tt / −9.6 dB ss (bench with 150 fF: +2.1 dB), and the CTLE output common mode is 1.3–1.66 V against slicer benches at 1.0 V | wired_rx | open | Approved fix: source follower driving the slicer directly (+6.3 mA), slicer requalified at about 0.4 V common mode. Follower not built; chain requalification not done. — *wired_rx* | `scratch/wired_rx/r9chain/res.json` |
| INT-04 | 20 | Observation is unbuilt: block observation taps, ATB codes and ring-monitor readout codes are not all assigned or wired, so a partially working die cannot be told from a dead one and the per-chip supply trim cannot be chosen | integration, digital, pads | open | One line per block: code, leaf placed, simulated; no block freezes without it. — *chip top / digital* | `spec/tapeout-readiness.json` |
| INT-13 (aka INT-27; TOP) | 20 | No routed, signed-off top level exists. `integration/top/pt_chip.conn` binds every pin (0 unbound) but its regression is not clean (12 unbuilt instances, 4 staged converters), the control plane is proven only in a stub simulation, and no top-level DRC, LVS, antenna or extraction has run on a routed chip | assembly, digital | open | Follow `spec/tapeout-plan.md`; floorplan v7 with supply grid, ten islands and placement rules; top-level LVS against the conn-generated netlist. — *assembly; chip top* | `integration/top/pt_chip.conn` |
| LO-01 | 20 | The QVCO runs at the RF carrier, so the PA and the RF pads can pull it | timing, assembly | open | Placement rule: QVCO spiral centres ≥ 1.7 mm from the west die edge and ≥ 1.0 mm along it from the RF pads; QVCO not placed yet. — *assembly; LO owner* | `scratch/reviews/integration-m23.md` |
| LO-04 | 20 | The on-chip LO synthesizer is not closed: `lo_mmd` repack regressed in maximum frequency (review NO-GO), the loop is unproven (preset, lock 60–65 µs at the slow filter corner), QVCO is not verified with real tank loads, and the QVCO top cell has no netlist or ports (only the core was LVS'd) | timing, digital | open | Close MMD, loop and QVCO top netlist/LVS; external LO is the fallback. — *LO owner* | `scratch/lo-ap4/NOTES.md` |
| LO-05 | 20 | External LO drive against the pad clamp: about 2 Vpp at the pad needs about 4 Vpp open-circuit and was never co-simulated with the pad at ff. Decision pending LO confirmation: swap REF_IN with BB_Q and use low drive (about 1 Vpp) | timing, pads, board | demanded-mitigation | Co-simulate `lo_ext` with the pads and the package channel at in-window corners; confirm I/Q error at low drive. — *LO owner* | `analog/timing/generated/lo_ext-evidence.json` |
| MOD-05 | 20 | Evidence does not match what ships: of 51 evidence files 6 are fully fresh, 43 cite a source whose hash changed, 2 carry no hashes; digital hardening evidence predates the current RTL | all | demanded-mitigation | Run the freshness script in the readiness gate; sha-matched evidence per published GDS; adversarial evidence audit not started. — *integration* | `scratch/reviews/pre-mortem.md` |
| MOD-06 | 20 | GDS cell-name collisions across blocks and duplicate extracted subcircuits | assembly, all analog | demanded-mitigation | Uniquify on publish; assembly renames on import; collision check in the Makefile. — *assembly* | `analog/gds_uniquify.py` |
| MT-03 (aka INT-26; SG-2, SG-3, SG-4) | 20 | Fill is not a flow step and no block carries a fill keep-out marker. The live precheck gates on density and DCF.1a (1296 violations on the existing top). Stock fill lands in the QVCO spirals (tank wire C +83–97 %, estimated f0 −3…−10 % against a 2.6–3 % band margin) and shifts the ring oscillator by about −1 % | assembly, timing, all analog | open | Top-level fill with block-owned keep-out markers; fill-aware re-extraction of sensitive blocks, inductors first. — *assembly; block owners* | `scratch/reviews/signoff-gap.md` |
| RFR-01 | 20 | Receive noise figure misses: LNA pessimistic-corner NF 7.35 dB (tank Q); the chain NF has not been evaluated with the real LO levels (mixer conversion is 3–16 dB lower than with the ideal square LO) | rf_rx | demanded-mitigation | Larger tank coil (220 µm recovers 2.3 dB); close the LNA (RFR-12..14); chain NF with real LO drive; fallback LNA on the board. — *rf_rx* | `scratch/rf-lna-p/NOTES.md` |
| RFR-12 | 20 | The LNA needs a low-inductance source return that the fixed 74-wire bond layout cannot give (no down-bonds, no extra wires; ground wires 2.0–2.9 mm). Decision: on-chip degeneration, source pads withdrawn; the LNA ground must be re-planned on standard fingers. Netlist and layout not done | rf_rx, pads, assembly | demanded-mitigation | On-chip centre-tapped degeneration; re-extract; refit the board match. — *rf_rx; pads* | `scratch/rf-lna-p/NOTES.md` |
| RFR-14 | 20 | LNA is NO-GO on stability: common-mode input resistance is negative with supply and ground bond inductance in the loop; published stability rows are differential only, stop at 12 GHz and pass with under 1 Ω margin | rf_rx, pads, PDN | open | No bond or pad in the degeneration path; common-mode bench with two-sided supply/ground inductance and on-chip decap, numeric margin, sweep to 30 GHz, must-fail self-test; RF-island decap sized from it. — *rf_rx; power delivery* | `scratch/review-lna3/REPORT.md` |
| WRX-02 | 20 | Slicer: 2.5 Gb/s fails at ss; trimmed offset misses the 20 mV target; never qualified at the common mode the CTLE fix delivers | wired_rx | open | Requalify at about 0.4 V common mode with the real CTLE source and real clocks; widen the trim range. — *wired_rx* | `analog/wired_rx/generated/slicer-evidence.json` |
| WRX-21 (aka WRX-15; MW-14) | 20 | `pt_ptrim` cannot drive the real clock loads (CKP0 about 1 pF, others 0.37–0.48 pF): CKP0 does not reach the rails at tt and the trim range collapses at ss. Slicer and capture were only benched with ideal clocks. `pt_ptrim` has no evidence file | wired_rx, timing | open | ptrim redesign and CKP0 load fix, then a ring → ptrim → slicer → capture bench. Not built. — *wired_rx* | `scratch/wired_rx/r9ptrim/results.json` |
| WTX-07 (aka WTX-01, WTX-06; MW-31) | 20 | Published `pt_wiredtx` fails 2.5 Gb/s at ss/32 °C/3.15 V when clocked by the real TX ring (11 errors in 101 bits; ideal phases 0 errors). Cause: ring phase duty 0.57–0.58 at ss | wired_tx, timing | open | Rising-edge-only windows in the serializer; phase buffer duty 50 ± 2 %; rerun over corners, supplies and pessimistic values. — *wired_tx / timing* | `analog/wired_tx/generated/wiredtx-realring.json` |
| WTX-08 (MW-24) | 20 | No transmit path closes above 2.5 Gb/s at ss after extraction | wired_tx, pads, digital | open | Topology with no one-slot pulse on any CMOS node (CML final stage); pad switch re-layout. In progress. — *wired_tx* | `analog/wired_tx/README.md` |
| DIG-03 | 16 | Command/response latency exceeds the USB HS turnaround gate at the achieved clock | digital | open | Recheck with the latency model after timing closure; board USB PHY fallback (B8). — *digital* | `scratch/reviews/performance-review.md` |
| HL-03 | 16 | Host pad timing at full rate: board/FPGA window, simultaneous switching and D2H pad electricals are not closed; reset drive/slew does not reach full rate | pads, digital, board | demanded-mitigation | Fast slew plus launch stagger at full rate, per-direction rate, FPGA bank selection, board SI. — *digital; board* | `scratch/reviews/host-link-bandwidth.md` |
| INT-05 | 16 | Residual DRC and antenna items outside block generators: the antenna deck gives 436 violations on the existing top (it completes only with one worker on the old KLayout) | assembly, pads | open | Fix at the source generators; top-level antenna after routing (AN-01). — *assembly / pads* | `scratch/reviews/signoff-gap.md` |
| LO-11 (PD2-11) | 16 | QVCO supply pushing: the QVCO rail needs a regulator with far more rejection than the existing regulator variant gives; spur limit −60 dBc per tone / 0.2 ps. The regulator is laid out at 0.44 mm² and not qualified against that limit | timing, power | demanded-mitigation | Requalify and shrink the QVCO regulator; PA-envelope pulling unquantified. — *LO owner; power delivery* | `spec/power-delivery.md` |
| MT-01 | 16 | Well-proximity, LOD and mirroring effects on slicer, comparator and CML pairs | wired_rx | demanded-mitigation | Symmetric well edges and dummies; trim range ≥ ±40 mV. — *wired_rx* | `scratch/reviews/physical-limits.md` |
| PAD-02 | 16 | Core-side gates on pad nets over the HBM screen in some paths | pads, timing, wired_rx, rf_tx | demanded-mitigation | 6 V or MIM-coupled inputs on pad-tracking nodes; rerun the core screen per case. — *pads / block owners* | `analog/pads/hbm_core_screen.py` |
| PAD-09 | 16 | HS pad termination metal resistance: the Metal4 trunk between the legs adds about 41–44 Ω differential (142 Ω at the default code at tt; ss cannot reach 100 Ω). Pad extraction is C-only, so no AC or return-loss evidence sees it | pads, wired_rx | open | Fix `pt_hs_leg`; resistance-aware extraction for all pad families. — *pads* | `scratch/reviews/pads-core/hspad-REVIEW2.md` |
| PDN-02 (aka PDN-10; PD2-6) | 16 | Decap does not close on decap alone: the plan depends on the digital macro's real current shape (78.125 MHz component cut to 10 %), which is not measured; over-block MIM shrinks after the repacks | digital, assembly | open | Clock-launch staggering and per-mode power analysis in digital; decap replanned after repacks. — *digital; power delivery* | `spec/power-delivery.md` |
| PDN-09 (aka PDN-05) | 16 | No top-level supply grid exists; static drop is a requirement, not an extraction (worst tap 106.4 mV of 117 mV with a 15 % Metal5 / 15 % Metal4 grid). Island strap routing conflicts with supply-pad positions for the lod, pll and wired_tx islands | assembly | open | v7 floorplan with the grid of `spec/power-delivery.md`; extract and check at 85 °C. — *assembly; power delivery* | `spec/power-delivery.md` |
| PKG-05 (aka BW-02) | 16 | External-LO pad amplitude depends on pad C and the package resonance | pads, timing | demanded-mitigation | LO input tolerant of amplitude; adjustable board LO level set per board through clock observation. — *LO owner; board* | `spec/package-channel.md` |
| PKG-06 | 16 | Board decap is reachable only through eight 1 µF capacitors on the COB supply nets or beyond the connector | digital, assembly | demanded-mitigation | On-die decap plan of `spec/power-delivery.md`. — *power delivery* | `spec/power-delivery.md` |
| PKG-07 | 16 | No plate under the die (the connector occupies the back side); the die is under glob-top | board | demanded-mitigation | Board thermal path per `spec/board-requirements.md`; per-mode dwell after a mode change. — *board* | `spec/package-channel.md` |
| PKG-08 | 16 | Host simultaneous-switching noise with the real ground bond set | pads, digital | demanded-mitigation | D2H slew control and drive limit; FPGA per-bit deskew. — *digital; pads* | `spec/package-channel.md` |
| PWR-12 (INT6-0) | 16 | A fast supply edge fires the supply-pad RC clamps: a 1 µs edge gives 8.7–10.3 A through the bonds and rings the die rail to 5.7–6.4 V | pads, board | demanded-mitigation | Board rule: supply slew ≤ 0.3 V/µs at any point of any rise, no hot-plug. — *board* | `scratch/reviews/pads-core/CLAMP.md` |
| PWR-13 (INT6 finding 4) | 16 | With the POR strap set, `por_bypass` removes the power-on reset unless RESET_N is low through power-up; with RESET_N high and SCLK toggling the island enables can load 1 during the ramp | digital, board | demanded-mitigation | Board rule: RESET_N host-drivable and held low through power-up whenever the strap is set; brownout and slow-corner ramps of the power-up check not run. — *board; chip top* | `scratch/reviews/integration-m6.md` |
| RFR-11 | 16 | RF_RX in-band match holds only with a per-board tuned network (B25, mandatory) and has not been shown on the real COB channel; B18/B25 are not met. `generated/lna-evidence.json` is stale | rf_rx, board | open | Refit after the LNA closes; qualify through the whole channel at both pessimistic ends. — *rf_rx; board* | `scratch/rf-lna-p/NOTES.md` |
| RFR-13 | 16 | The assumed board match network is not buildable on the COB: no signal footprints; the nearest passive is on the carrier, ≥ 6.5 nH per leg away. One fixed BOM plus one trimmer fails over tolerance | rf_rx, board | open | Higher on-chip input resistance; refit on the real channel at connector + 2 mm and 10 mm; fallback-LNA path not simulated. — *rf_rx; board* | `scratch/rf-lna-p/NOTES.md` |
| RFT-01 | 16 | RF TX linear output power is below the 0 dBm target at ss; needs per-part bias and drive calibration | rf_tx | demanded-mitigation | Recover chain gain; firmware calibration of image and LO suppression; external PA is the fallback. — *rf_tx* | `analog/rf_tx/generated/rf_tx-sim-ext.json` |
| RFT-03 | 16 | TX linearity, EVM, ACLR, mask and harmonics unverified through the real DAC, filter and pad | rf_tx, converters | open | Mask/EVM run through the real chain; back-off rule. — *rf_tx* | `analog/rf_tx/README.md` |
| RXR-01 | 16 | Pre-filter headroom and early-gain range for the maximum input level | rf_rx, digital | demanded-mitigation | TIA feedback steps plus LNA attenuation, ≥ 30 dB in ≤ 6 dB steps; AGC uses bypass last. — *rf_rx; digital* | `scratch/reviews/rx-robustness-review.md` |
| SUB-01 | 16 | Digital macro next to the I ADC: the 210 µm floor is nominal only; the pessimistic bound needs the decap plan and more distance | converters, assembly | demanded-mitigation | Distance and guard rule in v7; deep n-well only if shown necessary and confirmed available. — *assembly; converters* | `scratch/reviews/integration-m23.md` |
| WRX-08 | 16 | No wired jitter, phase-noise or jitter-tolerance evidence; signal detect needs a threshold redesign; OOB/electrical idle unverified | wired_rx, timing, wired_tx | open | Jitter simulation of rings and CDR; detect redesign; OOB timing. — *wired_rx; timing* | `analog/wired_rx/README.md` |
| WRX-19 (aka WRX-11) | 16 | DP HBR jitter tolerance at 0.5 MHz needs about ±4000 ppm tracking; depends on phase-detector latency ≤ 2 ring cycles and a fast linear integral, proven only in a model | wired_rx, digital | open | Extracted closed loop at HBR settings. — *wired_rx* | `scratch/wired_rx/r8impl/cdr-arch-decision.md` |
| WRX-22 (aka WRX-09, WRX-12) | 16 | Capture r7c (staged) fails one case: the word-restart (LDE) edge lands on the capture clock edge. Earlier revisions sample phase-detector votes before they settle at ss. The published capture evidence is stale and records safe and clean as fail | wired_rx | open | Fix the LDE timing, pass the extracted gating set, independent review, publish. — *wired_rx* | `scratch/wired_rx/r7cap/STATUS.md` |
| WTX-03 | 16 | Wired TX swing and jitter miss: swing below the PCIe 800 mVppd minimum at ss/3.15 V, serializer deterministic jitter above the 0.25 UI budget, TX pad C at its limit | wired_tx, pads | open | Raise swing, reduce DJ, trim pad C; report untrimmed and trimmed-supply results. — *wired_tx* | `analog/wired_tx/README.md` |
| XT-01 | 16 | External LO I/Q bundle across the die | timing, assembly | demanded-mitigation | Shielded coplanar bundle, I and Q matched in length, layer and load; fill keep-out over it. — *assembly; LO owner* | `scratch/reviews/physical-limits.md` |
| XT-08 (aka IQ-01) | 16 | External-LO bond leakage into RF_RX: bond-wire mutual inductance couples REF_IN/AUX_CLK into the RF_RX pair (0.89 mm apart). The LO re-radiation limit fails at 4 Vpp drive at every bound, independent of the floorplan; self-mixing DC stays inside the coarse trim | pads, timing, rf_rx | open | Low LO drive (about 1 Vpp) and the REF_IN/BB_Q swap (LO-05); otherwise waive the leakage limit in external-LO mode. — *coordinator; LO owner* | `scratch/reviews/integration-m23.md` |
| DIG-07 | 15 | Hold sign-off has no on-chip variation and uses a self-characterised Liberty with no foundry cross-check; smallest hold slack is tens of ps in the SPI/regfile domain that the no-dead-chip plan rests on | digital | open | Routed sign-off with an OCV view on clock networks, the foundry ff library as a bound, and 3.50 V rows. — *digital* | `scratch/reviews/pre-mortem.md` |
| INT-14 (aka INT-28; SG-6) | 15 | Version drift against the live precheck (1.7.4, PDK 792ef67): the project's PDK deck, KLayout, Magic and device-model commits differ; the live deck adds DCF.1a; the live image is amd64-only and has not been run here; `processes/gf180/process.lock` is empty | integration | open | Run the live precheck on an amd64 host on the top and representative blocks; fill in the process lock. — *integration* | `scratch/reviews/signoff-gap.md` |
| MOD-18 (aka INT-19; SG-1) | 15 | A GDS export can change devices without failing LVS on the in-memory layout (a dropped HRES marker once built resistors at one third value). Read-back LVS is clean on 74 blocks but is not a gate in the flows | integration | demanded-mitigation | Rule: LVS on the GDS read back from disk, with device parameters compared and a failing negative control, for every published block and the top. — *integration* | `scratch/reviews/signoff-gap.md` |
| PWR-01 | 15 | Wired RX capture safe-state current above the 10 µA limit | wired_rx | open | Fix in the capture repack; recheck extracted. — *wired_rx* | `analog/wired_rx/generated/wrx_cap-evidence.json` |
| USB-02 | 15 | USB transmit: `pt_usb_txdrv` rev 3 is unreviewed; HS level 351 mV at ss/3.15 V (400 mV needs 3.33 V); LS slow mode needs `usbhs.bias.enable` with no hardware interlock; USB HS bit repetition not in RTL | wired_tx, pads, digital | open | Independent review; supply trim for slow dies; interlock or validator rule. — *wired_tx; digital* | `analog/wired_tx/USB-INTEGRATION.md` |
| WRX-04 | 15 | Wired RX return loss is package-limited: about 10 dB at 1.25 GHz with no margin, 5.7–6.5 dB to 2.5 GHz | wired_rx, pads | demanded-mitigation | On-die pad C and termination trim; optional carrier ladder; qualify through the whole channel. — *pads* | `spec/package-channel.md` |
| AN-01 | 12 | Antenna ratio on long top-level routes into small gates | assembly | demanded-mitigation | Top-level antenna check after routing; jumpers or diodes at the gate. — *assembly* | `scratch/reviews/signoff-gap.md` |
| AON-01 | 12 | `aosc.EN` and two `core_bias` ring enables float in the assembly binding (aosc draws up to 1.79 mA); register default and analog documentation disagree on the aosc enable | timing, digital, assembly | open | Bind in the conn; K1 enable rules in the top regression. — *chip top; digital* | `scratch/reviews/always-on-audit.md` |
| BRD-01 | 12 | RF_TX needs a board DC feed and tuned match; the external-PA route is weak | rf_tx, board | demanded-mitigation | Board contract in `spec/board-requirements.md`. — *board / rf_tx* | `spec/board-requirements.md` |
| BRD-02 | 12 | No carrier design, FPGA gateware or bring-up software exists; there is no NVM on the die, so every trim is reloaded by host software from board storage that is not designed | board, fpga | open | Paper carrier design and FPGA pin check against `spec/board-requirements.md`; deliverable is the list of obligations that cannot be built. — *unowned* | `scratch/reviews/pre-mortem.md` |
| CNV-05 | 12 | DAC current-source mismatch not simulated; analytic estimate gives a material INL yield loss at twice the PDK mismatch | converters | open | Mismatch run or larger cells. — *converters* | `scratch/converters-ap4/NOTES.md` |
| DBG-02 | 12 | Clock-observation tap loading the LO | timing, assembly | demanded-mitigation | Minimum-size buffer at the LO hub, off by default. — *LO owner* | `scratch/lo-ap4/NOTES.md` |
| DIG-04 | 12 | Digital max-slew and max-capacitance violations in the last hardened macro | digital | open | Re-harden the current RTL and recheck. — *digital* | `evidence/digital-hardening-evidence.json` |
| ESD-02 | 12 | ESD targets are tiered (2 kV HBM on supplies, host, debug, RF_RX, HS RX pair, USB; 1 kV on RF_TX and WIRE_TX; CDM ≥ 250 V). CDM is not verified | pads | demanded-mitigation | VF-TLP on the TLP site; board TVS on antenna and USB connectors; transient oxide limit for 150 ns events. — *pads* | `scratch/reviews/esd-tiering.md` |
| HL-01 | 12 | Reversible host bank: contention if the FPGA drives after the chip enables its outputs | digital, pads, board | demanded-mitigation | Readback-mismatch tri-state with sticky status; protocol rule on the FPGA side. — *digital* | `scratch/reviews/host-link-bandwidth.md` |
| INT-10 | 12 | Spec JSON files lag the connectivity source of truth: `spec/package-channel.json` west pad order against the bond map, `spec/analog-architecture.json` nets (older architecture), `netlist.py` not switched to the conn | integration | open | Regenerate from `integration/top/pt_chip.conn`; one owner per file. — *chip top* | `scratch/reviews/integration-m23.md` |
| INT-29 | 12 | Most block GDS and the top exist only on one nearly full disk outside git; several flow scripts exit zero on truncated output | integration | open | sha256 manifest of every inventory GDS in git; off-box snapshot of GDS and tool images. — *coordinator* | `scratch/reviews/pre-mortem.md` |
| IQ-03 | 12 | LO-I and LO-Q enter through different pad masters | pads, assembly | demanded-mitigation | Extract both pad paths; equalise the lighter leg. — *pads* | `scratch/reviews/pads-core/LO-PAD-OPTIONS.md` |
| ISL-01 | 12 | Island switch drop needs the island grid strapped to the edge bars; strap routing conflicts with supply-pad positions (PDN-09) | island_support, assembly | demanded-mitigation | Loads abut their switch; straps per `spec/power-delivery.md`. — *assembly* | `spec/power-delivery.md` |
| LO-10 | 12 | QVCO range at the two-sided spiral bound (L ±15 %): with the real tank loads the range sits about 4 % lower and misses at the top by 1.9 %; fill not included | timing | open | Fill keep-outs (MT-03); re-extract with real loads; add band capacitance if needed. — *LO owner* | `scratch/lo-ap4/NOTES.md` |
| LO-13 | 12 | LO jitter closure holds only for Kvco ≤ 200 MHz/V in the locked window; not extracted at the pessimistic tank | timing | open | Extracted Kvco at the window ends; adjust loop rule if higher. — *LO owner* | `analog/timing/lcvco/loop_design.json` |
| LO-15 (LO26) | 12 | QVCO tank loading by the MMD, its dummy and `lo_obs`: the published pair gives 9° of quadrature error and 9 % I/Q amplitude imbalance (staged pair 0.5°) | timing | open | Publish the matched staged pair; QVCO benches with the real tank loads. — *LO owner* | `scratch/lo-ap4/NOTES.md` |
| LU-03 (INT6 finding 7) | 12 | External drive into an unpowered chip or island: RF_TX, WIRE_TX and USB pads have a path into a switched rail | pads, board | demanded-mitigation | Board rule: chip powered before LO source, link partners or sinks drive; back-drive pins open in pads. — *board; pads* | `scratch/reviews/integration-m6.md` |
| MOD-01 | 12 | MOS models omit gate resistance and induced gate noise; several RF and high-speed benches still lack explicit Rg | all RF owners | open | Rule: explicit Rg (60–150 Ω per 10 µm) in RF and high-speed sims. — *block owners* | `scratch/reviews/model-uncertainty-audit.md` |
| MOD-02 | 12 | Sign-off simulations lack package, substrate and coupled-route models at chip level | assembly | open | Extract critical top-level nets and resimulate each chain before sign-off. — *assembly* | `scratch/reviews/integration-plan.md` |
| MOD-07 | 12 | Checks that cannot fail or whose limits were relaxed after the result | all | open | Rule: limits do not follow measurements; every bench has a failing negative control. — *integration* | `scratch/reviews/performance-review.md` |
| MOD-08 | 12 | Pad and ESD capacitance, clock quality and assembly inductance are assumptions with no test structure | pads, converters, timing | open | Joint sweeps; calibrate ESD models on the TLP site. — *pads* | `scratch/reviews/model-uncertainty-audit.md` |
| MOD-11 | 12 | Package model is analytic; connector S-parameters unpublished | board, pads | open | EM solve or measurement; rerun RF and multi-Gb/s paths with the per-bond table. — *pads* | `spec/package-channel.md` |
| MOD-16 | 12 | rf_tx unverified for wire/via resistance, package, substrate, noise and mismatch; no gate resistance in its benches | rf_tx | open | Rg-annotated extracted rerun through the package channel. — *rf_tx* | `analog/rf_tx/README.md` |
| MOD-17 | 12 | Master bias relies on locally patched vendor biasgen/bandgap with C-only extraction and no mismatch run; the bandgap is not powered down by its enable (71 µA) and VBG overshoots to 3.2–3.5 V for 3.7 µs at enable | core_support, digital | open | Per-die trim; ATB force of VBG as fallback; gate consumers until VBG settles. — *core_support* | `scratch/reviews/always-on-audit.md` |
| MOD-20 | 12 | No evidence file exists for `pll_ring_core`, `clk_obs16`, `obs_pre4`, `lo_mmd`, `lo_mmd_qdum`, `lo_pfdcp`, `lo_lf` or `lo_obs` | timing | open | Evidence record with source and GDS hashes per published block. — *LO owner; timing* | `analog/timing/README.md` |
| PAD-03 | 12 | USB pad HS termination is in spec only with per-corner calibrated trim codes; the calibration path needs wired-RX ATB leaves and a trimmed HS reference | pads, wired_rx, digital | demanded-mitigation | Firmware calibration through ATB; reset code must not shunt the pad. — *pads; digital* | `analog/pads/README.md` |
| PAD-04 | 12 | Host-pad backfeed into the unpowered ring | pads, board | demanded-mitigation | Board bus switch (B6). — *board* | `spec/board-requirements.md` |
| PAD-11 | 12 | An unconfirmed 16–17 Ω bond-pad-to-device metal resistance in the shared pad shell would change the HBM evidence of every pad family | pads | open | Confirm with resistance-aware extraction; rerun HBM screens if real. — *pads* | `analog/pads/README.md` |
| PDN-03 | 12 | Supply anti-resonance near the host clock | digital, assembly | demanded-mitigation | Damped decap bank sized in the power-delivery model. — *power delivery* | `spec/power-delivery.md` |
| PDN-11 (aka PLV-01, PDN-04) | 12 | Ring PLL regulator bypass is not an operating mode on the shared rail (deterministic jitter fails in every case); regulated mode passes only with a two-phase digital macro | pll_vreg, timing, digital | open | Bypass is the reset state and a bench fallback only; firmware clears it before payload. — *power delivery; digital* | `spec/power-delivery.md` |
| PKG-03 (aka BW-01) | 12 | Bond-wire crosstalk between neighbouring functions (RF_TX next to AUX_CLK) | rf_tx, timing, pads | demanded-mitigation | Pad assignment keeps a quiet site between aggressor and victim pairs; mutual inductance in the package model. — *pads* | `spec/package-channel.md` |
| PKG-04 | 12 | COB trace-length asymmetry: LO I/Q phase error and intra-pair skew | timing, board | demanded-mitigation | Carrier length compensation from the per-pin delay table; on-chip I/Q trim (TIM-07). — *LO owner; board* | `spec/package-channel.md` |
| PKG-09 (aka BW-05, INT-09) | 12 | Bond plan under the fixed layout is not re-audited: with a 250 µm die and real placement shift, corner-adjacent bonds exceed the 3 mm / 45° limits; `spec/contract.json` bond map is stale | pads, assembly | open | Bond audit with real wire, die thickness and placement shift; update `contract.json` and `package-channel.json`. — *pads* | `scratch/reviews/pads-core/BOND-AUDIT.md` |
| PWR-02 | 12 | The on-chip POR gives no reset on slow ramps (≥ 1 s) or brownout and its hold-off node tolerates only 200–400 pA of leakage | core_support, digital, board | demanded-mitigation | POR strap pad plus the pad-free keyed second reset path; board reset supervisor on RESET_N; sticky reset bits readable. — *digital; board* | `scratch/reviews/always-on-audit.md` |
| PWR-06 (PD2-6) | 12 | Digital current is unmeasured on the current RTL (no per-mode power analysis); ceilings and decap assume its requirement | digital | open | Per-mode power analysis after hardening. — *digital* | `spec/power-delivery.md` |
| PWR-11 | 12 | Island currents in block evidence exceeded the original switch design; re-partitioned into ten islands on the existing switch cells (worst drop 18.4 mV of 20 mV). Mode ceilings 360 / 260 / 340 mA hold only with the digital macro at its current requirement | island_support, digital | demanded-mitigation | Digital meets its current requirement (PWR-06); regulator stack-up and reliability at the 3.50 V trim not shown. — *power delivery; digital* | `spec/power-delivery.md` |
| RFR-03 | 12 | RF match across carrier placement and package tolerance (pad C sets the return-loss floor) | rf_rx, rf_tx, pads, board | demanded-mitigation | Programmable pad C trim and termination; per-pin channel benches. — *rf_rx / rf_tx / pads* | `spec/package-channel.md` |
| RFR-05 | 12 | IIP3, P1dB, blocker desensitisation and recovery unverified on the current chain | rf_rx | open | Linearity and blocker simulations on the closed LNA with real LO drive. — *rf_rx* | `analog/rf_rx/generated/rf_rx-summary.json` |
| RFR-06 | 12 | Wi-Fi sensitivity with real board losses is marginal | rf_rx, board | open | Low-loss filter/balun selection; fallback LNA. — *rf_rx; board* | `scratch/reviews/rx-robustness-review.md` |
| RFR-10 | 12 | Pre-LNA attenuator range has only 0.9 dB margin at ss and the match is not held while attenuating; must be redone on the new LNA | rf_rx, digital | demanded-mitigation | Re-verify on the closed LNA; register field. — *rf_rx* | `scratch/rf-lna-p/NOTES.md` |
| RFR-15 | 12 | RX ground is inconsistent in the connectivity file: the LNA and RF_RX pad are bound to `AGND_RX`, the mixers to `VSS`, and the conn still demands `pad_agnd_rx` instances that cannot exist on the fixed bond layout | rf_rx, chip top | open | Re-plan the LNA ground on standard fingers and rebind in `pt_chip.conn`. — *chip top; rf_rx* | `integration/top/pt_chip.conn` |
| RFT-06 | 12 | The TX chain has never been simulated with the real LO: benches use an ideal rail-to-rail square LO | rf_tx, timing | open | TX mixer and chain with the extracted LO buffer output. — *rf_tx* | `analog/rf_tx/README.md` |
| RXR-02 | 12 | Residual and dynamic DC offset times PGA gain against ADC full scale at zero IF | rf_rx, fpga | demanded-mitigation | Offset DAC at the PGA with a per-gain table in the FPGA; digital DC tracking. — *rf_rx; FPGA* | `scratch/reviews/rx-robustness-review.md` |
| RXR-04 | 12 | Co-located cellular and 5 GHz blockers: no front-end selectivity | board | demanded-mitigation | Board footprint for a 2.4 GHz coexistence filter (B34). — *board* | `scratch/reviews/rx-robustness-review.md` |
| RXR-07 | 12 | Antenna-port ESD and RF overload damage | rf_rx, pads, board | open | Board TVS on the antenna connector is mandatory (B36); transient at +10 dBm powered and unpowered. — *board; rf_rx* | `scratch/reviews/rx-robustness-review.md` |
| SP-01 | 12 | In-band clock harmonics on specific RF channels | rf_rx, fpga | demanded-mitigation | Frequency plan per channel in the FPGA recipe. — *FPGA* | `scratch/reviews/integration-m23.md` |
| TIM-01 | 12 | TSPC cell charge-sharing hazard in the /5 counter of the timing fast cells | timing, wired_tx | open | Extracted rerun at ff/22 °C/3.35 V. — *timing* | `analog/timing/LO-INTEGRATION.md` |
| TIM-07 | 12 | LO I/Q error through the extracted external-LO path needs a phase trim | timing, rf_rx, rf_tx | demanded-mitigation | I/Q phase and amplitude trim calibrated by firmware; `lo_ext` candidate staged, unpublished. — *LO owner* | `analog/timing/lcvco/run_lotrim.py` |
| TIM-08 | 12 | Forwarded wire clock on the AUX_CLK pair: the 25–810 MHz receiver bench, the 3.1 mm differential route and the pad-exclusion rule are not done; data mode start from a parked level fails | timing, wired_rx | open | Receiver bench through the package channel; debug island on in this mode. — *timing; wired_rx* | `analog/timing/generated/diff_clk_rx-evidence.json` |
| VER-KL1 | 12 | Concurrent prechecks of one block name share a work directory, so a published record can say antenna-clean for a GDS with violations; unplaced antenna-diode requests are not checked | verification | open | Rule: one work directory per precheck, sha of the file the deck read, fail on unplaced diode requests; until fixed run one precheck per block name at a time. — *verification* | `scratch/reviews/ap4-ctle-review/review.md` |
| WRX-23 (aka WRX-17) | 12 | CDR ring start: with a 1 µs enable ramp at the pessimistic ss corner the ring does not start; pessimistic tt with mismatch does not oscillate at the band bottom. Not diagnosed | wired_rx, timing | open | Diagnose small-first; confirm the real enable edge rate; add a start check and a mismatch run to the ring evidence. — *wired_rx* | `scratch/wired_rx/r9pub/ringstart/run.log` |
| WTX-02 | 12 | 40-bit wired word boundary timing between macro and serializer: setup/hold sweep not done | wired_tx, digital | open | SDC: data valid ≤ 1.0 ns after `WORD_CLK40`, held one period; extracted sweep. — *wired_tx / digital* | `analog/wired_tx/INTEGRATION.md` |
| XT-02 | 12 | LNA to mixer feeds unequal for I and Q | rf_rx, assembly | demanded-mitigation | Load-matched, shielded feeds. — *assembly; rf_rx* | `scratch/reviews/physical-limits.md` |
| XT-04 | 12 | DAC data and D2H routes next to converter references | converters, digital, assembly | demanded-mitigation | Shielded reference routes; DAC data static in RX-only modes. — *assembly; digital* | `scratch/reviews/physical-limits.md` |
| XT-05 | 12 | Routing corridor along the ADC edges: spacing alone is not enough for D2H lanes | converters, assembly | open | Shield under the lanes. — *assembly* | `scratch/reviews/integration-m23.md` |
| INT-30 (aka DNW-01) | 10 | Process options used but not confirmed in writing by wafer.space: deep n-well (the published rfdriver layout uses it), SAB/`_dss` devices. Native-Vt and 6 V devices, MIM option B and 1 kΩ/sq poly are allowed | pads, integration | open | Email to wafer.space; if deep n-well is used elsewhere, add the well diodes to the simulation netlists. — *coordinator* | `scratch/reviews/wafer-space-answers.md` |
| AON-03 | 9 | Tapeout sources of the island switch, ATB and isolation cells and the routed core_bias exist only in gitignored scratch | island_support, core_support | open | Commit sources or a sha manifest (INT-29). — *owners* | `scratch/reviews/always-on-audit.md` |
| CNV-02 | 9 | ADC input drive: buffer in the baseband filter not built; disabled-input load above its limit | converters, rf_rx | open | Buffer on the filter output path. — *converters / rf_rx* | `analog/converters/INTEGRATION.md` |
| CNV-03 | 9 | DAC dynamic linearity (SFDR, HD3) and clock feedthrough; staged DAC not published | converters | open | Route isolation of the DAC clock; requirement owner decides if the HD3 level is enough. — *converters* | `analog/converters/generated/dac_i-dynamic-sch.json` |
| CNV-06 | 9 | ADC `VCM` is a bare 40 kΩ divider with no decoupling, shared by two ADCs; every ADC bench used an ideal source | converters, core_support | open | Extracted real-source bench; MIM decap or a buffer if it shows a loss. — *converters* | `analog/converters/INTEGRATION.md` |
| CNV-08 (SG-7) | 9 | `adc_i` and `adc_q` are different builds: `adc_i` has 7 antenna violations and no KLayout DRC record | converters | open | Rebuild `adc_i` with the antenna diodes and publish its DRC record. — *converters* | `scratch/reviews/signoff-gap.md` |
| CNV-09 | 9 | All five converter evidence files are stale against their sources (netlists, `circuits.py`, `flow.py`, `benches.py` changed) | converters | open | Regenerate after the staged converters are reviewed and published. — *converters* | `analog/converters/generated/adc_i-evidence.json` |
| DBG-03 (INT6 finding 5) | 9 | ATB leaves on island trunk nodes and `VREF0_CONV` are not gated by their island: a closed leaf with the island off lets the bench forward-bias a diode into the dead rail. Gating decision conflicts between owners | island_support, digital | open | One decision: gate in RTL or keep the documented procedure. — *coordinator* | `scratch/reviews/integration-m6.md` |
| EMI-01 | 9 | Board coupling from host traces into RF and LO | board | open | Board rule: RF/LO and host on separate edges, ground stitching, no plane split. — *board* | `spec/board-requirements.md` |
| ESD-06 | 9 | rfdriver cascode under HBM at the 1 kV tier: screen passes, review pending | rf_tx, pads | open | Independent review. — *pads* | `analog/pads/README.md` |
| HL-02 | 9 | Host-link capacity for 3.0–3.24 Gb/s wired streaming needs long frames and per-direction rates | digital, fpga | demanded-mitigation | Sequenced after core timing closure. — *digital; FPGA* | `scratch/reviews/host-link-bandwidth.md` |
| HL-04 | 9 | HS-pair squelch, OOB, electrical idle and 100BASE-TX threshold features depend on threshold DACs and fast-threshold control that are not complete | wired_rx, digital | demanded-mitigation | Threshold fields and opcode. The in-band threshold opcodes 5 and 6 are decoded in `pt_core.sv` but rejected by the header legality check in `pt_quad_link.sv` (`legal_n` admits opcodes 0, 1, 2, 4 only), so the fast-threshold path reads as unreachable. — *digital / wired_rx* | `rtl/pt_quad_link.sv` |
| HL-05 | 9 | The system depends on FPGA reference gateware (training, DC restore, oversampling CDR, calibration) that is not written | fpga, board | open | Graceful degradation to low host clocks and narrow lanes; gateware specification. — *unowned* | `scratch/reviews/fpga-offload-audit.md` |
| HL-07 | 9 | Transport residuals: no payload CRC, bit slips, clock loss | digital | open | Negative tests; error budget. — *digital* | `spec/streaming-transport-v2.md` |
| HL-09 (INT6 finding 6) | 9 | Host inputs float with the FPGA unconfigured (up to 0.57 mA total; a floating CS_N can select the SPI slave) | pads, digital | demanded-mitigation | Schmitt inputs with pulls and a repeater at each SPI pad; pad work open. — *pads* | `scratch/reviews/integration-m6.md` |
| INT-16 | 9 | WIRE_RX/WIRE_TX P/N bonds are mirrored: board polarity error risk | assembly, board | demanded-mitigation | Rule: the bond map in `spec/contract.json` is authoritative; board swaps the pair (B24). — *board* | `spec/board-requirements.md` |
| INT-20 | 9 | Pad ring integration unproven: full-ring LVS, DRC, density, antenna and EM not run; rail continuity through the custom pad families; LEFs and back-drive pins open | pads | open | Ring-level checks; resistance-aware extraction. — *pads* | `scratch/reviews/pads-core/RAIL-CONTINUITY.md` |
| ISL-04 | 9 | No external feed exists for an island whose switch fails open; on slow ramps an off island rail reaches 0.35 V at ff/85 °C | island_support | open | Decide whether a debug feed is needed; record the slow-ramp level in the power-up check. — *island_support* | `scratch/reviews/always-on-audit.md` |
| LO-02 (aka PWR-03) | 9 | Injection locking between the TX and CDR rings on the shared rail: isolation −20…−27 dB simulated at tt only | timing | open | ss/ff corner run with both extracted rings on the shared regulator. — *timing* | `scratch/reviews/integration-m23.md` |
| LO-06 | 9 | LO additive jitter and I/Q skew between pad pairs are not budgeted on die | timing, rf_tx | open | Additive-noise simulation of `lo_ext`; board LO per B35. — *LO owner* | `analog/timing/generated/lo_ext-evidence.json` |
| LO-07 | 9 | `lo_ext` internal mode not qualified at ss; published cell loses 3.3 / 9.8 dB (tt/ss) into the mixers; staged candidate 1.5 / 3.8 dB | timing | open | Review and publish the candidate; 12-corner run. — *LO owner* | `scratch/lo-ap4/NOTES.md` |
| LO-12 | 9 | Band-bank off-state MIM bottom nodes float: suspected slow frequency drift after enable or band change | timing | open | Quantify; bias off nodes through a large resistor if real. — *LO owner* | `scratch/lo-ap4/NOTES.md` |
| LO-14 (LO27) | 9 | Published `pt_lo_obs` does not divide at ss/3.15 V (20 of 24 corner cases pass); it is the clock-observation source for the RF LO | timing | open | Staged repack is not bench-qualified; qualify at all in-window corners and publish. — *LO owner* | `scratch/lo-ap4/NOTES.md` |
| MOD-03 | 9 | Inductor and varactor models are our own (no PDK inductor model, lossless varactor) | timing, rf_rx | open | Two-sided L and Q bounds in every tank bench; calibrate on die 1 from the QVCO band sweep. — *LO owner; rf_rx* | `scratch/reviews/model-uncertainty-audit.md` |
| MOD-04 | 9 | ADC dynamic performance is weakly verified: the only valid published FFT is SNDR 31.4 dB / ENOB 4.9 after per-core correction (256 points, tt, 2-way interleave). Staged ADC (0.450 mm² each) is not published and stage 4 not re-reviewed | converters | open | Coherent FFT near Nyquist over the envelope with the real reference buffer; review and publish. — *converters* | `analog/converters/generated/adc_i-fft.json` |
| MOD-13 | 9 | Reference buffer: no noise or PSRR evidence; benches use an ideal reference | converters | open | Extracted buffer in the ADC bench; PSRR row PD2-16. — *converters* | `analog/converters/generated/refbuf-evidence.json` |
| MOD-15 | 9 | Island support rests on estimated debug-island current; no mismatch, ESD or EM run | island_support | open | Re-size after the debug blocks are characterised. — *island_support* | `analog/island_support/evidence.json` |
| MOD-19 | 9 | Resistor, MIM and skewed (sf/fs) corners are not swept in several families (POR, bandgap/biasgen, aosc, termination, bbfilter, CTLE) | all analog | open | Add resistor and MIM corners to the existing envelope sweeps, core_support first. — *block owners* | `scratch/reviews/pre-mortem.md` |
| PAD-07 | 9 | Debug-site loading and isolation unqualified for sensitive nodes | pads | open | Per-site loading check. — *pads* | `analog/pads/README.md` |
| PDN-01 | 9 | D2H simultaneous-switching bounce on the shared ground ring | digital, board | demanded-mitigation | Rule: in RF modes D2H runs at slow slew and the lowest drive that meets timing; two-group launch stagger. — *digital* | `spec/power-delivery.md` |
| PDN-06 (LO28) | 9 | Electromigration and IR sign-off at 85 °C not done; the LO cells draw every signal net with 0.4 µm wires and single vias (0.84 mA per wire, 0.58 mA per via) and were never checked | assembly, timing | open | EM check on straps, PA lines and CML paths at 85 °C. — *assembly; LO owner* | `scratch/lo-ap4/NOTES.md` |
| PKG-01 | 9 | Bonds are fixed by the COB: 0.8 mil aluminium wire, about 2–3 mm, 0.21–0.28 Ω each; no custom bonds | all | demanded-mitigation | Rule: every package model uses the per-bond table in `spec/package-channel.json`. — *all owners* | `spec/package-channel.md` |
| PKG-02 | 9 | No signal passives on the COB: the nearest is on the carrier, 5–6 mm of trace plus the connector away | wired_rx, rf_rx, rf_tx, pads | demanded-mitigation | Programmable termination and matching on chip; carrier matching sized against the channel model. — *block owners* | `spec/package-channel.md` |
| PKG-11 | 9 | COB tester diode check: every COB is tested by measuring each signal pad's ESD diode. All 56 signal pads have a ground-to-pad diode, but 21 custom pads have no diode to the supply and would read OPEN on a positive-current test; the tester polarity is not published | pads | open | Ask wafer.space for polarity and compliance; no pad change planned. — *pads* | `scratch/reviews/pads-core/wafer-space-consequences.md` |
| PWR-10 | 9 | RF duplex margin against the 260 / 340 mA RF ceilings is thin and assumes the digital current requirement | power, rf_tx, rf_rx | open | Track every RF current change against the mode ceiling. — *power delivery* | `spec/power-delivery.md` |
| RFR-07 | 9 | LO leakage to the antenna port through on-die routes | rf_rx, assembly | open | Coupled-line extraction; LO bundle shields (XT-01). — *rf_rx; assembly* | `scratch/reviews/rx-robustness-review.md` |
| RFT-04 | 9 | TX summer transimpedance and input impedance miss their targets; a non-resonant summer is capacitance-limited | rf_tx | demanded-mitigation | Chain functions are met; requirement change requested, inductor load is the alternative. — *rf_tx; spec* | `scratch/reviews/physical-limits.md` |
| RFT-05 | 9 | TX LO feedthrough is sensitive to layout symmetry (a few fF collapses suppression) | rf_tx, assembly | open | Symmetric shielded routing at assembly; firmware DC-offset trim. — *rf_tx / assembly* | `analog/rf_tx/generated/rf_tx-sim-ext.json` |
| RXR-05 | 9 | Flicker noise and IIP2 at zero IF for narrowband protocols | fpga | open | Run narrowband protocols at low IF. — *FPGA; spec* | `scratch/reviews/rx-robustness-review.md` |
| RXR-08 | 9 | Saturation recovery after pulsed blockers | rf_rx, fpga | open | Recovery ≤ 2 µs requirement; FPGA re-arms AGC on overload. — *rf_rx; FPGA* | `scratch/reviews/rx-robustness-review.md` |
| RXR-09 | 9 | No pre-filter overload detector: out-of-channel blockers are invisible to the FPGA | rf_rx, digital | demanded-mitigation | Latched comparators at the TIA output into status and stream metadata. — *rf_rx; digital* | `scratch/reviews/rx-robustness-review.md` |
| RXR-10 | 9 | Board supply ripple into the RX baseband and LO path; supply rejection of the victims is not in evidence | rf_rx, board | open | Board LDO post-regulation (B37); PSRR evidence rows PD2-14..19. — *board; block owners* | `spec/power-delivery.md` |
| RXR-11 | 9 | LO and converter sample clock may not share one reference | board, fpga | open | One TCXO for LO and converter reference (B35); FPGA AFC. — *board; FPGA* | `scratch/reviews/rx-robustness-review.md` |
| RXR-14 | 9 | On-chip LoRa 2.4 GHz sensitivity is about 3.9 dB short at every spreading factor | rf_rx, board | open | Fallback LNA on the board or a lower chain NF; narrow bandwidths need FPGA channel filtering. — *rf_rx; coordinator* | `scratch/rf-tia-r/lora.json` |
| RXR-ESD-1 | 9 | LNA input device exposure at 2 kV HBM passes only on the transient oxide limit; must be rerun on the new LNA | rf_rx, pads | open | Rerun the core screen on the closed LNA. — *rf_rx; pads* | `analog/pads/README.md` |
| SP-02 | 9 | Reference spurs on the ring PLLs | timing | open | Size the ripple filter from the analysis. — *timing* | `analog/timing/generated/pll_ring-evidence.json` |
| SP-03 (MW-22) | 9 | DAC zero-order-hold images against the TX mask need an 80 MS/s DAC update, but ADC and DAC share one converter clock in duplex | rf_tx, converters, digital | open | Clocking decision for duplex; FPGA interpolation. — *digital; converters* | `scratch/reviews/mode-walk.md` |
| SP-04 | 9 | Time-interleaved ADC mismatch spurs from layout asymmetry | converters | open | Matched clock routes inside the ADC. — *converters* | `analog/converters/INTEGRATION.md` |
| SUB-03 | 9 | Digital clock harmonics in the 2.4 GHz band at the LNA and mixers | rf_rx, digital | demanded-mitigation | Host-derived 39.0625 MS/s converter clock; FPGA channel plan; D2H slow slew in RF modes. — *digital; firmware* | `scratch/reviews/integration-m23.md` |
| SUB-10 | 9 | Back side and die attach are not modelled; attach material and backside grounding on the COB are unconfirmed | assembly, board | open | Email to wafer.space; QVCO pessimistic case needs a grounded backside or more distance. — *coordinator* | `scratch/reviews/wafer-space-answers.md` |
| SUB-11 | 9 | No substrate network in any extracted sign-off simulation; victims' substrate gains not extracted | assembly | open | Reduced substrate mesh attached to the top-level netlist. — *assembly* | `scratch/reviews/integration-m23.md` |
| SUB-12 | 9 | Digital macro to `dac_i`/`dac_q` substrate coupling: 22 µm gap, no rule; passes nominal, fails at the pessimistic bound (TX spur at ±78.125 MHz in direct-DAC mode) | converters, assembly | open | Add a spacing or guard rule in v7. — *assembly* | `scratch/reviews/integration-m23.md` |
| SUB-13 | 9 | Digital macro to bbfilter in-band coupling at high PGA gain is not bounded | rf_rx, assembly | open | Extract the victims' substrate gain; rule in v7. — *assembly; rf_rx* | `scratch/reviews/integration-m23.md` |
| TH-04 (aka TH-02) | 9 | Thermal: about 1.26 W at the wired ceiling against the 22–32 °C window; COB thermal resistance not characterised; mode steps are faster than any plate loop | board | demanded-mitigation | Required junction-to-plate resistance per `spec/power-delivery.md`; controlled plate or dwell. — *board* | `spec/power-delivery.md` |
| TIM-04 | 9 | Ring PLL HOLD fails extracted; host-follow clock runs on the TX ring as baseline and must not rely on HOLD | timing, wired_rx | open | Keep host-follow locked; owners' confirmation rows pending. — *timing* | `analog/timing/generated/pll_ring-evidence.json` |
| TIM-05 | 9 | Ring PLL closed-loop lock shown only at nominal; no jitter, phase-noise or reference-spur coverage | timing | open | Chip-level jitter simulation with the regulator. — *timing* | `analog/timing/generated/pll_ring-evidence.json` |
| TIM-10 | 9 | Ring PLL safe state fails on the current evidence: 87–162 µA from the supply at reset-default controls | timing | open | Fix the off-state leakage path; rerun the safe test. — *timing* | `analog/timing/generated/pll_ring-evidence.json` |
| USB-03 | 9 | TMDS 1.485 Gb/s unsimulated; USB HS has no eye-template, chirp or turnaround evidence; USB receive depends on the detect redesign | wired_tx, wired_rx, pads | demanded-mitigation | Run eye/chirp/turnaround; board USB PHY is the fallback (B8). — *wired_tx* | `analog/wired_tx/USB-INTEGRATION.md` |
| WRX-03 (MW-32) | 9 | Slicer per-sampler trim: step too coarse on the edge samplers and the register map cannot program every sampler | wired_rx, digital | demanded-mitigation | Fourth fine bit; register fields per sampler; extracted requalification. — *wired_rx; digital* | `analog/wired_rx/generated/slicer-evidence.json` |
| WTX-05 | 9 | Wired TX common mode and swing need AC coupling; start-up wander | wired_tx, board | demanded-mitigation | Board series capacitors (B22) and preamble (B12). — *board* | `spec/board-requirements.md` |
| XT-03 | 9 | Bias trunks parallel to digital routes | core_support, assembly | demanded-mitigation | Side shields on bias trunks; no digital net directly above or below. — *assembly* | `scratch/reviews/physical-limits.md` |
| XT-07 | 9 | Ring phase lines to samplers and serializer: coupling and load mismatch | wired_rx, wired_tx, assembly | open | Equal-length shielded phase bus. — *assembly* | `scratch/reviews/physical-limits.md` |
| CSP-01 | 8 | VCO replica control voltage has no ATB code | characterization | open | Add the code (INT-04). — *digital* | `scratch/reviews/model-uncertainty-audit.md` |
| DIG-05 | 8 | Formal safe-defaults proof not rerun on the current register map | digital | open | Rerun formal on the final map. — *digital* | `scratch/digital-timing-close/NOTES.md` |
| RXR-06 | 8 | LO phase-noise mask for the external synthesizer | board, timing | open | Requirement RF-RX-LOPN and B35. — *board* | `scratch/reviews/rx-robustness-review.md` |
| TIM-03 | 8 | aosc misses its 40–60 MHz window at ss; reference receiver fails at 200 mVpp | timing | open | Report out-of-window as fail; rerun reference receiver corners. — *timing* | `scratch/reviews/always-on-audit.md` |
| WRX-07 | 8 | Sampler regeneration and device speed rest on models without gate resistance | wired_rx, wired_tx | open | Extracted sampler, CML stage and mux at ss with explicit Rg, or 1.45× pre-layout derate. — *wired_rx* | `scratch/reviews/gf180-device-speed-evidence.md` |
| AON-02 | 6 | aosc has a lock state with no kick (not reached from 29 start cases) | timing | open | Add a start check to the aosc evidence. — *timing* | `scratch/reviews/always-on-audit.md` |
| CDC-02 | 6 | Asynchronous SAR result capture near the window edge | converters, digital | open | Capture on the done edge. — *converters; digital* | `analog/converters/INTEGRATION.md` |
| CNV-07 | 6 | ADC acquisition window is an on-block one-shot: sampling instant has −1.6 ps/mV supply sensitivity and the window spreads 4.4–6.1 ns over corners | converters | open | Acquisition trim; extracted 12-corner run at the default code; EN=0 leakage 1.30 µA against 1 µA needs a ruling. — *converters* | `scratch/converters-ap4/NOTES.md` |
| ESD-07 | 6 | ESD implant layer 24/0 may not be in the wafer.space mask set. Census: 0 shapes on 24/0 in 238 GDS files, the provider IO cells and the assembled v5 chip, and no clamp relies on it | pads | open | Keep the 24/0 census in the assembly checks; written confirmation requested by email. — *pads* | `scratch/reviews/pads-core/wafer-space-consequences.md` |
| OTH-01 | 6 | Light sensitivity of the die: glob-top opacity unconfirmed | board | open | Opaque cover for measurements if the glob-top is not opaque. — *board* | `scratch/reviews/wafer-space-answers.md` |
| PAD-08 | 6 | No autonomous island or pad disable on a rail fault | pads, board | open | Board supervisor. — *board* | `analog/pads/generated/rail-supervisor-screen.json` |
| PAD-10 | 6 | The RF pair pad layout record says it does not fit its assigned area | pads, assembly | open | Resolve against the die-fit ledger. — *pads* | `analog/pads/generated/stress-safe-families/rf-pair/pad-layout.json` |
| PWR-05 | 6 | Wired TX tail electromigration at full main + post current unconfirmed | pads, wired_tx | open | EM check at 85 °C. — *pads / wired_tx* | `analog/wired_tx/INTEGRATION.md` |
| RXR-12 | 6 | T/R switching and own-TX to RX isolation | board | open | Board T/R switch driven by the FPGA (B33). — *board; FPGA* | `scratch/reviews/rx-robustness-review.md` |
| TIM-11 | 6 | VCO replica: 12 of 48 corner cases do not oscillate (ss at 0.9 V control, tt and ss at 0.8 V) | timing | open | State the usable control range or fix the start. — *timing* | `analog/timing/generated/vco_replica-evidence.json` |
| WRX-05 | 6 | CTLE input capacitance behind the HS pad is about twice its 120 fF budget | wired_rx, pads | open | Restate the pad C and return loss with the real load, or shrink the bypass switch wiring. — *pads / wired_rx* | `analog/wired_rx/README.md` |
| RFR-04 | 5 | HT40 receive adjacent-channel rejection and 10BASE-T are not supported on chip; this conflicts with the full-scope mandate unless ruled a physical limit | rf_rx, wired_tx | open | Needs a coordinator ruling: build it or prove the limit in `physical-limits.md`. External LO and board PHY (B38a) are fallbacks only. — *coordinator* | `spec/interface-requirements.md` |
| PAD-06 | 4 | rfdriver gates up to 1.8 % over the 3.63 V screen at safety corners during RF-on | rf_tx, pads | open | Ruling on the screen; recheck at the 3.50 V trim. — *rf_tx / pads* | `analog/rf_tx/README.md` |
| PDN-08 | 4 | Island-enable and isolation-release transients disturb running blocks | core_support | open | Procedure: configure all islands before payload start. — *firmware* | `analog/island_support/README.md` |
| SUB-08 | 4 | Wired TX close to the I ADC | assembly, digital | demanded-mitigation | Rule: wired island off in RF modes (mode exclusivity in the register file). — *digital* | `scratch/reviews/integration-m23.md` |
| TIM-09 | 4 | Debug clocking blocks are smaller than the register fields describe | timing | open | Align fields with the cells. — *timing; digital* | `analog/timing/generated/clk_obs-evidence.json` |
| WRX-13 | 4 | CTLE low-frequency zero and loss at 2.5 GHz limit the equalisation range | wired_rx | open | Accept or add a code after the follower fix. — *wired_rx* | `analog/wired_rx/generated/ctle-evidence.json` |
| PAD-05 | 12 | Wired TX pad capacitance and package-limited return loss above 1.25 GHz | pads, wired_tx, board | risk-accepted | Optional carrier ladder; programmable termination. — *pads / board* | `spec/package-channel.md` |
| ESD-05 | 9 | TX termination switch gates exceed the DC screen in unpowered HBM but stay under the transient oxide limit | pads, wired_tx | risk-accepted | Accepted on the transient limit. — *pads* | `analog/pads/README.md` |
| RFT-02 | 9 | 6 V cascode costs about 3.7 dB of saturated power | rf_tx | risk-accepted | Keep ≥ 1 dB PA back-off or crest-factor reduction for the highest-order modes. — *rf_tx* | `analog/rf_tx/README.md` |
| USB-01 | 9 | FS rise/fall matching on the 6 V USB pad | pads | risk-accepted | Accepted; termination trim field is opt-in. — *pads* | `analog/pads/README.md` |
| INT-17 | 8 | Board-dependent optional RF modes lack chip pins and on-chip selectivity | board, rf_rx | risk-accepted | Per-application carriers; FPGA GPIO control. — *board* | `spec/board-requirements.md` |
| CNV-04 | 6 | 5 V standard cells in the converters run at 3.3 V without 3.3 V Liberty sign-off | converters | risk-accepted | Extracted analog benches cover function. — *converters* | `analog/converters/README.md` |
| HL-08 | 6 | 100BASE-TX relies on the CTLE common-mode window and an external network | wired_rx, wired_tx, board | risk-accepted | External PHY backup (B38a). — *board* | `spec/board-requirements.md` |
| ISL-03 | 6 | ATB leaf selection disturbs small-capacitance bias nodes; force pad offset | island_support | risk-accepted | Rule: no force leaves on very small-capacitance nodes. — *island_support* | `analog/island_support/evidence.json` |
| PKG-10 | 6 | Supply bond current: worst supply bond 87.5 mA; passes EM at 85 °C against 125 mA per cell; no supply bond on the south edge | pads, assembly | risk-accepted | Sign-off temperature is 85 °C; one south supply bond is recommended and is a user decision. — *power delivery* | `spec/power-delivery.md` |
| ISL-02 | 4 | Auto-bulk dead zone when island and core rails are within a threshold | island_support | risk-accepted | Accepted. — *island_support* | `analog/island_support/evidence.json` |
| RFR-09 | 4 | Baseband tap limits: pad common mode about 0.8 V, limited inject range | rf_rx | risk-accepted | Documented limits. — *rf_rx* | `analog/rf_rx/generated/bb_tap-evidence.json` |
| CNV-01 | 16 | Alternate-channel aliasing at the ADC | converters, rf_rx | mitigated | Rule: ADC default 39.0625 MS/s in RF modes (40 MS/s selectable) with the trimmed baseband filter. — *converters; rf_rx* | `spec/power-delivery.md` |
| RFR-02 | 16 | RX PGA range and filter trim | rf_rx | mitigated | Rule: firmware loads the per-PGA cutoff/Q table and AGC holds PGA ≥ 12 dB at sensitivity; bbfilter repack not started. — *rf_rx; firmware* | `analog/rf_rx/generated/bbfilter_i-evidence.json` |
| SUB-04 | 12 | Management oscillator next to the LNA and baseband filter | timing, digital | mitigated | Rule: the management oscillator stays off in RF modes; the fault monitor uses a second time base. — *digital* | `scratch/reviews/always-on-audit.md` |
| WRX-10 | 12 | CDR proportional gain must be set per rate | wired_rx, digital | mitigated | Rule: firmware loads the per-rate KP table; one code does not pass every rate. — *wired_rx; firmware* | `analog/wired_rx/README.md` |
| PWR-09 (aka PWR-08) | 9 | RF block currents exceed their original allocations | rf_tx, rf_rx | mitigated | Rule (RF-PWR-1): TX chain off in RX, ADCs off in TX, D2H at reduced rate in RF modes; budget uses evidence currents. — *digital recipe* | `spec/budgets/power_budget.py` |
| SUB-02 | 9 | Digital macro next to the bandgap | core_support, assembly | mitigated | Rule: core_bias ≥ 100 µm from the macro. — *assembly* | `scratch/reviews/integration-m23.md` |
| LU-01 | 8 | Latch-up near custom pads (rules are not in the open DRC deck) | pads | mitigated | Rule: every pad-connected diffusion has a double guard ring; manual audit per pad family. — *pads* | `analog/pads/README.md` |
| LU-02 | 8 | Signals from a switched island into the always-on macro | digital, assembly | mitigated | Rule: every island-to-macro signal is clamped by an AND2 inside the macro; the top regression isolation rule must stay at 0. — *digital; chip top* | `integration/top/pt_chip.conn` |
| TIM-02 | 6 | Clock observation speed limit | timing, digital | mitigated | Rule: clocks above 500 MHz are divided before the observation mux; `lo_obs`/`clk_obs16` staged, unpublished. — *timing* | `scratch/lo-ap4/NOTES.md` |
| OTH-03 | 6 | Clock-mux switching glitches | digital | closed | Rule: clock muxes switch only with the clock stopped. — *digital* | `scratch/reviews/archive/risk-register-legacy-2026-11-11.md` |
| SUB-07 | 6 | PA substrate and supply coupling into LNA, ADC and bandgap | assembly, rf_tx | closed | Rule: rfdriver ≥ 1000 µm from the LNA, ≥ 839 µm from ADC I, ≥ 340 µm from core_bias. — *assembly* | `scratch/reviews/integration-m23.md` |
| DBG-01 | 4 | ATB leaves on sensitive nodes | core_support | closed | Rule: no leaf on an RF-carrying node. — *core_support* | `scratch/reviews/archive/risk-register-legacy-2026-11-11.md` |
| LO-03 | 4 | Subharmonic injection of the PA and LO into the ring PLLs | timing, assembly | closed | Rule: rfdriver ≥ 1 mm from both rings. — *assembly* | `scratch/reviews/integration-m23.md` |
| SUB-09 | 4 | Debug oscillators near core_bias | bring-up | closed | Rule: debug oscillators off during performance measurements. — *bring-up* | `scratch/reviews/archive/risk-register-legacy-2026-11-11.md` |
| TH-01 | 4 | PA heating gradient at the bandgap and ADC | assembly | closed | Rule: holds while the SUB-07 distances are kept; recheck if the PA moves. — *assembly* | `scratch/reviews/area-pass-4.md` |
