deepai-org/svalbard/scratch/reviews/risk-register.md

Superseded: the canonical transceiver risk register is projects/programmable_transceiver_platform/spec/risk-register.md (legacy copy: archive/risk-register-legacy-2026-11-11.md).
