deepai-org/svalbard/projects/programmable_transceiver_platform/analog/island_support/generated/isw/isw_debug.pex.spice

* PEX produced on Sun Nov  8 09:49:06 AM CET 2026 using /foss/tools/sak/sak-pex.sh with m=2 and s=1
* NGSPICE file created from isw_debug_pex.ext - technology: gf180mcuD

.subckt isw_debug_pex VDD VISL VSS EN ISO PG
X0 VISL GATE VDD VMAX pfet_03v3 ad=2.6p pd=10.52u as=2.6p ps=10.52u w=10u l=0.28u
X1 VISL GATE VDD VMAX pfet_03v3 ad=2.6p pd=10.52u as=2.6p ps=10.52u w=10u l=0.28u
X2 VISL GATE VDD VMAX pfet_03v3 ad=2.6p pd=10.52u as=2.6p ps=10.52u w=10u l=0.28u
X3 VISL GATE VDD VMAX pfet_03v3 ad=2.6p pd=10.52u as=2.6p ps=10.52u w=10u l=0.28u
X4 VDD GATE VISL VMAX pfet_03v3 ad=2.6p pd=10.52u as=2.6p ps=10.52u w=10u l=0.28u
X5 VISL GATE VDD VMAX pfet_03v3 ad=2.6p pd=10.52u as=2.6p ps=10.52u w=10u l=0.28u
X6 VISL GATE VDD VMAX pfet_03v3 ad=2.6p pd=10.52u as=2.6p ps=10.52u w=10u l=0.28u
X7 VISL GATE VDD VMAX pfet_03v3 ad=2.6p pd=10.52u as=2.6p ps=10.52u w=10u l=0.28u
X8 VDD GATE VISL VMAX pfet_03v3 ad=2.6p pd=10.52u as=2.6p ps=10.52u w=10u l=0.28u
X9 VISL GATE VDD VMAX pfet_03v3 ad=2.6p pd=10.52u as=2.6p ps=10.52u w=10u l=0.28u
X10 VDD GATE VISL VMAX pfet_03v3 ad=2.6p pd=10.52u as=2.6p ps=10.52u w=10u l=0.28u
X11 VISL GATE VDD VMAX pfet_03v3 ad=2.6p pd=10.52u as=2.6p ps=10.52u w=10u l=0.28u
X12 VDD GATE VISL VMAX pfet_03v3 ad=2.6p pd=10.52u as=2.6p ps=10.52u w=10u l=0.28u
X13 VISL GATE VDD VMAX pfet_03v3 ad=2.6p pd=10.52u as=2.6p ps=10.52u w=10u l=0.28u
X14 VDD GATE VISL VMAX pfet_03v3 ad=2.6p pd=10.52u as=2.6p ps=10.52u w=10u l=0.28u
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
X347 VISL GATE VDD VMAX pfet_03v3 ad=2.6p pd=10.52u as=2.6p ps=10.52u w=10u l=0.28u
X348 VDD GATE VISL VMAX pfet_03v3 ad=2.6p pd=10.52u as=2.6p ps=10.52u w=10u l=0.28u
X349 VDD GATE VISL VMAX pfet_03v3 ad=2.6p pd=10.52u as=2.6p ps=10.52u w=10u l=0.28u
X350 VDD GATE VISL VMAX pfet_03v3 ad=2.6p pd=10.52u as=2.6p ps=10.52u w=10u l=0.28u
X351 VISL GATE VDD VMAX pfet_03v3 ad=2.6p pd=10.52u as=2.6p ps=10.52u w=10u l=0.28u
X352 VDD GATE VISL VMAX pfet_03v3 ad=2.6p pd=10.52u as=2.6p ps=10.52u w=10u l=0.28u
X353 VDD GATE VISL VMAX pfet_03v3 ad=2.6p pd=10.52u as=2.6p ps=10.52u w=10u l=0.28u
X354 VISL GATE VDD VMAX pfet_03v3 ad=2.6p pd=10.52u as=2.6p ps=10.52u w=10u l=0.28u
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
