deepai-org/svalbard/projects/programmable_transceiver_platform/analog/characterization/generated/char_rffet_open.lvs.spice

* NGSPICE file created from pt_char_rffet_open.ext - technology: gf180mcuD

.subckt pt_char_rffet_open G D GND
.ends
