deepai-org/svalbard/benchmarks/mixed_signal-0002-4bit-dco/solution/mini_incomplete/analog/dco4.spice

.subckt dco4 EN CTRL0 CTRL1 CTRL2 CTRL3 OUT VDD VSS
Rbad OUT VSS 1
.ends dco4
