deepai-org/svalbard/(list of files, drawings)

Other design files:
benchmarks/mixed_signal-0002-4bit-dco/solution/evidence/schematic_characterization.json
ip/blocks/analog/wireline_serdes/cdr/cml_to_cmos/schematic_nominal_result.json
ip/blocks/analog/wireline_serdes/cdr/cml_to_cmos/schematic_pvt_smoke_result.json
ip/blocks/analog/wireline_serdes/cdr/error_slicer/schematic_pvt_result.json
ip/blocks/analog/wireline_serdes/cdr/integrated_detector/schematic_composed_result.json
ip/blocks/analog/wireline_serdes/cdr/phase_error_filter/schematic_pvt_result.json
ip/blocks/analog/wireline_serdes/clock_pulse/schematic_result.json
ip/blocks/analog/wireline_serdes/deserializer/schematic_capture_result.json
ip/blocks/analog/wireline_serdes/phase_control_dac/schematic_dc_result.json
ip/blocks/analog/wireline_serdes/pll/schematic_architecture_result.json
ip/blocks/analog/wireline_serdes/reference_level_receiver/schematic_result.json
ip/blocks/analog/wireline_serdes/serializer/schematic_result.json
projects/programmable_transceiver_platform/evidence/schematic-implementation-audit.json
projects/programmable_transceiver_platform/spec/schematic-implementation.json
