deepai-org/svalbard/projects/programmable_transceiver_platform/integration/core_bias.py

"""Physical core reference chain and five island bias banks.

No ideal currents, voltages or loads live inside this assembly. The parent
must bind each output to its actual consumer and each enable to that macro's
effective enable. All register controls are identified by generated bit index.
"""
import hashlib
import json
from pathlib import Path
import re

from check_chip_power import PROJECT, instance, ports

CONSUMERS = {
    'rf': ['lna', 'rxmix_i', 'rxmix_q', 'bbfilter_i', 'bbfilter_q', 'txmix_i', 'txmix_q', 'rfdriver'],
    'conv': ['adc_i', 'adc_q', 'dac_i', 'dac_q', 'refbuf'],
    'pll': ['pll_ring_tx', 'pll_ring_rx', 'pll_ring_host', 'lc_vco_reserved'],
    'wired': ['ctle', 'detect', 'wiredtx'],
    'debug': ['bb_tap_i', 'bb_tap_q', 'bb_tap_wmon'],
}


def build(read):
    model_dir = PROJECT/'integration/models/core_bias'
    manifest = json.loads(read(model_dir/'manifest.json'))
    models = []
    cells = {}
    for name, info in manifest['models'].items():
        source = read(model_dir/info['file'])
        assert hashlib.sha256(source.encode()).hexdigest() == info['sha256'], f'Changed qualified model: {name}'
        if name == 'bandgap':
            # Same documented Magic-recognition correction as sim_bandgap.py.
            source = source.replace('pnp_10p00x00p42', 'pnp_05p00x05p00')
        cell = 'gf180mcu_ocd_ip__'+('biasgen' if name == 'biasgen_patched' else 'bandgap')
        cells[name] = (source, cell)
        models.append(source)
    distribution = PROJECT/'analog/core_support/distribution/generated'
    for cell in ['pt_bias_root', 'pt_bias_vref']+[f'pt_bias_bank{n}' for n in sorted({len(v) for v in CONSUMERS.values()})]:
        source = read(distribution/(cell+'.ext.spice'))
        cells[cell] = (source, cell)
        models.append(source)
    # Use the already DRC/LVS-qualified extracted AND leaf, including its
    # extra exported extraction nodes (private to each instance).
    glue = read(PROJECT/'analog/bringup_control/generated/pt_wtx_fallback_control.ext.spice')
    match = re.search(r'^\.subckt bringup_and\b.*?^\.ends[^\n]*', glue, re.M | re.S)
    assert match
    glue = match.group()+'\n'
    models.append(glue)
    mapping = json.loads(read(PROJECT/'spec/register-map.json'))
    fields = {f['name']: f for f in mapping['fields']}
    pin_list = ['VDD', 'VSS']+[f'RAIL_{island}' for island in CONSUMERS]
    pin_list += [f'ON_{island}' for island in CONSUMERS]
    bindings = {}
    field_pins = {}
    for name in ('core.biasgen', 'core.refchain'):
        for field in fields.values():
            if not field['name'].startswith(name+'.'):
                continue
            assert field['bus'] == 'debug' and field['bus_lsb'] is not None, field['name']
            width = field.get('bus_bits', field['bits'])
            # Thermometer decoding exports 16 bits from the five-bit trim.
            if field['name'] == 'core.refchain.bgap_trim':
                width = 16
            names = []
            for bit in range(width):
                pin = 'C_'+field['name'].replace('.', '_')+(f'_{bit}' if width > 1 else '')
                pin_list.append(pin)
                bindings[pin] = f'debug_cfg[{field["bus_lsb"]+bit}]'
                names.append(pin)
            field_pins[field['name']] = names
    def scalar(name):
        assert len(field_pins[name]) == 1
        return field_pins[name][0]
    for consumers in CONSUMERS.values():
        for consumer in consumers:
            if consumer != 'lc_vco_reserved':
                pin_list.append('EN_'+consumer)
            pin_list.append('BIAS_'+consumer)
    # Codes 2/3: the master voltage references (analog-architecture.json
    # bias.vref0 -> refbuf.vref0, bias.vcm -> adc_i/adc_q VCM), generated by
    # pt_bias_vref from VBG and core VDD.
    observation = {1: 'ROOT_REF', 2: 'VREF0', 3: 'VCM', 14: 'TRK_RF', 22: 'TRK_WIRE', 29: 'TRK_PLL',
                   35: 'TRK_CONV', 55: 'VBG', 56: 'TRK_DEBUG', 57: 'IDAC1'}
    pin_list += list(observation.values())+['VGEN_SOURCE', 'VGEN_SINK1', 'VGEN_SINK2']
    body = []
    control_instances = []
    def and_gate(label, a, b, y):
        connect = dict(A=a, B=b, Y=y, VDD='VDD', VSS='VSS')
        for index, pin in enumerate(ports(glue, 'bringup_and')):
            if pin not in connect:
                connect[pin] = label+'_private_'+str(index)
        body.append(instance(label, 'bringup_and', glue, connect))
        control_instances.append(dict(instance=label, a=a, b=b, y=y))
    and_gate('Xfine_guard', scalar('core.biasgen.ref_sel_fine'), scalar('core.biasgen.ref_sel_coarse'), 'FINE_EFFECTIVE')
    source, cell = cells['biasgen_patched']
    connect = dict(ena=scalar('core.biasgen.ena'), ref_in='VDD', dvdd='VDD', avdd='VDD',
                   dvss='VSS', vbg='VBG', ref_sel_vbg=scalar('core.biasgen.ref_sel_vbg'),
                   ref_sel_coarse=scalar('core.biasgen.ref_sel_coarse'), ref_sel_fine='FINE_EFFECTIVE',
                   idac1_source_ibias='IDAC1', idac2_source_ibias='ROOT_REF',
                   voltgen_source_ibias='VGEN_SOURCE', voltgen_sink1_ibias='VGEN_SINK1',
                   voltgen_sink2_ibias='VGEN_SINK2', bandgap_sink1_ibias='BANDGAP_IBIAS2',
                   bandgap_sink2_ibias='BANDGAP_IBIAS1')
    for name in ('idac1_source', 'idac2_source', 'bandgap_sink1', 'bandgap_sink2',
                 'voltgen_source', 'voltgen_sink1', 'voltgen_sink2'):
        for bit, pin in enumerate(field_pins['core.biasgen.'+name]):
            connect[f'{name}[{bit}]'] = pin
    body.append(instance('Xbiasgen', cell, source, connect))
    source, cell = cells['bandgap']
    connect = dict(dvdd='VDD', dvss='VSS', vbg='VBG', ena=scalar('core.refchain.bgap_ena'),
                   ibias1_250n='BANDGAP_IBIAS1', ibias2_1u='BANDGAP_IBIAS2')
    connect.update({f'trim[{bit}]': pin for bit, pin in enumerate(field_pins['core.refchain.bgap_trim'])})
    body.append(instance('Xbandgap', cell, source, connect))
    root = dict(VSS='VSS', ROOT_REF='ROOT_REF')
    for island, consumers in CONSUMERS.items():
        name = 'WIRE' if island == 'wired' else island.upper()
        and_gate('Xtrunk_'+island, scalar('core.refchain.dist_en_'+('wire' if island == 'wired' else island)),
                 'ON_'+island, 'TRUNK_EN_'+island)
        root['EN_'+name] = 'TRUNK_EN_'+island
        root['TRK_'+name] = 'TRK_'+name
        bank = dict(VDD='RAIL_'+island, VSS='VSS', TRK='TRK_'+name)
        for index, consumer in enumerate(consumers):
            bank['OUT'+str(index)] = 'BIAS_'+consumer
            if consumer == 'lc_vco_reserved':
                bank['EN'+str(index)] = 'VSS'
            else:
                and_gate('Xoutput_'+consumer, 'EN_'+consumer, 'ON_'+island, 'BANK_EN_'+consumer)
                bank['EN'+str(index)] = 'BANK_EN_'+consumer
        source, cell = cells['pt_bias_bank'+str(len(consumers))]
        body.append(instance('Xbank_'+island, cell, source, bank))
    source, cell = cells['pt_bias_root']
    body.append(instance('Xroot', cell, source, root))
    source, cell = cells['pt_bias_vref']
    body.append(instance('Xvref', cell, source, dict(VDD='VDD', VSS='VSS', VBG='VBG', VREF0='VREF0', VCM='VCM')))
    assert len(set(pin_list)) == len(pin_list)
    text = '\n'.join(models)+'\n.subckt pt_core_bias '+' '.join(pin_list)+'\n'
    text += '\n'.join(body)+'\n.ends pt_core_bias\n'
    return dict(text=text, pins=pin_list, control_bindings=bindings, field_pins=field_pins,
                consumers=CONSUMERS, observation_bindings=observation,
                control_instances=control_instances,
                notes=['Parent must connect real consumer IBIAS pins and effective enables.',
                       'lc_vco_reserved output is fabricated with EN tied low.',
                       'Extracted reference models retain all capacitances; PNP name corrected as documented.',
                       'Biasgen and bandgap share core VDD; five banks use their actual switched rails.',
                       'VREF0 (5/6 VBG) and VCM (VDD/2) come from the passive pt_bias_vref on core VDD; '
                       'parent binds VREF0 to refbuf.VREF0 and VCM to adc_i/adc_q VCM.'])
