deepai-org/svalbard/projects/programmable_transceiver_platform/rtl/pt_block_rx_mask.sv

// Routing-specific receiver; control logic is shared.
`define PT_RX_MODULE pt_block_rx_mask
`define PT_RX_ROUTE pt_block_route_mask
`include "pt_block_rx_routed.vh"
`undef PT_RX_ROUTE
`undef PT_RX_MODULE
