deepai-org/svalbard/flows/smoke/digital_pnr/counter.v

module counter (
    input wire clk,
    input wire rst,
    output reg [3:0] count
);
    always @(posedge clk) begin
        if (rst) begin
            count <= 4'h0;
        end else begin
            count <= count + 4'h1;
        end
    end
endmodule
