deepai-org/svalbard/(commit log)

2026-08-16 Bootstrap safe PCIe pre-silicon verification
    [inverter.sch]
2026-08-16 Qualify bounded GF180 digital core flow
    [pin_order.cfg]
2026-08-16 Verify GF180 scan-chain stitching canary
2026-08-17 Close scan-inserted GF180 physical canary
    [scan_pin_order.cfg]
2026-08-17 Add bounded stuck-at pattern canary
    [check_results.py, stuck_at.py]
2026-08-17 Prove scan insertion preserves function
2026-08-17 Add current CML receiver layout render
2026-08-17 Add current CML phase interpolator layout
2026-08-17 Implement calibrated dual-edge CDR sampler schematic
2026-08-17 Add routed CDR sampler layout image checkpoint
2026-08-17 Close CDR sampler DRC and LVS
2026-08-17 Close extracted dual-edge CDR sampler milestone
2026-08-17 Close schematic CDR phase-detector PVT
2026-08-17 Integrate calibrated half-rate CDR detector
2026-08-17 Add physical CML-to-CMOS retimer checkpoint
    [schematic_nominal_result.json]
2026-08-17 Close nominal extracted CML retimer milestone
    [schematic_nominal_result.json]
2026-08-18 Add two-phase extracted CML retimer checkpoint
    [schematic_nominal_result.json]
2026-08-18 Add reset-isolated extracted CML retimer
    [schematic_nominal_result.json, schematic_pvt_smoke_result.json]
2026-08-18 Close extracted programmable-tail CML front end
    [schematic_nominal_result.json, schematic_pvt_smoke_result.json]
2026-08-18 Compose CML front end with differential deserializer
    [schematic_capture_result.json, schematic_pvt_smoke_result.json]
2026-08-18 Centralize bounded analog flow tooling
2026-08-18 Close extracted CDR phase-error combiner
    [schematic_pvt_result.json]
2026-08-18 Close extracted CDR error composition
    [schematic_composed_result.json]
2026-08-18 Close extracted CDR error slicer
    [schematic_pvt_result.json]
2026-08-18 Close extracted phase control DAC integration
    [schematic_dc_result.json]
2026-08-18 Harden CDR slicer matching layout
    [schematic_pvt_result.json]
2026-08-18 Screen 2.5 GHz ring VCO architecture
    [schematic_architecture_result.json]
2026-08-19 Document immutable analog flow inputs
2026-08-19 Close first static CML divider stage
2026-08-20 Close half-rate serializer core
    [schematic_result.json]
2026-08-23 Close calibrated 2.5 GT/s lane stress
2026-08-24 Add calibrated RX clock level converter checkpoint
    [schematic_result.json]
2026-08-24 Close recovered-clock rail conversion physically
    [schematic_result.json]
2026-08-31 wifi: add die-side RF calibration coupon
2026-08-31 pcie: record rejected restored-state pulse probe
2026-08-31 pcie: record rejected write threshold probe
2026-08-31 pcie: reject loaded pulse-end profile probe
2026-08-31 wifi: bind real-if ADC DSP selectivity boundary
2026-08-31 wifi: gate converter work on sampled input PEX
2026-08-31 wifi: reject nmos sampling switch baseline
2026-08-31 wifi: reject simple transmission gate sampler
2026-08-31 wifi: reject thermal-infeasible 5pf sampler boundary
2026-08-31 wifi: screen IF driver speed boundary
2026-08-31 wifi: reject inverter-loop IF driver
2026-08-31 pcie: localize capture bridge rail loss
2026-09-02 pcie: bound direct-clock sampler loading
2026-09-02 pcie: isolate local sampler clock fanout
2026-09-02 pcie: reject brute-force sampler fanout sizing
2026-09-02 pcie: balance extracted sampler clock edges
2026-09-02 pcie: close in on physical sampler timing
2026-09-02 analog: namespace routed parent circuit IR
2026-09-02 pcie: qualify low-cap event receiver
    [schematic_result.json]
2026-09-02 pcie: physically qualify programmable event receiver
    [schematic_result.json]
2026-09-02 pcie: replay routed event receiver envelope
    [schematic_result.json]
2026-09-04 Add verified UART, ECC SDRAM, and DCO benchmarks
    [schematic_characterization.json]
2026-09-21 Redraw transceiver diagram with circuit symbols and explicit signal paths
2026-09-21 Draw transceiver signal buses, clock distribution and shared service wiring
2026-09-22 Add programmable transceiver models, evidence and exclusive-engine design
    [adc-reference-reservoir-decision-windows.json, adc-sar8-reference-reservoir-screen.json, reference-reservoir-damping.json, reference-reservoir-model.json, sar-driver-reservoir-margin.json, sar-driver-reservoir.json, sar-reservoir-double.json, sar-reservoir-driver-divergence.json]
2026-09-22 Consolidate transceiver history and document source dependencies
    [sar-driver-reservoir-margin.json]
2026-09-22 Decouple shared ADC helpers from historical chip compositions
2026-09-22 Guard inactive RF and wired payload admission paths
2026-09-22 Verify calibrated RF duplex across exclusive engine transitions
2026-09-23 Instrument loaded RF failure to separate ADC quantization from analog error
2026-09-23 Preserve loaded ADC diagnosis and primitive-library implementation plan
2026-09-23 Add independent receive gain control and test loaded ADC headroom
2026-09-23 Model stopped oscillator phase and loop-filter leakage for shutdown integration
2026-09-23 Qualify RF streaming with inactive wired oscillator stopped
2026-09-23 Enable wired-only host return and verify powered duplex in both profiles
2026-09-23 Qualify both loaded RF quality profiles with wired oscillator shut down
2026-09-23 Integrate powered loaded transceiver with coarse and warm RF acquisition
2026-09-23 Connect finite-current shared converter reference to integrated transceiver
2026-09-23 Verify finite reference integration and define common rail ownership handoff
2026-09-23 Solve local rail and PLL phase feedback with bounded trajectory forecasts
2026-09-23 Connect RF rail and PLL feedback to full-chip event boundaries
2026-09-23 Specify pending wired phase targets across bounded analog forecasts
2026-09-23 Retain wired serializer phase targets beyond known supply history
2026-09-23 Resolve serializer edges at rail horizon within floating-point roundoff
2026-09-23 Stage bounded wired word and bit forecasts with drain accounting
2026-09-23 Record coupled RF acquisition and remaining wired integration gate
2026-09-23 Connect bounded wired clock forecasts to coupled analog rail solver
2026-09-23 Model wired termination load and selected driver bias with rail energy balance
2026-09-23 Exercise coupled RF calibration and record payload for independent quality analysis
2026-09-23 Validate coupled RF waveform reference against numerical integration
2026-09-23 Reconcile retained power evidence with coupled rail model limits
2026-09-23 Add explicit domain rail feeds and common-return coupling primitive
2026-09-23 Record coupled RF payload and prioritize receiver calibration closure
2026-09-23 Exercise receiver trim before coupled RF payload qualification
2026-09-23 Measure coupled solver cost and bounded method equivalence
2026-09-23 Support guarded voltage-dependent loads in domain supply model
2026-09-23 Couple physical domain rails to analog driver reference and PLL forecasts
2026-09-23 Record passing calibrated coupled RF waveform diagnostic
2026-09-23 Route host switching charge to physical supply segments
2026-09-23 Exercise both wired profiles with domain loads and host switching
2026-09-23 Record both wired profiles passing with coupled supply domains
2026-09-23 Run calibrated RF payload with physical supply domains and host charge
2026-09-23 Identify optimistic current fixtures against retained circuit evidence
2026-09-23 Record calibrated RF quality passing with coupled supply domains
2026-09-23 Expose physical host charge gap with finite rail and native trace screens
2026-09-23 Localize native host-bank startup timeout to supply-feed case
2026-09-23 Separate fixed rail offset from native bank feed-feedback timeout
2026-09-23 Model host output capacitors and distinct supply-return currents
2026-09-23 Verify independent noisy RF and retain host-driver fit limitations
2026-09-23 Fit current-limited host drivers and expose missing internal supply charge
    [fit_host_driver.py]
2026-09-23 Account finite internal host switching charge with nonlinear supply feedback
2026-09-23 Distinguish mathematical contracts from circuit and layout qualification
2026-09-23 Verify both wired profiles with finite host supply and return currents
2026-09-23 Reuse solved host branch currents in coupled analog derivative
2026-09-23 Exercise loaded RF quality with finite host output currents
2026-09-23 Measure conditional host sampling windows against modeled pad voltages
2026-09-23 Select one coupled full-chip composition for system verification
2026-09-24 Advance programmable transceiver behavioral model and consolidate design docs
    [schematic-implementation.json]
2026-09-26 Join transceiver feasibility models and consolidate architecture evidence
    Connect provider packaging, shared supplies and host switching to loaded clock,
    RF and wired requirements. Add independent packet exchange, shared-pad controls,
    continuous analog wake/mute and bandwidth-preserving filter investigations.
    Retain failures and distinguish conditional model results from physical proof.
    Consolidate architecture decisions and resource ownership in the existing docs.
    Compact generated JSON without dropping results, write snapshots atomically,
    and include all regression classes when the robustness test file runs directly.
    Validation: affected contract, packet, shared-pad, resource, robustness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
2026-10-15 Consolidate shared transceiver model and verified timing checkpoint
    Record shared configuration, forwarded-clock video operation, periodic CDR tracking and independent-clock cold acquisition with scoped evidence and negative controls. Consolidate normative documentation and remove superseded models and reports.
    Validation: contract checker and 12 timing-service tests pass; cold-CDR evidence matches current source hashes. Full retained source-loss recovery and broader lifecycle closure remain open. Preserve evidence-bound source bytes, including existing whitespace.
2026-10-16 Add parametric IO pad circuits, layouts, and scoped integration evidence
2026-10-16 Close sampled TX readiness feedback and consolidate current evidence
2026-10-16 Rebuild buffer layout from the selected shared circuit recipe
2026-10-16 Verify nominal loaded TX hold with converged sampled readiness
2026-10-16 Rebuild protected TX layout from shared recipe and replay extracted circuit
2026-10-16 Expose selected TX bias current errors under connected static loads
2026-10-17 Verify folded tail GDS and connected DC current accuracy
2026-10-17 Fund attached TX macros from measured layout footprints
2026-10-17 Place attached TX macros in the provider-compatible pad assembly
2026-10-17 Replace ideal TX steering drive with extracted CMOS buffers
2026-10-17 Place all TX steering buffers and rebuild them from the shared recipe
2026-10-17 Close nominal TX feedback and expose the wire power-budget conflict
2026-10-17 Exercise the shared TX model with an independently powered pull-up receiver
2026-10-17 Account RF bias draw and expose domain-level current allocation gaps
2026-10-17 Exercise retained AC-coupled TX network and expose remote startup settling
2026-10-17 Generate physical steering-driver routes in the placed TX assembly
2026-10-17 Extract and fault-check TX steering route connectivity
2026-10-17 Widen current-carrying TX buses and rebuild the selected pad assembly
2026-10-18 Model branched wired pad metal resistance and record connected replay
2026-10-18 Share pad foundation and compare populated functional attachments
2026-10-18 Gate pad foundation on current wafer.space packaging requirements
2026-10-18 Extract retained ring power topology and correct shared supply design
2026-10-18 Expose retained-ring host supply coupling and isolation gap
2026-10-18 Implement common-ring passive circuit and verify against SPICE
2026-10-18 Build transistor rail detector and reject unsafe corner behavior
2026-10-18 Investigate junction rail supervisor and record shutdown failures
2026-10-18 Trace brownout pad loading to shared protection rail
2026-10-18 Identify low-voltage release risk in isolated pad protection clamp
2026-10-18 Demonstrate pad clamp release with explicit gate discharge candidate
2026-10-18 Reject clamp discharge alone after retained-network pulse comparison
2026-10-18 Evaluate and reject insufficient direct pad clamp trigger
2026-10-18 Evaluate feed-forward clamp response without promoting unqualified protection
2026-10-18 Plan shorter bond landings within provider copper and bound loop geometry
2026-11-07 Replace transceiver experiment narratives with current implementation requirements
2026-11-08 Make digital flow image overridable and record the canary image rebuild
    The locked LibreLane canary image is rebuilt from its unchanged recipe but is
    not byte-identical; scripts accept SVALBARD_DIGITAL_IMAGE and default to the
    locked ID. Generated block layout databases are ignored and regenerated by
    each block family's run script.
2026-11-08 Add stress-safe pad protection, reference chain and island support cells
    Pads: rail shunt and clamp-gate discharge on every custom pad family, debug-site
    protection, USB attachment fixes. Core support: imported Edwards POR, bandgap
    and patched biasgen with per-island bias trunks. Island support: default-off
    reverse-blocking island switches, isolation clamps and the analog test bus.
2026-11-08 Add transistor-level timing, RF and wired block families
    Each family has netlists, layout generators, DRC/LVS and extracted-simulation
    evidence and a run script: ring PLL and passive LO path (timing), LNA, mixers
    and shared baseband filter (rf_rx), upmixers and driver (rf_tx), SAR ADCs, DACs
    and reference buffer (converters), wired receive chain and CDR (wired_rx), and
    the serializer with TMDS and USB HS bias (wired_tx). READMEs state current
    results, limitations and stale evidence.
2026-11-08 Add generated safe-default register file and harden the digital macro
    The register file is generated from the architecture control fields and the
    debug/fallback controls, resets to the safe state, and is proven by simulation
    and SymbiYosys. The digital macro (register file, transport, pattern
    generator/checker, frequency counters, host link, slow clock functions) is
    hardened with LibreLane: DRC, LVS and antenna clean, gate-level reset safety
    passes; target clock rates are not met.
2026-11-08 Add risk-accepted tapeout plan, readiness tracking and current status
    The first die keeps the full capability set and is accepted at risk: each block
    must be safe, clean, observable and backed by a fallback route, inside a narrow
    27 C +/-5 C, 3.15-3.35 V operating envelope. Adds the tapeout plan, per-block
    readiness with a checker, shared-resource decisions, board requirements, the
    path to tapeout, and rebooked block currents and areas from measured evidence.
    Status documents describe the current design only.
2026-11-10 Add labeled image of the first full-chip assembly
    Rendered from the first chip-assembly flow run (GF180MCU, 3.93 x 5.12 mm).
    Blocks are placed and bound but unrouted; the digital macro is an outline
    and the layout is not yet signoff-clean.
2026-11-10 Add labeled image of the v3 full-chip floorplan
    Floorplan v3 arranges blocks as signal-flow chains from each pad toward the
    digital macro, with the chains overlaid as arrows. Blocks are placed but
    unrouted, the digital macro is an outline, and the layout is not yet
    signoff-clean.
2026-11-10 Add labeled image of the v4 full-chip floorplan
    Floorplan v4 is driven by the risk register: ADC I is 238 um from the
    digital macro, the external LO legs are matched at about 0.5 mm, and the
    always-on oscillator and core bias are isolated from the RF blocks. It
    assumes the macro is re-shaped to 1716 x 1455 um. Blocks are placed but
    unrouted, and the layout is not yet signoff-clean.
2026-11-10 Checkpoint transceiver closure work: architecture, block fixes, assembly flow
    This is a snapshot taken while several block flows are still being worked
    on. It is not a frozen or signoff-clean state; tapeout readiness is still
    false. The register-file regression passes, and every changed Python file
    compiles.
    Digital and spec
    - Paired transport core and host-link changes. Regenerated register map,
    safe-reset defaults, new ATB leaves and debug fields.
    - Interface and architecture changes: pad-edge gearbox, line/8 host clock,
    on-chip CDR plan. Interface requirements, a performance-requirements
    traceability table with its checker, a power budget, and the package
    channel model for the wa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
2026-11-10 Checkpoint: digital physical signoff clean, new RF TX pad, isolation clamps
    Snapshot taken while several block flows are still being worked on; it is
    not signoff-clean and tapeout readiness is still false.
    - Digital: routed with DRC, LVS and antenna at 0 and gate-level simulation
    passing. Setup timing is still negative across all modes; slow silicon
    inside the operating window is estimated, not characterized. Adds a
    reduced-rate host-link fallback, a pin plan and in-window STA corners.
    - Pads: latch-up tap stripes in every family; new RF_TX pad with a
    gate-coupled 6 V shunt; compact refpad published.
    - Island support: isolation clamp cells and a placement list.
    - Ring-PLL supply reg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
2026-11-10 Add SATA Gen2, DP HBR, 2500BASE-X/XAUI, LE Coded, Channel Sounding and Thread requirements
    New requirement rows reuse existing PHY requirement IDs wherever the
    physical layer is shared; Zigbee and Matter are mapping-only rows on the
    802.15.4, BLE and Wi-Fi requirements.
    Also adds a continuous 0.48-3.24 Gb/s line-rate coverage requirement with
    band-edge margin, which closes the 0.81-0.96 and 1.62-1.92 Gb/s gaps.
    The performance-requirements checker and the tapeout-readiness check both
    pass.
2026-11-10 Add RX real-world robustness requirements and board items
    Adds 16 receiver requirements: maximum input level, AGC timing,
    overload and recovery, DC offset correction, IIP2, flicker noise, LO
    phase noise and reference, LO leakage, spurs, coexistence, system noise
    figure, antenna ESD, supply rejection and PTA coexistence signalling.
    Adds board items B33-B37: T/R switch, BAW coexistence filter, LO
    synthesizer phase-noise mask with a shared TCXO, antenna TVS and a clean
    supply.
2026-11-10 Add 100BASE-TX requirements via general-purpose wired generalizations
    Adds 100BASE-TX requirements, implemented by generalizing existing wired
    blocks rather than adding dedicated PHY hardware: a TX POST polarity
    select, slicer threshold DACs, a CTLE low-frequency zero, and fast
    threshold-update and raw dual-lane capture logic in digital. Adds the
    magnetics, RJ45 and TX back-termination filter as board items B38 and
    B39.
    10BASE-T is recorded as rejected: the current-mode TX cannot reach the
    2.2 V peak. An external PHY (B38a) is the backup.
2026-11-10 Add general-purpose radio capability requirements
    The RF front end has no on-chip tuned elements, so its band is set by board
    parts. The new rows cover:
    - Wi-Fi HT40/HE40
    - 2.2-2.8 GHz and 0.6-1.7 GHz operation through an external LO and a board
    band kit, including sub-GHz ISM, DECT and GNSS receive
    - simultaneous TX+RX for CW and FMCW radar, and loopback self-test
    - BLE direction finding through board antenna switching
    - SDR capture and RSSI scanning, and coexistence by time-slicing protocols
    - phase-coherent arrays of several chips
    Adds board items B41-B45. Rejected as needing dedicated parts: on-chip LO
    divide-by-2/3 modes, harmonic mixing toward 5 GHz, and adjacent-channel-
    compliant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
2026-11-10 Expand host-link bandwidth with reversible banks and long frames
    Per-bank direction reversal (RX2 gives 20 output lanes, 5.76 Gb/s)
    and 256-word streaming frames make every listed mode fit with at
    least 4% margin, using no new pads and no faster pin rate. This
    lifts the ~3.15 Gb/s streaming ceiling.
    Also records that the D2H pins use the bi_t cell, which needs the
    two-group launch stagger to reach full rate within the 300 mV
    ground-bounce limit, and adds board items for the reversible banks
    (series resistors, bidirectional clock-capable FPGA pins).
2026-11-11 Chip assembly image v5 (2026-11-11): UNROUTED, not signoff-clean, over-full
    Re-assembled with current published block GDS/LEF (scratch/chip-assembly-v5/run2).
    Changes vs v4:
    - digital macro: AC-1 hardened r4 LEF/GDS, 1716x1455 (real layout rendered)
    - pads: compact rf_pair and refpad published; pad_hspad on bidir[14/15] (HS RX);
    USB on pad_wirepad at bidir[18/19]; WCLK_OBS/WDBG_OBS folded (wclk_obs retired)
    - grown blocks: LNA (R90 now), bbfilters, ctle, slicer, termination, rfdriver,
    pll_ring r9 201x922, wiredtx 544x608; new pll_vreg x2, wrx_cap 1424x659
    - RX row +26 um east, corridor/isolation band follow; lo_ext 8 um west, LO-leg
    reserve 49 um; wired RX/TX east side re-placed
    - does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
2026-11-11 Pads PD28: compact rf_pair, packed pll_vreg, core-gate HBM screen, USB 6V candidate (opt-in)
2026-11-11 Add pt_pll_vreg2: one shared-core regulator for pll_tx and pll_cdr (0.175 mm2, extracted PSRR >=22.8 dB)
2026-11-11 Add MOD-00: GHz model/calibration-data accuracy umbrella risk
2026-11-11 Pads PD37: clamp leakage measured (PAD-01 fixed), USB pad status
2026-11-11 Add spec/design-assumptions.md: ground-truth data table with pessimistic design values
2026-11-11 Wired TX s7: core macro passes extracted 60/60 in-window corners; fix sreg flop and load path; block 0.334 mm2 (2.5G ss pre-driver still failing)
2026-11-11 Digital timing closure round 1: real-slow-corner flow, CDC constraints, clock-tree and RTL fixes (11 domains still negative)
2026-11-11 Wired TX s8: expander moved to digital (0.267 mm2), 4-level pre-driver, postcursor select row, pessimistic bench mode, WT20 launch contract
2026-11-11 Pads PD38: compact attached_tx_buffer 0.156 -> 0.030 mm2, extracted-equivalent
2026-11-11 Wired RX resume 6: r9d rings with low band (pll_host deleted), capture antenna/safe-state fixes, CTLE r3 LF zero; slicer/detect/DAC sources in progress (unpublished)
2026-11-11 Digital timing r2 (TC7 RTL): registered-decision rewrites of 6.4 ns domains, rftx/wtx output stages, gain buffering; all RTL/formal checks pass
2026-11-11 Pads PD39-41: compact steering buffers (0.69 -> 0.043 mm2), reworked termination buffer (0.062 mm2), USB v9 pad with LS slow mode (blockers tracked)
2026-11-11 LO round 4: jitter budget closes (0.72-0.84 ps), QVCO r5 layout (pessimistic 1.89-2.71 GHz), PFD/CP/divider/filter layouts, I/Q skew fix + 5-bit trim, ext LO via CML, diff_clk_rx r5 + 6V pad devices
2026-11-11 LO: retract lock claim, rebuild jitter budget (pessimistic 1.65 ps FAIL vs 1.05), QVCO r5 range/startup pass, run_timing publish-on-pass, RF-QVCO-RANGE 2.30-2.70 GHz
2026-11-11 Pads PD43-45: USB termination calibration method (41.5-49.2 ohm pessimistic), LS slew topology proven in sim, pad-C with RX load fails 2.7 pF
2026-11-11 CNV-03: DAC bow traced to clock coupling onto bias/header gates
2026-11-12 Wired RX r7: r9v ring with steered fast-tune (vote shift 4279->291 ppm), slicer r7 + vthdac r7 (reviewed), CDR bench ladder, antenna planner fix
2026-11-12 Pads PD47/PD48: USB LS slew drivers, 1 kV tiering on USB/HS pads, transient oxide limit, TLP site, board ESD rules (reviewed GO)
2026-11-12 Wired TX s8: designed slot overlap (core 46/46 pass incl. pessimistic), X5 TMDS from MAIN, two-sided bench, block 0.248 mm2; blocked on steering buffer (WT24)
2026-11-12 Pads PD48c: USB/HS RX pads restored to diode-row (2 kV) for CDM, cdm.py threading fix, reviewed GO
2026-11-12 wtx_fallback: use the compact steering buffer (electrically equivalent)
2026-11-12 Pads PD46: steering buffer EM fix at 85 C (OUT arrays split 4, strap ladder check), reviewed GO
2026-11-12 RF: rfdriver oscillation fix + layout (reviewed), bbfilter FS-2 rework (reviewed GO), TX IRR/LO-leak calibration plan, 400:50 balun, rfdriver 61.7 mA, LVS-unique revert
2026-11-13 LO r5: QVCO r6b (tail filter, 12 mA) - pessimistic jitter 0.80 ps vs 0.923 limit, new loop filter, CP area 0.125 mm2, lock ladder rungs 1-4a (reviewed; slow-corner lock 50.6 vs 50 us still open)
2026-11-13 Assembly v6 outline floorplan (does not fit: -1.42 mm2 raw, 14 blocks unplaced, 0 nF decap) + chip integration-risk plan
2026-11-13 Area pass 4: ranked levers + plan to >=3.0 mm2 on the fixed die; stacked pad_hspad candidate (-0.088 mm2, review GO-with-conditions, not published); LO-03/SUB-07/TH-01 restated; contract.json bond_ma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
2026-11-13 Track coordination docs (MANDATE, interface-changes, SESSION-STATE, reviews) in git so they can't be lost
2026-11-13 Converters: commit leftovers of 54cd9da (DAC v4 schematics, convkit MACRO_GATE_DERATE, adc_fft --chunk, adc_q kldrc, ADC FFT records)
    dac_i/dac_q.spice and lib/convkit.py hash-match the committed dac_*-evidence.json
    source_hashes and flow.py regenerates the schematics byte-identically; they were
    simply never staged.
2026-11-13 Pre-mortem review: 15 untracked ways the transceiver die fails, outside-view checklist, evidence-freshness and GDS census scripts
2026-11-13 Always-on audit: POR, core_bias, island switches, aosc (report + benches)
    Independent audit of the un-switched infrastructure. No design file changed.
    Findings: por_bypass still tied 0 at chip level and POR hold-off node dies at
    200-400 pA; aosc.EN unbound in the assembly with register default 1; aosc lock
    state with no kick; bandgap draws 71 uA with ena=0; VBG overshoots to the rail
    at enable; island/bias tapeout sources only in scratch. Bias fault isolation
    and always-on leakage total pass.
2026-11-13 Integration M1 (+M4): chip-level PDN model (mesh + per-pin bonds + block sources), static IR, impedance, bounce, victim impact; INT1-1..11
    Report scratch/reviews/integration-m1.md; model scratch/integration/m1-pdn/. Findings: no v6 supply grid (117 mV budget spent before island straps), island currents over switch design (rf 99/55, pll 103/60, wired 110/80 mA), decap demand 6-8 nF at the macro at 60 mA digital, QVCO needs a regulated rail (36-59 dB), RX spur via die VSS, bond 18/64 over 60 mA.
2026-11-13 RF RX: LNA/TIA candidate reviewed NO-GO (not published); record risks RFR-12/13/14, B18/B25 not met on the COB, chip-top pin intent
    Independent review scratch/review-lna3: 0.5 nH source return and the B18 network are not buildable on the TT01 COB,
    pessimistic-end chain NF 7.35 dB vs 4.1, source-pad C and common-mode stability hazards. No rf_rx sources or
    generated evidence are committed. chip-top-pins.md answers MW-5/MW-4/MW-20 (pins, connection intent, bbfilter codes).
2026-11-13 Wired RX resume 9: mode-walk reproductions (CTLE real load, ptrim real load), capture r7b PD vote-clock fix in source, cdr r13 source, PINS.md; nothing new published
    - capture.py: r7 compact source + r7b PD fix (vote clock 6->10 inverters, 2/4 XOR inverters); generated/wrx_cap.* is still r6
    (r7 review NO-GO: ss/625 PD votes; r7b extracted verification running). run_capture.py: extracted gate <= 625 MHz,
    not-run = fail, negative control, --results.
    - netlists.py/cdr.spice: pt_cdr r13 (r12 offset trim + output mirror 1/4); generated/cdr.* is the previous agent's
    unreviewed r11 (evidence fails ff compliance), recorded so it is not lost; r13 staged in scratch, transients pending.
    - detect.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
2026-11-13 Digital r5: POR override strap (macro side), SPI-only sign-off tooling with OCV + foundry ff bound, r4c leftovers finished or reverted
    - G3 / DT-10: pt_digital_macro input por_bypass, rst_n = reset_n_pad & (por_n | por_bypass); RESET_STATUS b2 reads
    the strap; regfile formal re-proven with por_n free of rst_n; check_por_bypass.py (22 checks, 6 mutants) in
    transceiver-digital-rtl-checks. Chip level still OPEN: pt_chip.sv ties the strap 0 until an input-only pad is
    bound (make transceiver-por-bypass-chip fails by design). Independent review: macro GO-with-conditions.
    - G6 + pre-mortem 5: spi_signoff.py/.tcl (pad + top-route model, wide slow/fast bounds, +-8 % OCV). Provisional
    (post-CT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
2026-11-13 Chip top: one chip-level connectivity (integration/top/pt_chip.conn), regression, boundary sim, TOP- rows
    Every v6 floorplan block instanced and every pin bound from the published (or owner-staged) subckt pin lists;
    control boundary as named macro ports (ctl_ports.txt); 153 isolation cells; decisions and build demands in
    decisions.md. check_top.py: unbound/dangling/undriven/multidrive/missing/crossing/alwayson/supply/iso = 0;
    cfg=143, macro=276, demand=9, staged=4 remain for digital and block owners (regression exits non-zero).
    Stub-level SPI -> register -> analog pin sim with negative controls passes. Independent review applied; not re-reviewed.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
2026-11-13 Converters AP4-4 + MW-3: staged repack candidate with single-ended CMOS clock (not published), integration contract
    Candidate (CONV_AP4=1, default stays the published pre-AP4 blocks; flow regenerates the
    committed schematics byte-identically):
    - ADC 0.5777 -> 0.4497 mm2 (480.28 x 936.30 um), DAC 0.1861 -> 0.1341 mm2 (668.50 x 200.63 um);
    ADC target <= 0.33 not met. All four staged blocks: Magic DRC 0, LVS unique, KLayout 0,
    precheck 0/0 (scratch/converters-ap4/stage4).
    - convkit: opt-in track/trunk spacing, trunk order, quiet nets, mixed rows, per-device gap;
    deterministic split order; LVS criterion rejects netgen property errors.
    - Clock: one CMOS CLK pin per block gated by the enable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
2026-11-13 Integration M6: isolation-state audit (fails 67 items, self-test with 4 injected errors), power-up bench on lumped supply (10 us..1 s ramps safe; 1 us edge fires provider clamps: 10 A, 6.4 V), always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
2026-11-13 Power delivery (PD2): budget reconciled against block evidence, islands re-partitioned on the existing switch masters, v7 grid / decap / rail / bond requirement (spec/power-delivery.md), PD2-1..21
    - spec/budgets/power_budget.py: MEASURED table, per-island design currents, restated ceilings (360 / 260 / 340 mA,
    valid with the digital macro at PWR-DIG), --reconcile; carries the RF RX owner's RC-16u edit
    - analog/island_support: ten islands on four verified masters, soft-start rerun at the new loads with a failing
    negative control, masters published under generated/isw
    - scratch/integration/m1-pdn: v7 requirement model (pd2cfg, e7-e10); M1 scripts unchanged in behaviour
    - static IR closes a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
2026-11-13 RF RX records: on-chip source degeneration adopted (source pads withdrawn, no hib pin), RFR-12/RFR-14 status with the new stability bench results
    No rf_rx sources or generated evidence committed (design not closed: common-mode stability open).
2026-11-13 Wired RX capture r7c source: word-load delay (pair-16 R->W hand-off at ss), antenna diodes; README Resume 9 update (not published; extracted gating set running)
2026-11-13 Wired RX README: capture r7c passes extracted ss/32/3.15 q625 (not yet published; remaining gating cases running)
2026-11-14 LO r6: LO-INTEGRATION.md (chip-top pin list, modes, bias, supplies), MW-20 joint LO-mixer result (published lo_ext -3.3 dB tt / -9.8 dB ss vs square; candidate staged), row plans lo_rows.py + per-row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
2026-11-14 Wired RX: publish pt_cdr r13 (259 x 320 um, 0.083 mm2; offset trim + output mirror fix; extracted compliance/vote checks pass at tt/ss/ff/pessimistic; independent review GO-with-conditions)
    Open (review conditions): closed loop with the ring on r13 (integral path 2.6-3.5x slower than r11), mismatch MC with trim,
    register bits for otr0..4/otrs.
2026-11-14 Assembly bbox cache: pt_cdr r13 published outline (0.78, 2.38)-(260.04, 322.14)
2026-11-14 Wired TX s11: real-ring bench (2.5 Gb/s fails at ss on ring duty, isolated), integration pin list, fallback fixture for the post-X5 block, evidence regenerated, serq8 WIP
    - analog/wired_tx/INTEGRATION.md: exact pins and connection intent of the wired TX subsystem for chip-top (reviewed; conditions folded in)
    - sim_ringsrc.py / sim_realring.py: extracted pt_pll_ring_core as phase source; generated/wiredtx-realring.json:
    ss/32/3.15 2.5 Gb/s 11 errors/101 (duty-only ideal control reproduces it; swing-only and spacing-only pass),
    tt 0 errors, ss 1.62 Gb/s 0 errors. Single points, CMD level, nominal extraction.
    - integration/wtx_fallback.py + verification/check_chip_fallback.py: external-data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
2026-11-14 Wired TX s11: real-ring record: second ss ring-supply point (2.57 V: 11 errors), schematic window experiment (WT29b)
2026-11-14 USB TX pre-driver pt_usb_txdrv: HS switch gates, FS/LS driver gates, bias bypass (MW-18)
    New cell on the wired island between pt_wiredtx / the digital macro and the USB pad:
    strength-selectable HS gate driver, FS/LS break-before-make with direct interlock and
    off-delay, 20 pF HS_PBIAS bypass. 208 devices, 116.5 x 270.1 um, Magic DRC 0, LVS unique,
    KLayout clean. Extracted benches with the extracted pad, bias DAC and COB package;
    declared limits and all results (including the failing ones) in generated/usbdrv-evidence.json.
    Pin list and open items in USB-INTEGRATION.md.
2026-11-14 Wired TX INTEGRATION.md: note the USB pre-driver tap on CMD_MAIN
2026-11-14 USB pre-driver: evidence refreshed with the last revision-3 runs (LS, mode, extracted pt_wiredtx source, long packet)
2026-11-14 Chip top: user decisions CP4-2/CP4-3, record fixes CP4-R1/R2/R4, republished cells, USB pre-driver, ADC PH, characterization structures
    polyphase deleted; WCLK_IN on the AUX_CLK pair; pad_rf_tx / pad_tlp masters; pt_cdr r13 otr pins; rxmix without hib;
    wordclk_rx per wired RX PINS.md; pt_usb_txdrv instanced; char structures instanced; boundary sim falls back to the
    committed RTL while the working tree does not compile.
2026-11-14 Chip top: create the output directory before writing the macro clamp list (conn-mutation negative control works again)
2026-11-14 Chip top: ten supply islands, supply/ground pads and AGND_RX per spec/power-delivery.md (D-PWR bound)
    Instances re-homed onto wired_rx/wired_cap/wired_tx, rf_rx/rf_tx, lod/lo, pll, conv, debug; ten switches on the five
    verified masters with shared enable groups and per-switch power-good to the macro; provider supply and ground pads;
    LNA ground split; LO pull-downs removed (same enable group). check_top.py knows islands and enable groups.
2026-11-14 Chip top: M6 isolation audit rerun on pt_chip.conn (iso_audit_top.py, in run.sh, with its four-injection self-test)
    Result on the conn: K1 20, K2 55, K3 0, K4 0, K5 40, K6 0, K7 15 (binder netlist: 67 on 77 % of the ports).
    Macro inputs from islands: all clamped (130 inside the macro per CP4-1, 3 outside). Open: ring-phase / observation
    inputs gated only by the receiver's enable, pad back-drive (11 pins), macro data outputs into off islands
    (wire_tx_data, rf_tx_sample), ATB leaves not gated by their island (15).
2026-11-14 Die-fit study: demand ledger (three scenarios), staged M4/M5-free measurement, pad footprint check
2026-11-14 Chip top: P/N, I/Q, bit-order and direction-marker checks; boundary sim on the macro's real control ports
    check_top.py derives polarity and bus order from pin and net names on both sides (categories pn, order; swap lines
    declare intended swaps) and compares the chip ports with the bond map. iso_audit_top.py checks every conn direction
    marker against the device terminals of the pin. Includes the digital owner's co-edits in this directory (register
    fields named in ctl_ports.txt, valid/request pins removed from the macro, bench without the interim map): cfg=0 and
    macro=0 against the digital working tree.
2026-11-14 Chip top: honest-demand area list of conn instances that are in no floorplan (for the die-fit study)
2026-11-14 Interface changes: TOP-19..24 (ten islands, CP4-1 macro clamps, isolation audit on the conn, user decisions, new instances, regression)
2026-11-14 Chip top: second independent review applied (control gating check, ground-pin and I/Q checks, stale decisions purged, TOP-25)
    Reviewer: pin-level bindings match the owners' files; not yet authoritative because of the macro off-state contract
    (LO enables gated by the wrong island in the RTL, ungated wire_tx_data / rf_tx_sample, VDD_LO state in LO mode 3,
    ATB gating). ctl_ports.txt corrected for the LO enables; check_top.py fails a control row whose island_on[] bit is
    not its consumer's enable group, and a ground pin that is not on VSS (AGND_RX only on the LNA and its pad).
2026-11-14 Die-fit study: ledger section written, packing variants queued
2026-11-14 Digital r6: mode-walk register/decode rework (TOP-1..4, TOP-10..18, TOP-25): macro presents the decoded c_* ports, register map rebuilt from the cells, control blocks for wired TX/RX, USB, monitor, P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
    run.sh cfg 143 -> 0, macro 276 -> 0; cfg_map.py 39/12/80 -> 0/0/0. Quick regression green (regfile incl. model
    compare, chip-io, por-bypass + chip tripwire, top modes 133 checks + 9 mutants, monitor, usb, wtx). Not yet done:
    independent review of the whole rework, full serial regression (allchecks6.sh), pt_por_path re-review after the
    16-bit key fix, SDC / pin order / hardening config for the new boundary (macro cannot be hardened as is).
    Ro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
2026-11-14 Pads + core support: POR strap evidence, bond re-audit, ring rails, free-site facts, bond-map option table (proposal), wafer.space questions; rows PC-1..4
2026-11-14 Digital r6 follow-up: self-contained generated pt_chip.sv, SDC / hardening config / pin order at port level for the new boundary, first post-synthesis timing on the reworked RTL (NOTES)
2026-11-14 Digital r6: fixes from the independent review of the rework and the POR-path re-review
    loop_bw range, ptrim / clk_select islands, detect threshold pins, AUX receiver users, clocked control outputs gated
    by their consumer island, reset-seen zeroes all register-file outputs, pt_vreg_seq single-flop ready, bandgap interlock
    256 SCLK, static USB HS/FS enables, wrx lane registered, pt_por_path kept hierarchy + SDC false path, aosc clock
    period, undriven chip-top bits tied. New regression: verification/check_decode_table.py (the reviewer's independent
    table, 3656 vectors, 0 mismatches). Rows DG6-14..16. Open: clamp pins vs input-port buffering in the flow, USB HS
    EN_MAIN question, timing of the ne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
2026-11-14 Pads: LVS reference netlists for the four wired/reference pad families (physical.spice minus the model-only well diode, ESD_RAIL in the pin list); read-back LVS matches uniquely on all four, negative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
2026-11-14 Pads: publish the stacked pad_hspad (492 x 912.91 um, RX pins adjacent on the side edge); registered for the precheck gate; README + status; row PC-14 (TERM_VCM metal resistance defect inherited from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
    Reviewed: scratch/pads-core/hspad/REVIEW2.md (GO with conditions).
2026-11-14 Die-fit study: ledger v2 with the independent reviewer's corrections; review report
2026-11-14 Pads: hspad TERM_VCM defect statement with the high-resistance metal corner (second review addendum)
2026-11-14 Pads: TLP site no longer shorts the ring rails (Metal2 riser, Metal1 VSS bridge, port on the current-carrying VSS bar); republished and registered for the precheck gate
    Reviewed: scratch/pads-core/tlp/REVIEW.md (GO with conditions; both conditions implemented, delta re-verified by DRC/LVS/precheck, not re-reviewed).
2026-11-14 Digital r6: new control blocks pipelined (pt_wrx_ctl, pt_monitor, pt_usb), SDC exceptions for them and the POR key, observation ledger migrated to the retired pads / renamed status bits
    Post-synthesis (ss_032C_3v15, ideal clocks): ref -2.4 (wtx pad sequencer), wrx -0.6, hcore -0.1, wtx -0.1, all other
    domains positive; the new blocks went from -15.3 / -10.4 / -9.6 / -6.0 to >= +1.8 inside the modules. Cell area after
    synthesis 1.404 mm2 (+13 % vs r5). Full regression green (allchecks.r6b.log: regfile + formal, pattern, chip-io,
    observation coverage, contract, readiness, digital-rtl-checks incl. top modes and the decode table); chip-top run.sh
    cfg = macro = 0. The pipelining of the three modu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
2026-11-14 QVCO top (SG-3, SG-5): fill keep-out markers IND_MK + PMNDMY over spirals (+25 um halo, now inside the outline: 898 x 652.9 um), feed stubs, tank core and aux tank columns; top-level port labels; rea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
2026-11-14 Die-fit study: packing results (B, C, Cr, lever stacks, die-size check), overheads, verdict, levers, review
2026-11-14 Session state: die-fit result
2026-11-14 Pads README: supply slew rule and strap margins as corrected by the review
2026-11-14 Interface rows: wired RX answers to DG6-7 and DG6-4
2026-11-14 Spec: bond map per the coordinator's decisions (POR strap on bidir[16], AGND_RX openings, bidir[17] held spare, REF_IN/BB_Q swap); row PC-18
2026-11-14 Pads: row PC-19 (AGND_RX pad cell staged)
2026-11-14 Off-chip passives pass: inventory, per-mode pin table, candidates (pre-review)
2026-11-14 Off-chip passives pass: independent review applied, OCP rows, case A/B
2026-11-14 Off-chip passives pass: pin table and board list consistent with the review
2026-11-14 Spec: bond map and package-channel for the wafer.space facts (no AGND_RX pads, P2 dropped, per-bond wire length/L/R for all 74 bonds); row PC-21
2026-11-14 Digital r7 flow readiness: CP4-1 clamp pins as dont_touch nets + clamp_check.py, GLS bench on the r6 macro boundary, sta_signoff with OCV-all view / foundry ff / 3.5 V rows, libchar 3.50 V corner
    - config.json: the 130 clamp pin nets of integration/top/generated/macro_clamps.txt are RSZ_DONT_TOUCH_LIST nets (no port
    buffer, hold cell or repeater between pin and AND2); the AND2 cells are not dont_touch instances (OpenROAD then refuses
    to buffer rst_n / island_on: RSZ-3006); outline 1716 x 1865 for the first r7 runs.
    - clamp_check.py <netlist>: every clamp pin reaches exactly one .iso_and AND2 input and nothing else; self-test with three
    injected faults; passes on the synthesis netlist (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
2026-11-14 Digital r7: board rules B49-B51, rows DG7-8..10, reviews of 9211b44 and of the r7 diff, macro area note, NOTES
    - spec/board-requirements.md: B49 RESET_N host-drivable (low through power-up with the POR_BYPASS strap), B50 SPI idle
    levels = pad pulls (105-157 kohm pads lose against any FPGA weak pull-up: 1 kohm board resistors), B51 POR rescue
    procedure (four bit-banged GPIOs).
    - interface-changes.md: DG7-8 (DG6-7 closed against WRX10-DG67), DG7-9 (IX-12: no 80-bit ingress, the D2H link carries
    3.125 Gb/s), DG7-10 (USB HS x4 repetition and codec proposal). DG7-1..7 were committed with the ledger earlier.
    - scratch/reviews/dg6-pipe-review/REPORT.md: independent review of the 9211b44 pipel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
2026-11-14 Wired TX docs: README, INTEGRATION, USB-INTEGRATION rewritten to current state only
2026-11-14 Tapeout plan: one current plan (gates and gap); path-to-tapeout.md deleted, references fixed
2026-11-14 Package channel doc: rebuilt from package-channel.json (fixed 74-wire bond map, per-bond wire data), current state only
2026-11-14 Wired RX docs: current published state only (README 136 kB -> 20 kB, PINS 47 kB -> 15 kB)
    README: per-block version, outline, verified numbers with evidence file, flow, open items; history,
    superseded revisions and round narratives removed. PINS: per-cell bindings restated from
    integration/top/pt_chip.conn and ctl_ports.txt; section numbers kept.
2026-11-14 Design assumptions: process facts table, current bond/pad/supply rows, provenance notes removed
2026-11-14 Docs: timing README, LO-INTEGRATION and pll_vreg README rewritten to current state only
    Published cells, ports, GDS outlines, bindings from pt_chip.conn / ctl_ports.txt and numbers
    re-read from the evidence files; history, superseded revisions and stale numbers removed;
    stale evidence and staged work listed as open items.
2026-11-14 Docs refresh: rf_rx, rf_tx, converters, characterization, decap, pads, core_support, island_support READMEs to current state only
2026-11-14 Docs: project README and host transport spec rewritten to the current state
2026-11-14 Risk register: current rows only, add this week's untracked risks
2026-11-14 Power delivery: current state only, power-partition merged in (stub keeps the PWR-* IDs the requirements json traces)
2026-11-14 Risk register: follow-up rows (LO, timing, converters, pads, RX ground), evidence pointers, RFR-04 reopened
2026-11-14 Docs: block deliverables, model, diagram and reference-AFE notes cut to the current state; superseded guides removed
2026-11-14 Board requirements: current rows only (fixed COB, supply trim and slew rules, B19 restored, B18/B25 not met, proposed rows listed)
2026-11-14 Docs: remove 23 superseded spec studies (model-era candidates, surveys, screens, consolidation passes); dead links removed from plan.md and the pin plan
    Their live content is in the project README, spec/streaming-transport-v2.md, integration/macro-contract.md and
    integration/top/decisions.md; history stays in git.
2026-11-14 FPGA connection plan: current pin names, SPI/reset rules, unbuilt host-link items flagged
2026-11-14 Restore the committed state of four spec files swept into 99521c7 by mistake
    99521c7 (docs deletion) was committed with the whole spec/ directory as its path and so included uncommitted
    in-flight edits of analog-architecture.json, register-map.json, register-map.md and schematic-implementation.json
    that belong with uncommitted RTL edits. This puts HEAD back to their previous committed content; the working-tree
    edits are untouched and uncommitted again.
2026-11-14 Spec: HDMI three-die note, RTL host-link facts, unreachable threshold opcodes in HL-04, exclusivity rule pointer
2026-11-14 Digital r7 RTL: monitor second time base and async re-arm, wired TX pad sequence, SDC and bench updates after second review (GO-with-conditions); regenerated register map
    Regression on this tree: digital-rtl-checks, regfile, regfile-formal, top-modes, chip-io, por-bypass-chip, contract, ctl-blocks all rc=0.
    Not included: hardening outline experiment (digital_hardening/config.json, hio_placement.cfg) stays uncommitted.
2026-11-14 Wired TX: new fast path generators (wtx_mux8 muxing pre-driver, wtx_ser8d stream macro), unpublished; docs to current state with the real-ring / real-pad truth table
2026-11-14 Wired TX README: remaining real-chain rows of the new path (tt, ff, 3.24 Gb/s, 2.7 Gb/s pessimistic, killed-phase control)
2026-11-14 Interface rows DG7-11/12 and WT32-WT37; session state: wired TX session 12
